JamesGlanville/solderingmachine/README.md

solderingmachine
================

My 4th year engineering project to make a soldering machine for smd parts.
