JamesGlanville/solderingmachine/report/handbook.pdf

## Soldering Machine Handbook

James Glanville

15th May 2013

## Contents

1 Introduction | 2
2 Prerequisites | 2
3 Installing Software | 2
4 Creating GERBER files. | 3
5 Generating GCODE with pcb2gcode | 3
6 Operating the machine | 3
Appendices | 6
A Building pcb2gcode from source | 6

1

## 1 Introduction

This handbook lists the steps required to operate the machine, and produce populated PCBs. The operating system used in this handbook is Ubuntu 13.10. The PCB CAD program used is Kicad.

## 2 Prerequisites

The following things are assumed:

- Computer with Windows/Linux. OS X may work, but is untested.
- SD card (at least 128mb).

## 3 Installing Software

First install pcb2gcode as described in Appendix A.

### 3.1 Project files

Fetch the project’s files from source control:

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

### 3.2 Install pronterface (if PC control is required)

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

### 3.3 Preparing SD card

Format the SD card to the FAT32 filesystem, ensuring the disk has an MSDOS partition table and that the FAT32 partition is on the first primary partition.

In Ubuntu, the following steps are necessary:

Install gparted if it is not already installed:

sudo apt−g e t i n s t a l l gp a r ted

Launch gparted as root:

sudo gp a r ted

Select the SD card using the drop down menu at the top right of the screen.

Create the MSDOS partition table by clicking Device->Create Partition Table.

Create the FAT32 filesystem by right-clicking on the empty disk, and selecting ”New”. Fill in the information in the dialogue box, and click ”Apply changes”.

2

3.4 Copying utility GCODE to SD card.

Copy all .GCODE files from pcb2gcode-metric/GCODE/ to the root of the SD card. These can be used to perform simple functions such as zeroing the axes.

4 Creating GERBER files.

The following steps should be followed to export GERBER files from Kicad:

1. Open the PCB layout in PCBNew.
2. Select Tracks and Vias from the Dimensions Menu.
3. Change the Mask Clearance to 0.0001.
4. Select Plot from the File menu.
5. Select the following layers: Copper, Component,SoldPCmp, EdgesPcb
6. Click Plot and then Generate drill file.

## 5 Generating GCODE with pcb2gcode

5.1 Creating millproject file.

An example millproject file is given in pcb2gcode-metric/millproject. This should be copied into the directory containing the GERBER files, and modified if necessary (see included comments).

### 5.2 Copy GCODE to SD Card

## 6 Operating the machine

The following steps described the various stages involved in producing a populated and soldered circuit board. Some steps (such as drilling) may be omitted if not required.

### 6.1 Using pronterface

The machine has two main user interfaces: the interface used for the machine in standalone operation and that used when connected to a host computer.

Pronterface was chosen as the PC user interface as it is a mature GCODE visualiser and sender.

Once the correct serial port and baud rate have been selected, pronterface will connect to the machine. GCODE can be loaded using the Load file button. It is rendered to the center of the window (however some operations are not shown correctly). The program is primarily intended for operating 3d printers, so to send the GCODE to the machine the Print button must be used.

3

The following instructions assume the SD card interface is being utilised, but if PC control is required, simply send the GCODE using pronterface as described above instead.

### 6.2 Attaching the PCB

Attach copper-clad PCB to machine using double sided tape. It is important that the PCB is level, so care must be taken ensure the tape is not bunched or folded. The PCB should be firmly pressed to the bed to ensure a strong bond.

### 6.3 Isolation Routing

1. Insert conical routing bit into the spindle. This is achieved by loosening the idler section, and then loosening the two machine screws holding the bit in place. The bit should be carefully removed by hand, and the conical routing bit pushed into its place. The two machine screws should be tightened, and the idler tightened.
2. The spindle tool should then be attached to the tool holder with the two wing nuts.
3. Switch on the machine.
4. Insert the SD card containing all of the GCODE files and power on the machine.
5. Run zero.gcode then startspindle.gcode then mill.gcode
6. When routing is complete, run stopspindle.gcode

### 6.4 Drilling

This section may be ignored if no holes need be drilled through the PCB.

1. The drill bit should be inserted into the spindle tool as described in the ”Isolation Routing” section above.
2. Switch on the machine.
3. Insert the SD card containing all of the GCODE files and power on the machine.
4. Run zero.GCODE then startspindle.GCODE then drill.GCODE
5. When drilling is complete, run stopspindle.GCODE

### 6.5 Paste Extrusion

1. Insert a syringe containing a sufficient volume of solder paste into the paste extruder. Hand-tighten the extruder so that there is only a small amount of slack in the timing belt.
2. Attach the paste extruder to the tool holder and hand-tighten the wing nuts.
3. Switch on the machine.
4. Insert the SD card containing all of the GCODE files and power on the machine.
5. Run zero.GCODE then prime.GCODE then paste.GCODE

4

### 6.6 Placing components

1. Attach the vacuum needle tool to the machine and tighten with the wing nuts.
2. Fill the part tray with the necessary SMD components.
3. Switch on the machine.
4. Insert the SD card containing all of the GCODE files and power on the machine.
5. Run zero.GCODE then place.GCODE.

### 6.7 Reflowing the board

1. Attach the hot air tool to the machine and tighten with the wing nuts.
2. Switch on the machine.
3. Insert the SD card containing all of the GCODE files and power on the machine.
4. Run zero.GCODE then reflow.GCODE.
5. Run cooldown.GCODE

5

# Appendices

## A Building pcb2gcode from source

The pcb2gcode source should first be obtained:

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

A.1 Compilation in Linux

For these instructions the use of Ubuntu/Debian is assumed, although other distributions should be similar.

To install prerequisites:

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

To compile pcb2gcode:

cd pcb2gcode−m e t ri c
. / gi t −b uil d . sh

(Optional) To install pcb2gcode:

sudo c h e c k i n s t a l l

A.2 Compilation in Windows

Installing prerequisites is more complex in Windows:

A.2.1 Visual Studio

Install Visual Studio 2012 Professional from:

www. v i s u a l s t u d i o . com

A.2.2 GTK+ development files

Download:

h t tp : / / f t p . gnome . o r g /pub/gnome/ b i n a r i e s / win32 / gtk +/2.24/ gtk+−b un dl e 2 .24.10 −20120208 win32 . zi p

and extract to pcb2gcode-metric folder.

6

A.2.3 Gerbv

Download and install gerbvinst-2.6.1.exe from:

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

A.2.4 Boost libraries

Download boost 1 55 0.zip from:

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

Unzip contents to c:\boost155 open VS2012 x86 Native Tools Command Prompt, from:

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

As administrator, run the following commands:

cd c : \ b o o s t 1 5 5
b o o t s t r a p . bat
bjam . exe

A.2.5 GTKMM

Download and install gtkmm-win32-devel-2.22.0-2.exe from:

h t tp : / / f t p . gnome . o r g /pub/GNOME/ b i n a r i e s / win32 /gtkmm / 2. 2 2 /

A.2.6 Gerbv source

Download gerbv-2.6.1.tar.gz from:

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

and extract to c:\gerbv-2.6.1

A.2.7 Compilation

The file pcb2gcode-metric.sln may now be opened in visual studio and the project can be compiled.

7
