JamesGlanville/solderingmachine/microscope/1.png

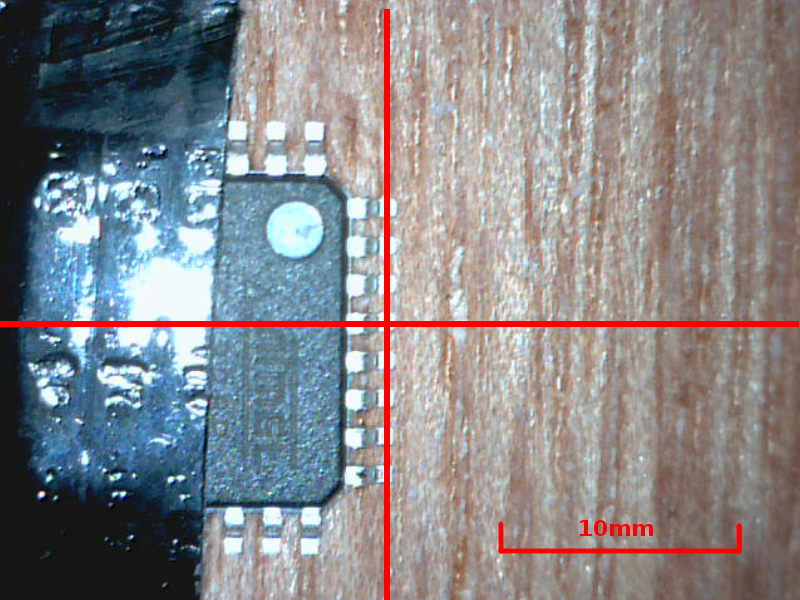
microscope/1.png
