JamesGlanville/solderingmachine/microscope/1s.png

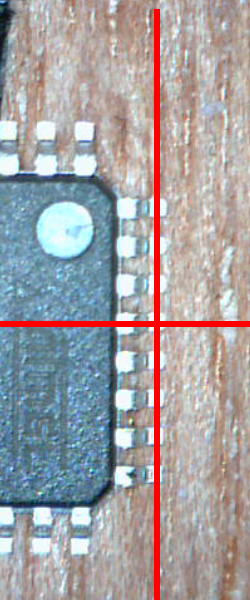
microscope/1s.png
