JamesGlanville/solderingmachine/microscope/2.png

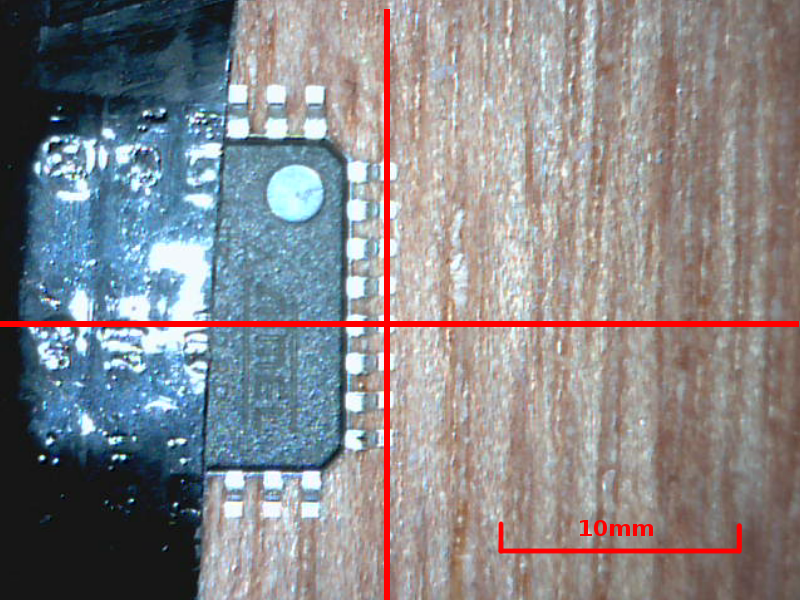
microscope/2.png
