JamesGlanville/solderingmachine/microscope/2s.png

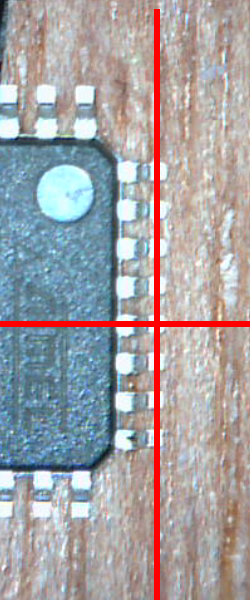
microscope/2s.png
