JamesGlanville/solderingmachine/microscope/3s.png

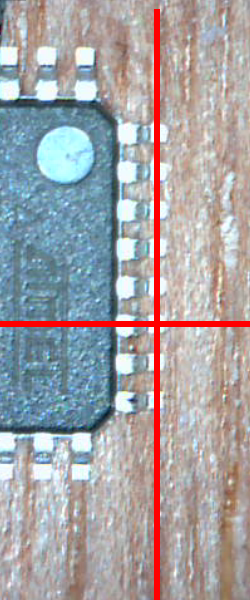
microscope/3s.png
