JamesGlanville/solderingmachine/microscope/4.png

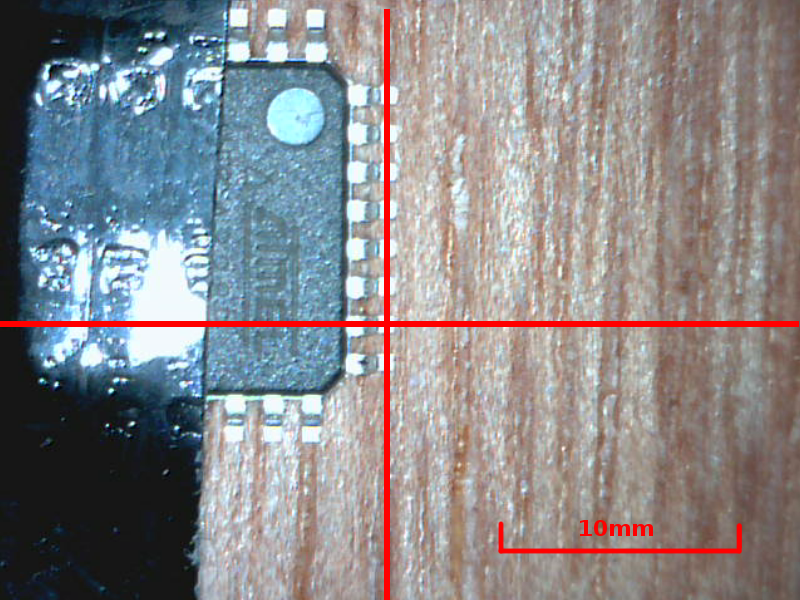
microscope/4.png
