JamesGlanville/solderingmachine/microscope/4s.png

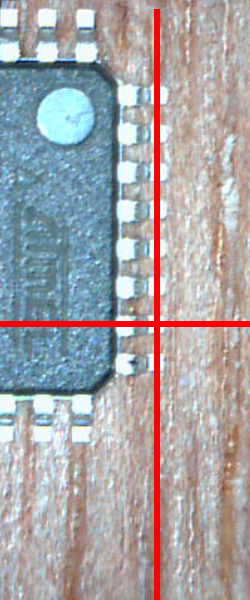
microscope/4s.png
