JamesGlanville/solderingmachine/microscope/5s.png

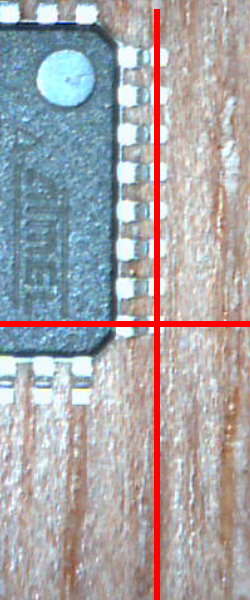
microscope/5s.png
