JamesGlanville/solderingmachine/microscope/Picture46.bmp

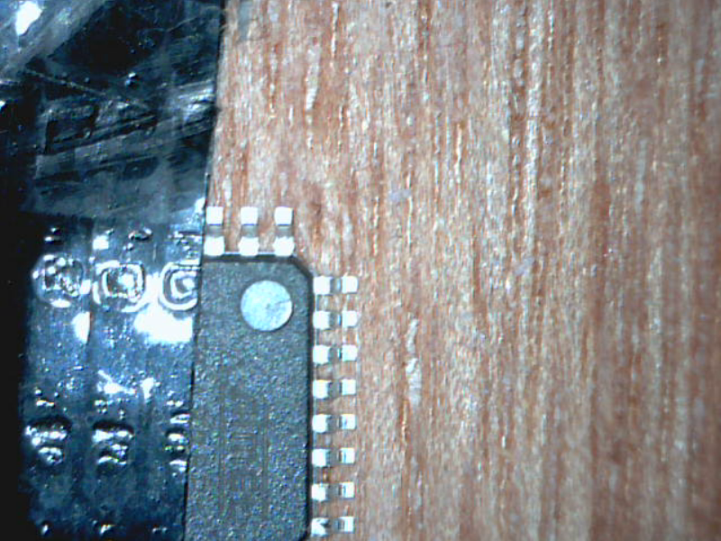
microscope/Picture46.bmp
