JamesGlanville/solderingmachine/microscope/Picture47.bmp

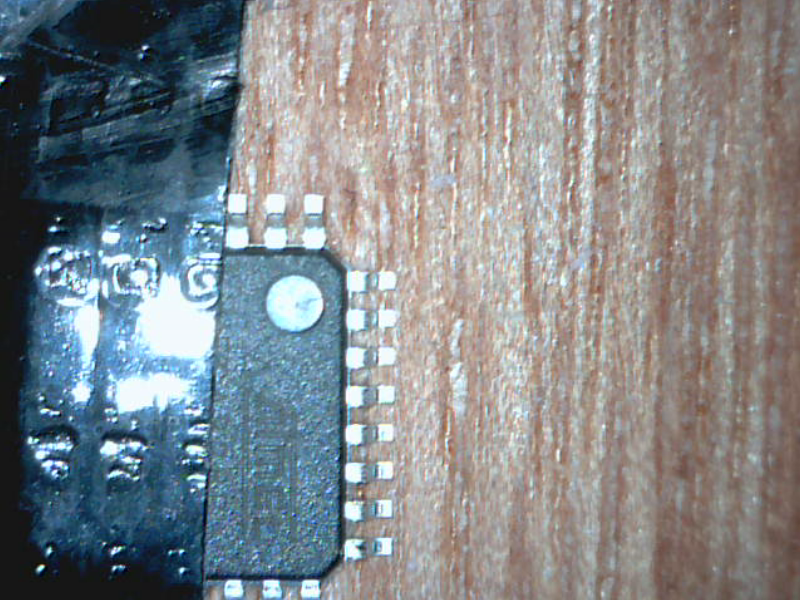
microscope/Picture47.bmp
