JamesGlanville/solderingmachine/microscope/Picture48.bmp

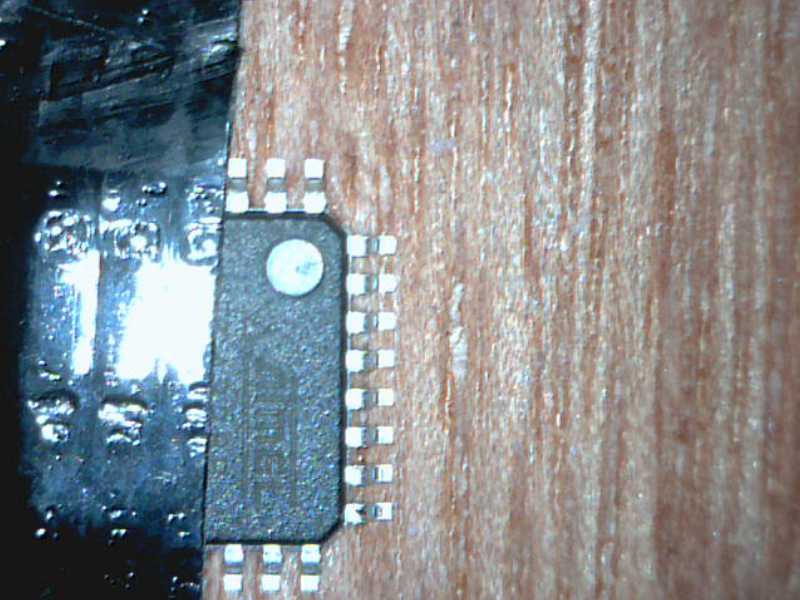
microscope/Picture48.bmp
