JamesGlanville/solderingmachine/microscope/Picture51.bmp

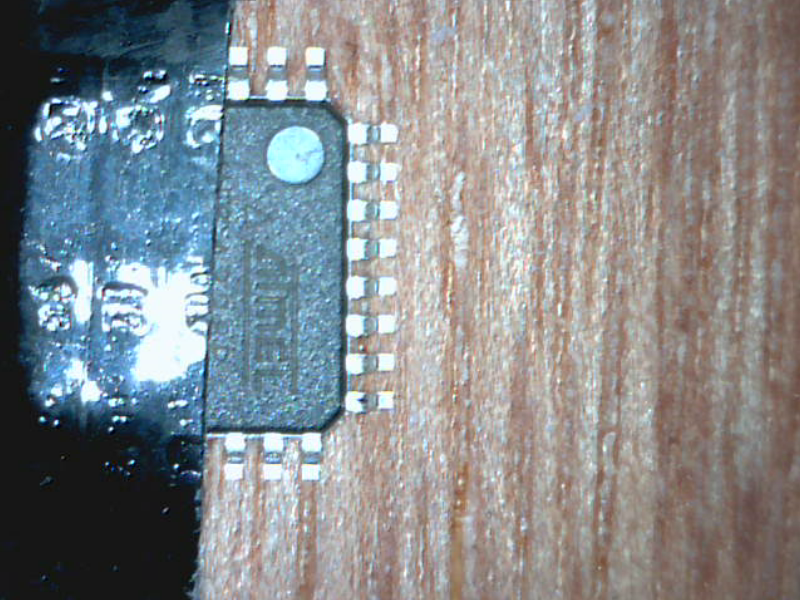
microscope/Picture51.bmp
