JamesGlanville/solderingmachine/microscope/Picture54.bmp

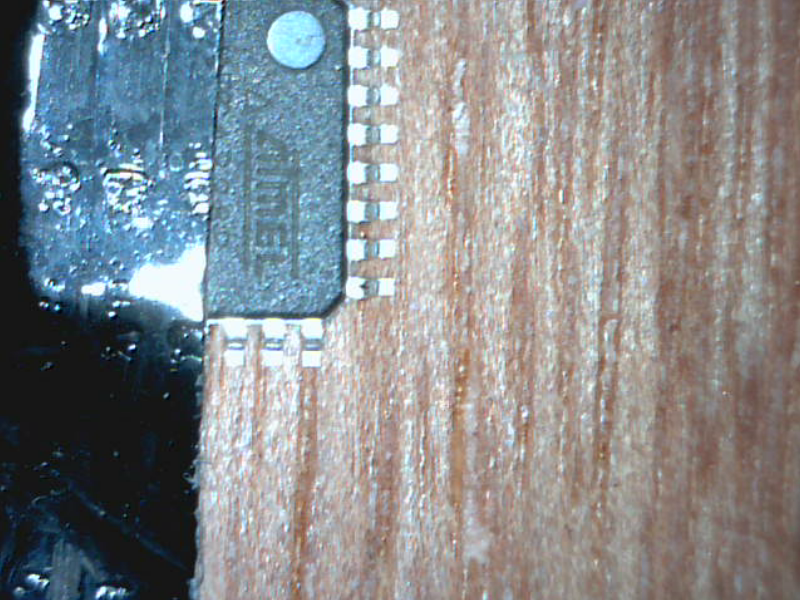
microscope/Picture54.bmp
