JamesGlanville/solderingmachine/microscope/Picture55.bmp

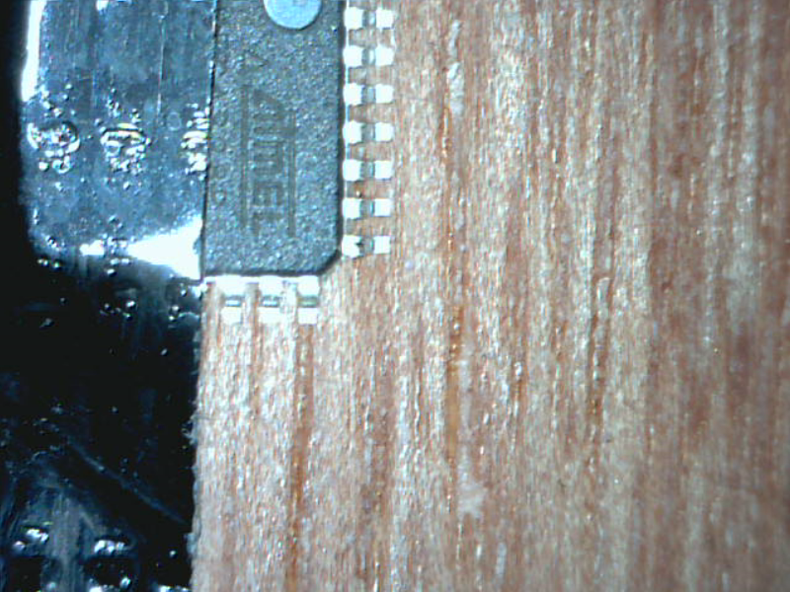
microscope/Picture55.bmp
