JamesGlanville/solderingmachine/microscope/Picture56.bmp

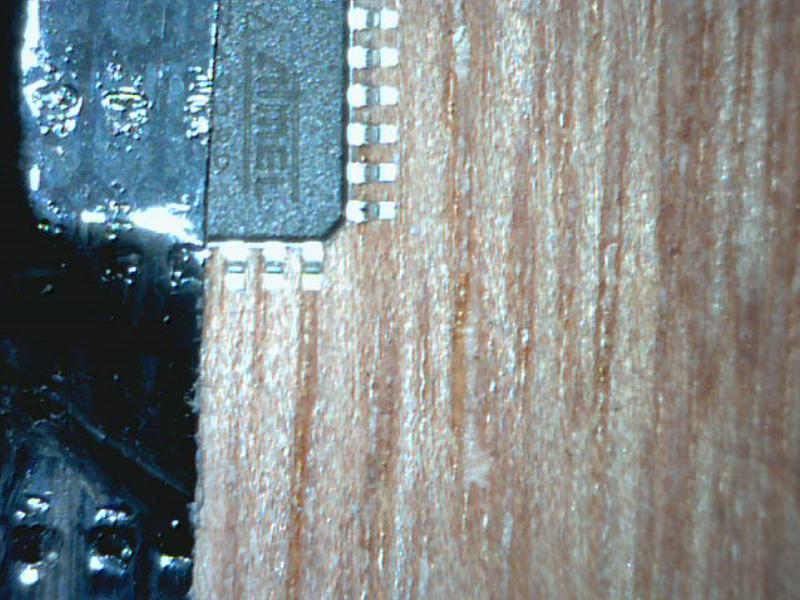
microscope/Picture56.bmp
