JamesGlanville/solderingmachine/microscope/Picture57.bmp

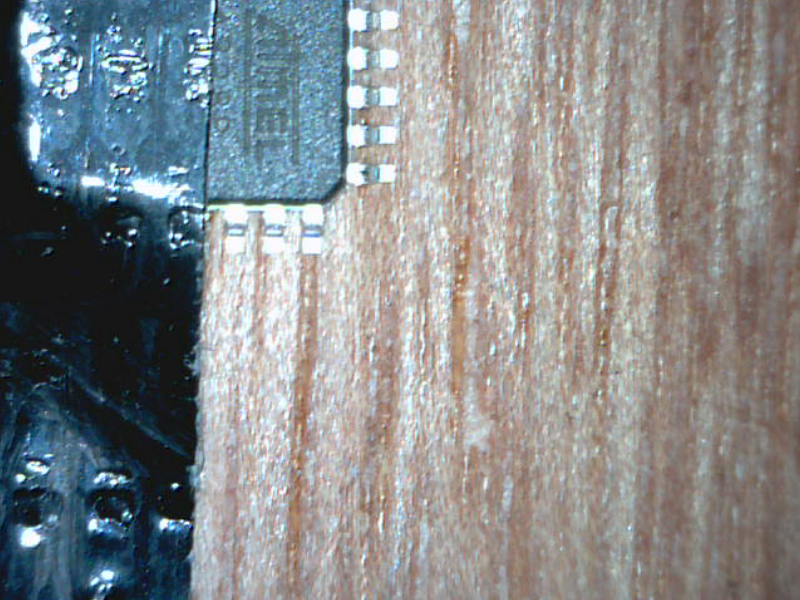
microscope/Picture57.bmp
