JamesGlanville/solderingmachine/report/resources/dialgauge.gif

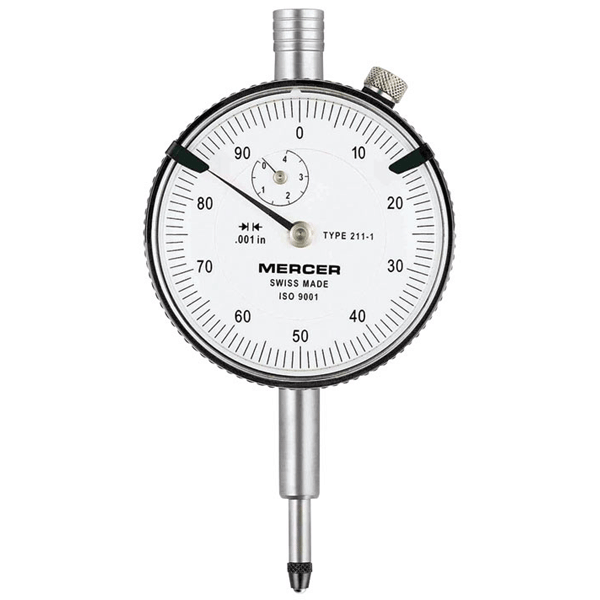
report/resources/dialgauge.gif
