JamesGlanville/solderingmachine/report/resources/hc05breakout.png

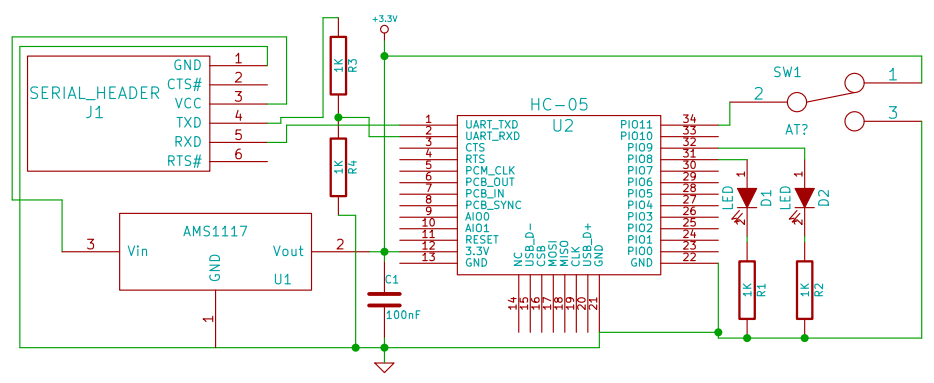
report/resources/hc05breakout.png
