JamesGlanville/solderingmachine/report/resources/needleresistor.JPG

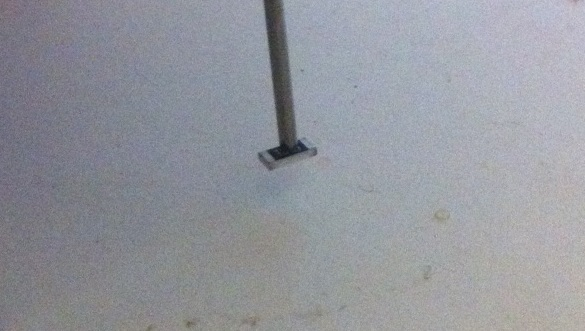
report/resources/needleresistor.JPG
