JamesGlanville/solderingmachine/report/resources/wormextruder.png

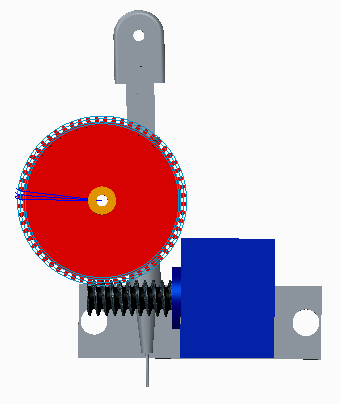
report/resources/wormextruder.png
