JamesGlanville/solderingmachine/report/Part list.xlsx

Part | Quantity | Type | Total Cost | Supplier | Link
base_board | 1 | sheet | - | - | -
topboard | 1 | sheet | - | - | -
bed | 1 | sheet | - | - | -
zsupport | 2 | sheet | - | - | -
zpanel | 1 | sheet | - | - | -
base_back | 1 | sheet | - | - | -
base_sides | 2 | sheet | - | - | -
base_bottom | 1 | sheet | - | - | -
slidyelectronics |  | sheet | - | - | -
drawer slides | 6 |  | 8.00
m8 threaded rods | 3
m8 brass nuts | 6
anti-backlash springs | 3
electronics board | 1 |  | 30.00 |  | http://reprap.org/wiki/Sanguish
nema17 motors | 3 |  | 18.00 | Zapp Automation | http://www.zappautomation.co.uk/en/nema-17-stepper-motors/373-sy42sth47-1684a-high-torque-hybrid-stepper-motors.html
Vacuum tube | 1 |  | 1.00
ESC - turnigy plush 30A | 1 |  | 8.00 | Hobbyking | http://www.hobbyking.com/hobbyking/store/__2164__turnigy_plush_30amp_speed_controller.html
brushless motor - turnigy 450 3800KV | 1 |  | 8.56 | Hobbyking | http://www.hobbyking.com/hobbyking/store/__37457__turnigy_450_series_3800kv_brushless_outrunner_helicopter_motor.html
prop savers | 2 |  | 1.84 | Hobbyking | https://www.hobbyking.com/hobbycity/store/uh_viewItem.asp?idProduct=8240
m4 nuts and bolts | 40
nuttrap | 3 | RP
motorholder | 3 | RP
pasteextruder | 1 | RP
needleholder | 1 | RP
zholder | 1 | RP
rightangle | 4 | RP
12v 30A Power Supply | 1 |  | 12.79 | ebay | http://www.ebay.co.uk/itm/201009607598
Inline mini fuse holder + 30A fuse | 1 |  | 1.59 | ebay | http://www.ebay.co.uk/itm/231070496002
20X4 Backlit HD44780 LCD | 1 |  | 5.99 | ebay | http://www.ebay.co.uk/itm/281270914670
12mm Rotary Encoder | 1 |  | 0.42 | ebay | http://www.ebay.co.uk/itm/390605649309
AMS1117-3.3 3.3V linear regulator | 1 |  | 0.03 | ebay | http://www.ebay.co.uk/itm/141128141176
Optional
HC-05 Bluetooth Tranceiver | 1 |  | 3.65 | ebay | http://www.ebay.co.uk/itm/330913339056
AMS1117-3.3 3.3V linear regulator | 1 |  | 0.03 | ebay | http://www.ebay.co.uk/itm/141128141176
