JamesGlanville/solderingmachine/parts/creo/base_sides.pdf

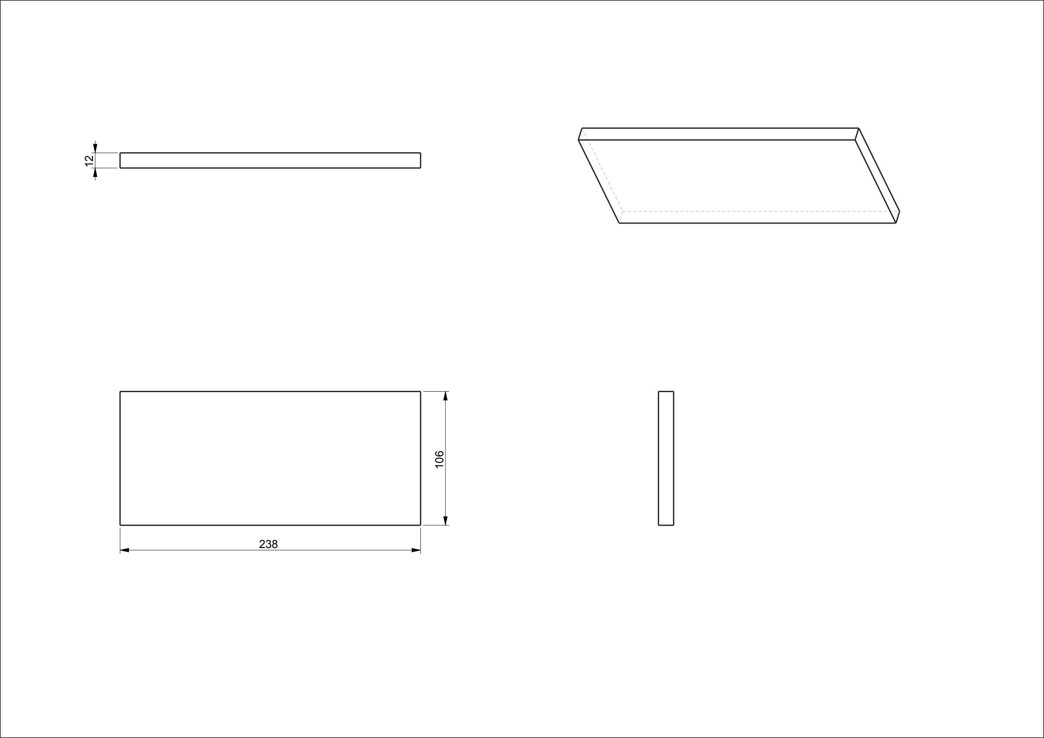
[picture p64: figure]
