JamesGlanville/solderingmachine/parts/creo/extruder.pdf

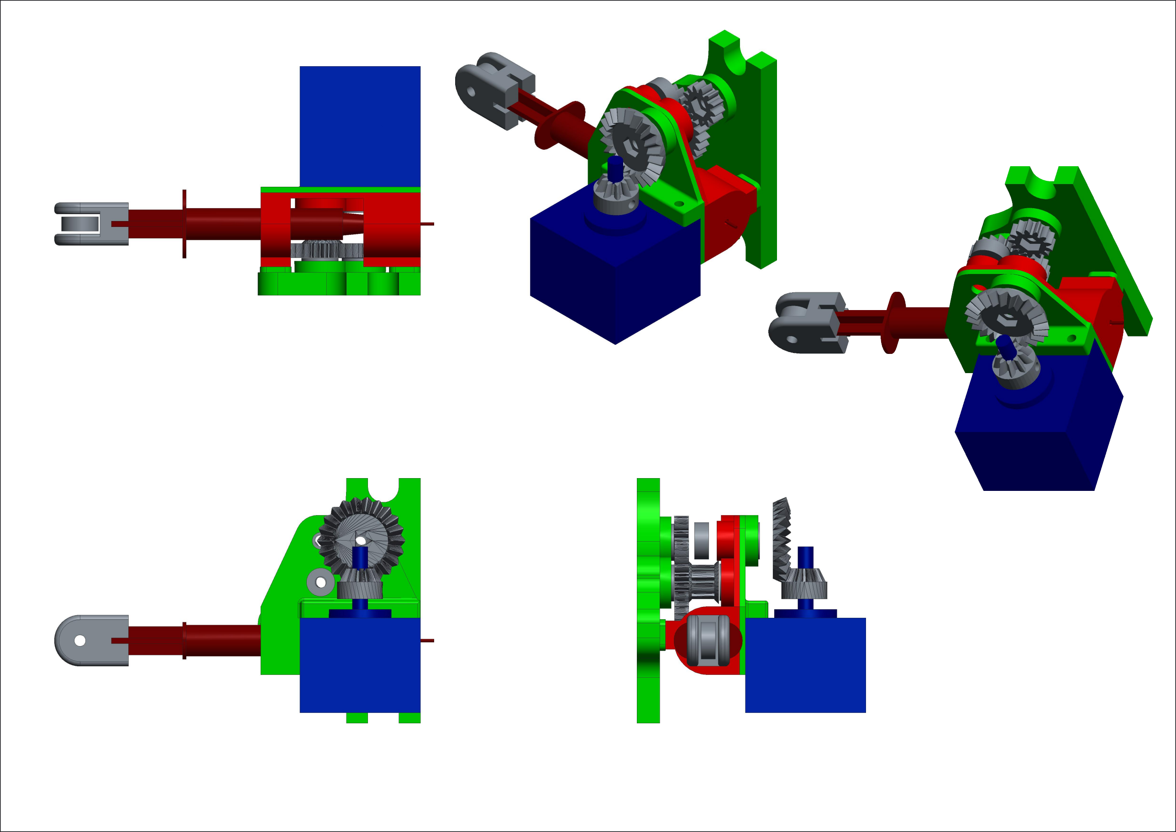
[picture p65: page 1]
