JamesGlanville/solderingmachine/parts/creo/gad.pdf

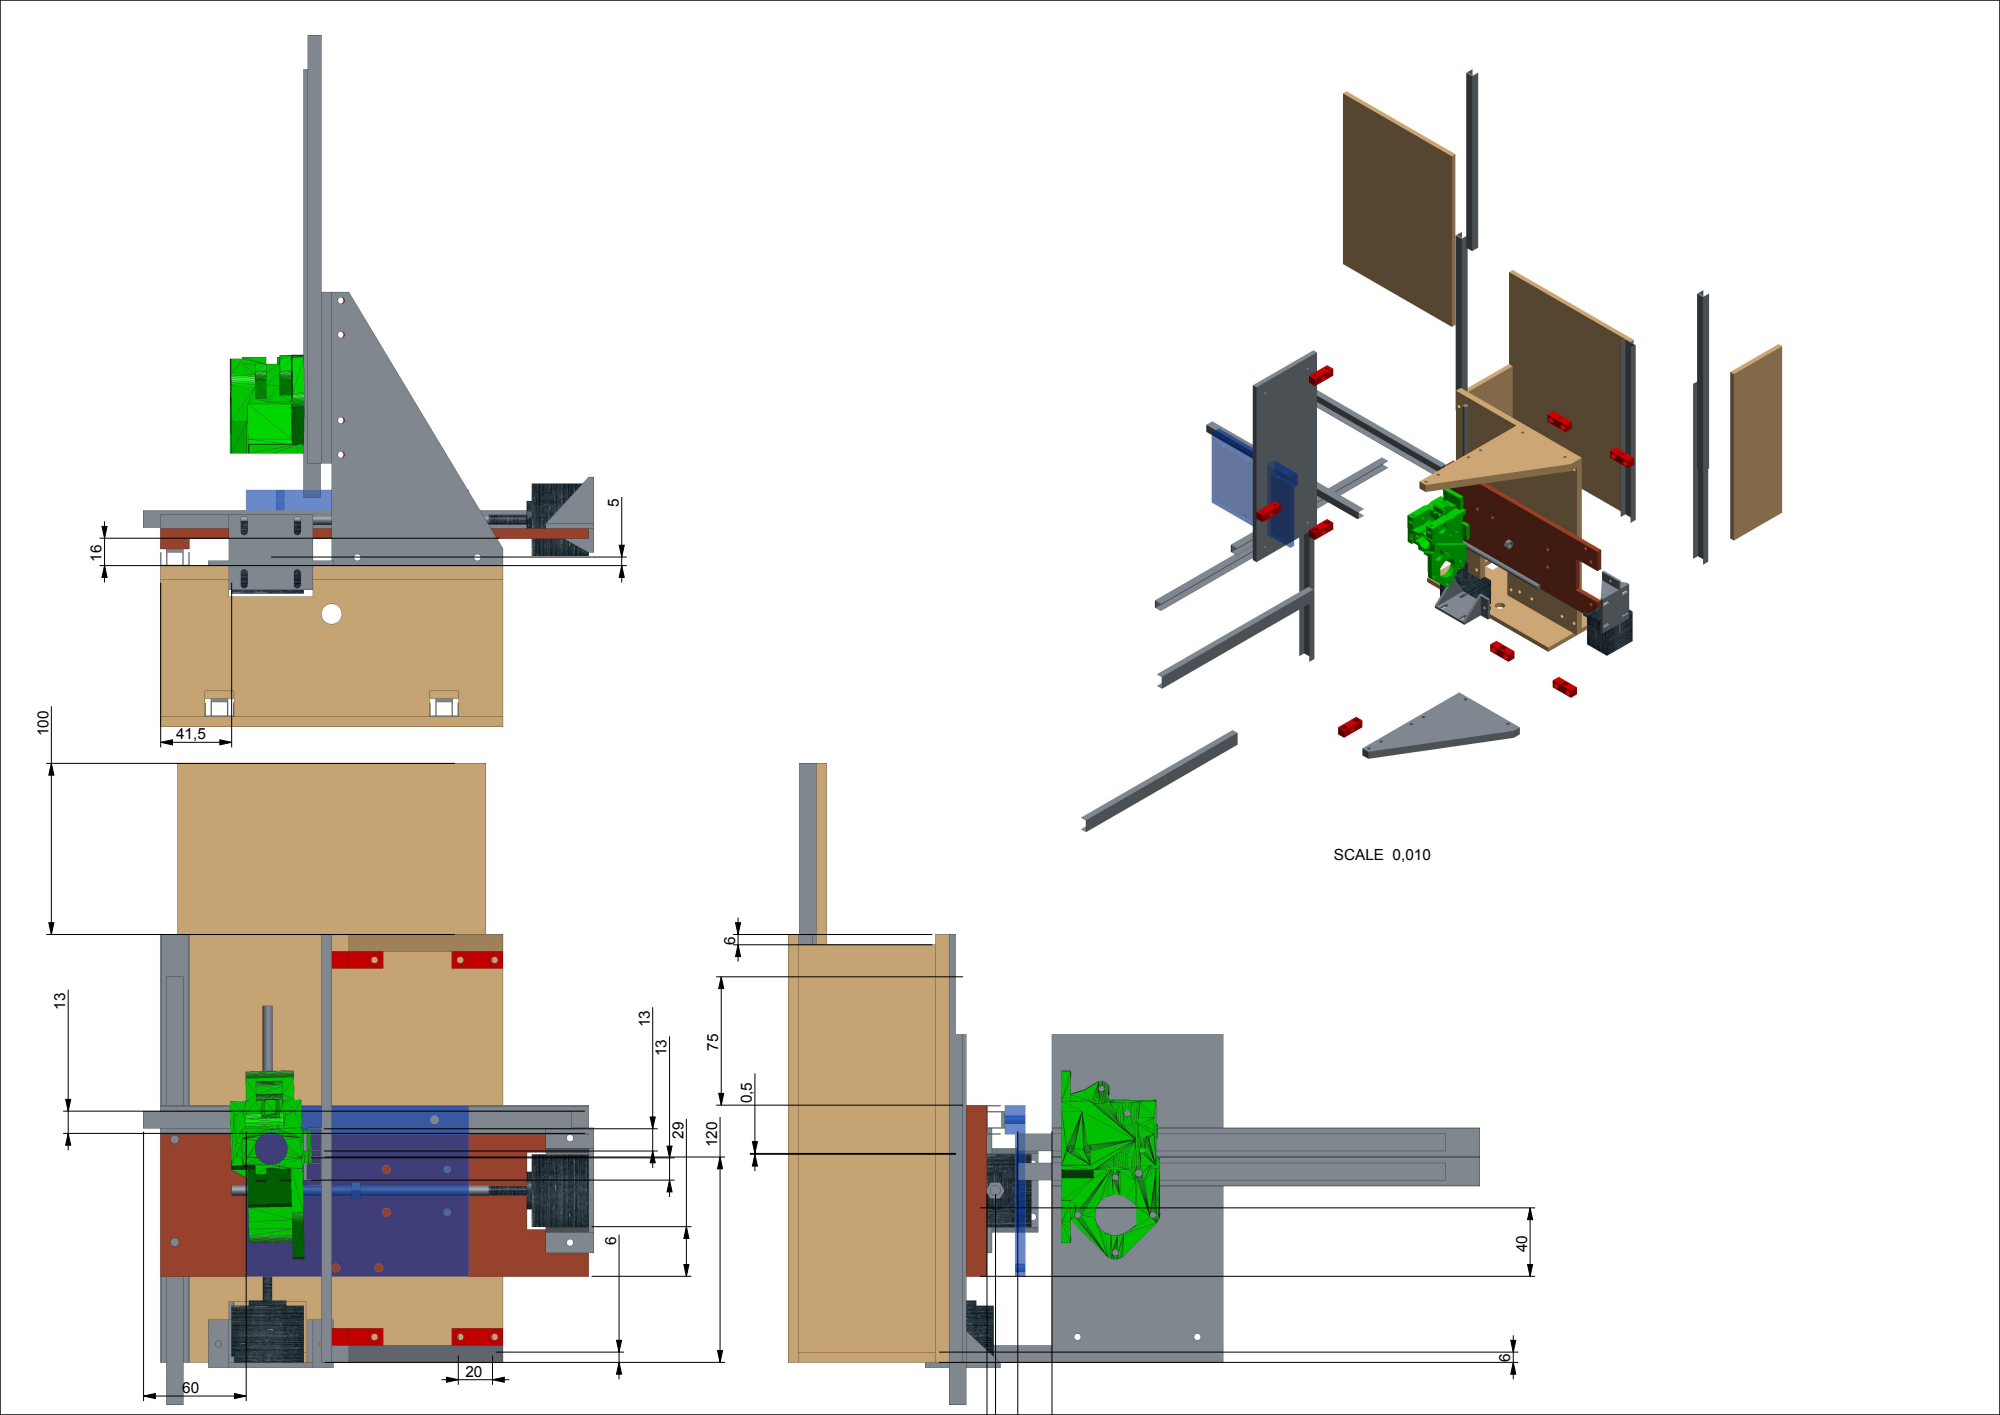
[picture p66: page 1]
SCALE 0,010

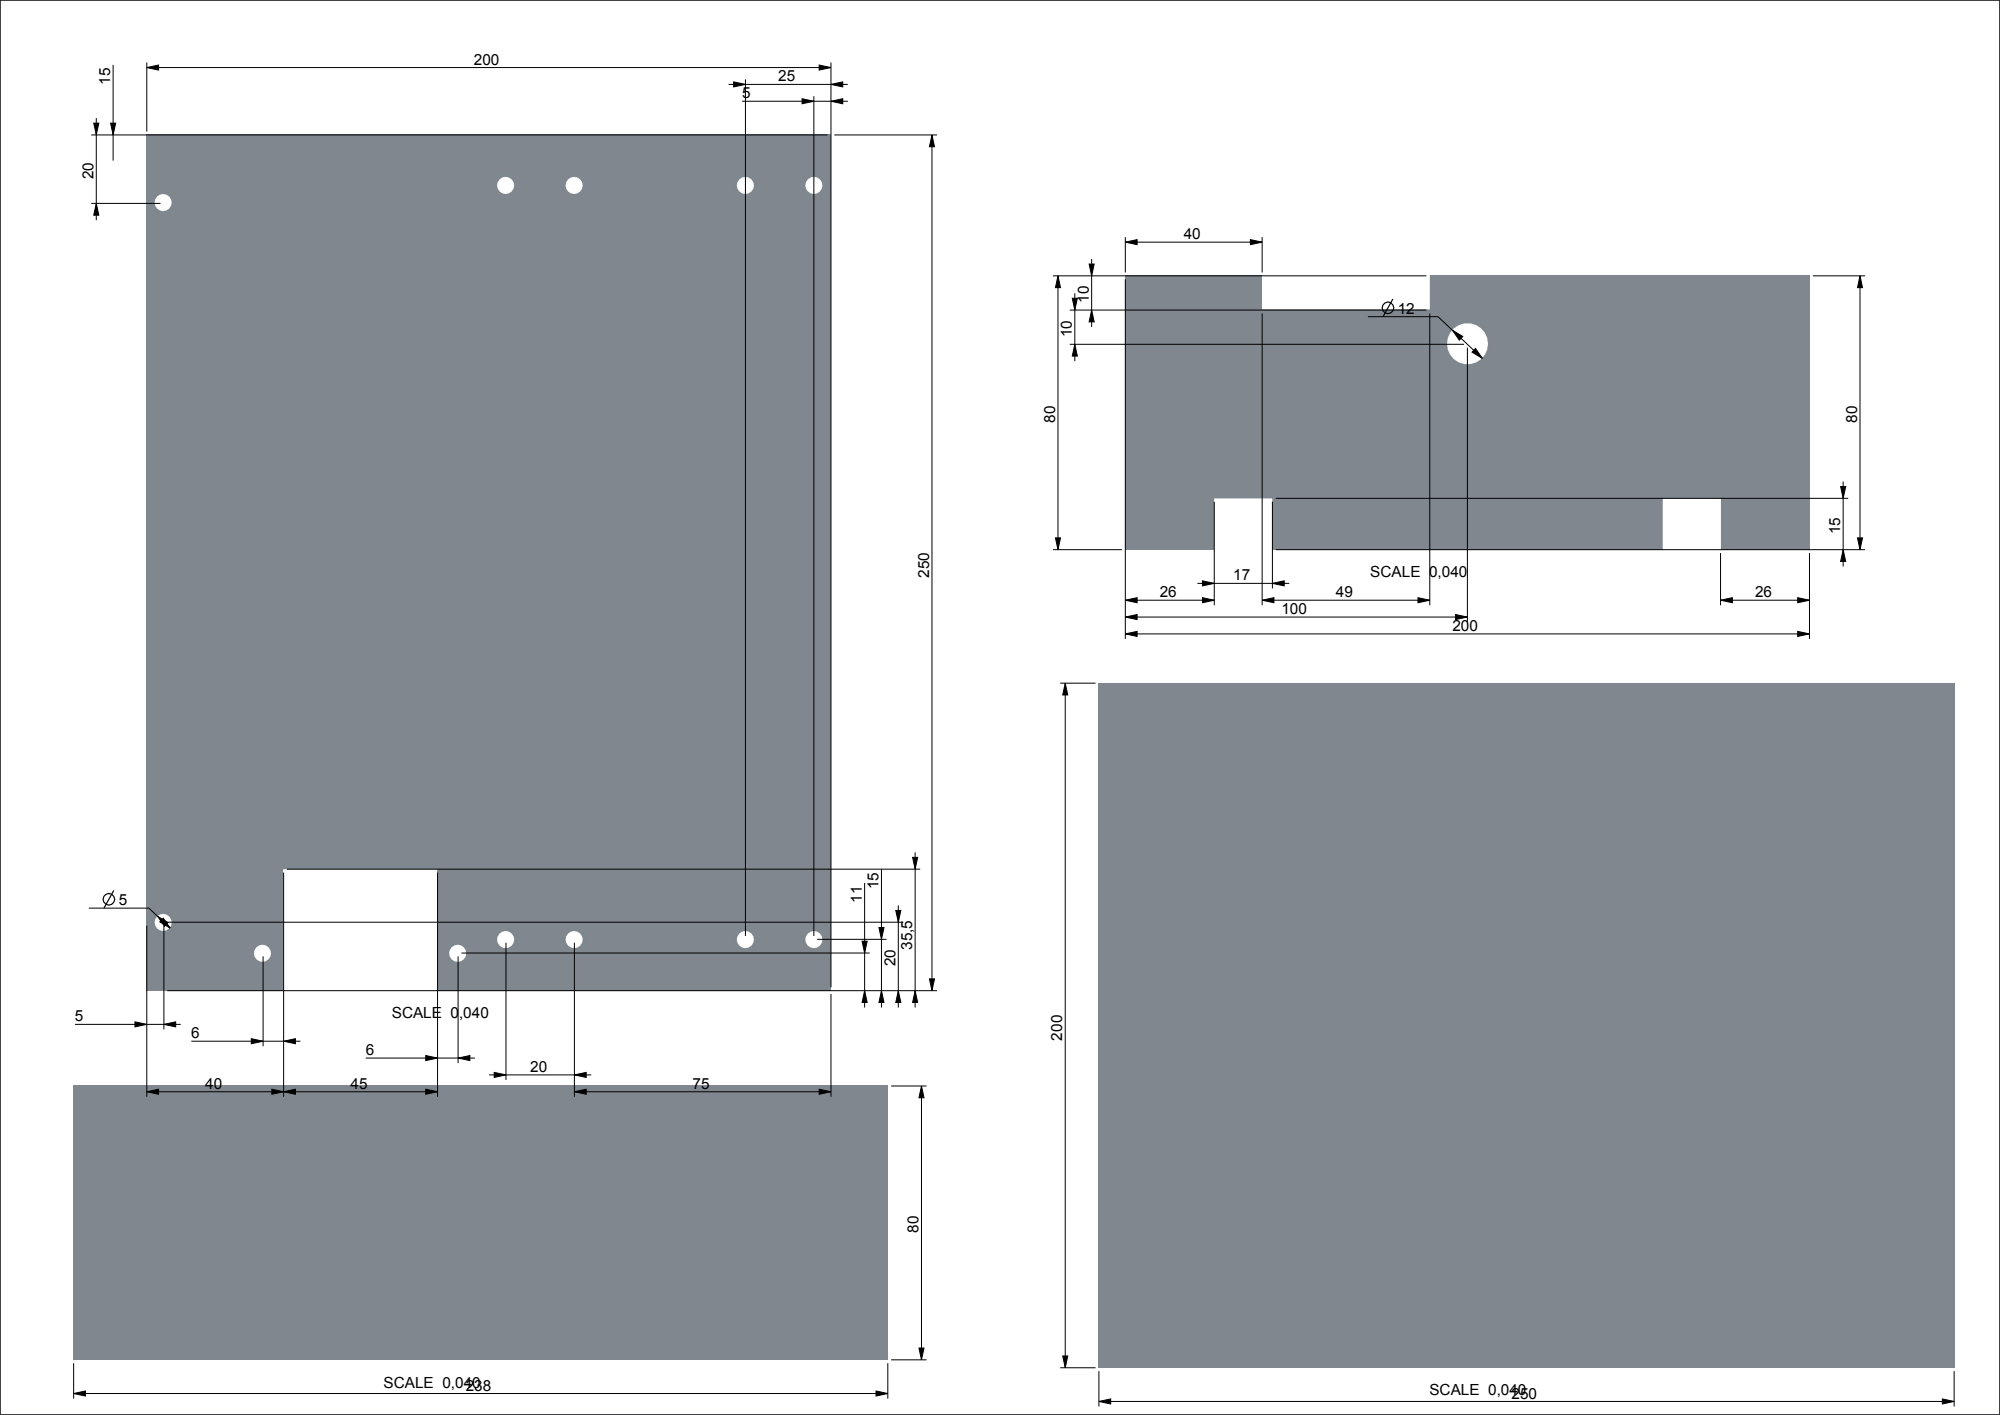
[picture p67: page 2]
SCALE; SCALE 0,040; SCALE 0,040 SCALE 0,040

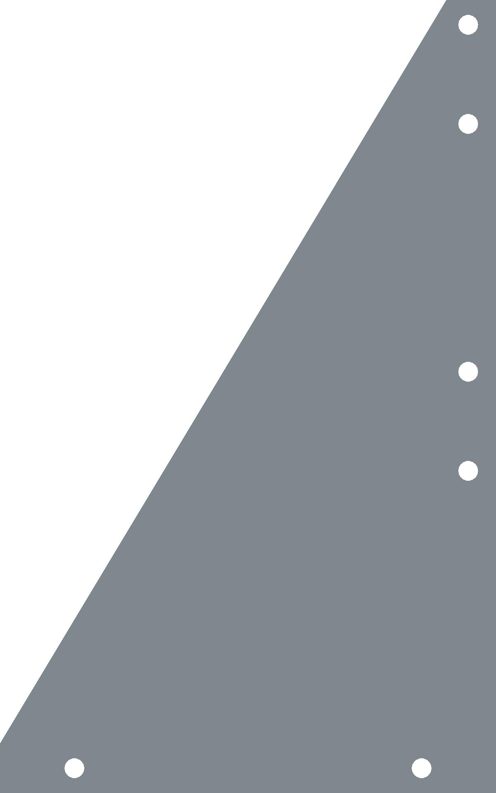
[picture p68: figure]

SCALE 0,040

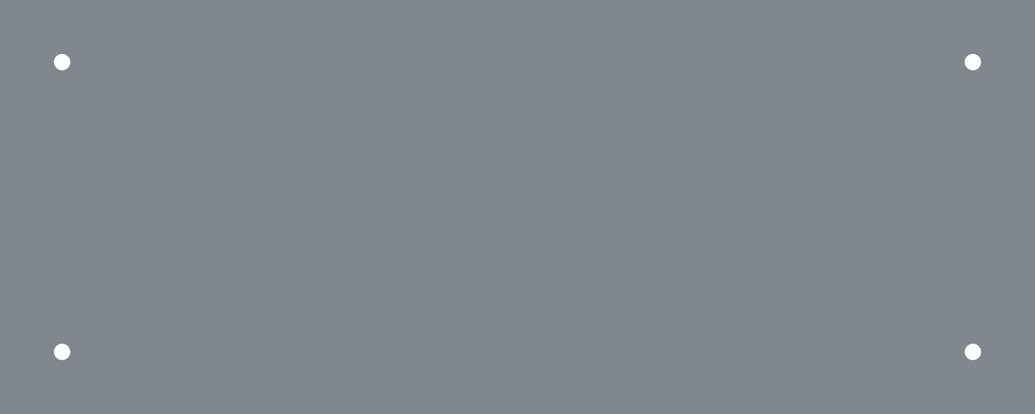
[picture p69: figure]

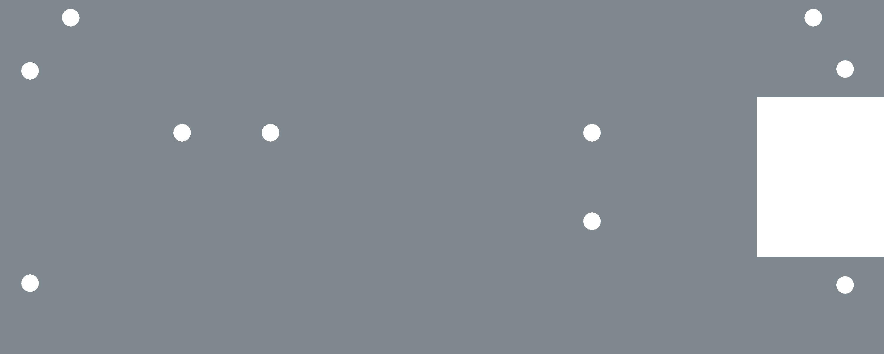
[picture p70: figure]
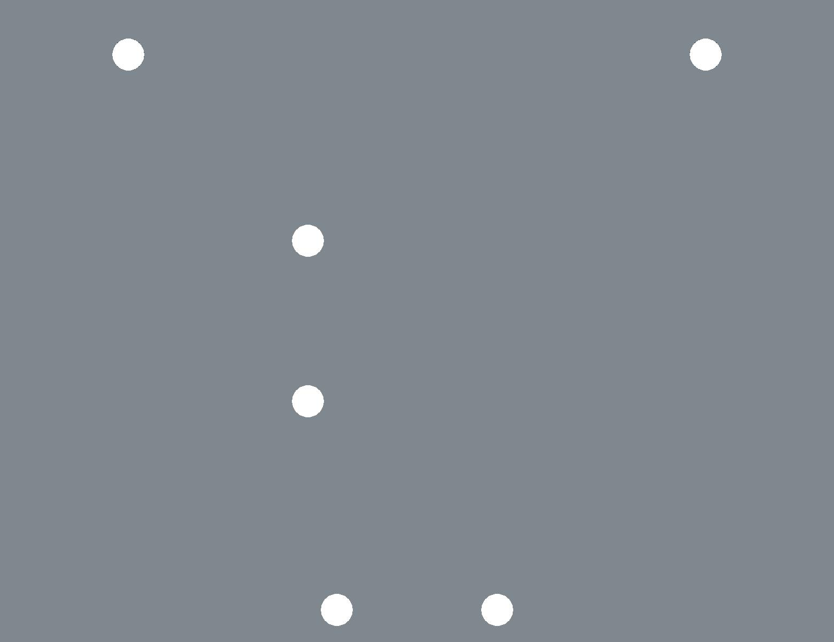
[picture p71: figure]

SCALE 0,040 | SCALE 0,040

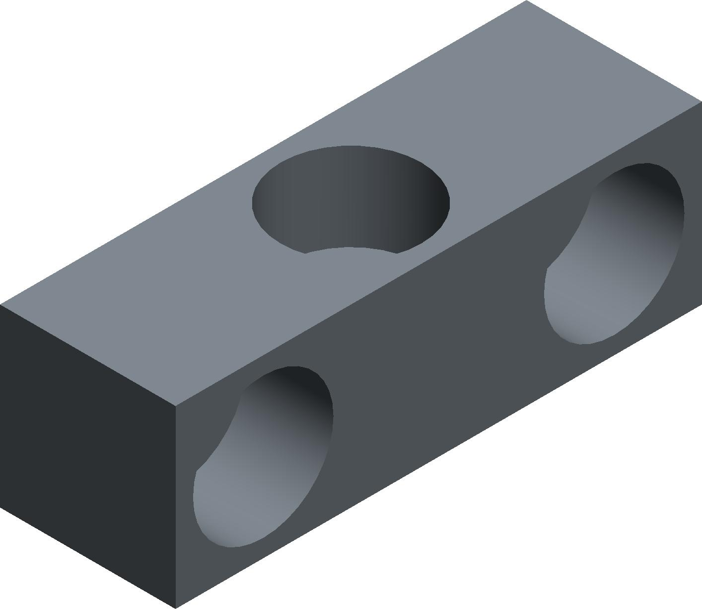
[picture p72: figure]
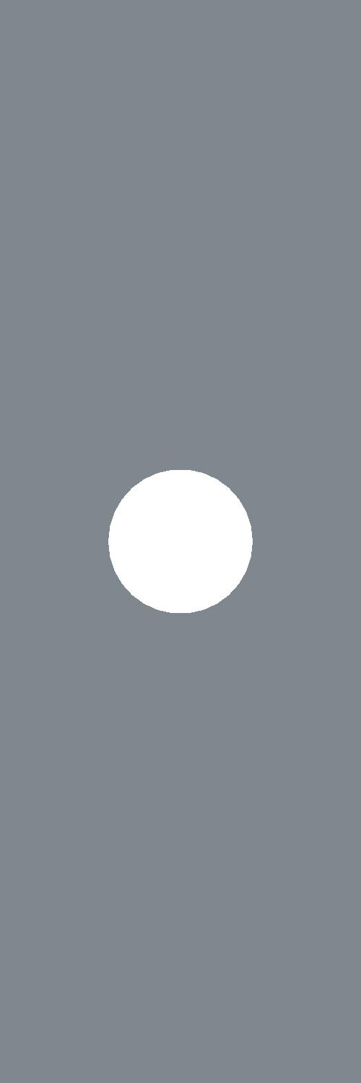
[picture p73: figure]
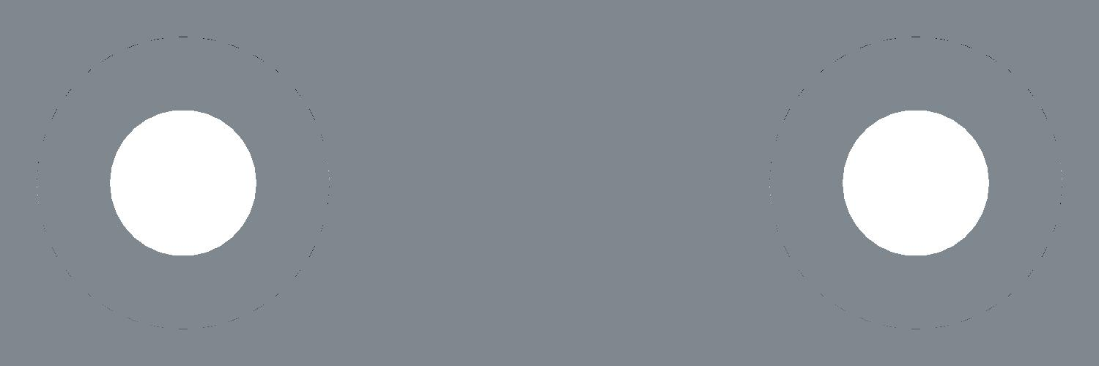
[picture p74: figure]
