JamesGlanville/solderingmachine/parts/creo/old/zpanel.pdf

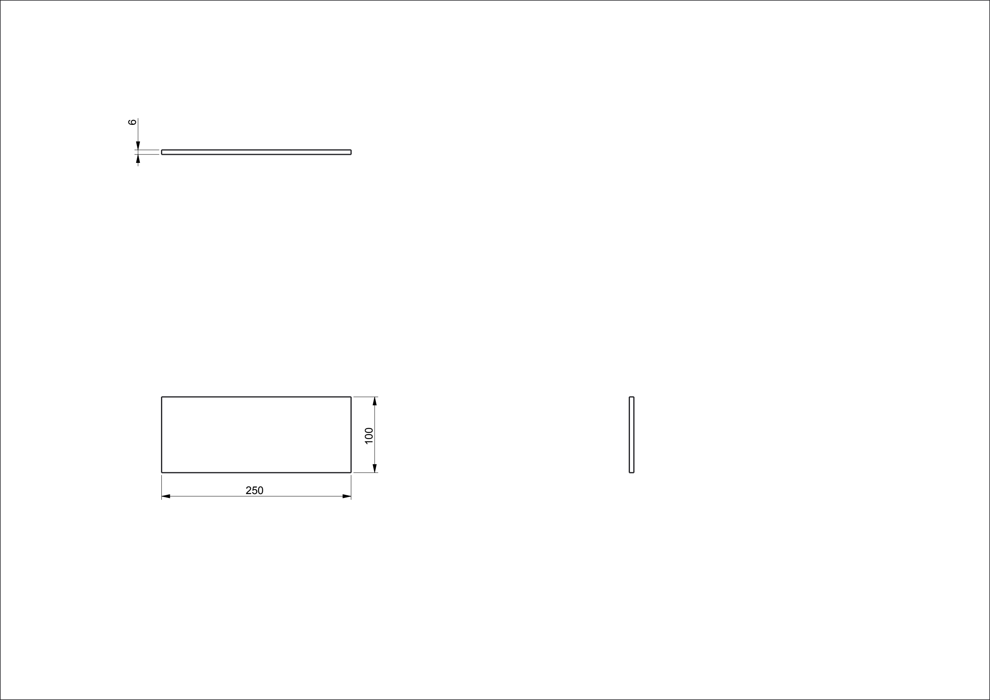
[picture p75: figure]
