JamesGlanville/solderingmachine/parts/creo/old/zsupport.pdf

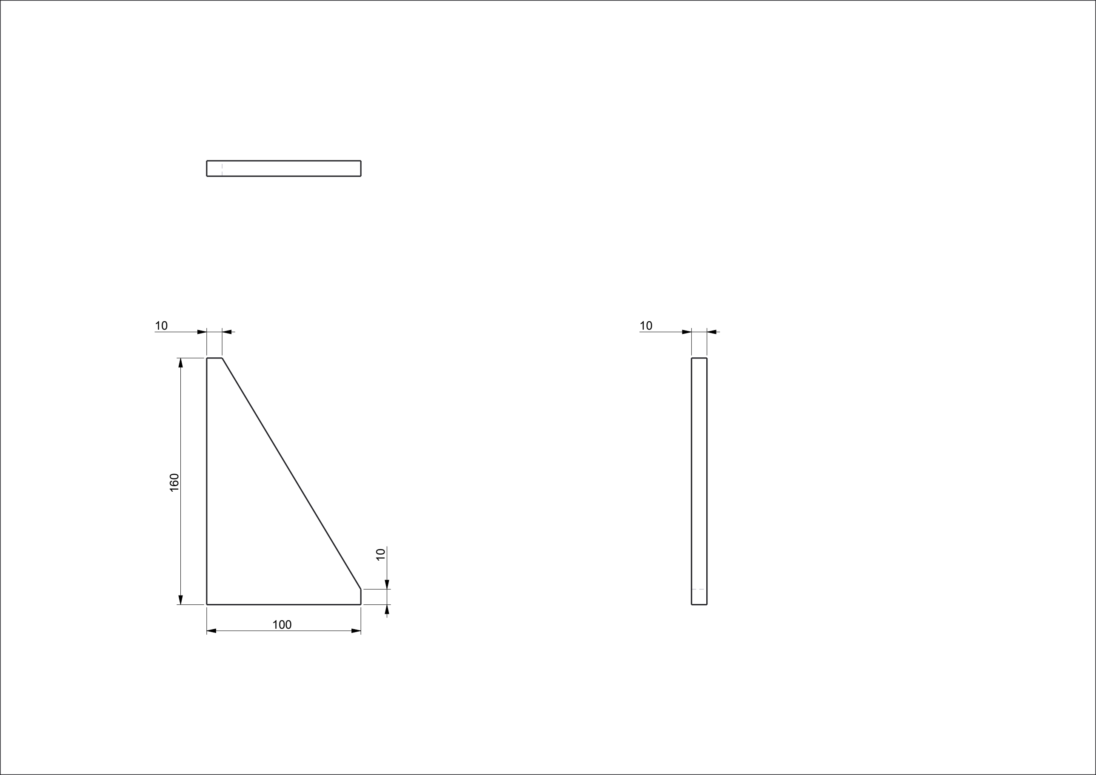
[picture p76: figure]
