JamesGlanville/solderingmachine/parts/side.png

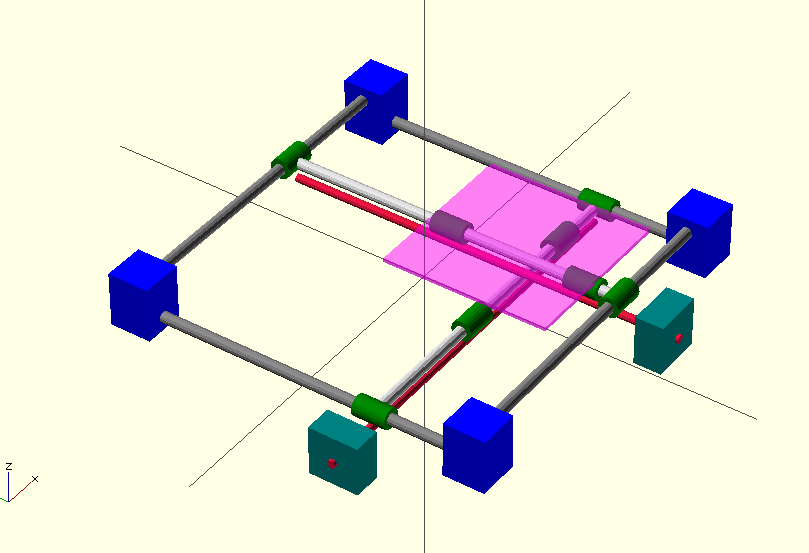
parts/side.png
