JamesGlanville/solderingmachine/parts/top.png

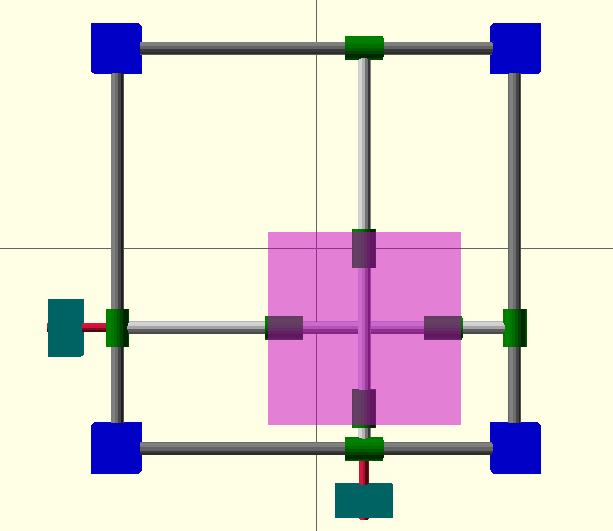
parts/top.png
