JamesGlanville/solderingmachine/parts/creo/extruder_main.stl

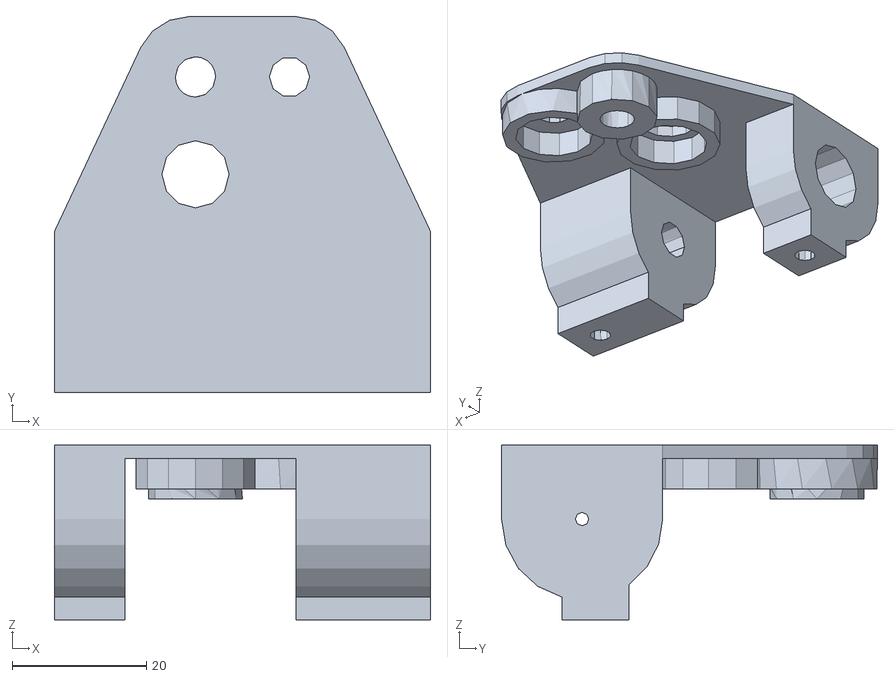
[picture p79: CAD file, 2014-03-11]
parts/creo/extruder_main.stl
56.0 x 56.0 x 26.0
