JamesGlanville/solderingmachine/parts/backlash.stl

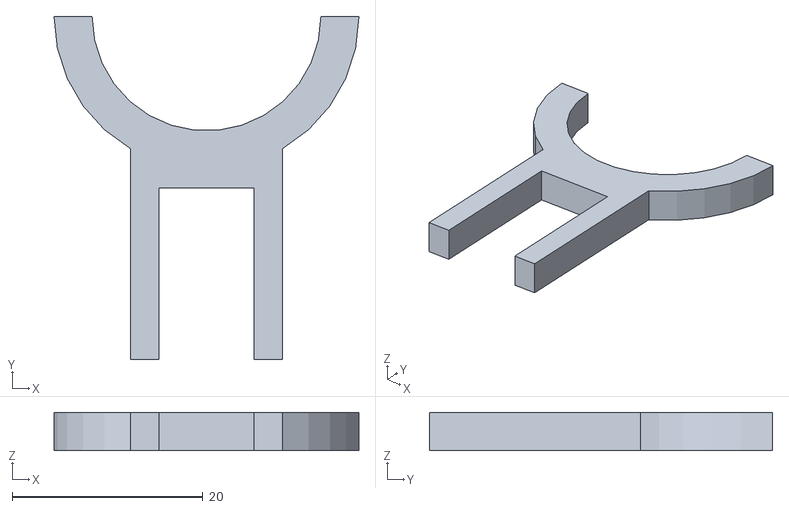
[picture p80: CAD file, 2013-11-12]
parts/backlash.stl
32.0 x 36.0 x 4.00
