JamesGlanville/solderingmachine/parts/creo/isolator_base.stl

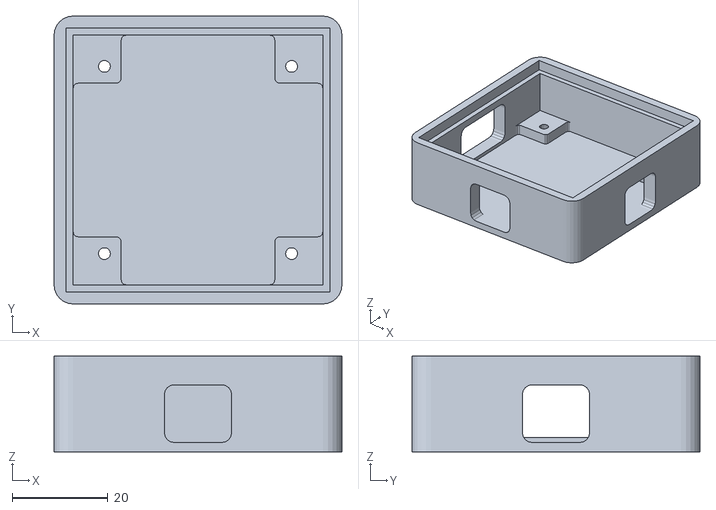
[picture p81: CAD file, 2014-04-27]
parts/creo/isolator_base.stl
60.0 x 60.0 x 20.0
