JamesGlanville/solderingmachine/parts/backlashw.stl

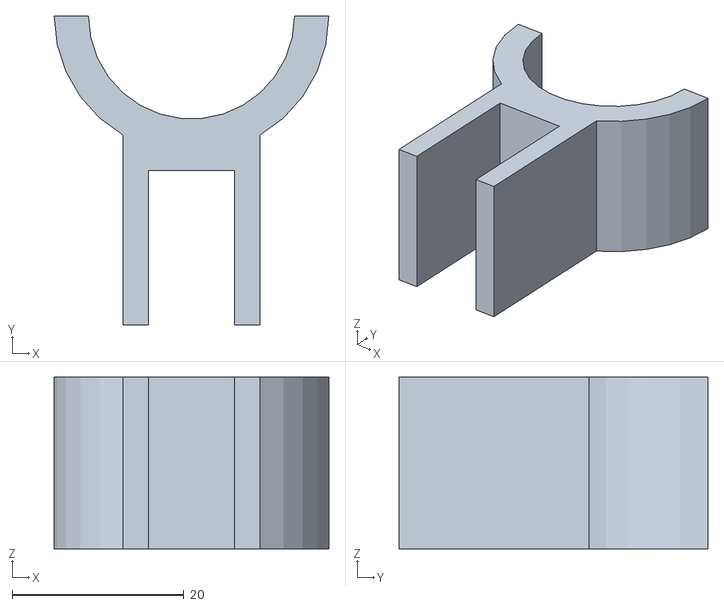
[picture p82: CAD file, 2013-11-12]
parts/backlashw.stl
32.0 x 36.0 x 20.0
