JamesGlanville/solderingmachine/parts/creo/lcdbezel.stl

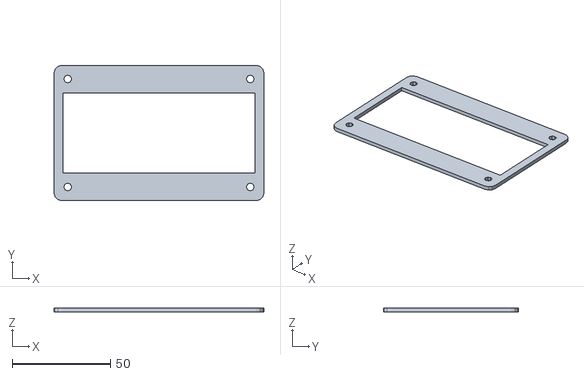
[picture p83: CAD file, 2014-04-03]
parts/creo/lcdbezel.stl
107.0 x 69.0 x 2.00
