JamesGlanville/solderingmachine/parts/corner_through.stl

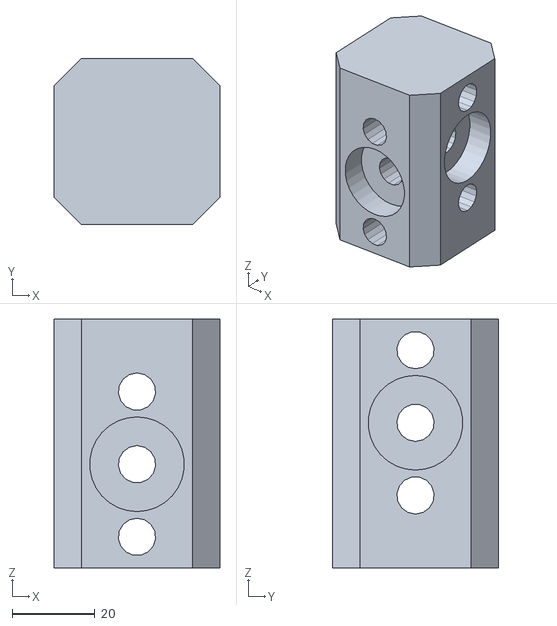
[picture p84: CAD file, 2013-10-15]
parts/corner_through.stl
40.0 x 40.0 x 60.0
