JamesGlanville/solderingmachine/parts/creo/rightangle.stl

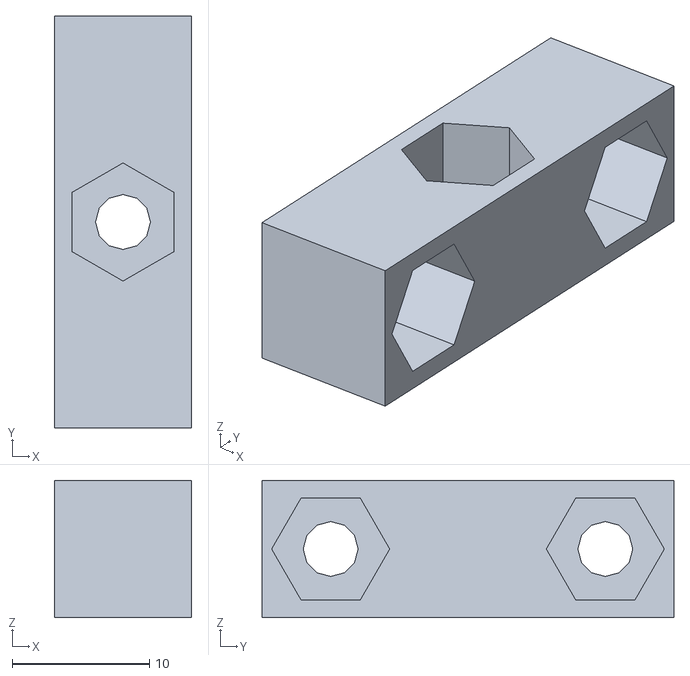
[picture p85: CAD file, 2014-04-03]
parts/creo/rightangle.stl
10.00 x 30.0 x 10.0
