JamesGlanville/solderingmachine/parts/creo/spindle_idler.stl

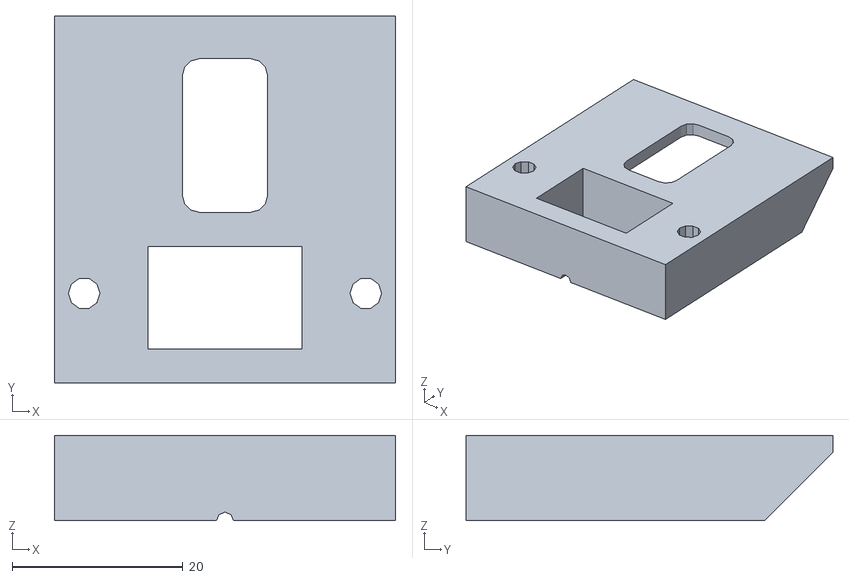
[picture p86: CAD file, 2014-04-01]
parts/creo/spindle_idler.stl
40.0 x 43.0 x 10.0
