JamesGlanville/solderingmachine/parts/syringe.stl

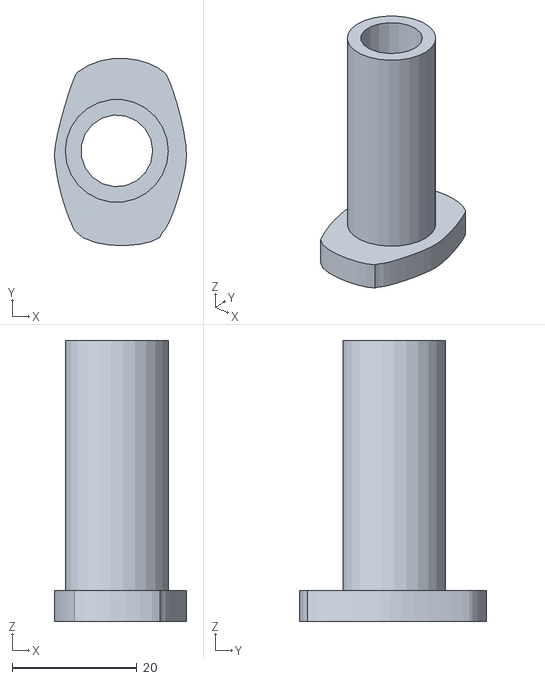
[picture p87: CAD file, 2013-10-15]
parts/syringe.stl
21.1 x 30.0 x 45.0
