JamesGlanville/solderingmachine/parts/creo/xt60-panelmount.stl

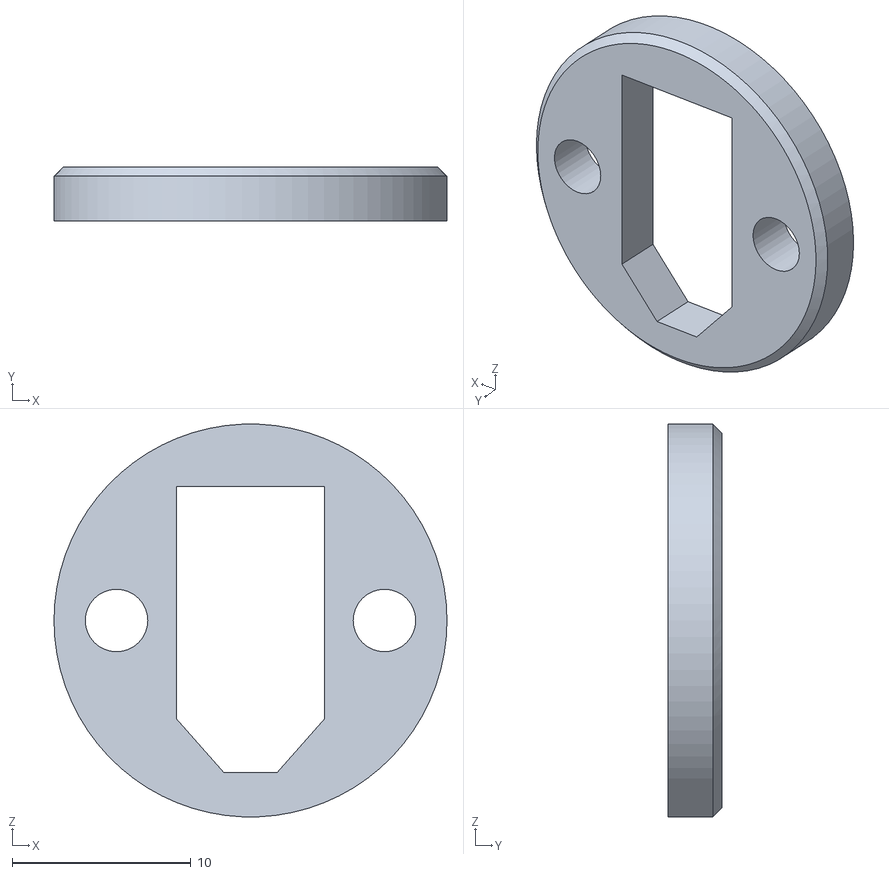
[picture p88: CAD file, 2014-04-01]
parts/creo/xt60-panelmount.stl
22.0 x 3.00 x 22.0
