JamesGlanville/solderingmachine/parts/lm8uu.stl

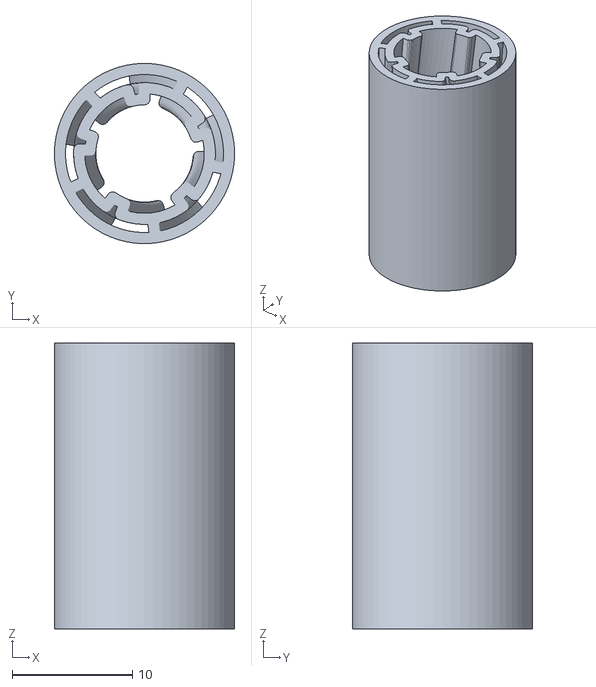
[picture p89: CAD file, 2013-10-15]
parts/lm8uu.stl
15.0 x 15.0 x 23.8
