JamesGlanville/solderingmachine/parts/corner.stl

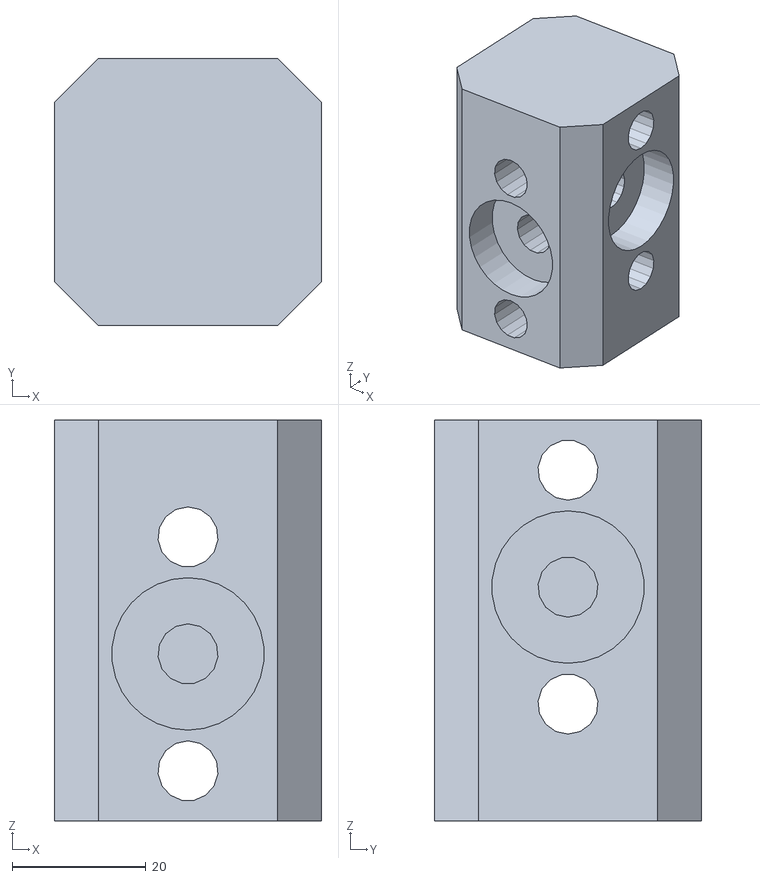
[picture p90: CAD file, 2013-10-15]
parts/corner.stl
40.0 x 40.0 x 60.0
