JamesGlanville/solderingmachine/parts/creo/needle_toolnew.stl

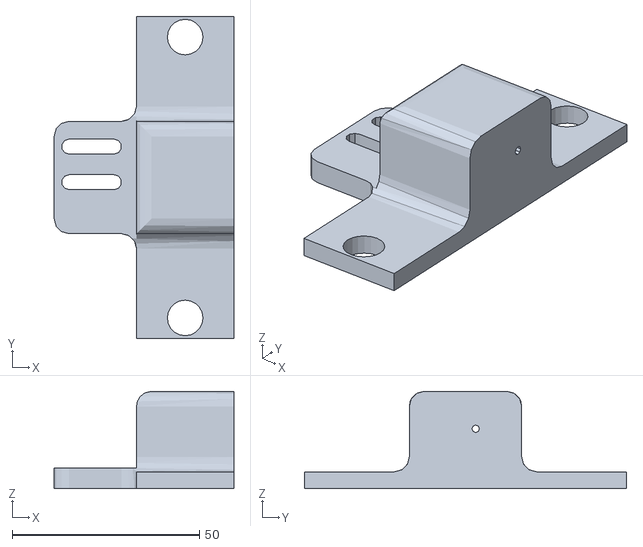
[picture p91: CAD file, 2014-03-29]
parts/creo/needle_toolnew.stl
48.0 x 86.0 x 26.0
