JamesGlanville/solderingmachine/parts/creo/prop_chassistesttt.stl

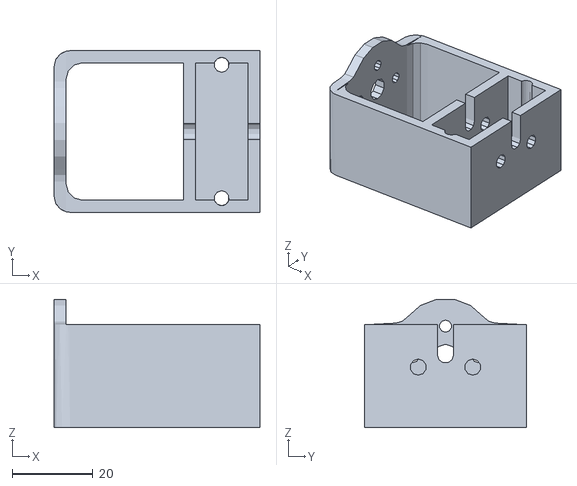
[picture p92: CAD file, 2014-03-29]
parts/creo/prop_chassistesttt.stl
51.0 x 40.0 x 31.8
