JamesGlanville/solderingmachine/parts/creo/prop_chassis5.stl

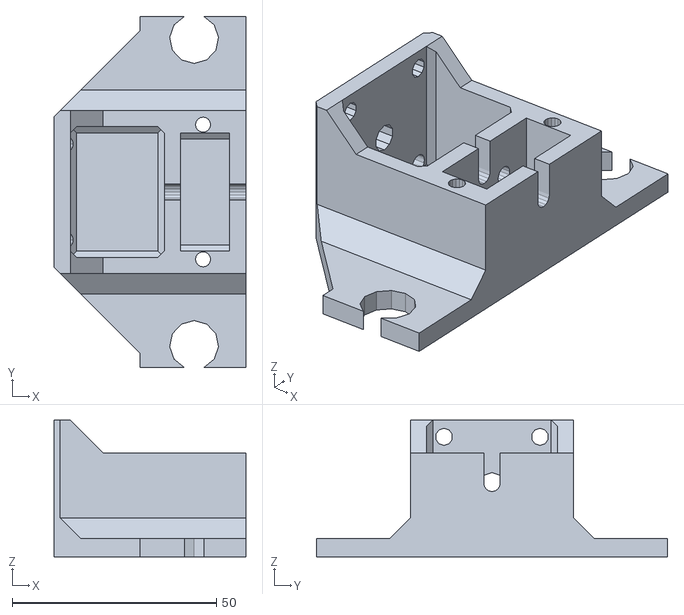
[picture p93: CAD file, 2014-03-29]
parts/creo/prop_chassis5.stl
47.0 x 86.0 x 33.5
