JamesGlanville/solderingmachine/parts/creo/prop_chassis4.stl

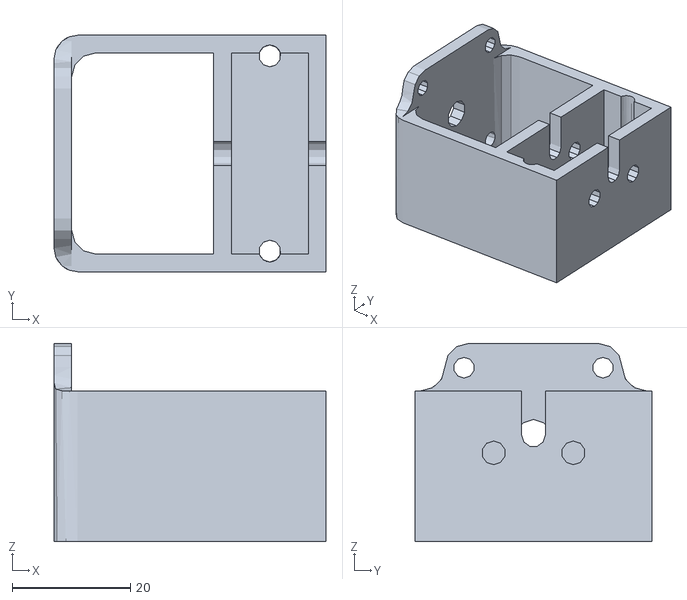
[picture p94: CAD file, 2014-03-29]
parts/creo/prop_chassis4.stl
46.0 x 40.0 x 33.5
