JamesGlanville/solderingmachine/parts/creo/bearing_idler.stl

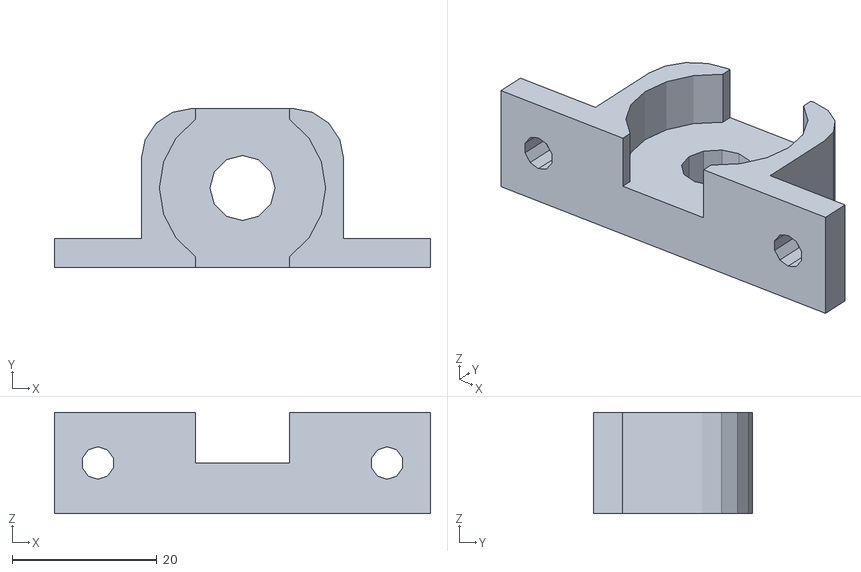
[picture p95: CAD file, 2014-03-26]
parts/creo/bearing_idler.stl
52.0 x 22.0 x 14.0
