JamesGlanville/solderingmachine/parts/creo/motorholdervents.stl

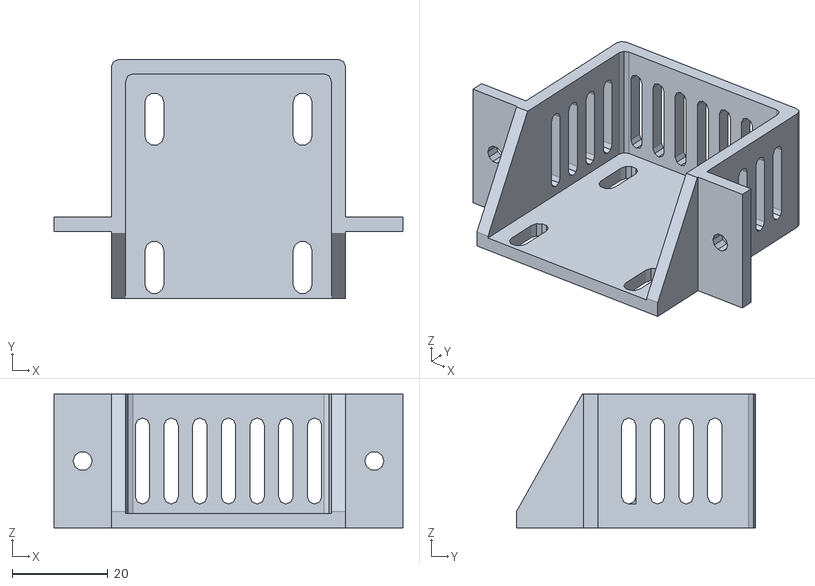
[picture p96: CAD file, 2014-03-26]
parts/creo/motorholdervents.stl
73.0 x 50.0 x 28.0
