JamesGlanville/solderingmachine/parts/creo/generictool.stl

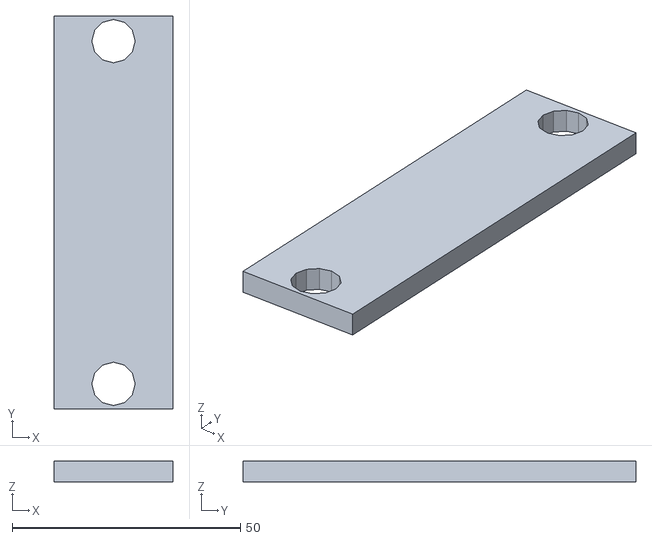
[picture p97: CAD file, 2014-03-11]
parts/creo/generictool.stl
26.0 x 86.0 x 4.50
