JamesGlanville/solderingmachine/parts/creo/extruder_mount.stl

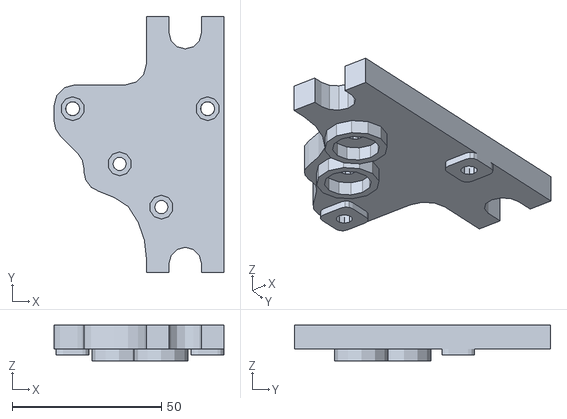
[picture p98: CAD file, 2014-03-11]
parts/creo/extruder_mount.stl
57.0 x 86.0 x 12.0
