JamesGlanville/solderingmachine/parts/creo/idlerfinal.stl

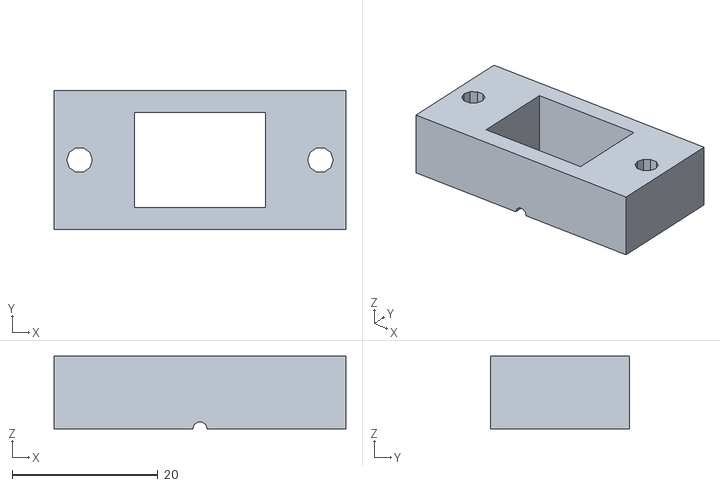
[picture p99: CAD file, 2014-03-11]
parts/creo/idlerfinal.stl
40.0 x 19.0 x 10.0
