JamesGlanville/solderingmachine/parts/creo/nuttrap.stl

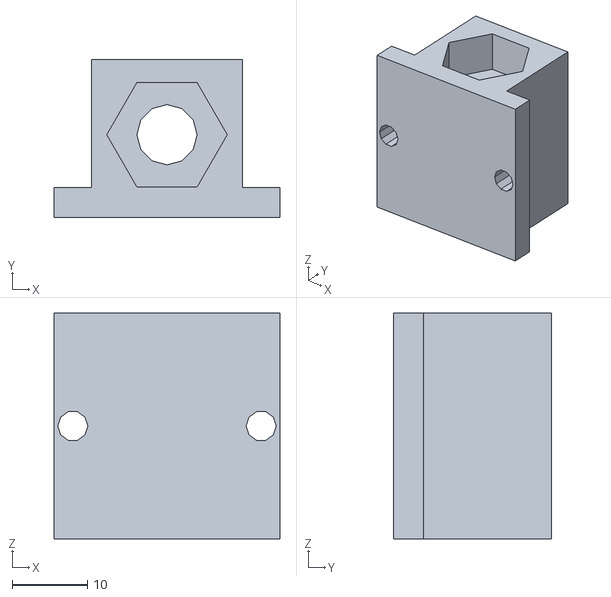
[picture p100: CAD file, 2014-03-11]
parts/creo/nuttrap.stl
30.0 x 21.0 x 30.0
