JamesGlanville/solderingmachine/parts/creo/extruder_motor.stl

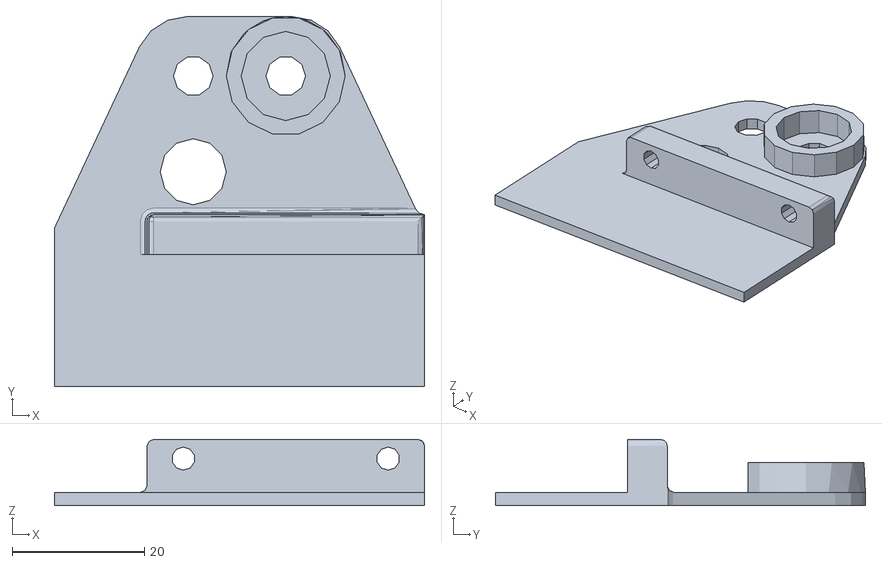
[picture p101: CAD file, 2014-03-11]
parts/creo/extruder_motor.stl
56.0 x 56.0 x 10.0
