JamesGlanville/solderingmachine/parts/creo/nuttrapwithz.stl

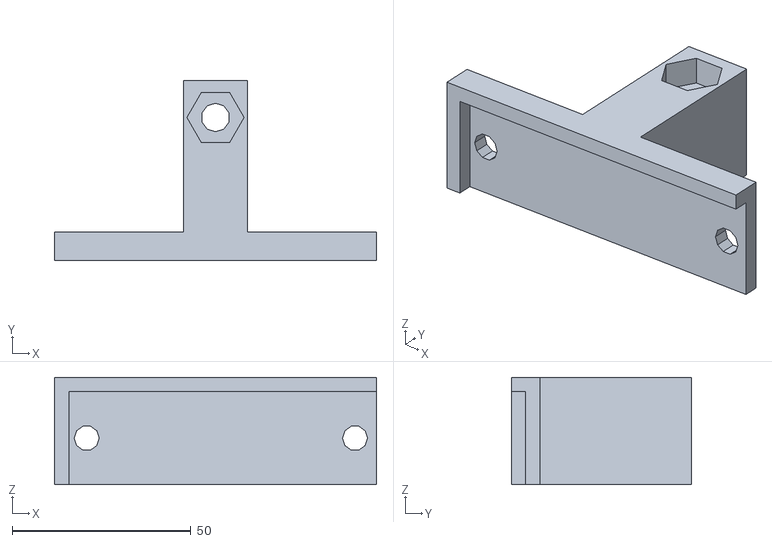
[picture p102: CAD file, 2014-03-11]
parts/creo/nuttrapwithz.stl
90.0 x 50.4 x 30.0
