JamesGlanville/solderingmachine/parts/creo/prop_chassis.stl

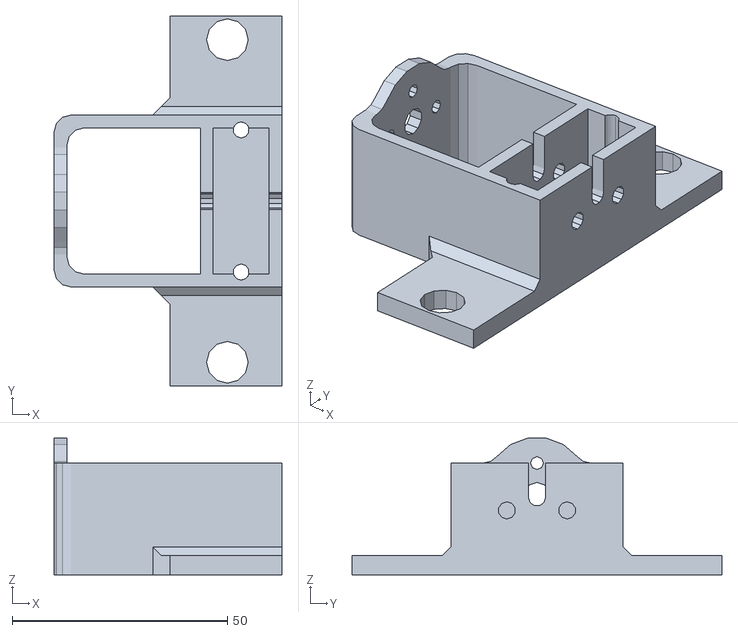
[picture p103: CAD file, 2014-03-11]
parts/creo/prop_chassis.stl
53.0 x 86.0 x 31.8
