JamesGlanville/solderingmachine/parts/creo/zmotorclamppart.stl

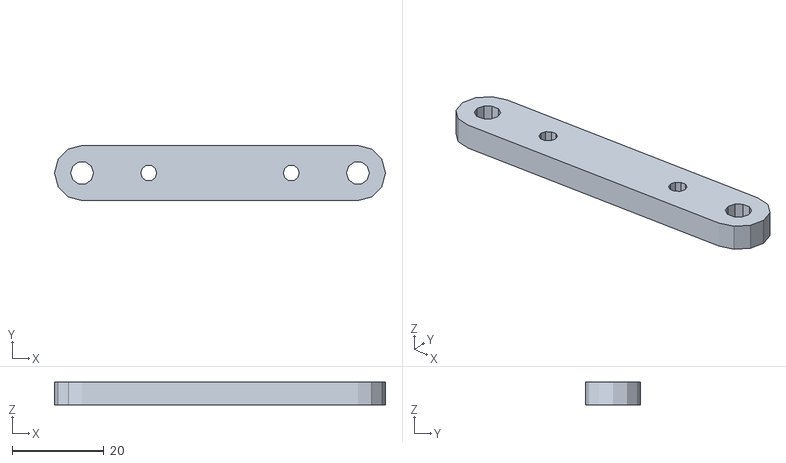
[picture p104: CAD file, 2014-03-11]
parts/creo/zmotorclamppart.stl
72.0 x 12.0 x 5.00
