JamesGlanville/solderingmachine/parts/creo/finalbearingholder.stl

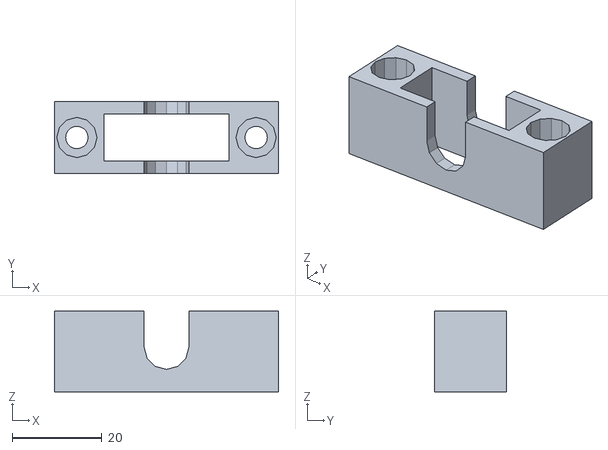
[picture p105: CAD file, 2014-03-11]
parts/creo/finalbearingholder.stl
50.0 x 16.0 x 18.0
