JamesGlanville/solderingmachine/parts/creo/stephen_attic.stl

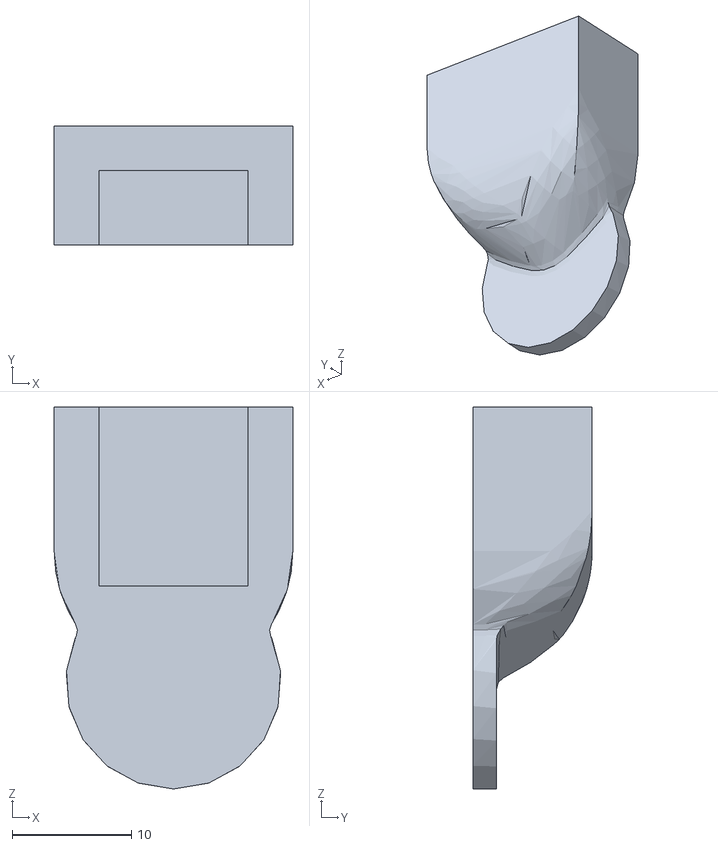
[picture p106: CAD file, 2014-03-11]
parts/creo/stephen_attic.stl
20.0 x 10.0 x 32.0
