JamesGlanville/solderingmachine/parts/creo/motorholder.stl

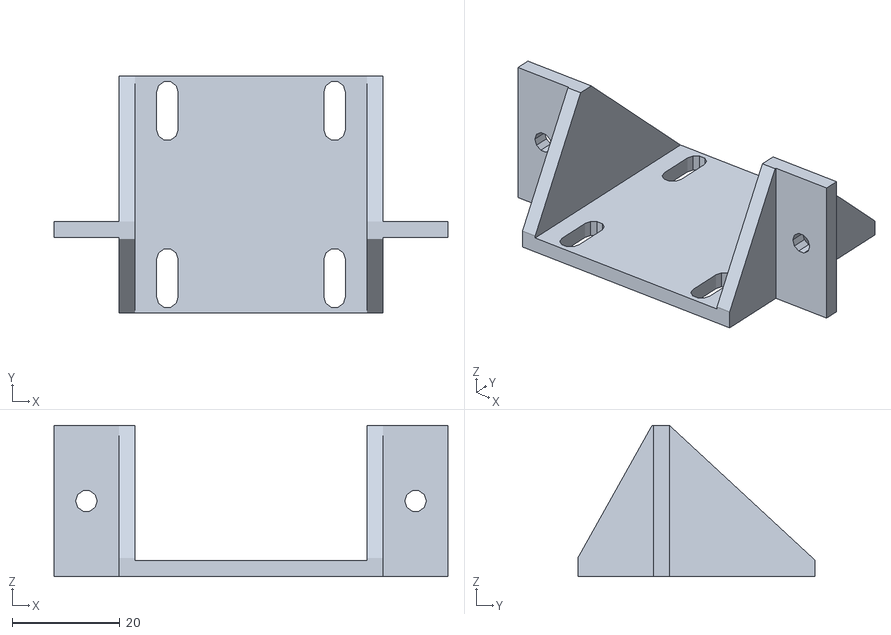
[picture p107: CAD file, 2013-12-21]
parts/creo/motorholder.stl
73.0 x 44.0 x 28.0
