JamesGlanville/solderingmachine/parts/creo/rollerbottom.stl

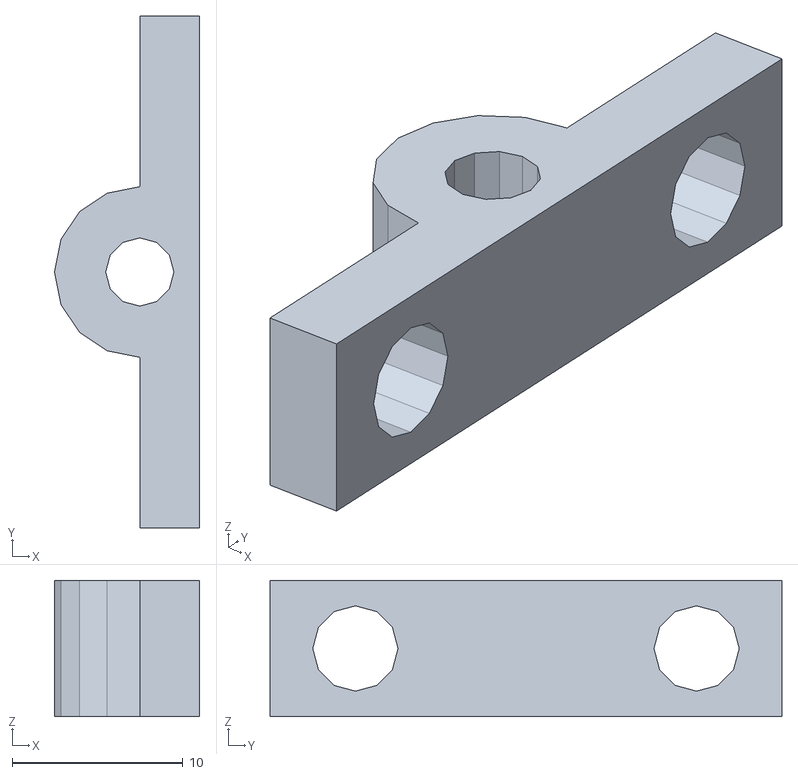
[picture p108: CAD file, 2013-12-06]
parts/creo/rollerbottom.stl
8.50 x 30.0 x 8.00
