JamesGlanville/solderingmachine/parts/creo/ymotor.stl

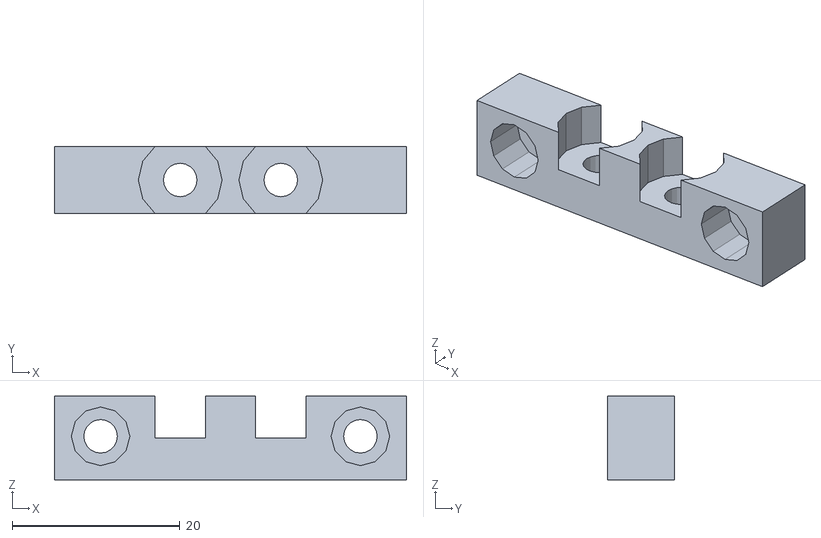
[picture p109: CAD file, 2013-11-12]
parts/creo/ymotor.stl
42.0 x 8.00 x 10.0
