JamesGlanville/solderingmachine/parts/backlash.scad

scale([1,1,5]){
difference()
{
	union()
{
	cylinder(r=16,h=4);
	translate([-8,-36,0])cube([16,36,4]);
}
	translate([-50,0,-1])cube(100);
	translate([0,0,-1])cylinder(r=12,h=10);
	translate([-5,-68,-3])cube([10,50,20]);
}}
