JamesGlanville/solderingmachine/parts/bearing.scad

difference()
{

union()

{translate([-1.8,6,12.66])import("lm8uu.stl");
difference(){
cylinder(r=11,h=24);
translate([0,0,-1])cylinder(r=7,h=26);

}


translate([-8,7.5,0])cube([16,20,24]);
}

translate([0,8,12])rotate([-90,0,0])cylinder(r=8.5/2,h=50);

}
