JamesGlanville/solderingmachine/(list of files, cad)

Other CAD files:
parts/creo/motorholderabs.stl
parts/syringe.dxf
