JamesGlanville/solderingmachine/testboards/PIC18F452_5V/PIC18F452_5V - CADCAM Bottom Solder Resist.TXT

G04 PROTEUS RS274X GERBER FILE*
%FSLAX24Y24*%
%MOIN*%
%ADD21C,0.0600*%
%ADD70R,0.0800X0.0600*%
%ADD32R,0.1000X0.1000*%
%ADD33C,0.1000*%
%ADD20C,0.0800*%
%ADD34R,0.0800X0.0800*%
%ADD35C,0.1184*%
%ADD36C,0.2200*%
%ADD14C,0.0080*%
G54D21*
X-2500Y+5000D03*
X-3000Y+4000D03*
X+7500Y-1000D03*
X+14000Y-6500D03*
X+14000Y-1500D03*
X+12500Y-1500D03*
X+15000Y-5000D03*
X+11500Y-1000D03*
X+6000Y-500D03*
X+8500Y+0D03*
X-700Y-846D03*
X-700Y+700D03*
X-4712Y-350D03*
X-4000Y+6300D03*
X+3447Y+9800D03*
X+4007Y+0D03*
X+4007Y+3150D03*
X+4900Y+4500D03*
X+14102Y+700D03*
X+15676Y+1050D03*
X+12750Y-4500D03*
X-5650Y-8000D03*
X-5100Y-7400D03*
X+10200Y-4250D03*
X+10200Y-2000D03*
X+2950Y-2100D03*
X+6500Y-3650D03*
X+3700Y-2550D03*
X+2200Y-4450D03*
X+1050Y-5800D03*
X+150Y-6350D03*
X-2000Y+7972D03*
X-5905Y+7000D03*
X-6496Y+8000D03*
X-6299Y+9000D03*
X-6692Y+10000D03*
X+4330Y-8100D03*
X+5905Y-8100D03*
X+3937Y-7700D03*
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
