JamesGlanville/solderingmachine/electronics/usb_isolator/usb_isolator.pdf

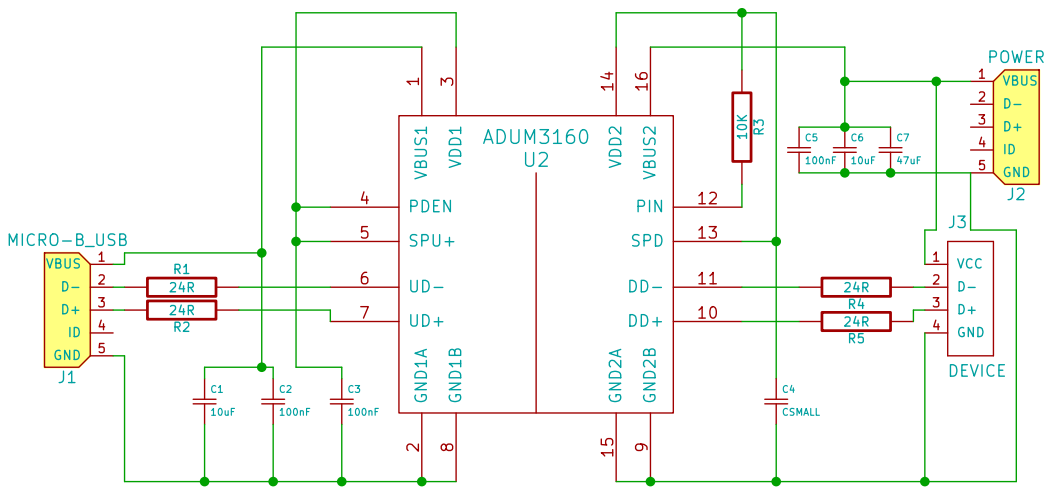
[picture p110: page 1]

9 DD+ 10 DD- 11 PIN 12 SPD 13 VDD2 14 GND2A 15 VBUS2 16 U2 ADUM3160

3 PDEN 4 SPU+ 5 UD- 6 UD+ 7 GND1B

Id: 1/1 Title: File: usb_isolator.sch
