JamesGlanville/solderingmachine/electronics/servo_tester/servo_tester.pdf

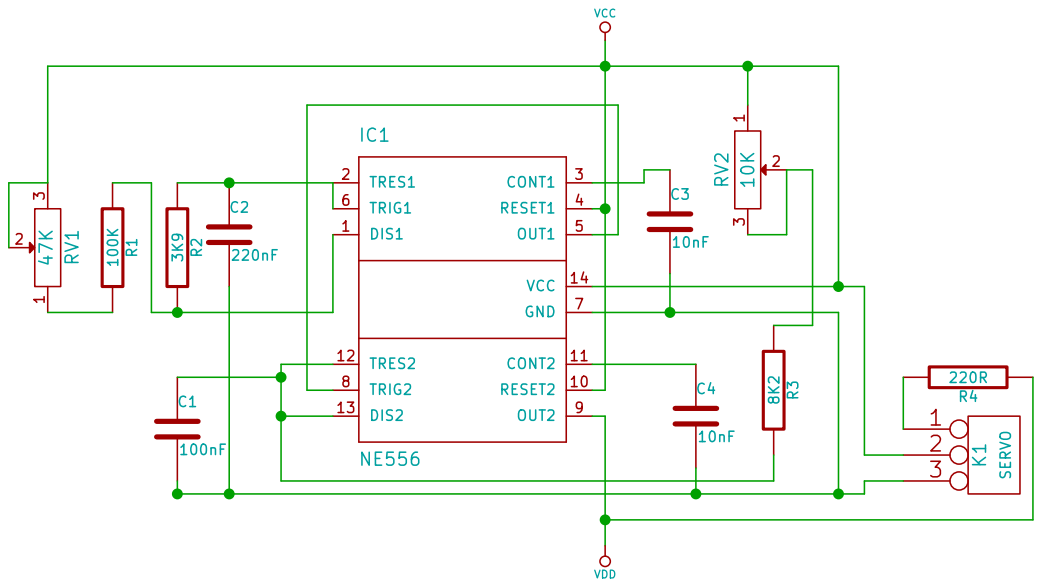
[picture p111: page 1]

Id: 1/1 Title: File: servo_tester.sch
Sheet: /
