JamesGlanville/solderingmachine/electronics/HC-05 breakout/HC-05 breakout.pdf

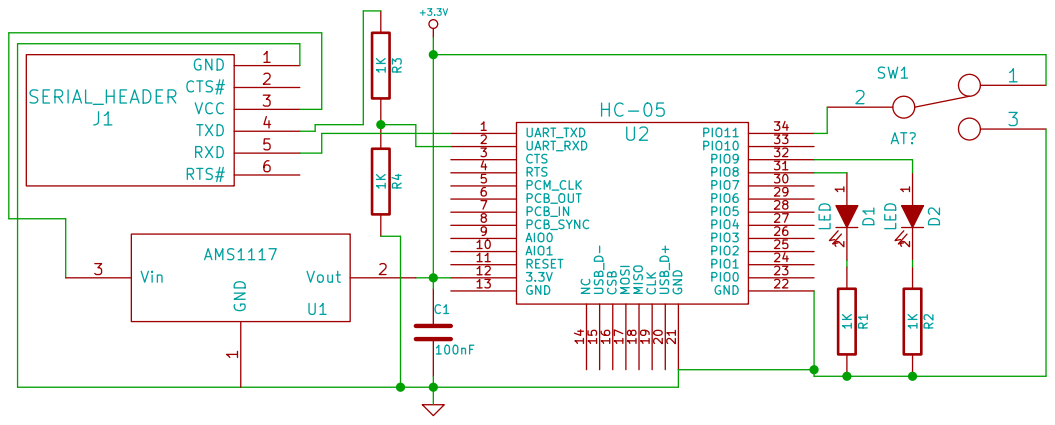
[picture p112: page 1]

Id: 1/1 Title: File: HC-05 breakout.sch
Sheet: /
