JamesGlanville/solderingmachine/electronics/lcd_backpack/lcd_backpack.pdf

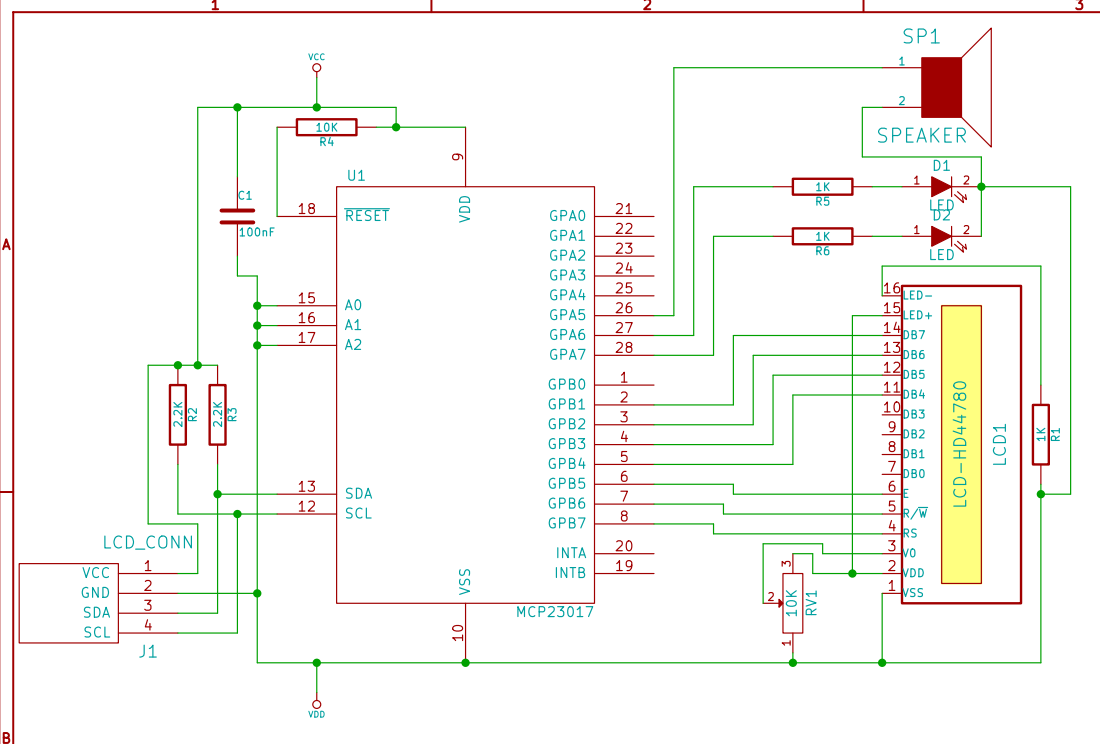
[picture p113: page 1]

Id: 1/1 Title: File: lcd_backpack.sch
Sheet: /
