JamesGlanville/solderingmachine/parts/creo/base_back.pdf

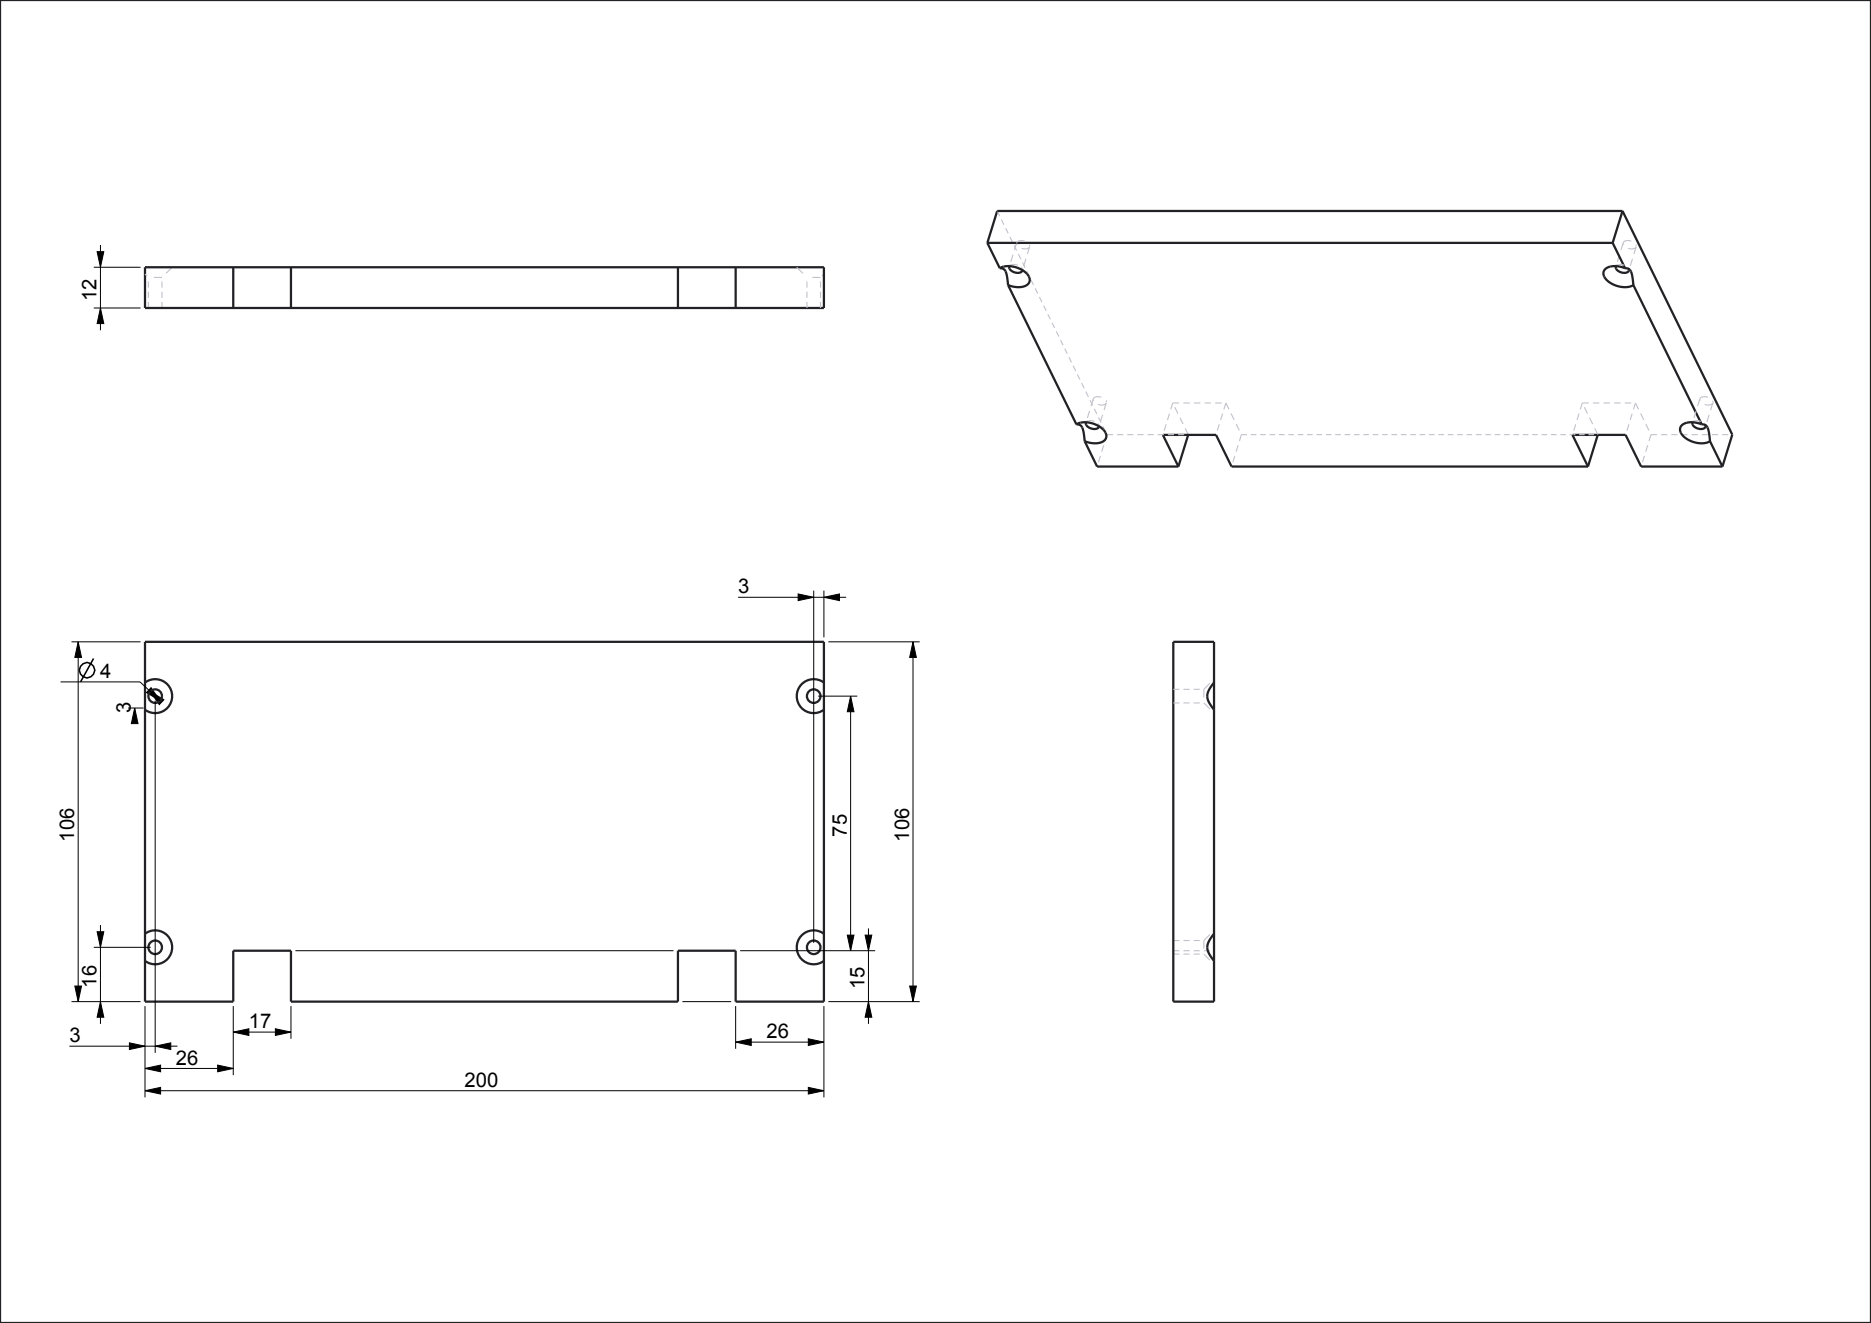
[picture p114: page 1]
