JamesGlanville/solderingmachine/parts/creo/base_board.pdf

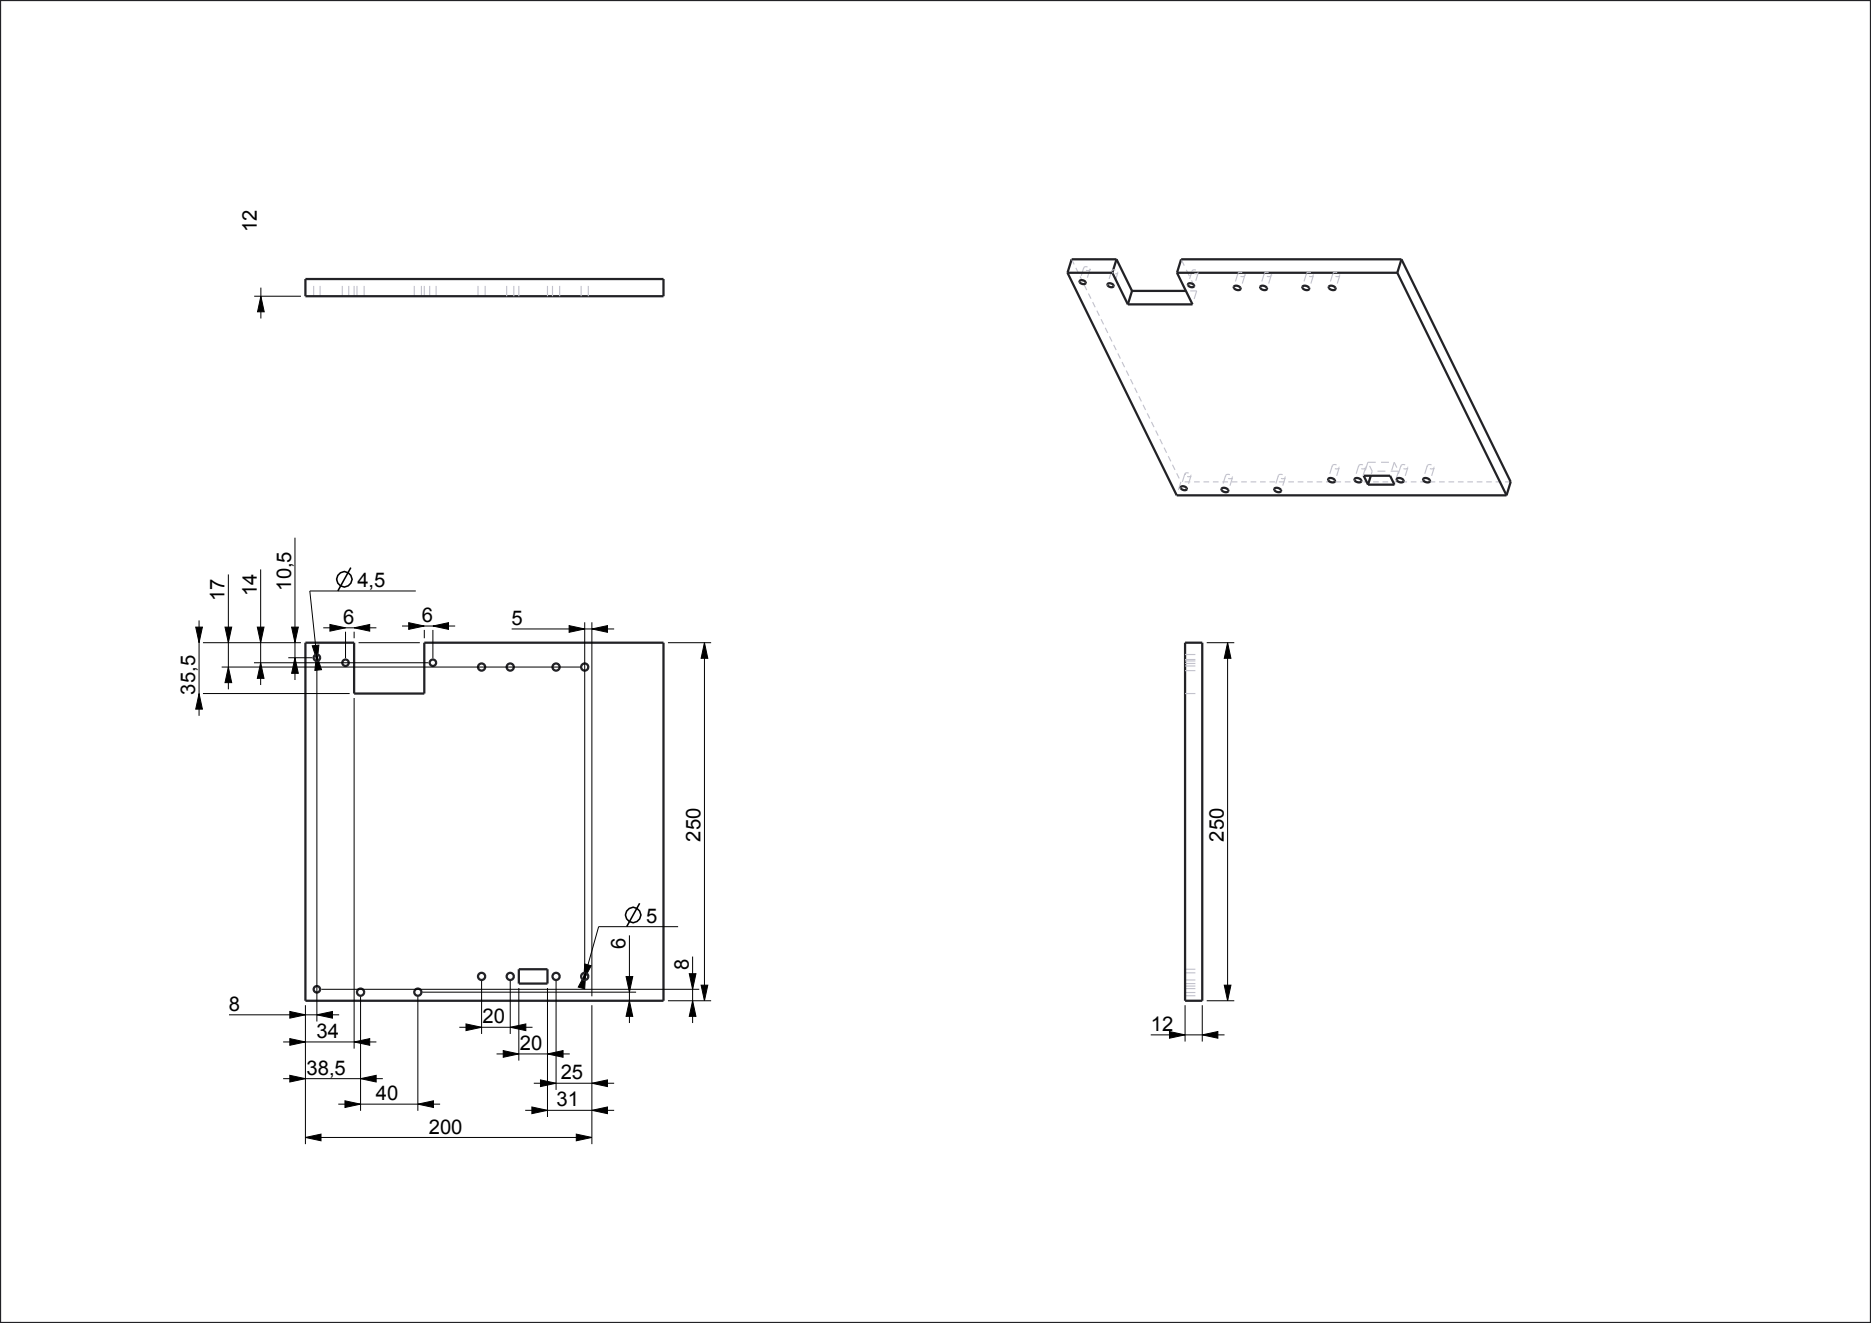
[picture p115: page 1]
