JamesGlanville/solderingmachine/parts/creo/base_bottom.pdf

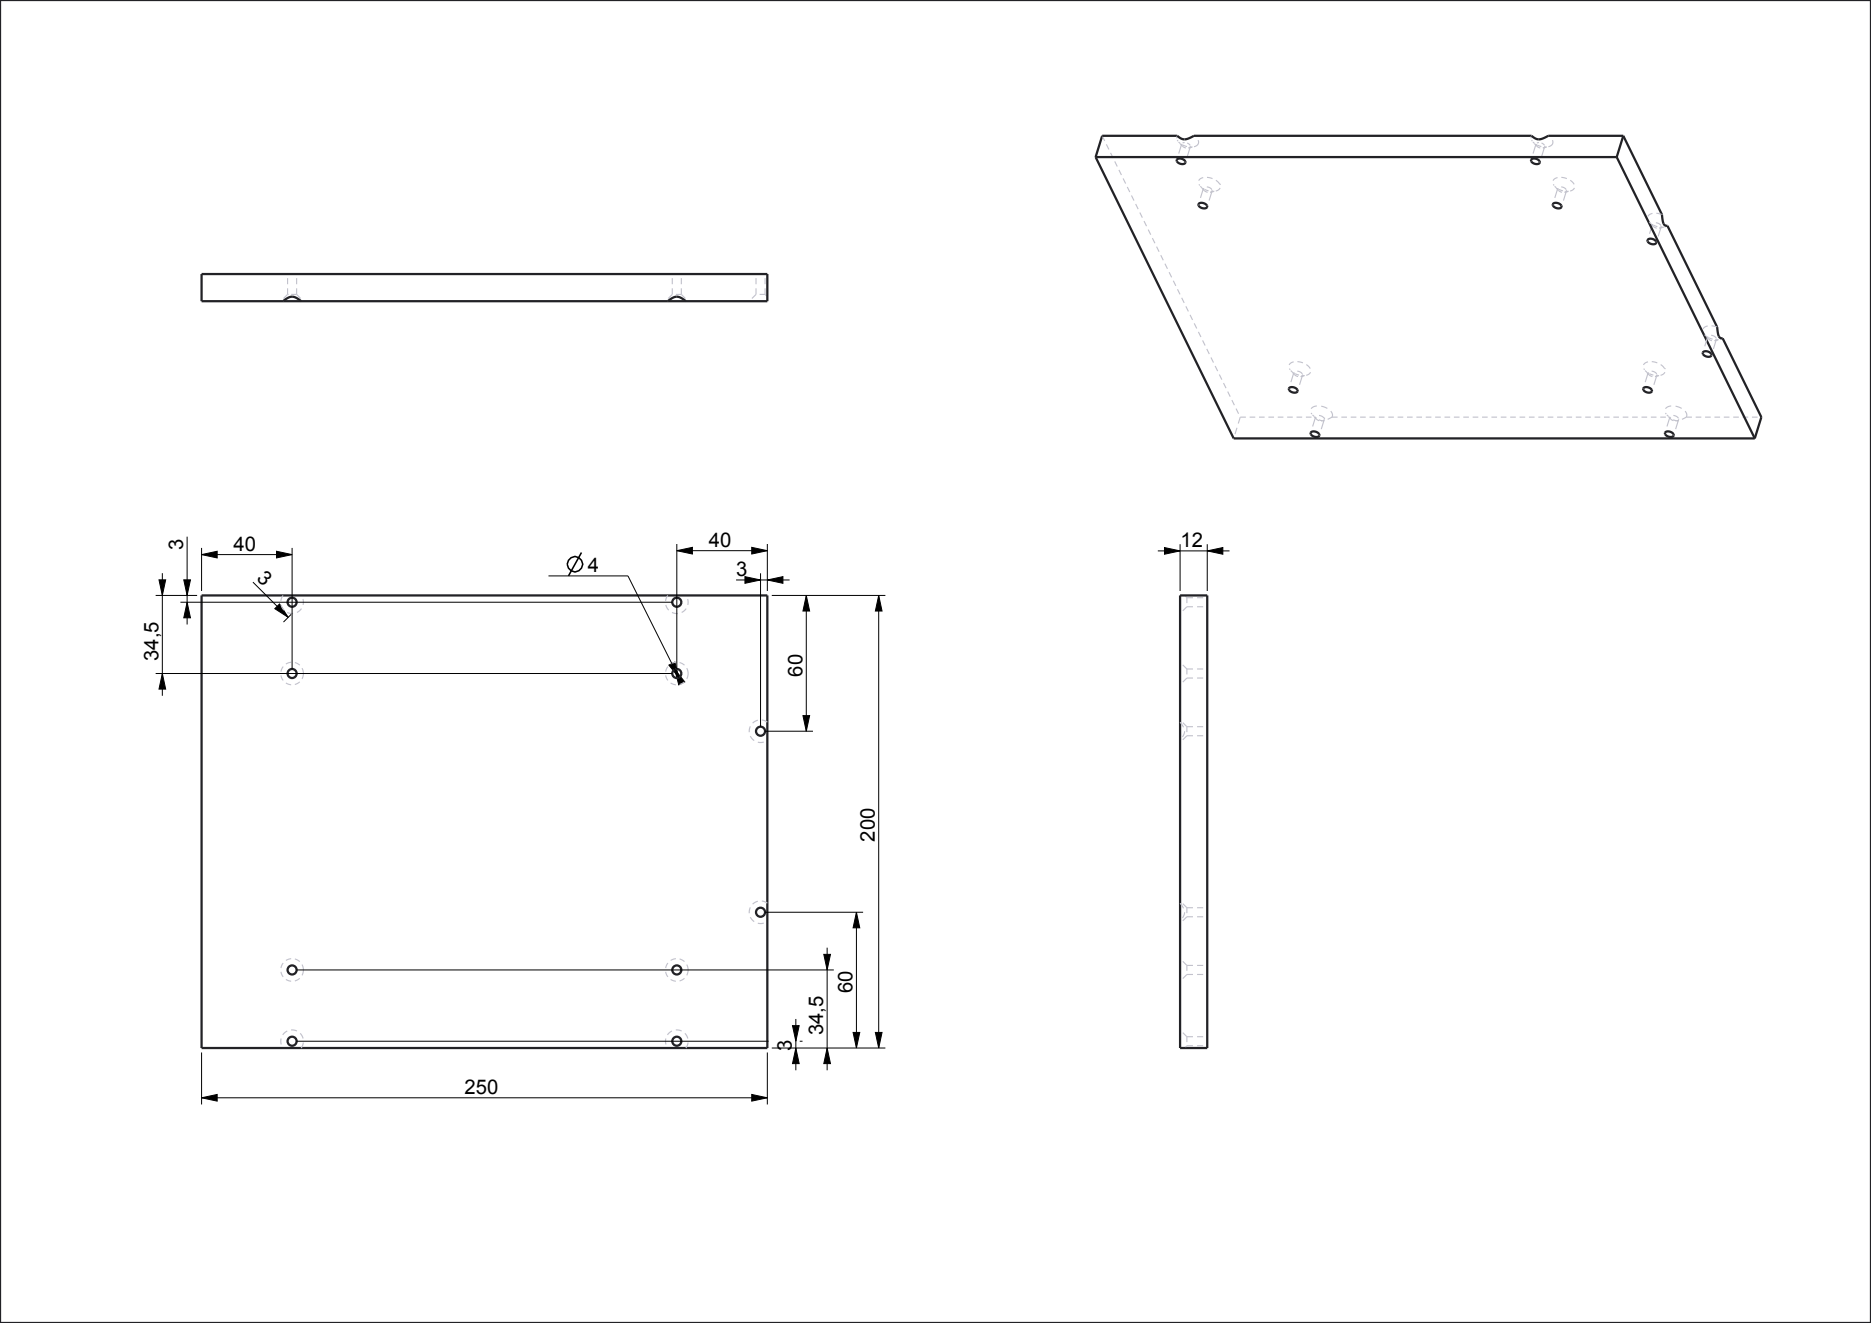
[picture p116: page 1]
