JamesGlanville/solderingmachine/parts/creo/bearing_idler.pdf

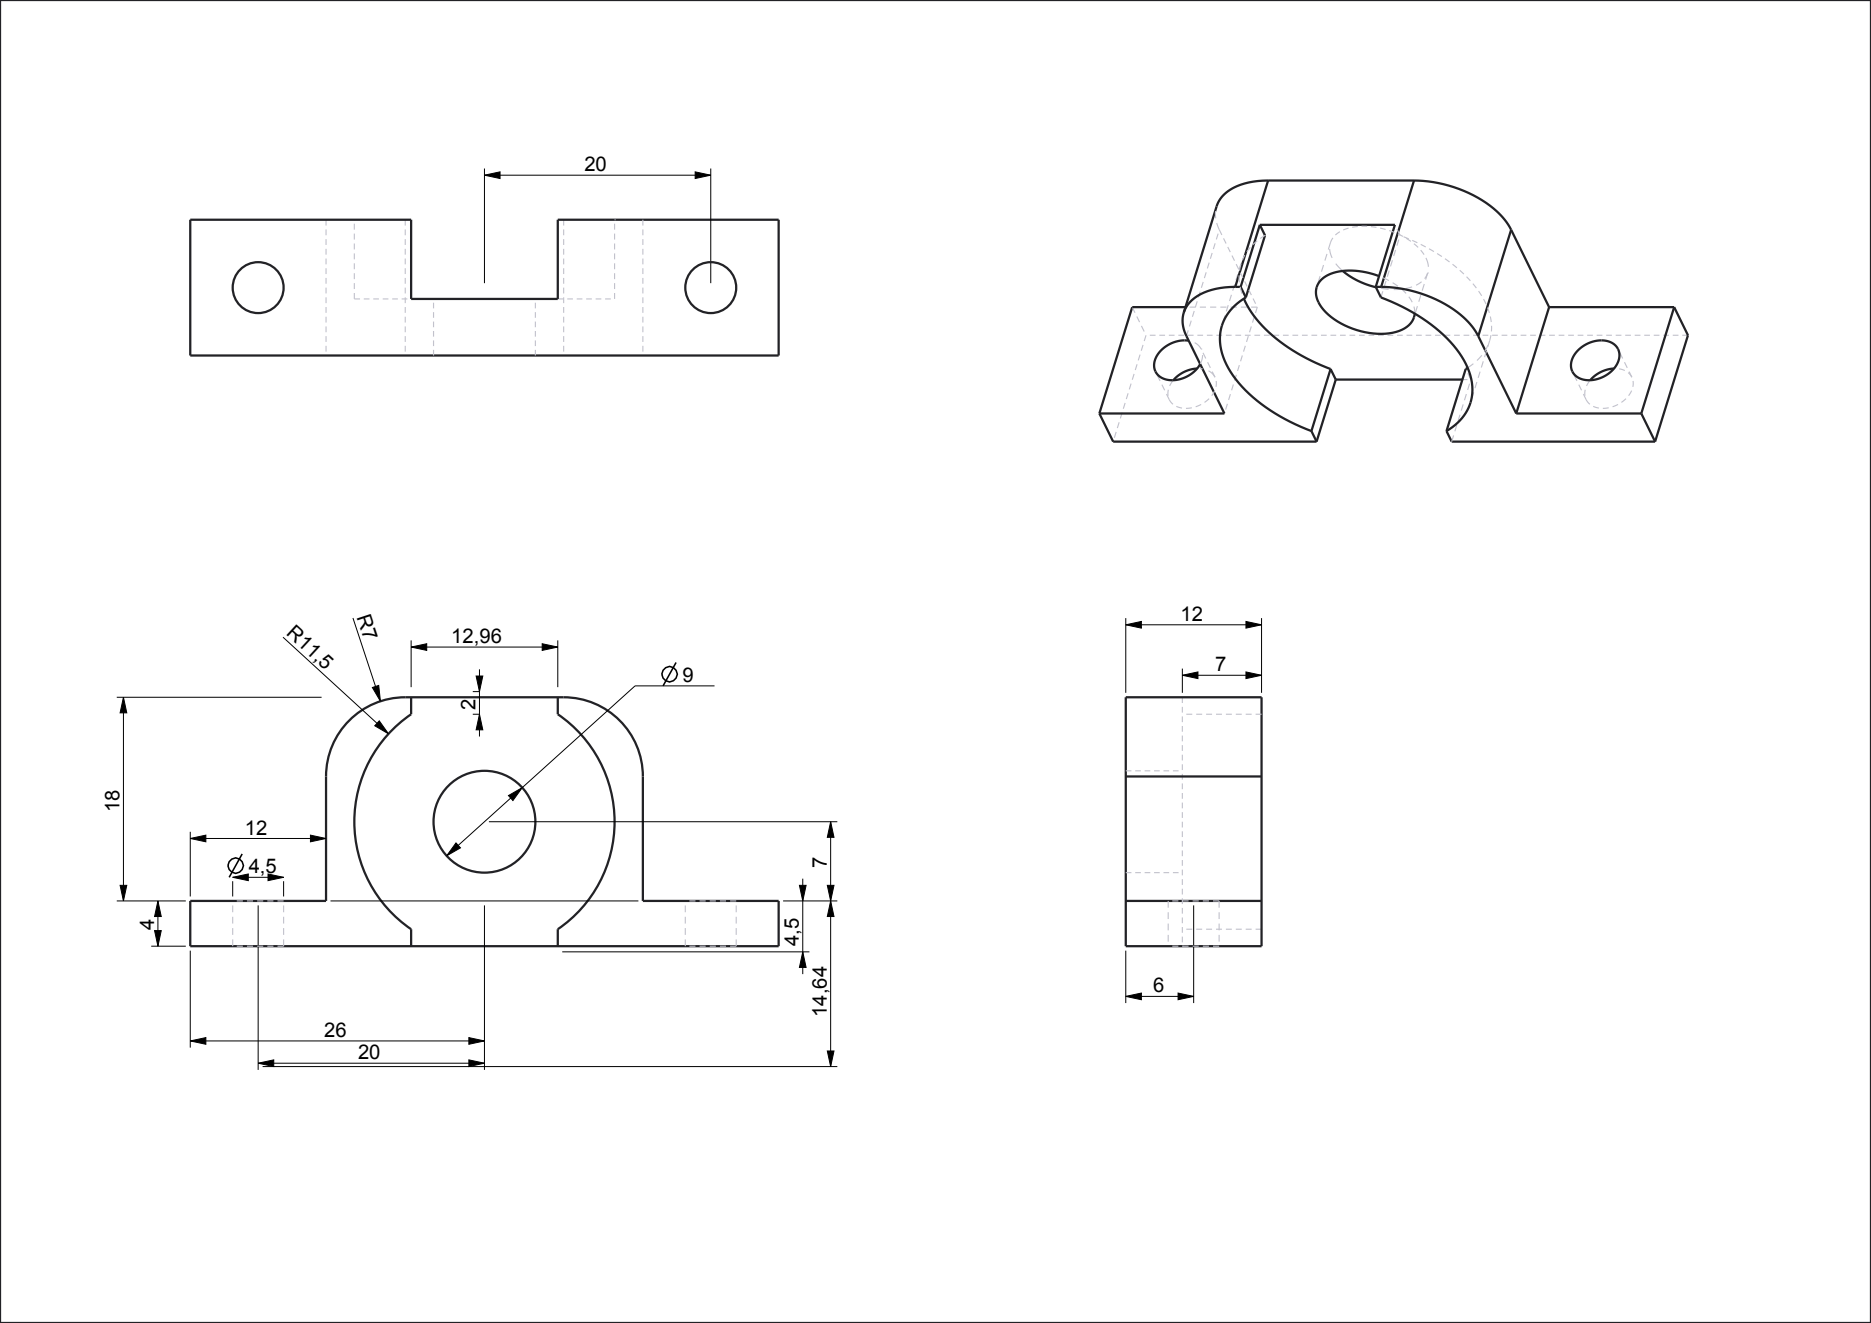
[picture p117: page 1]
