JamesGlanville/solderingmachine/parts/creo/bed.pdf

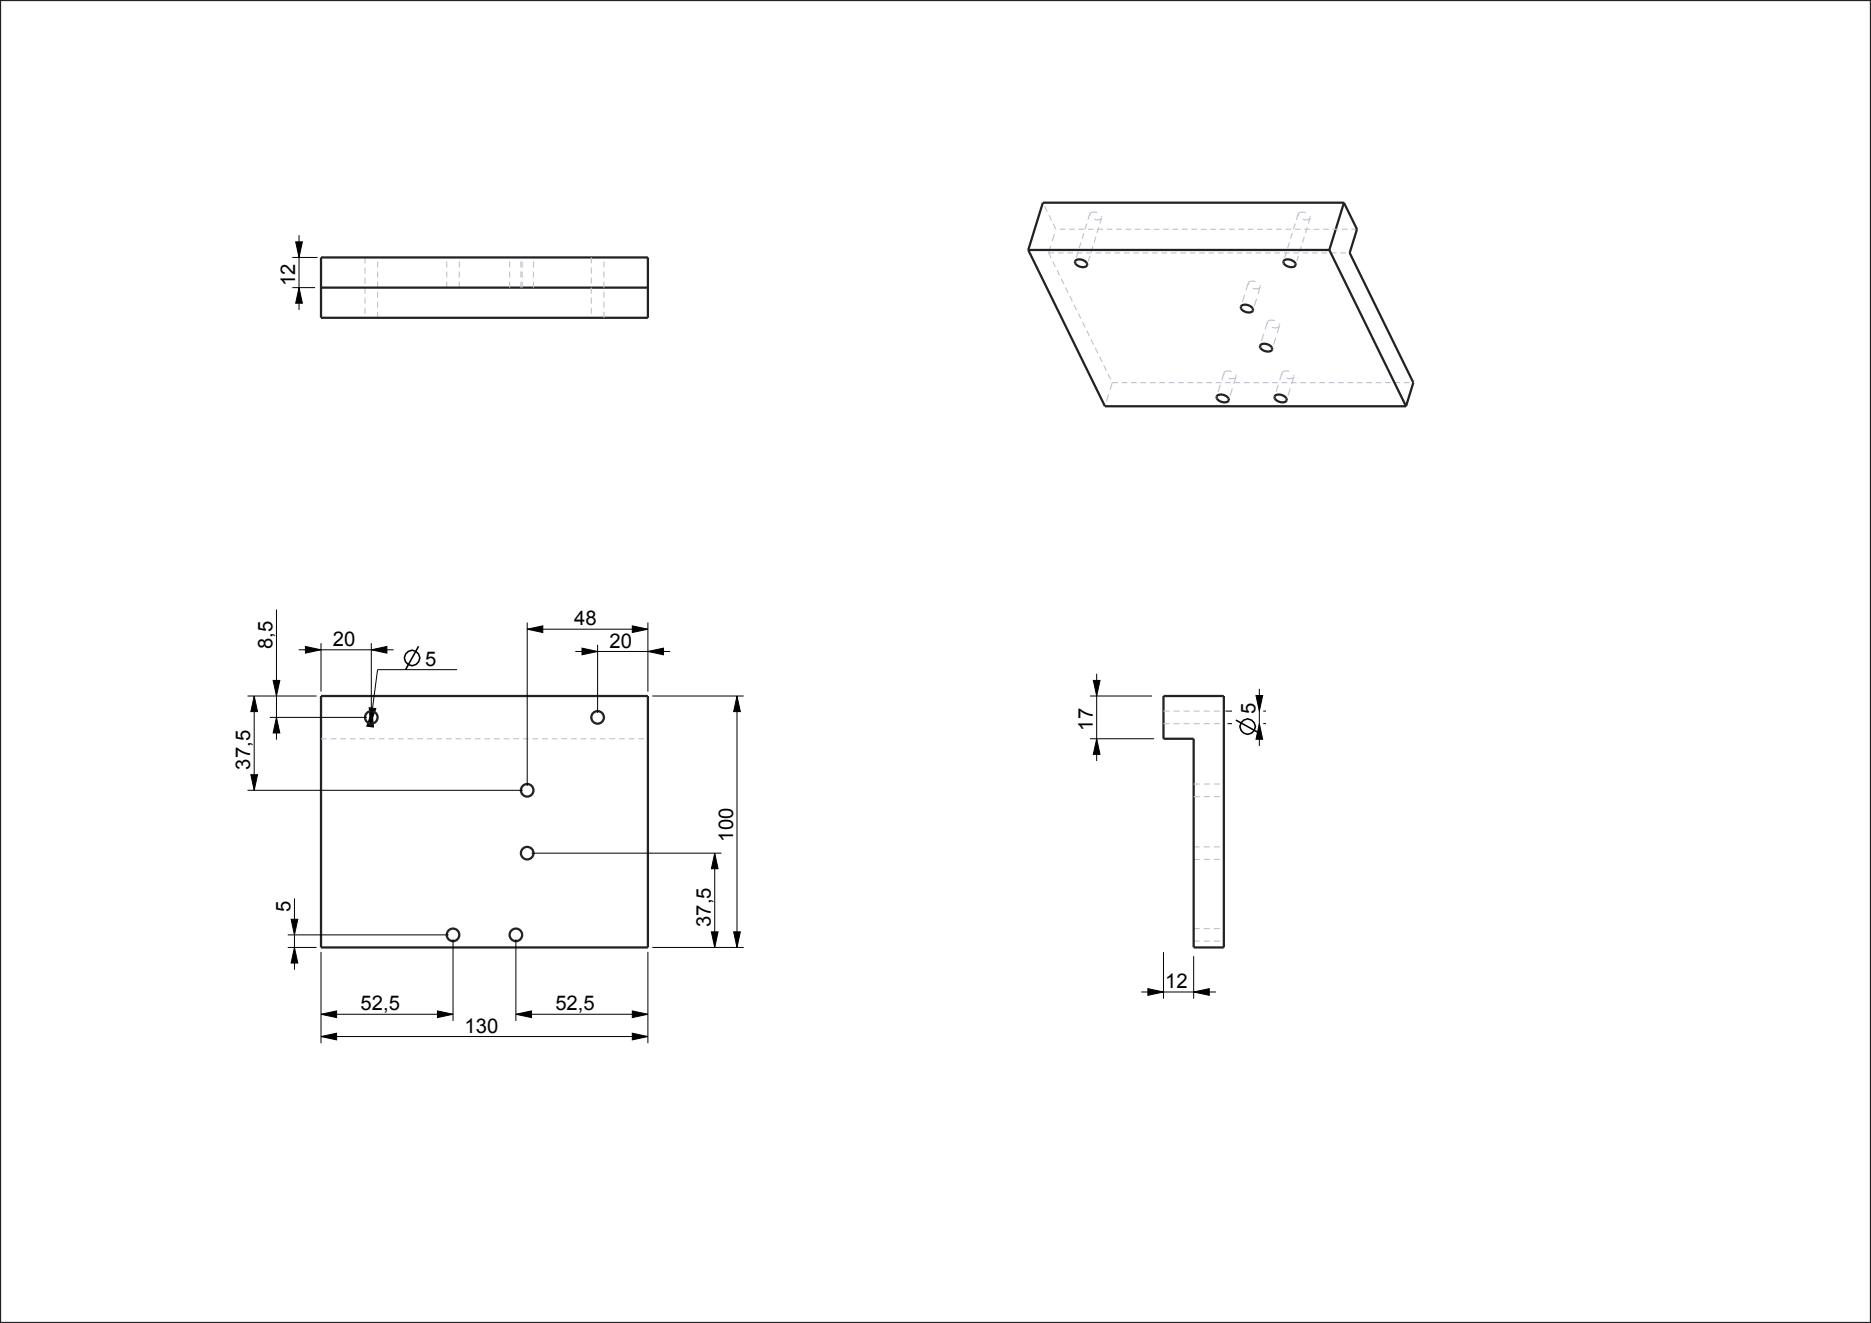
[picture p118: page 1]
