JamesGlanville/solderingmachine/parts/creo/coupler.pdf

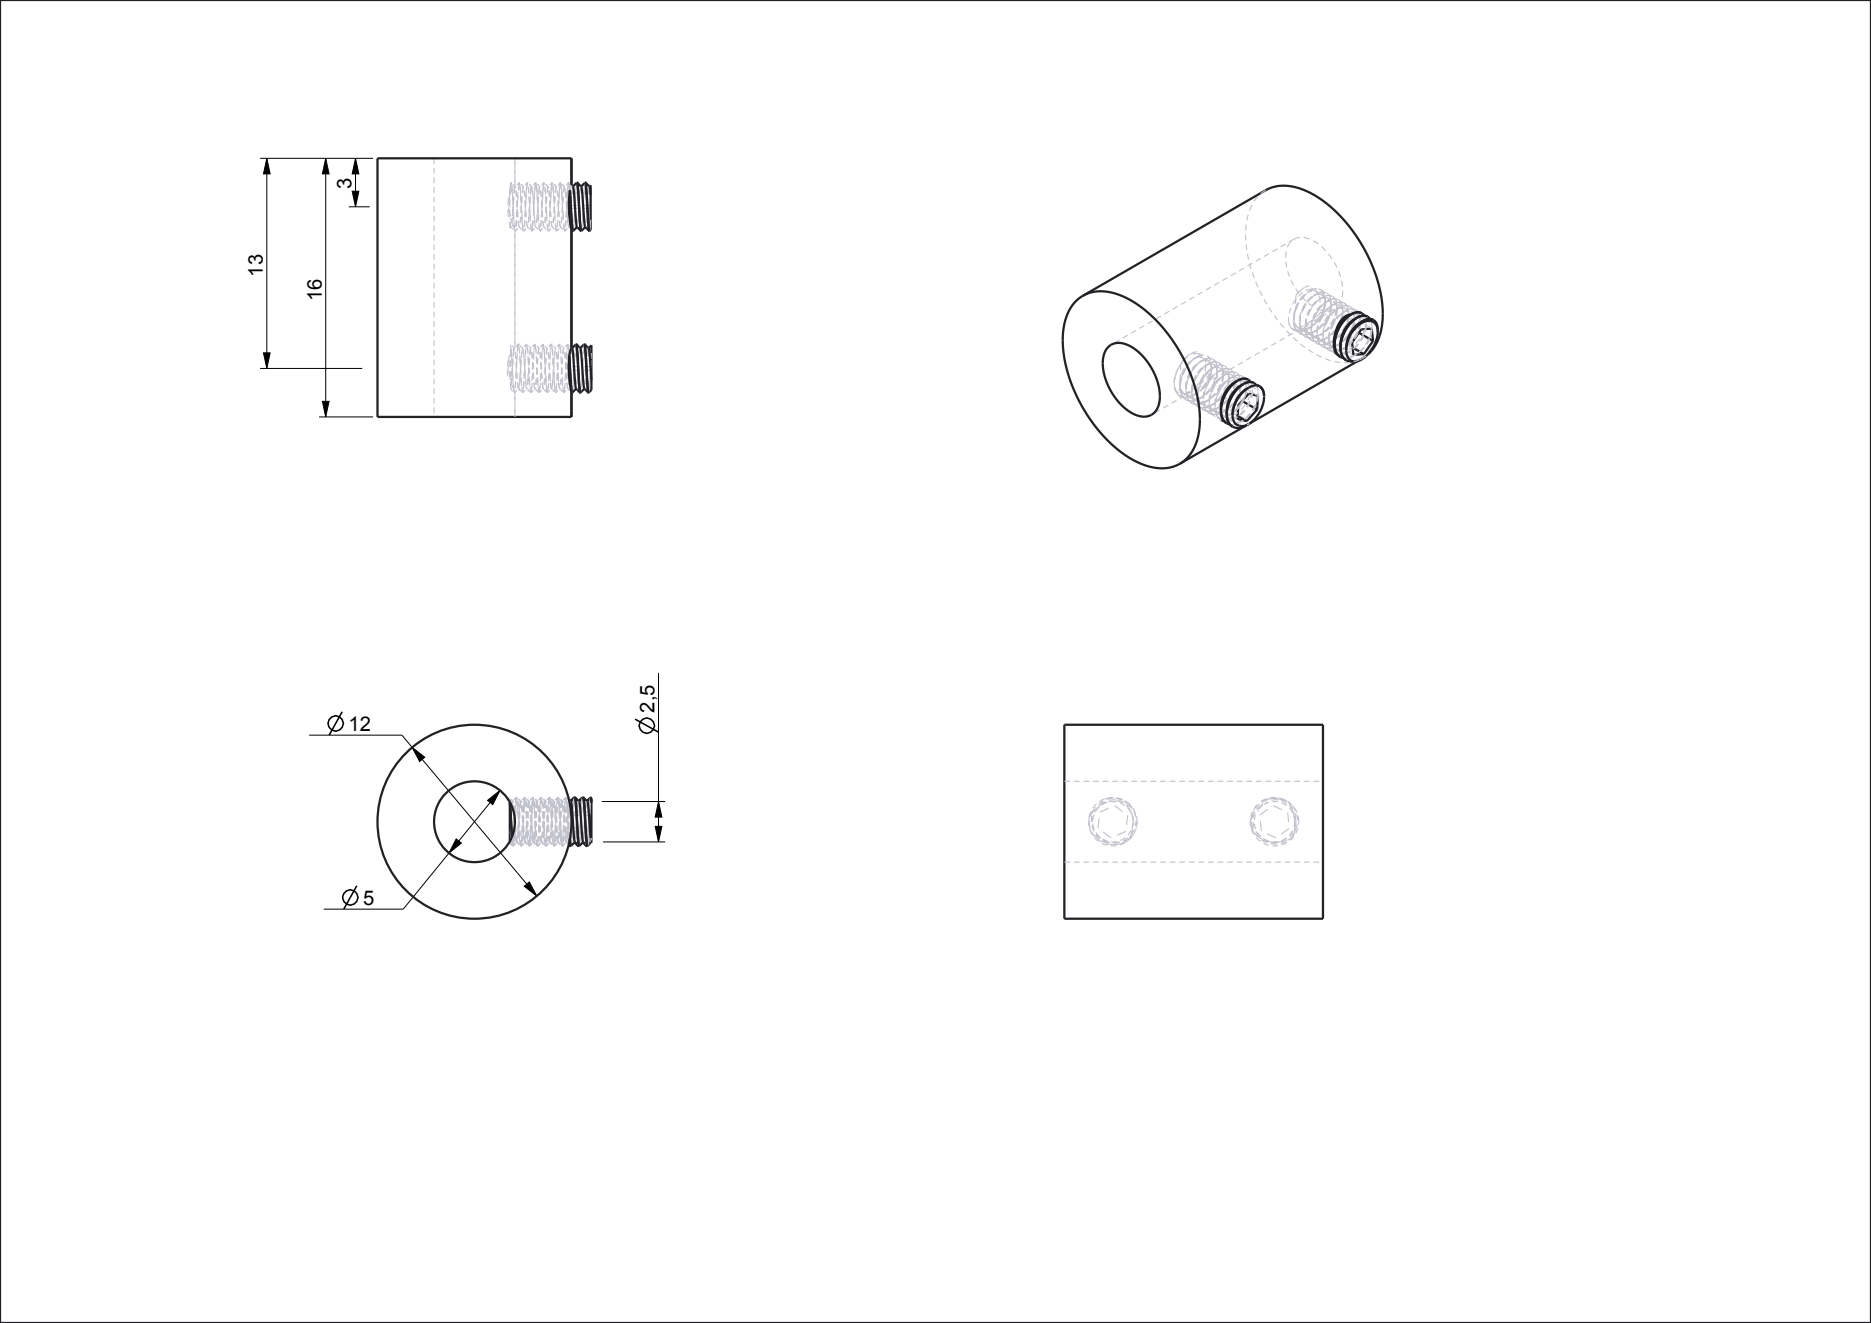
[picture p119: page 1]
