JamesGlanville/solderingmachine/parts/creo/electronicsbed.pdf

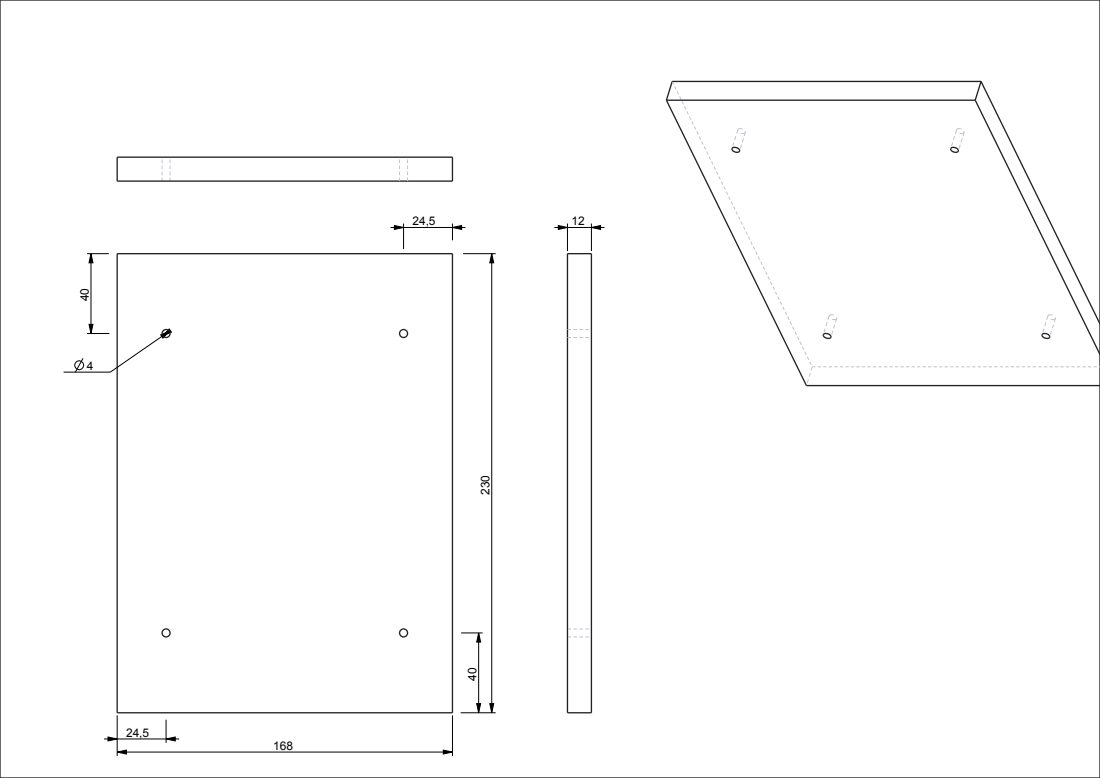
[picture p120: page 1]
