JamesGlanville/solderingmachine/parts/creo/prop_chassis.pdf

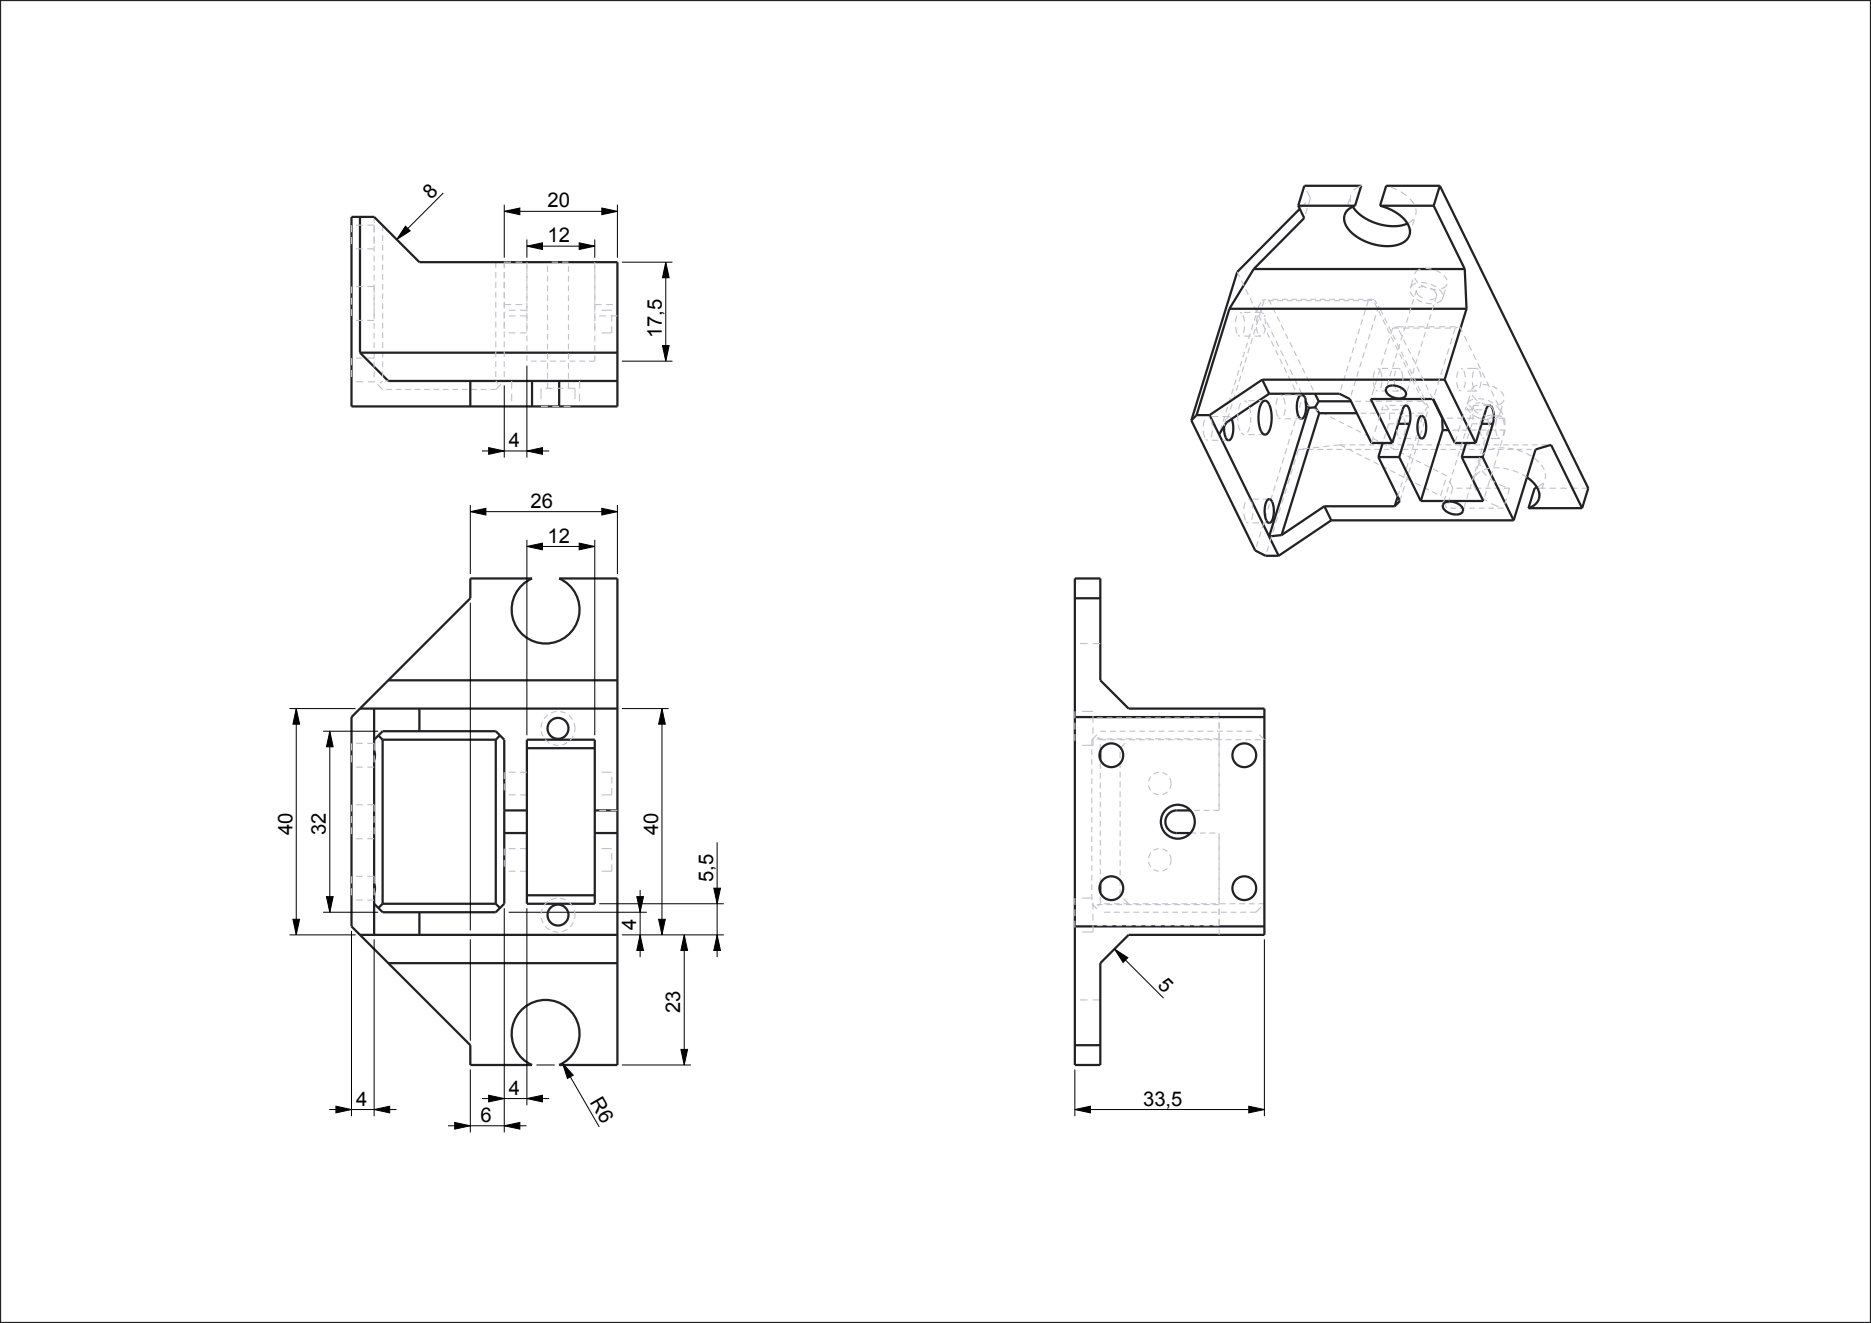
[picture p121: page 1]
