JamesGlanville/solderingmachine/parts/creo/side_front.pdf

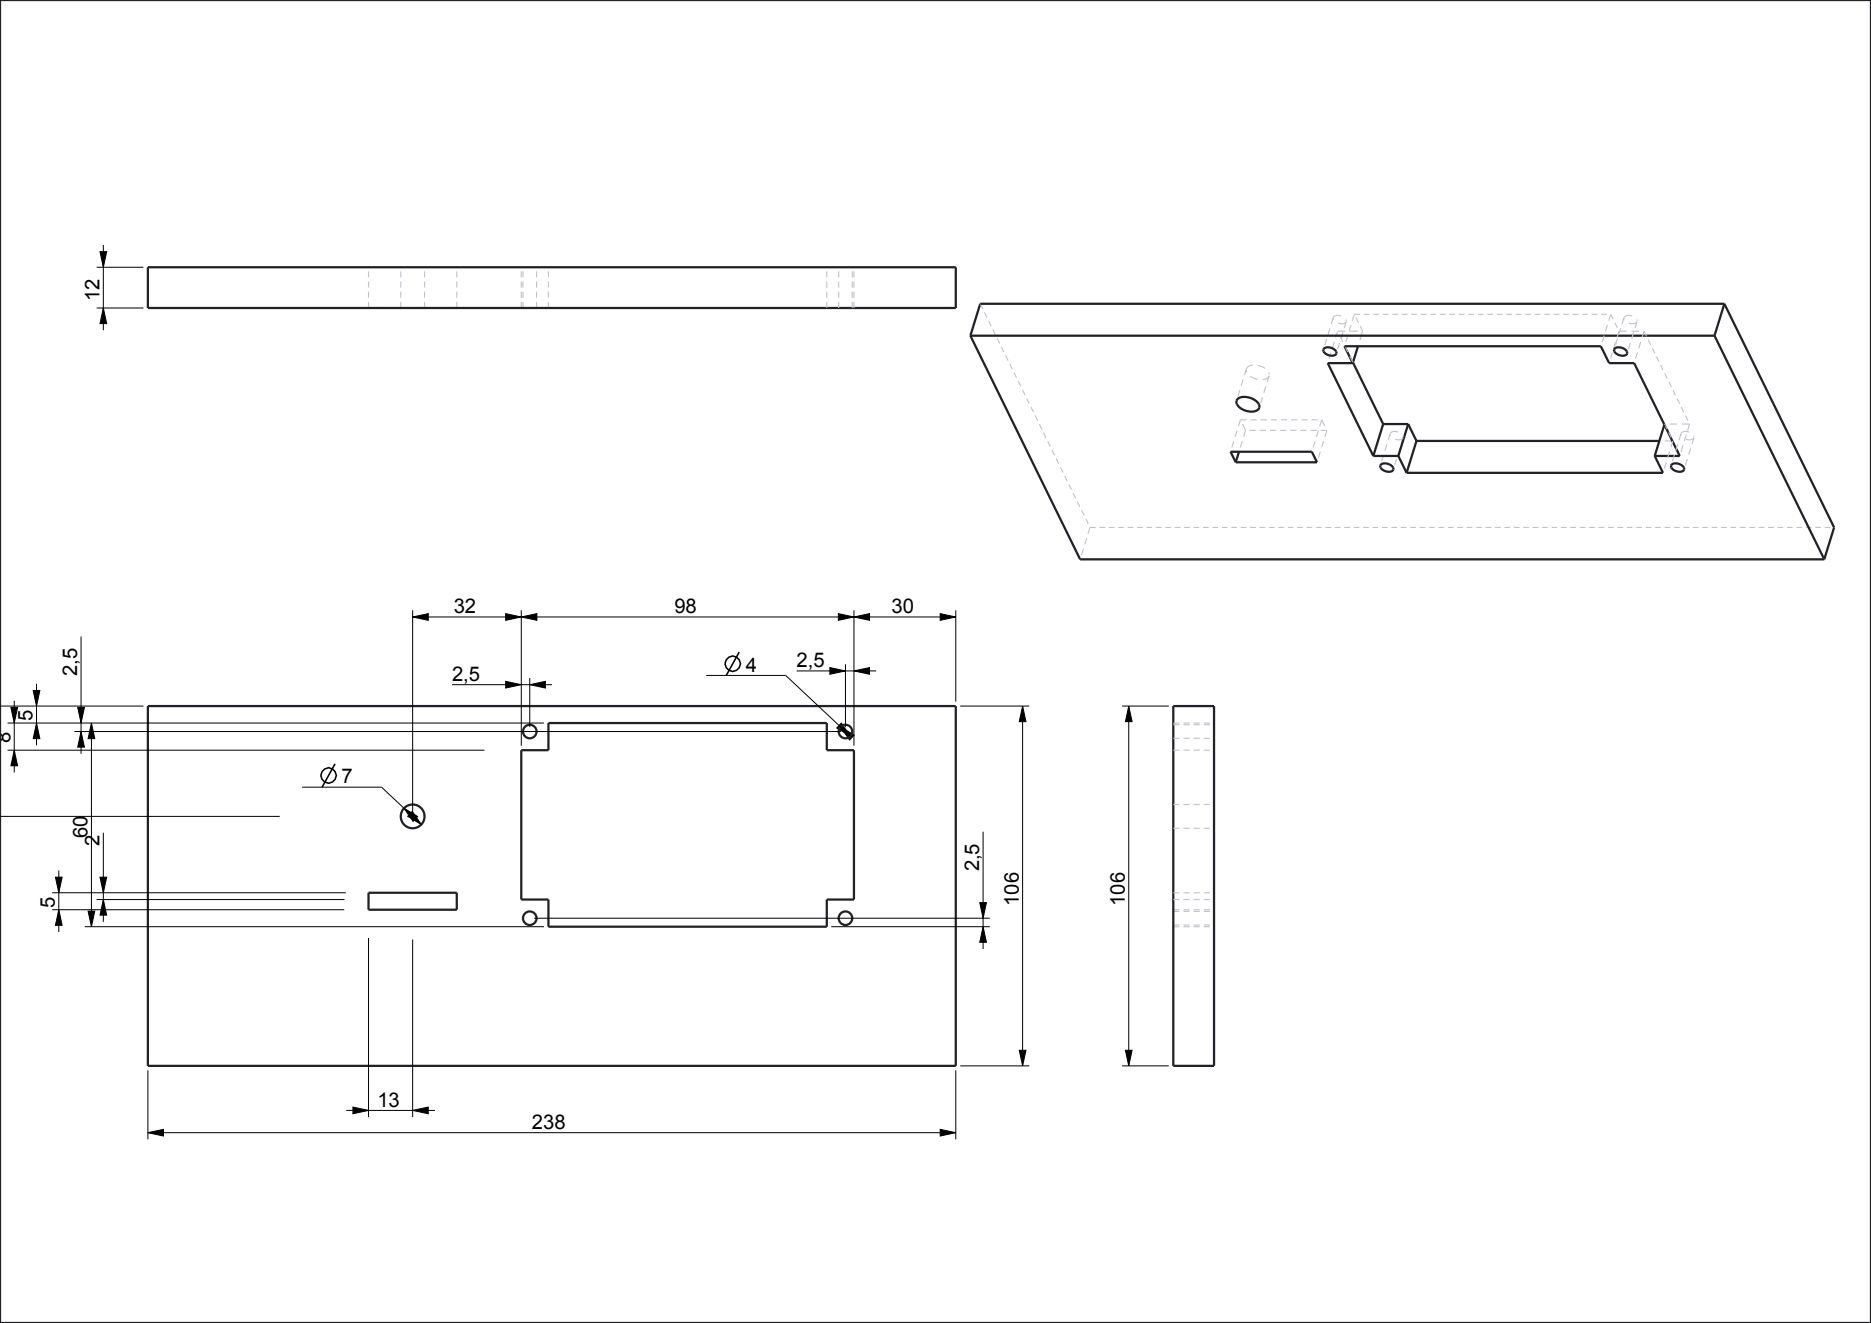
[picture p122: page 1]
