JamesGlanville/solderingmachine/parts/creo/spindle_idler.pdf

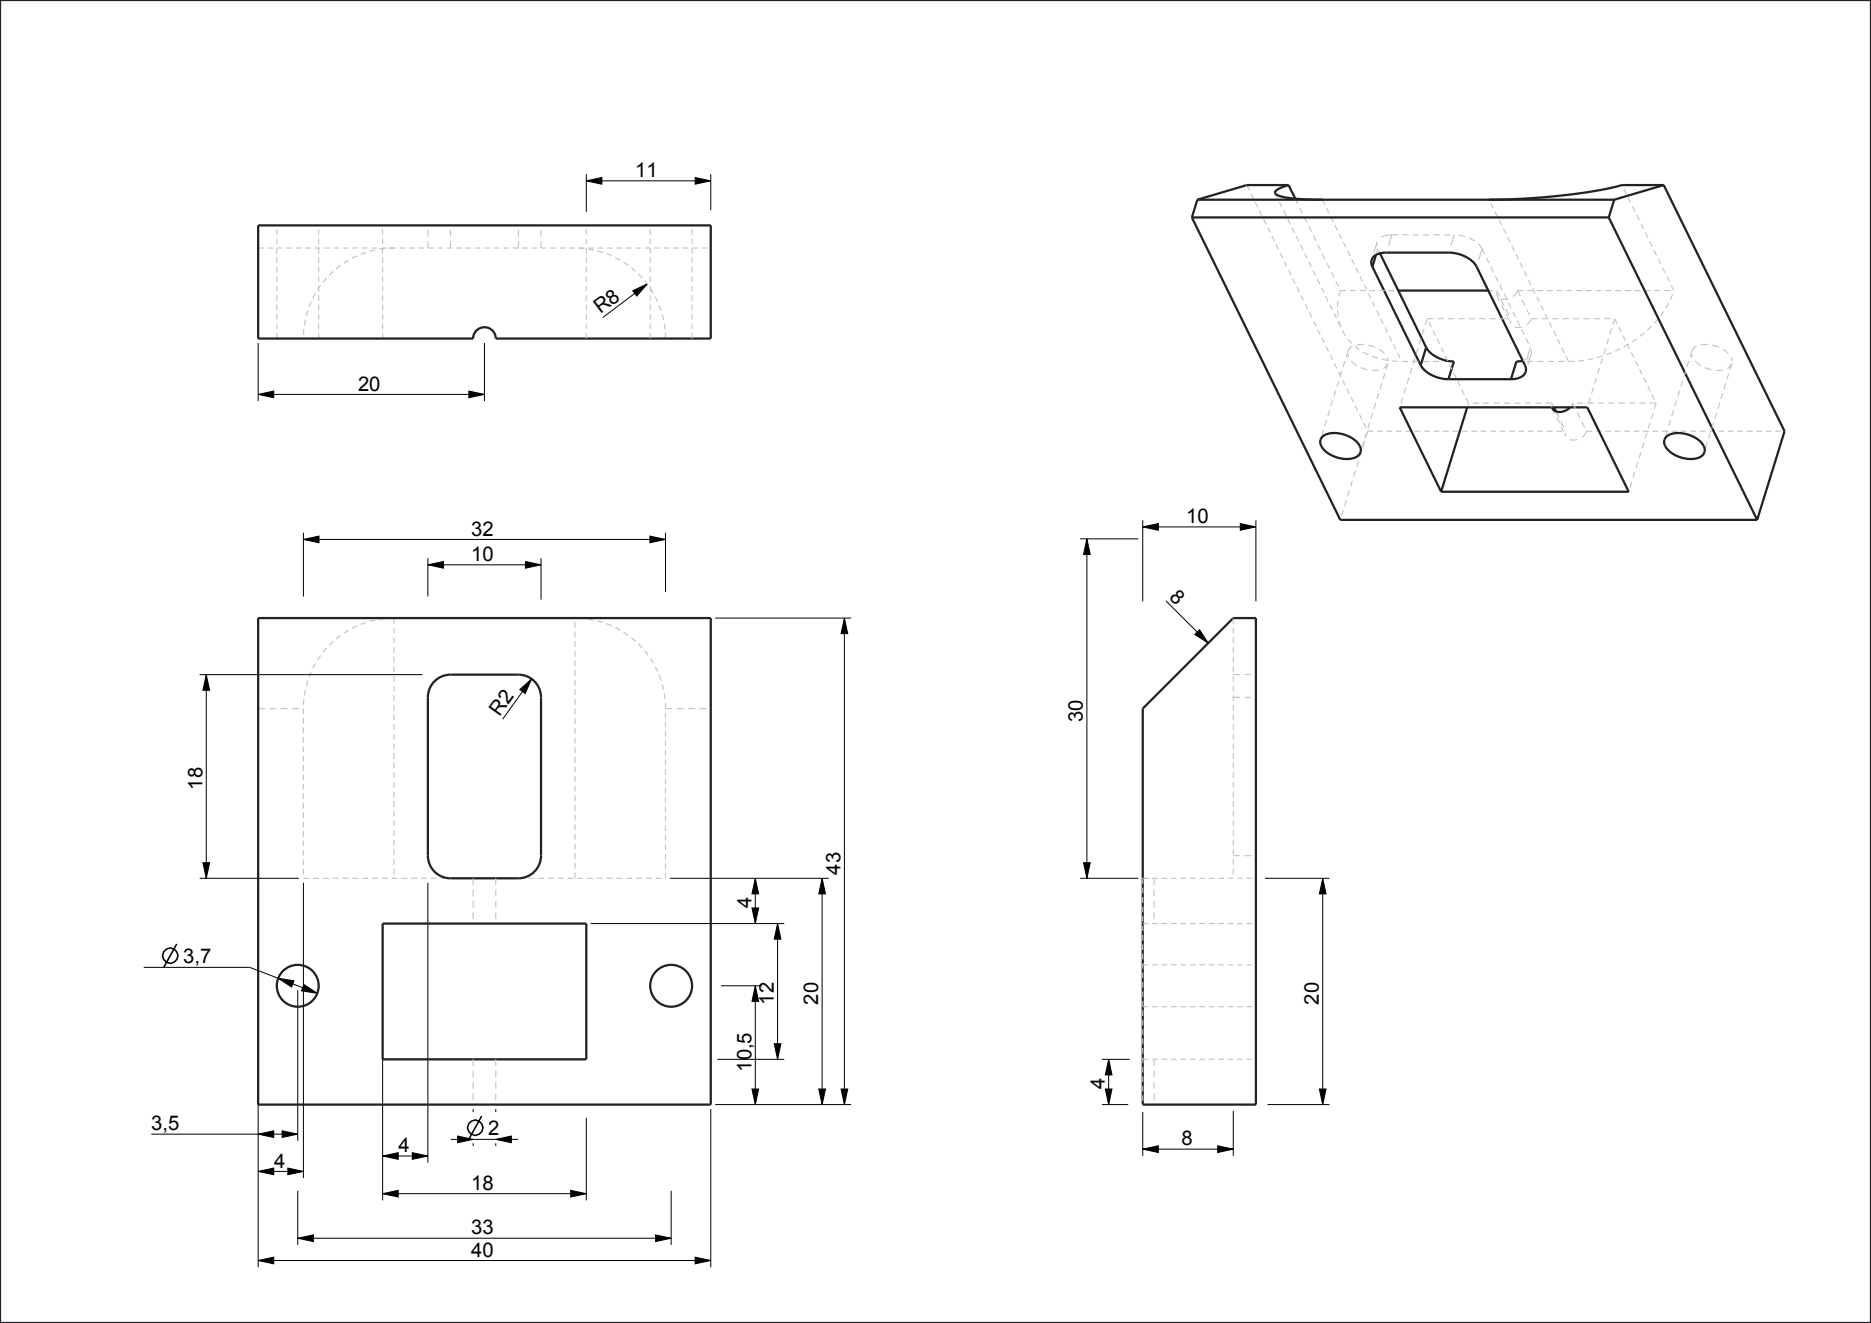
[picture p123: page 1]
