JamesGlanville/solderingmachine/parts/creo/topboard.pdf

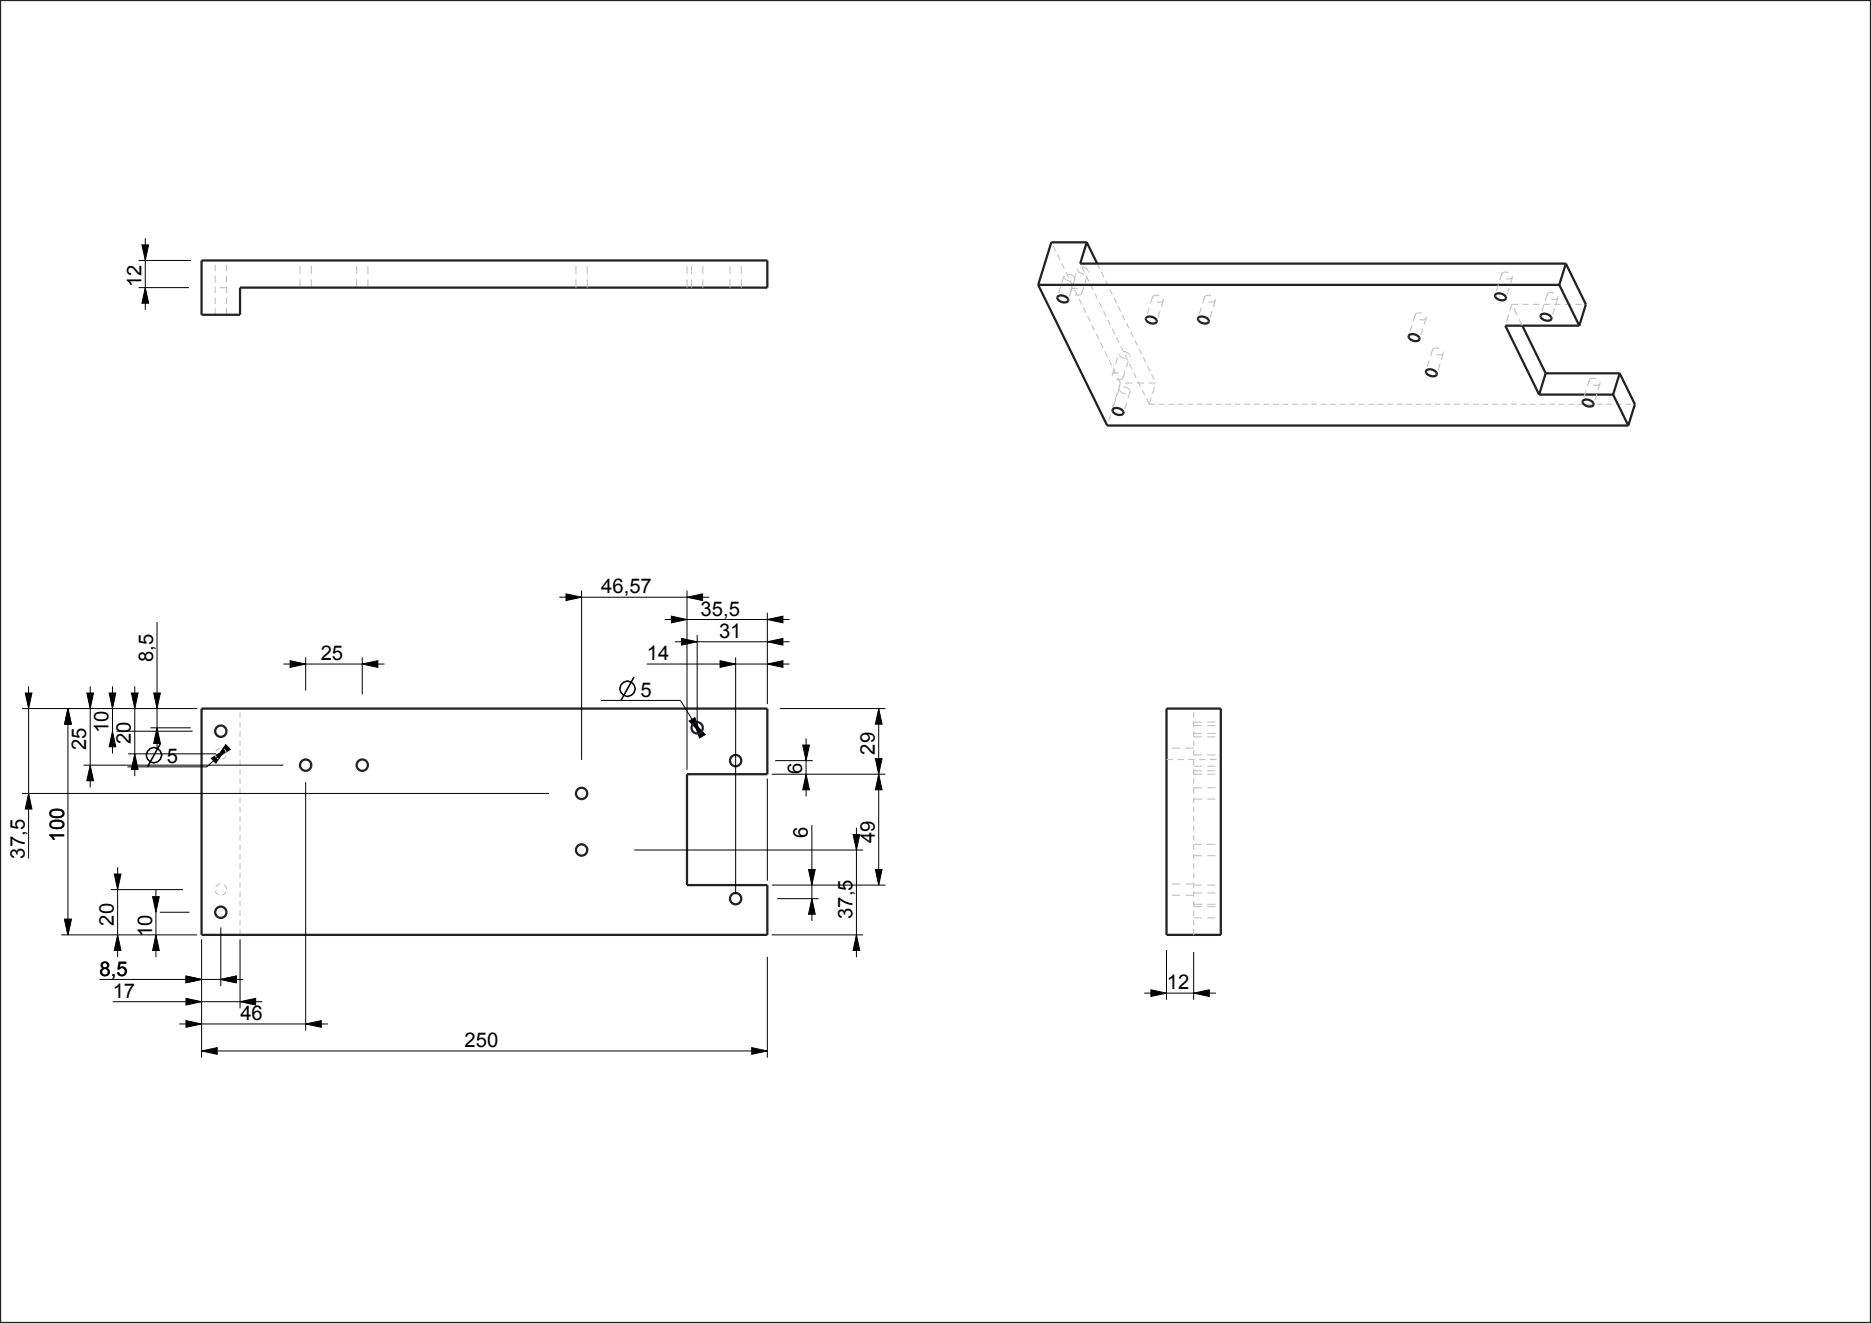
[picture p124: page 1]
