JamesGlanville/solderingmachine/parts/creo/xt60-panelmount.pdf

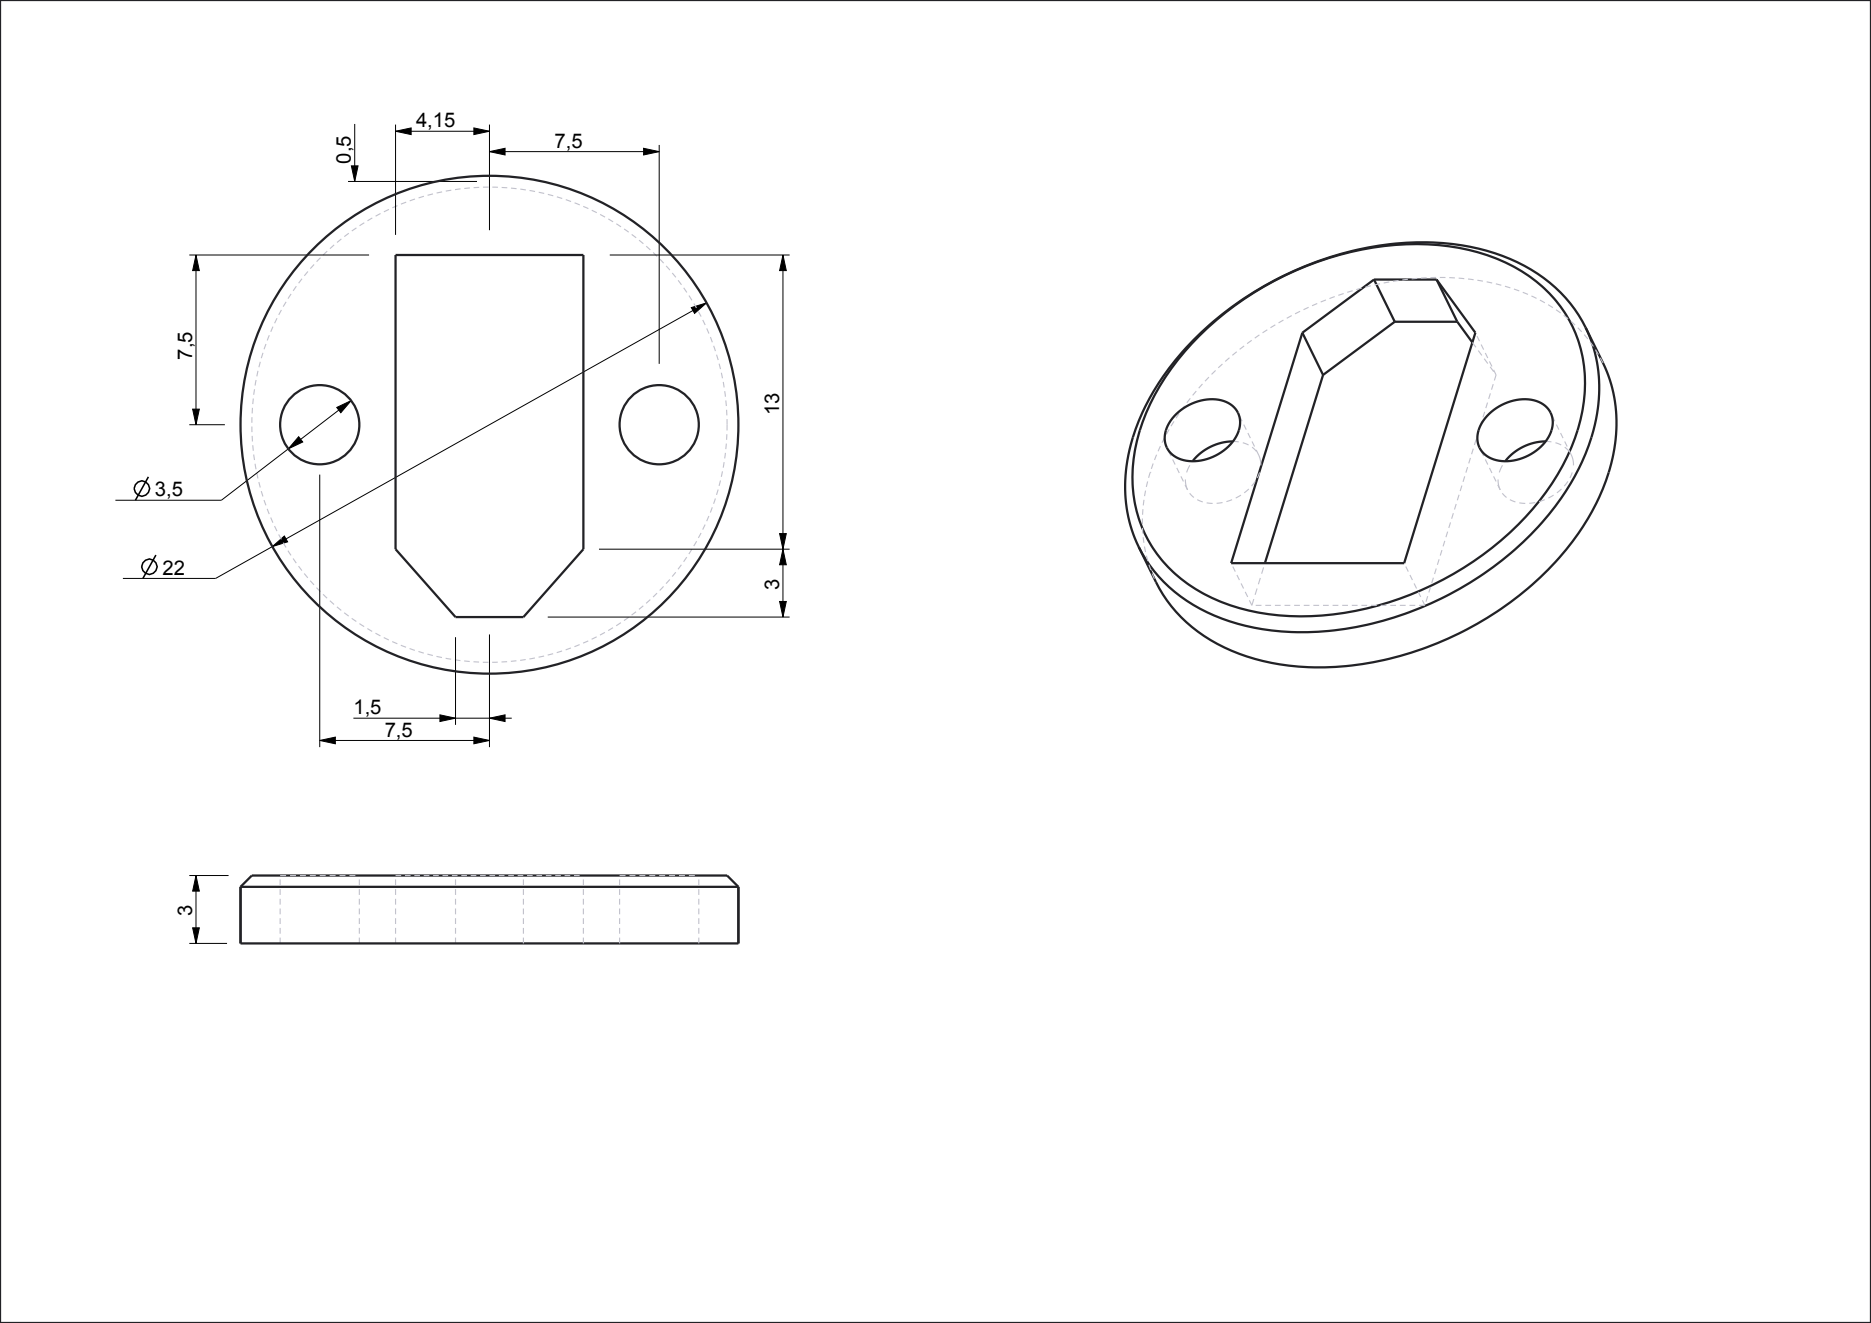
[picture p125: page 1]
