JamesGlanville/solderingmachine/parts/creo/zpanel.pdf

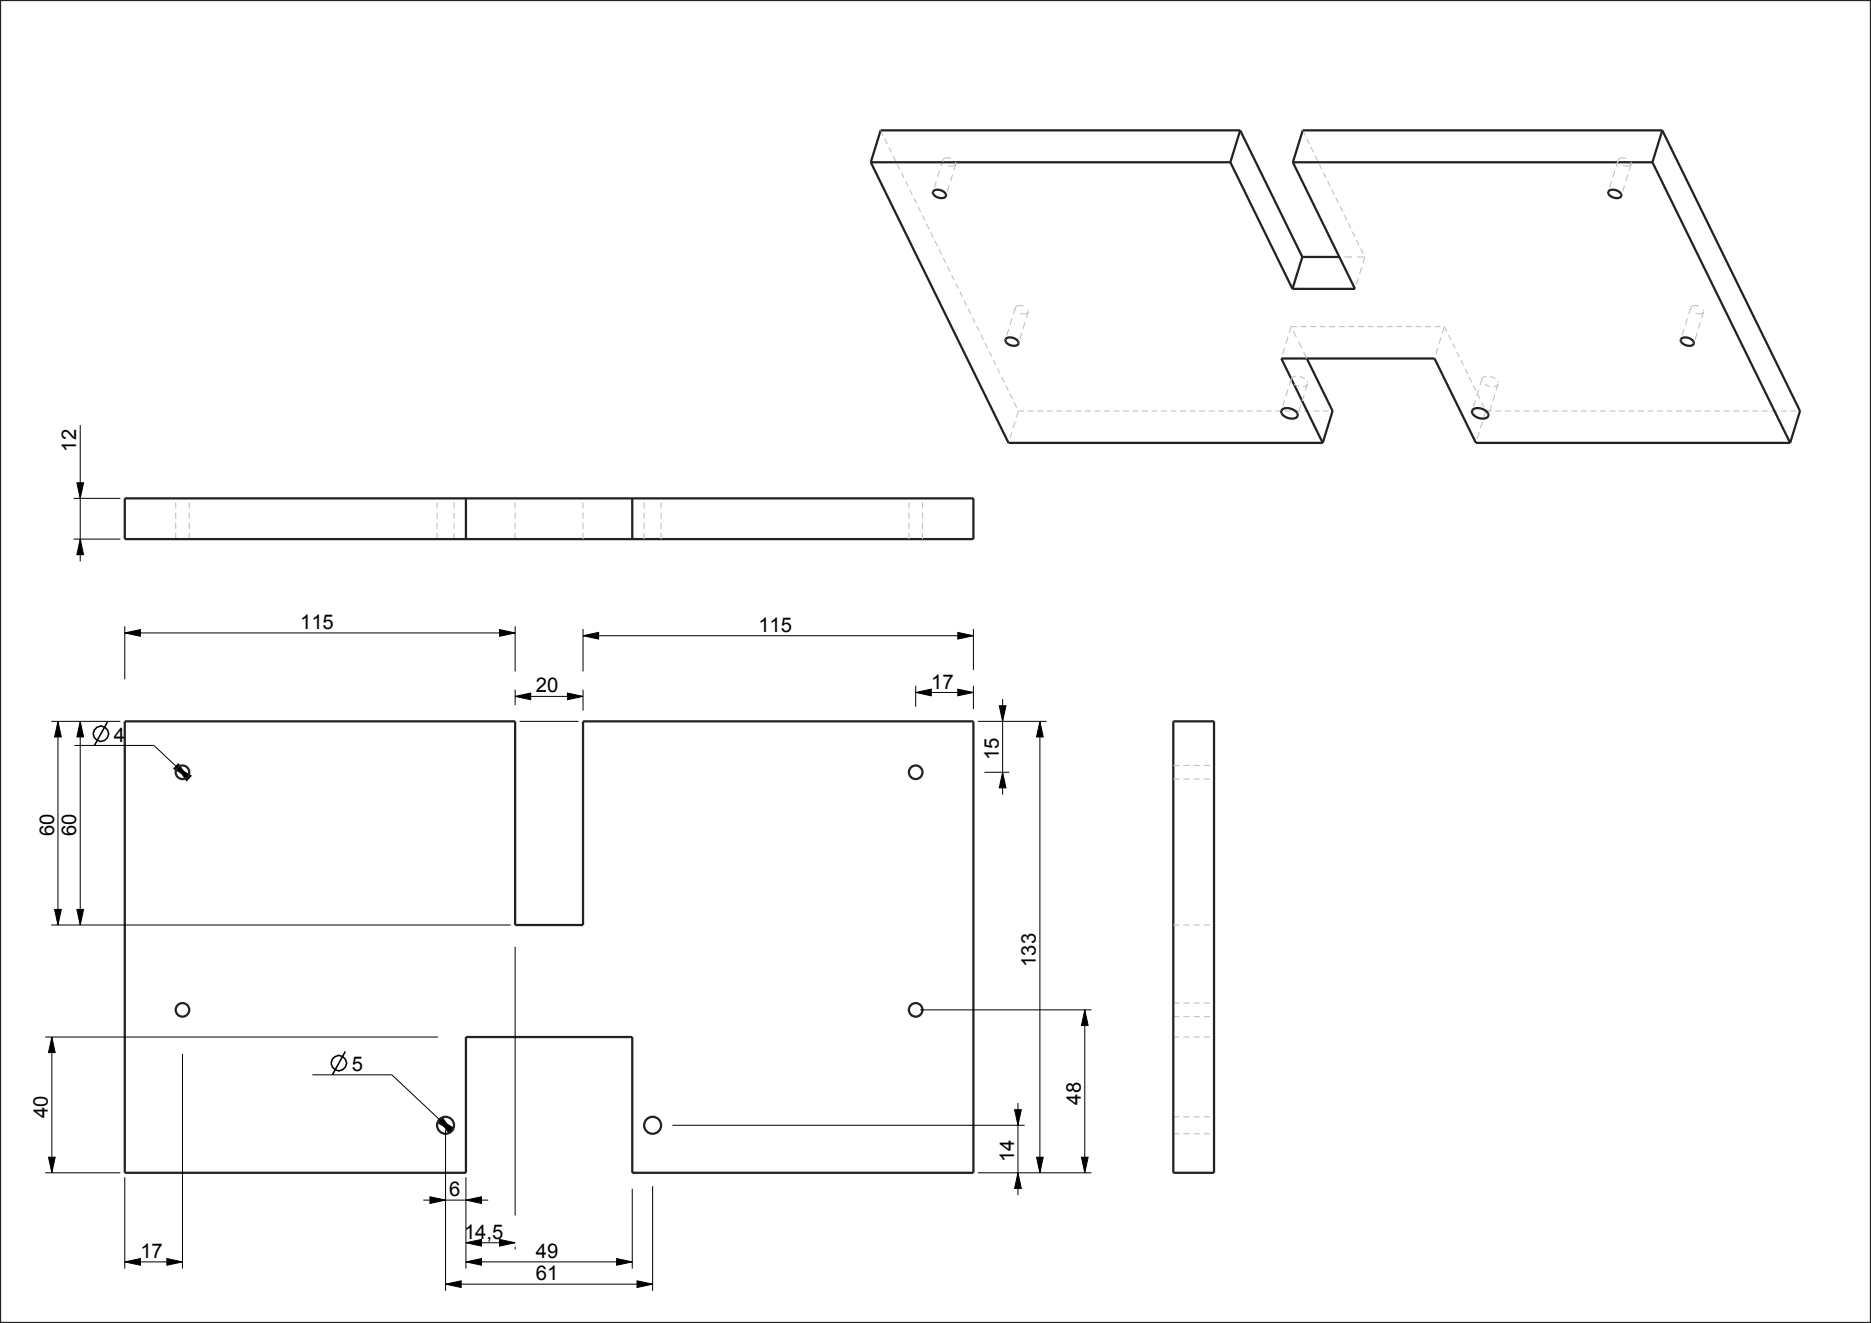
[picture p126: page 1]
