JamesGlanville/solderingmachine/parts/creo/zsupport.pdf

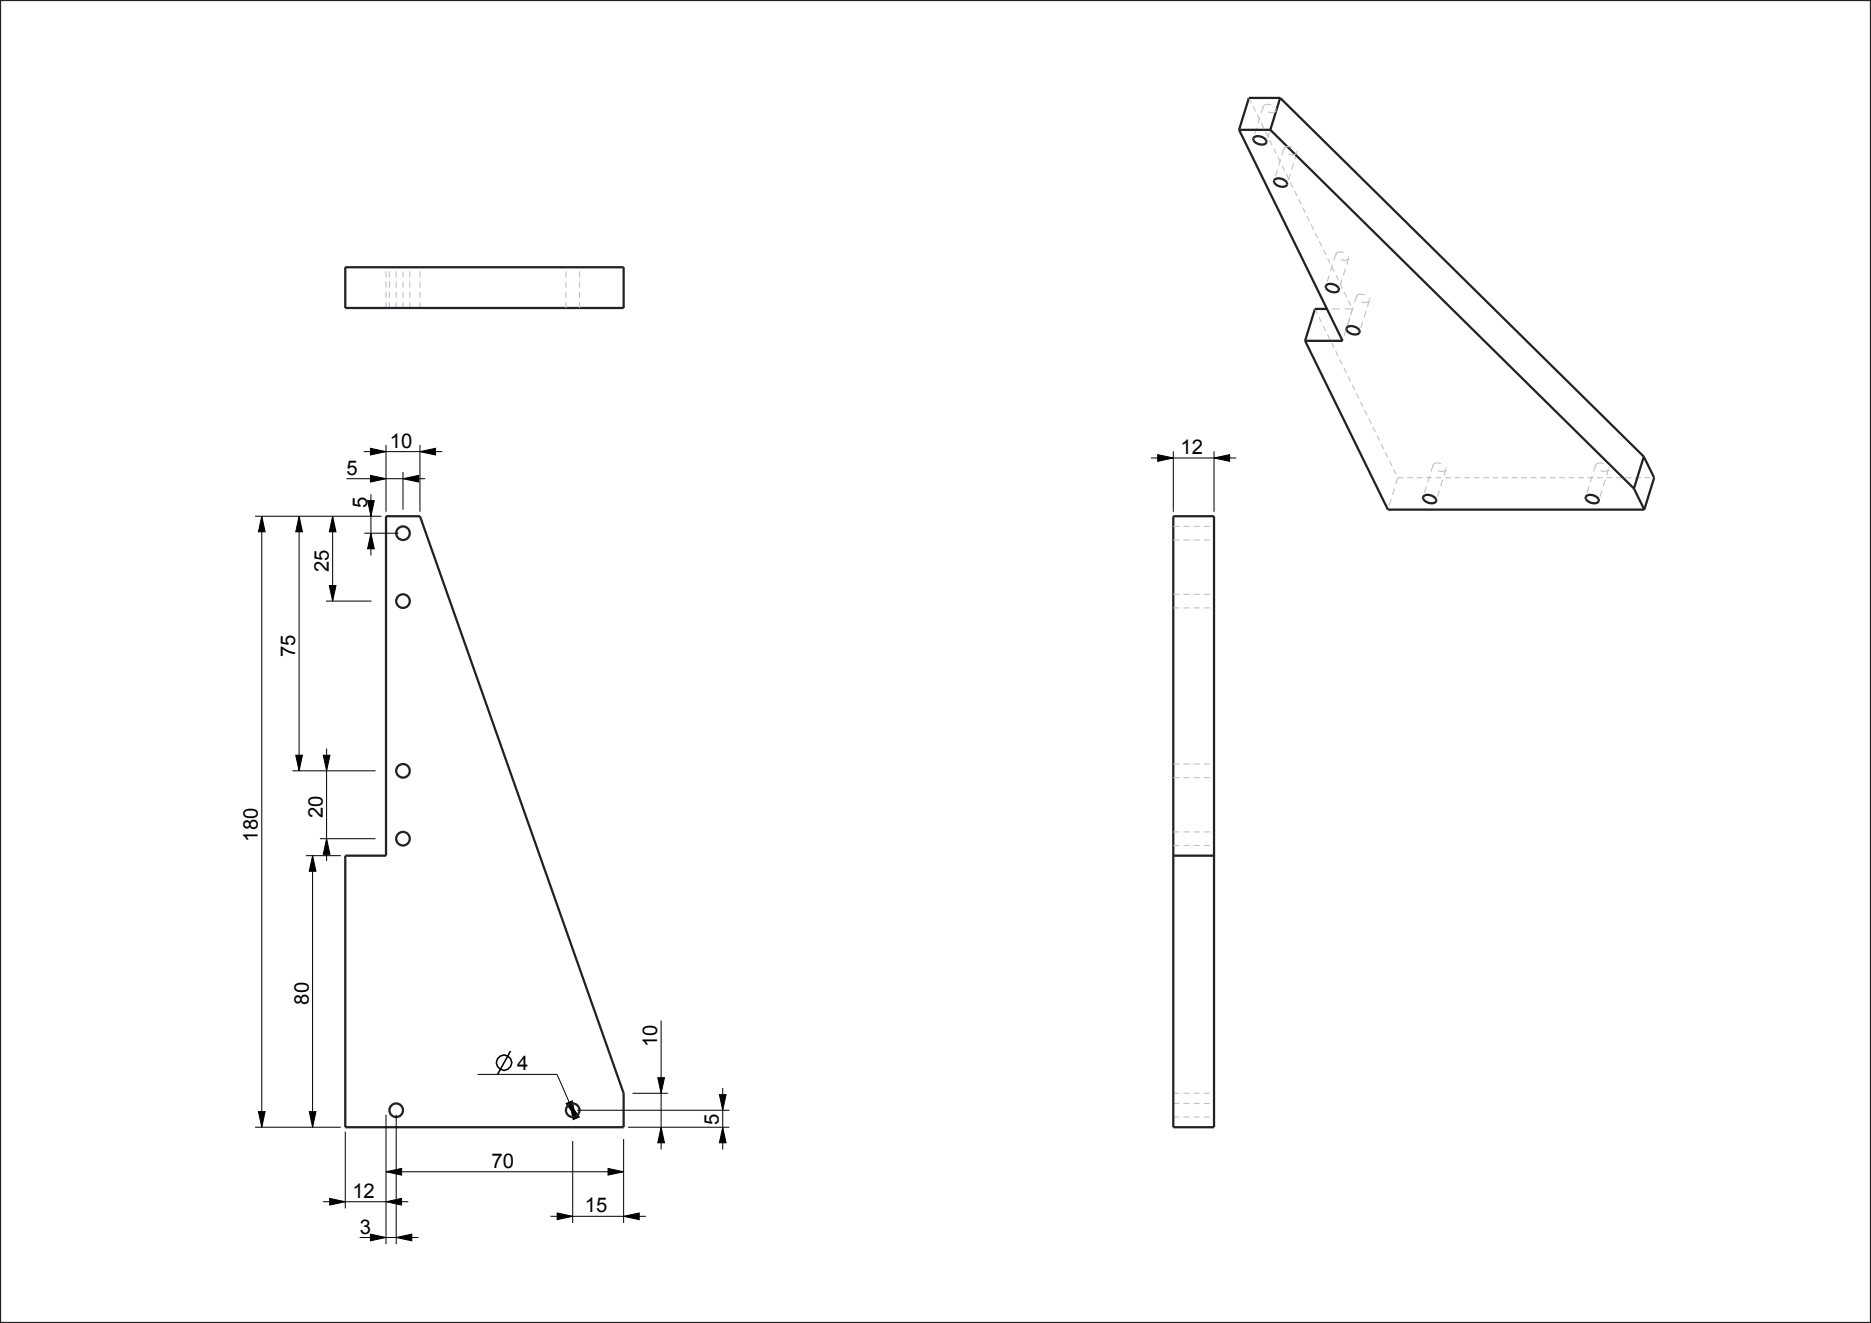
[picture p127: page 1]
