JamesGlanville/solderingmachine/parts/creo/lcdbezel.pdf

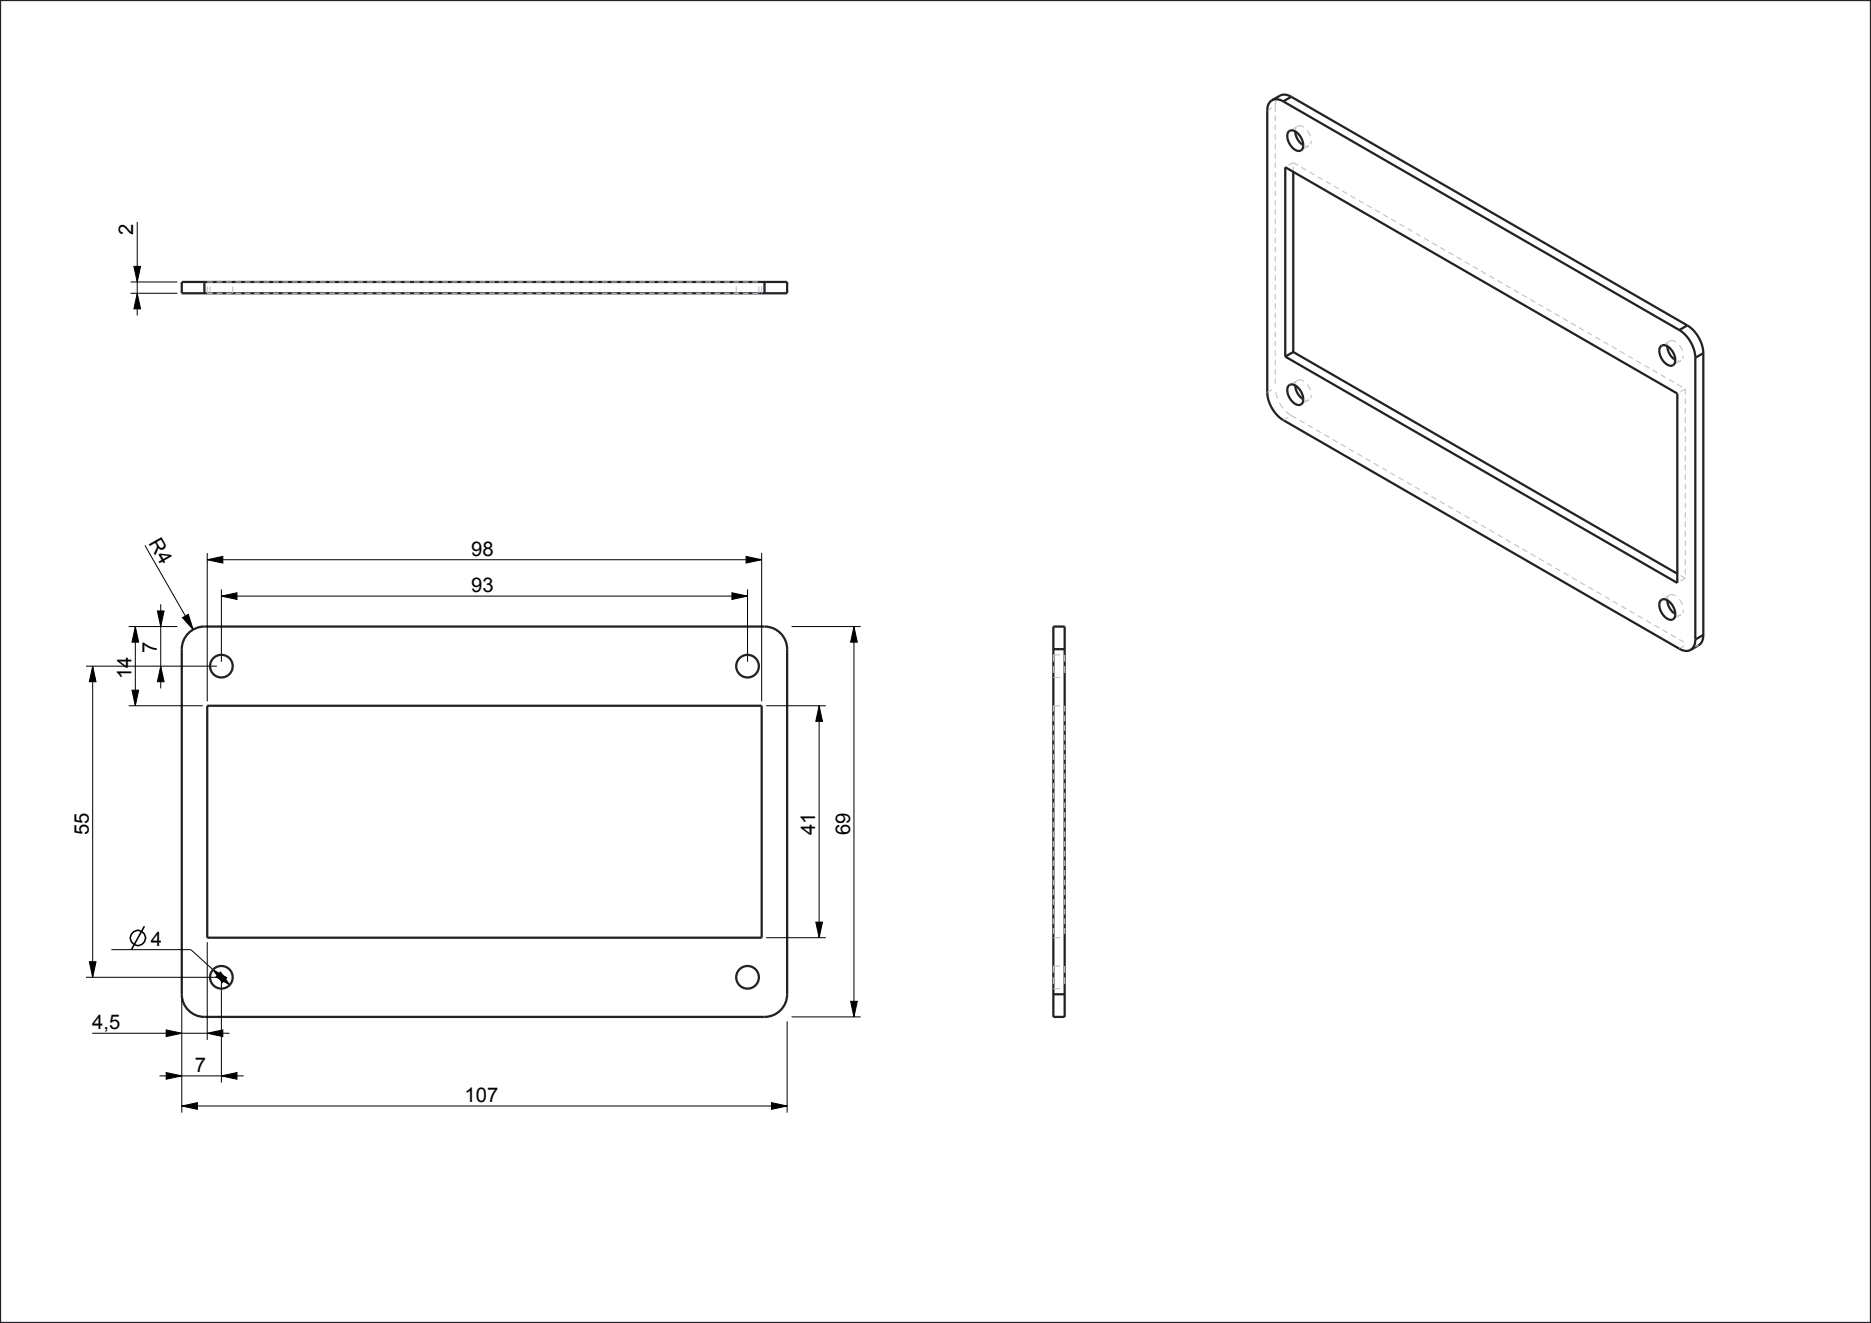
[picture p128: page 1]
