JamesGlanville/solderingmachine/parts/creo/rightangle.pdf

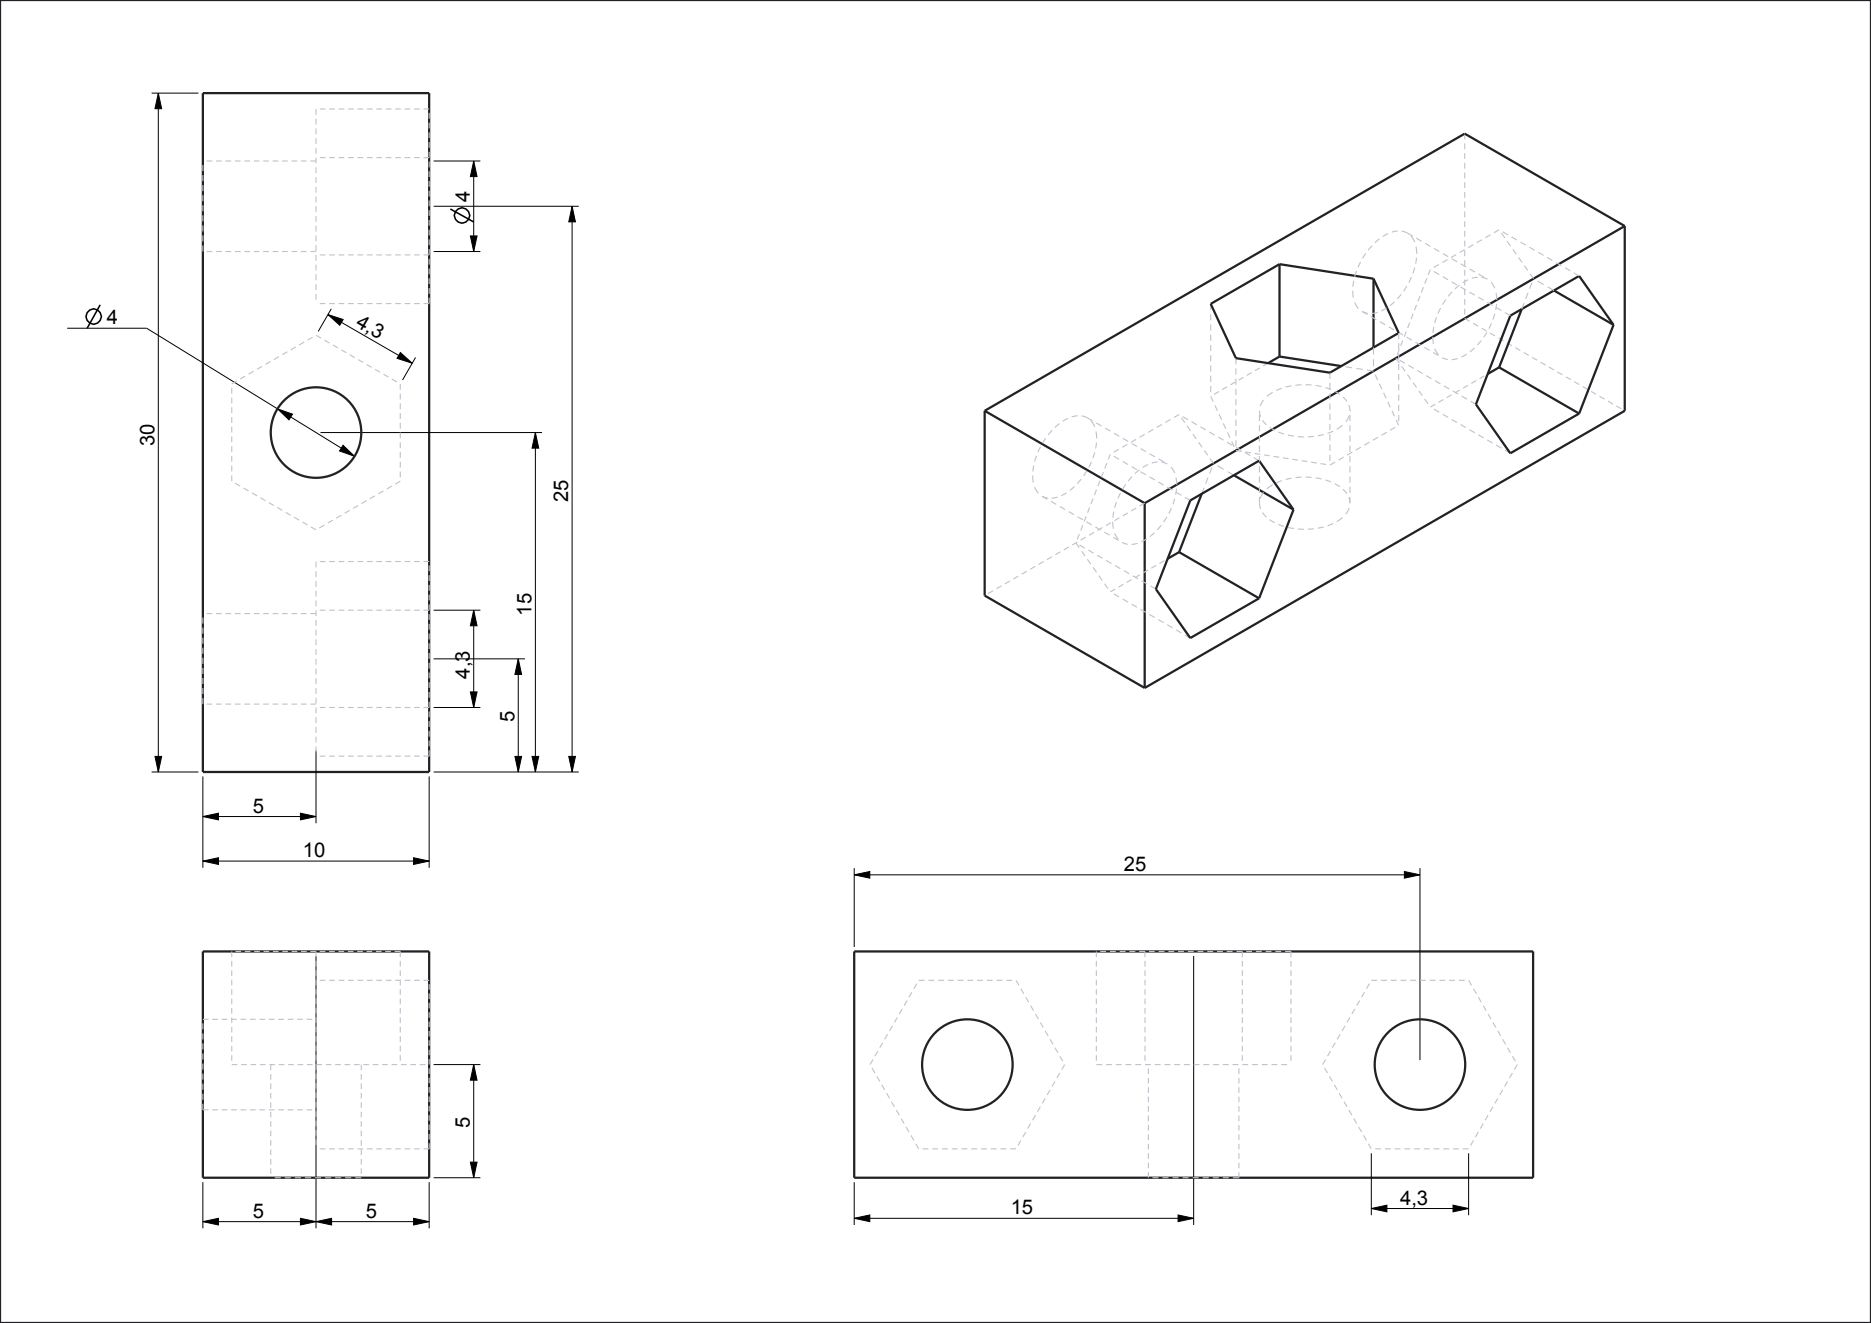
[picture p129: page 1]
