JamesGlanville/solderingmachine/parts/creo/toolholder.pdf

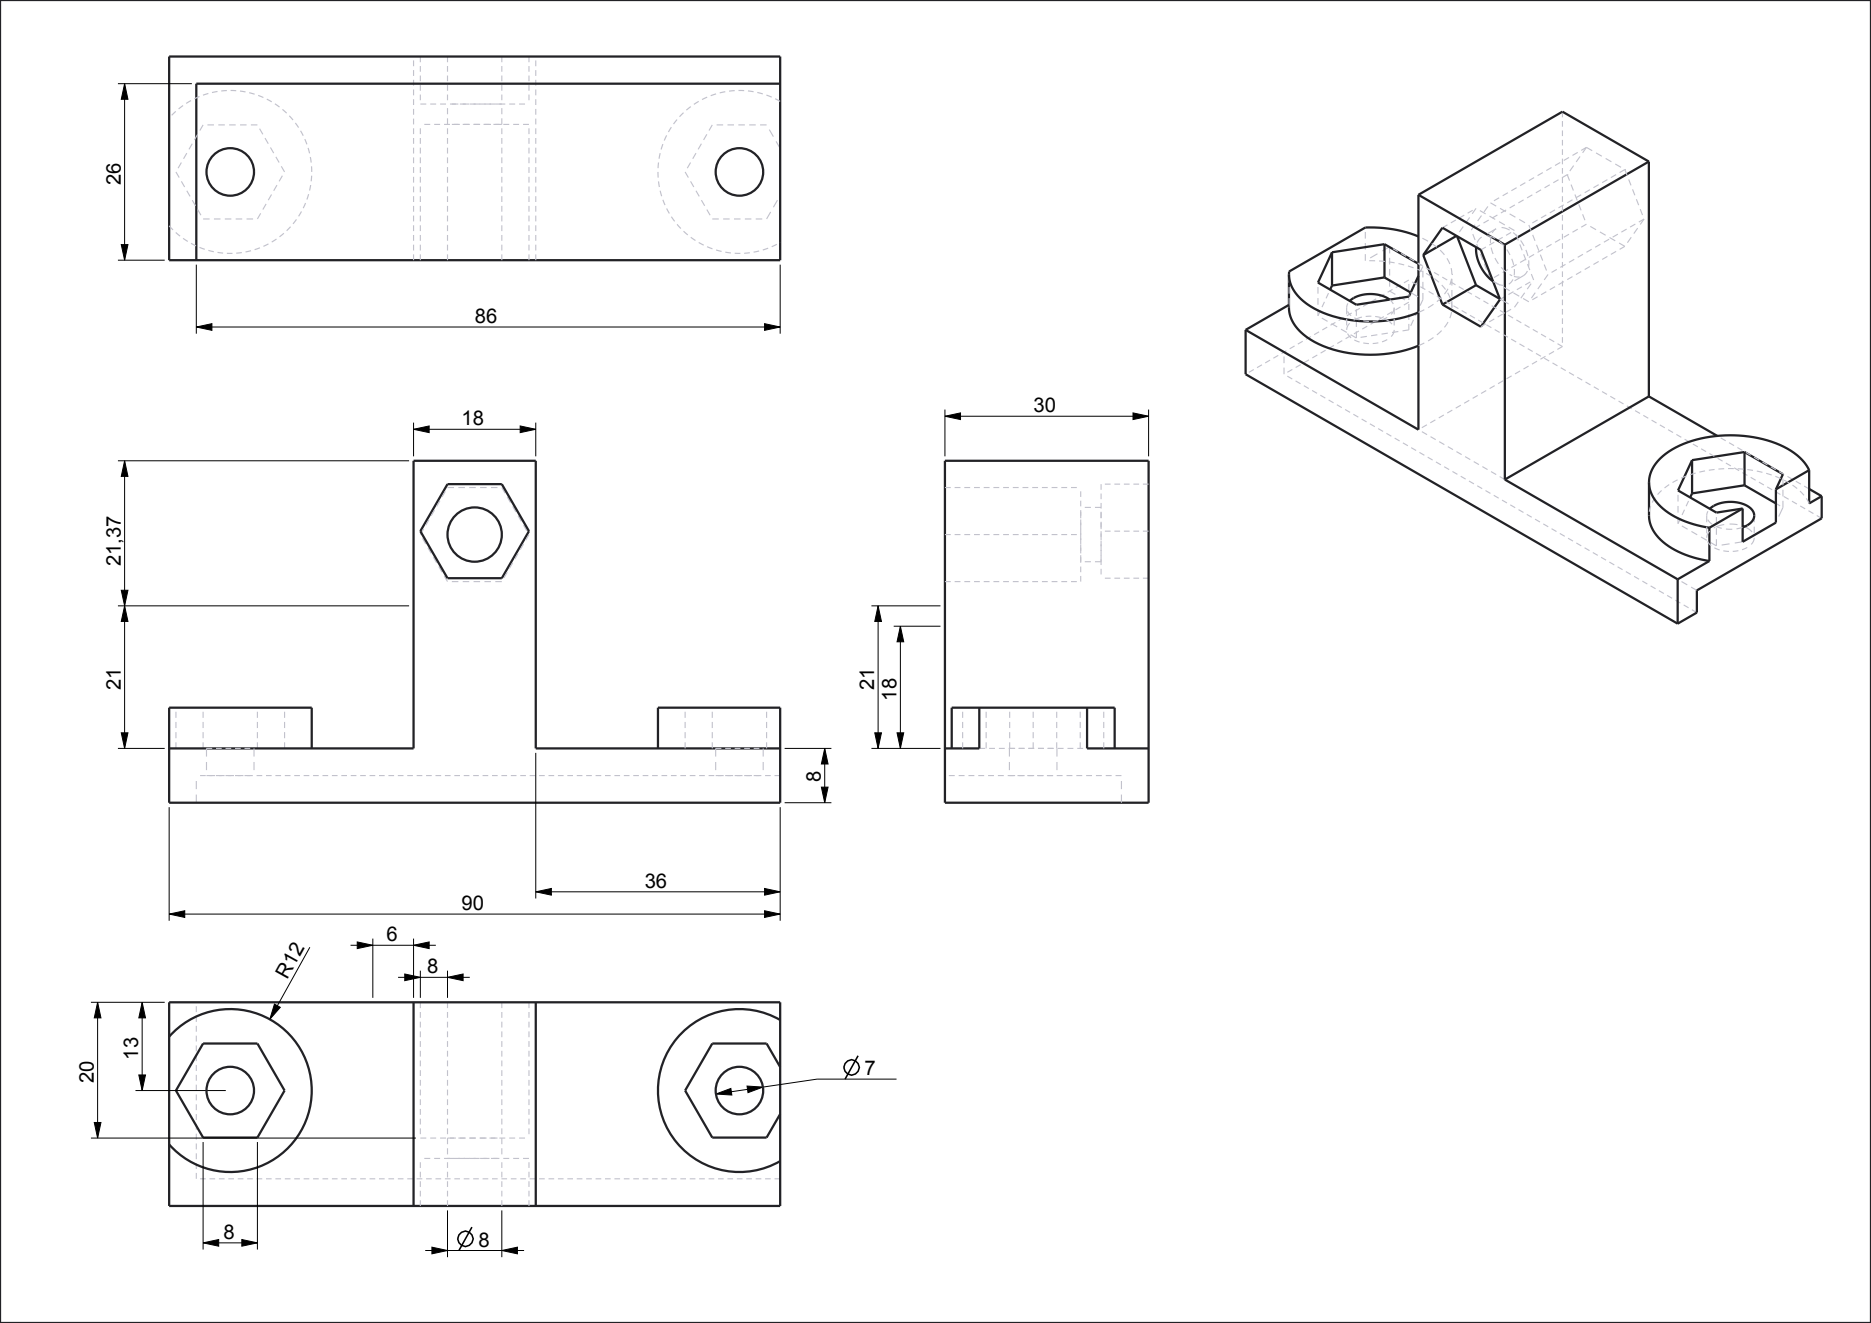
[picture p130: page 1]
