JamesGlanville/solderingmachine/parts/creo/motorholder.pdf

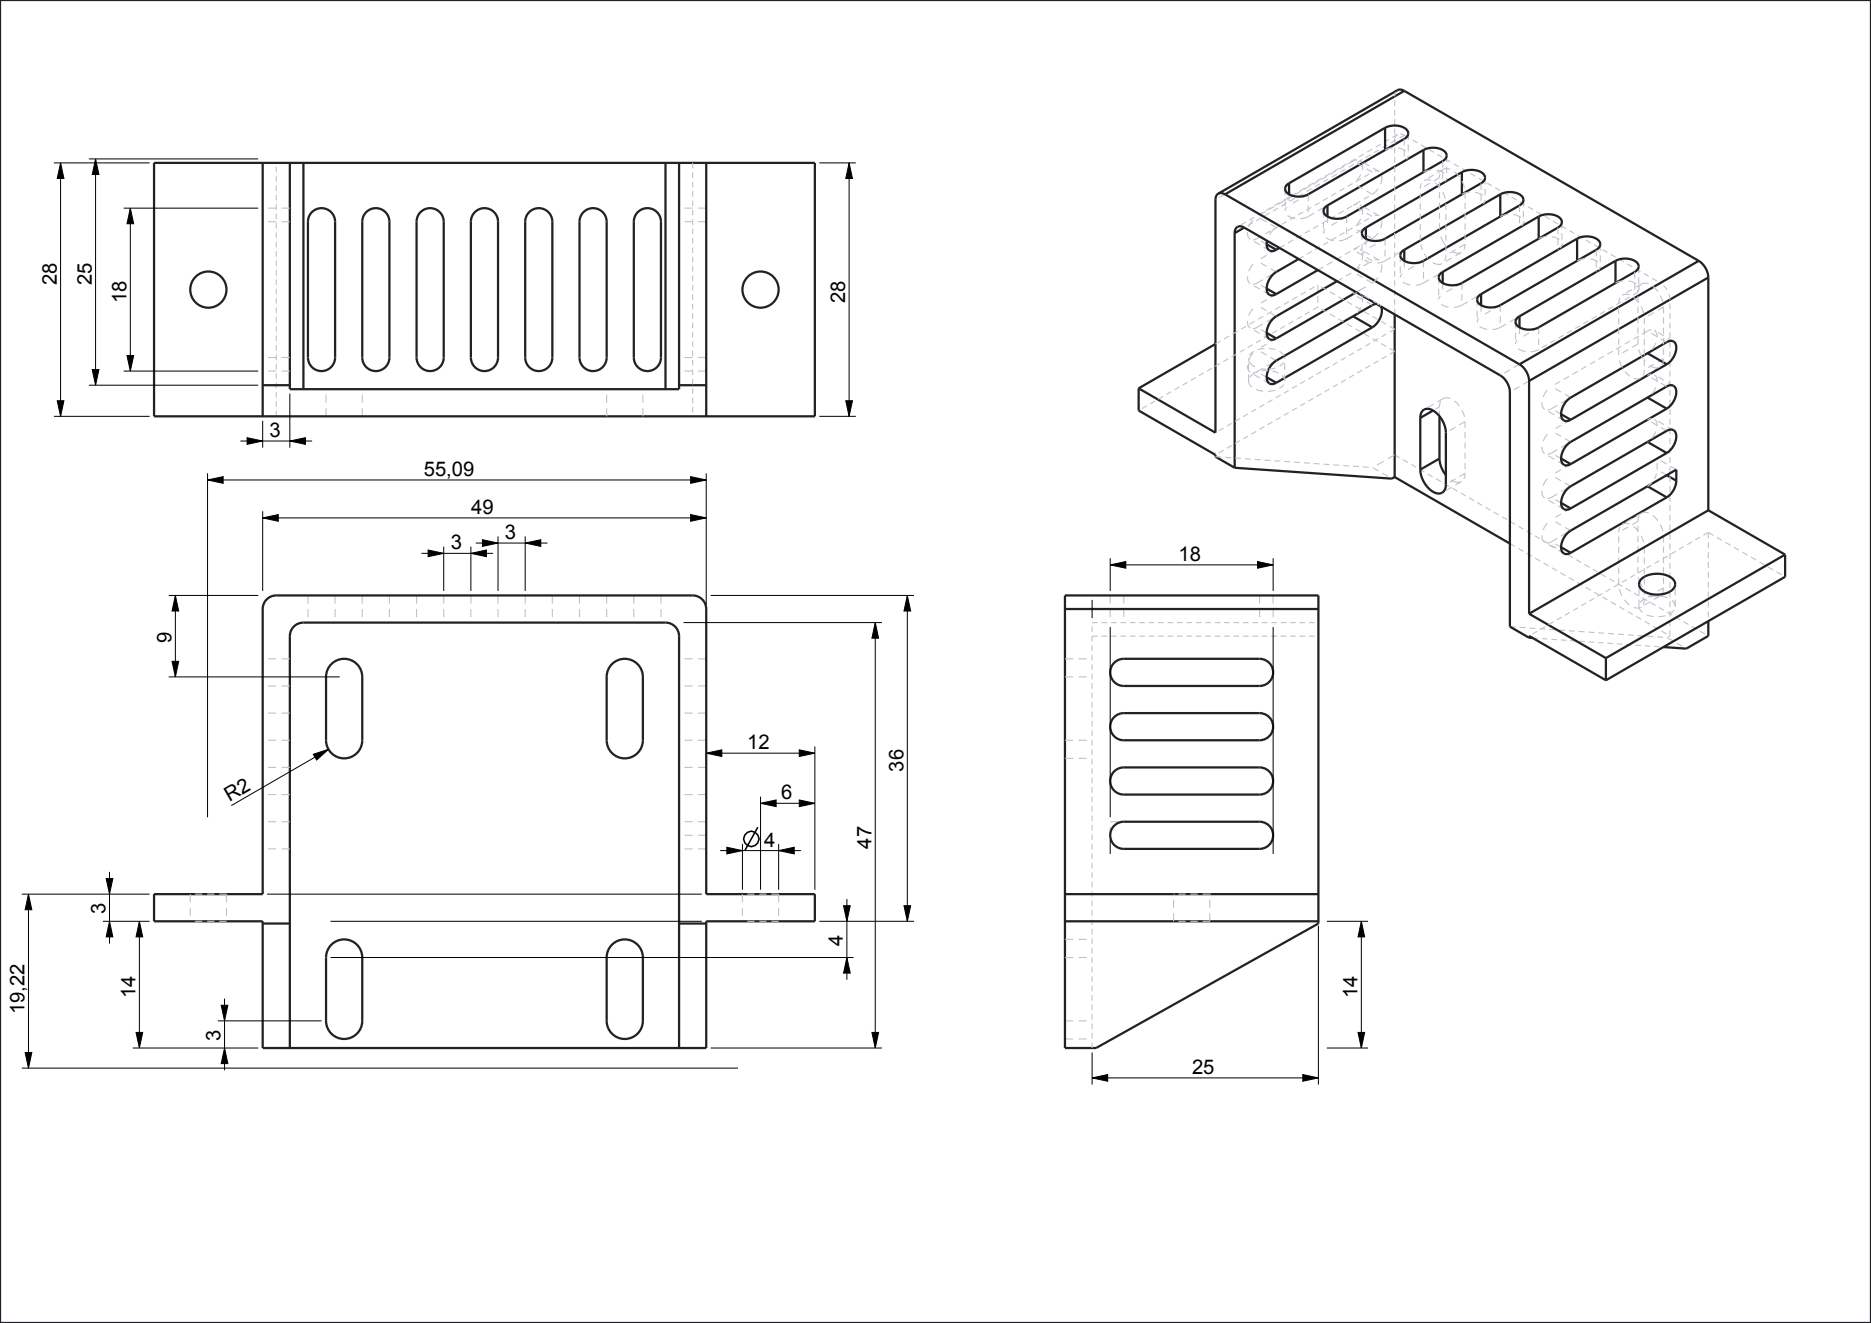
[picture p131: page 1]
