JamesGlanville/solderingmachine/parts/creo/spindle.pdf

y x

z

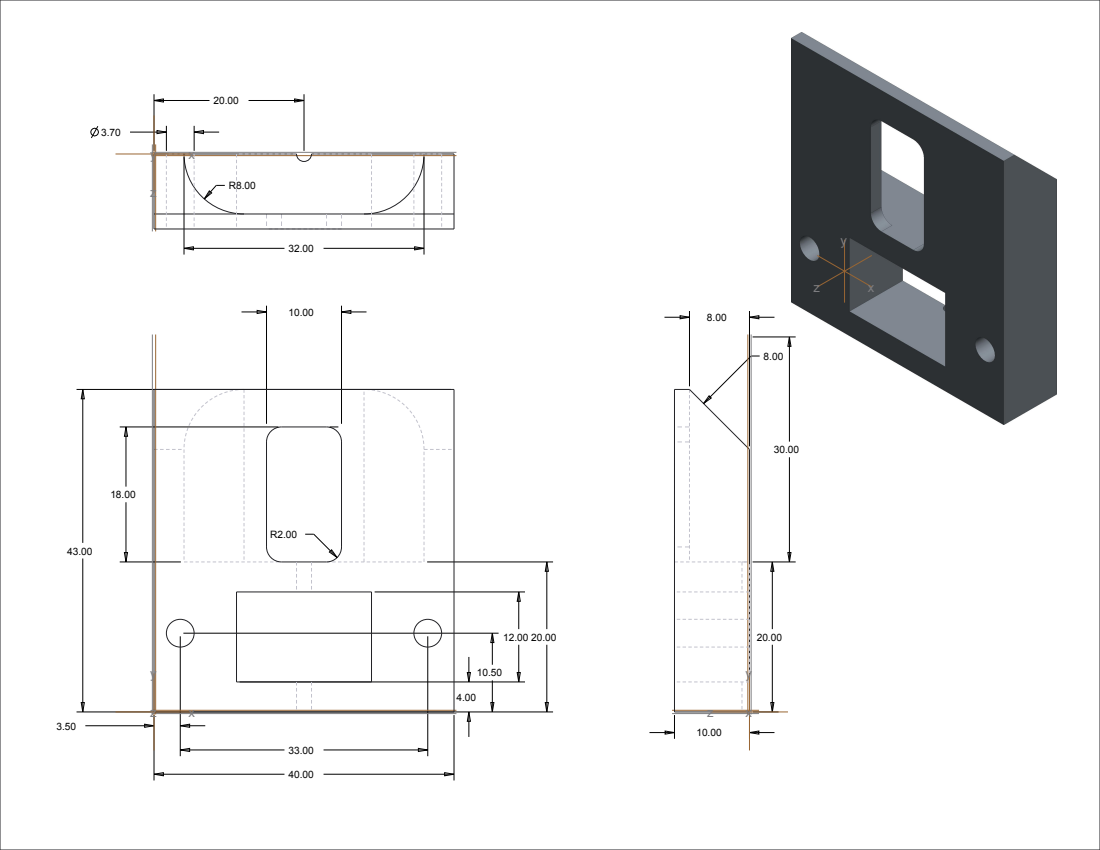
[picture p132: page 1]

y x

z

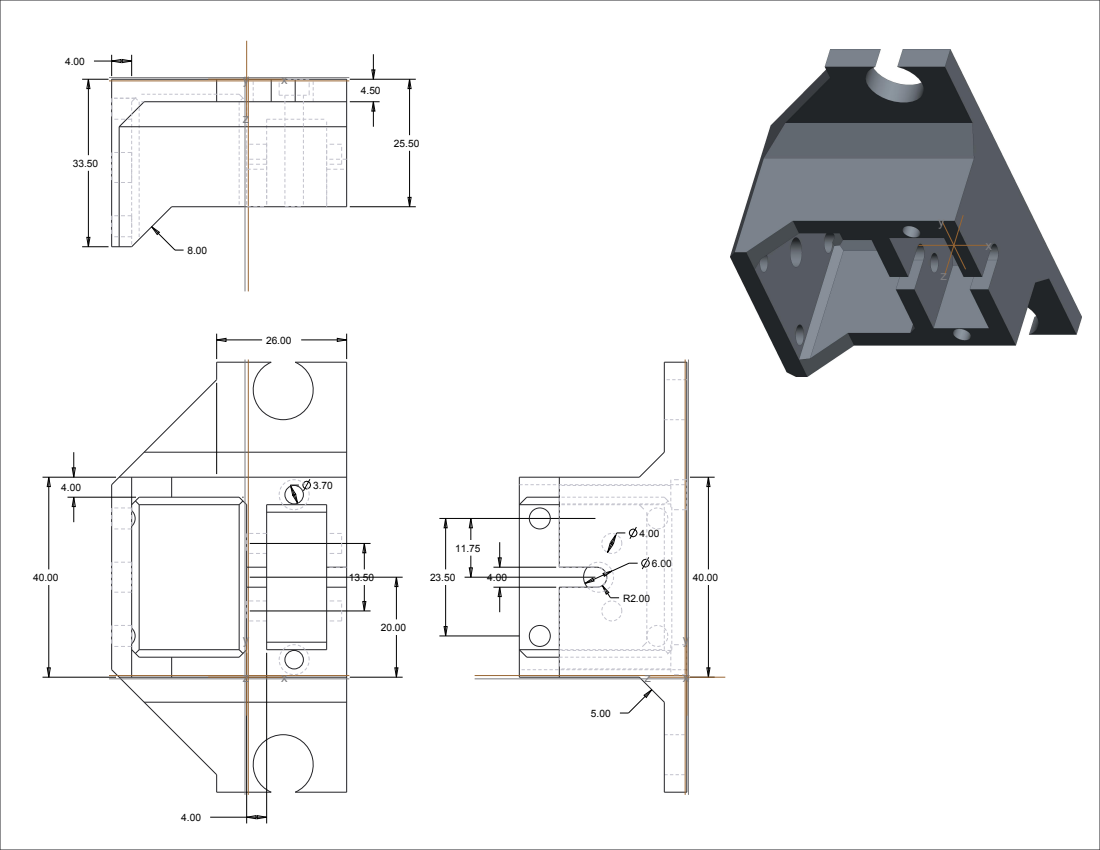
[picture p133: page 2]
