JamesGlanville/solderingmachine/parts/creo/partstocut.pdf

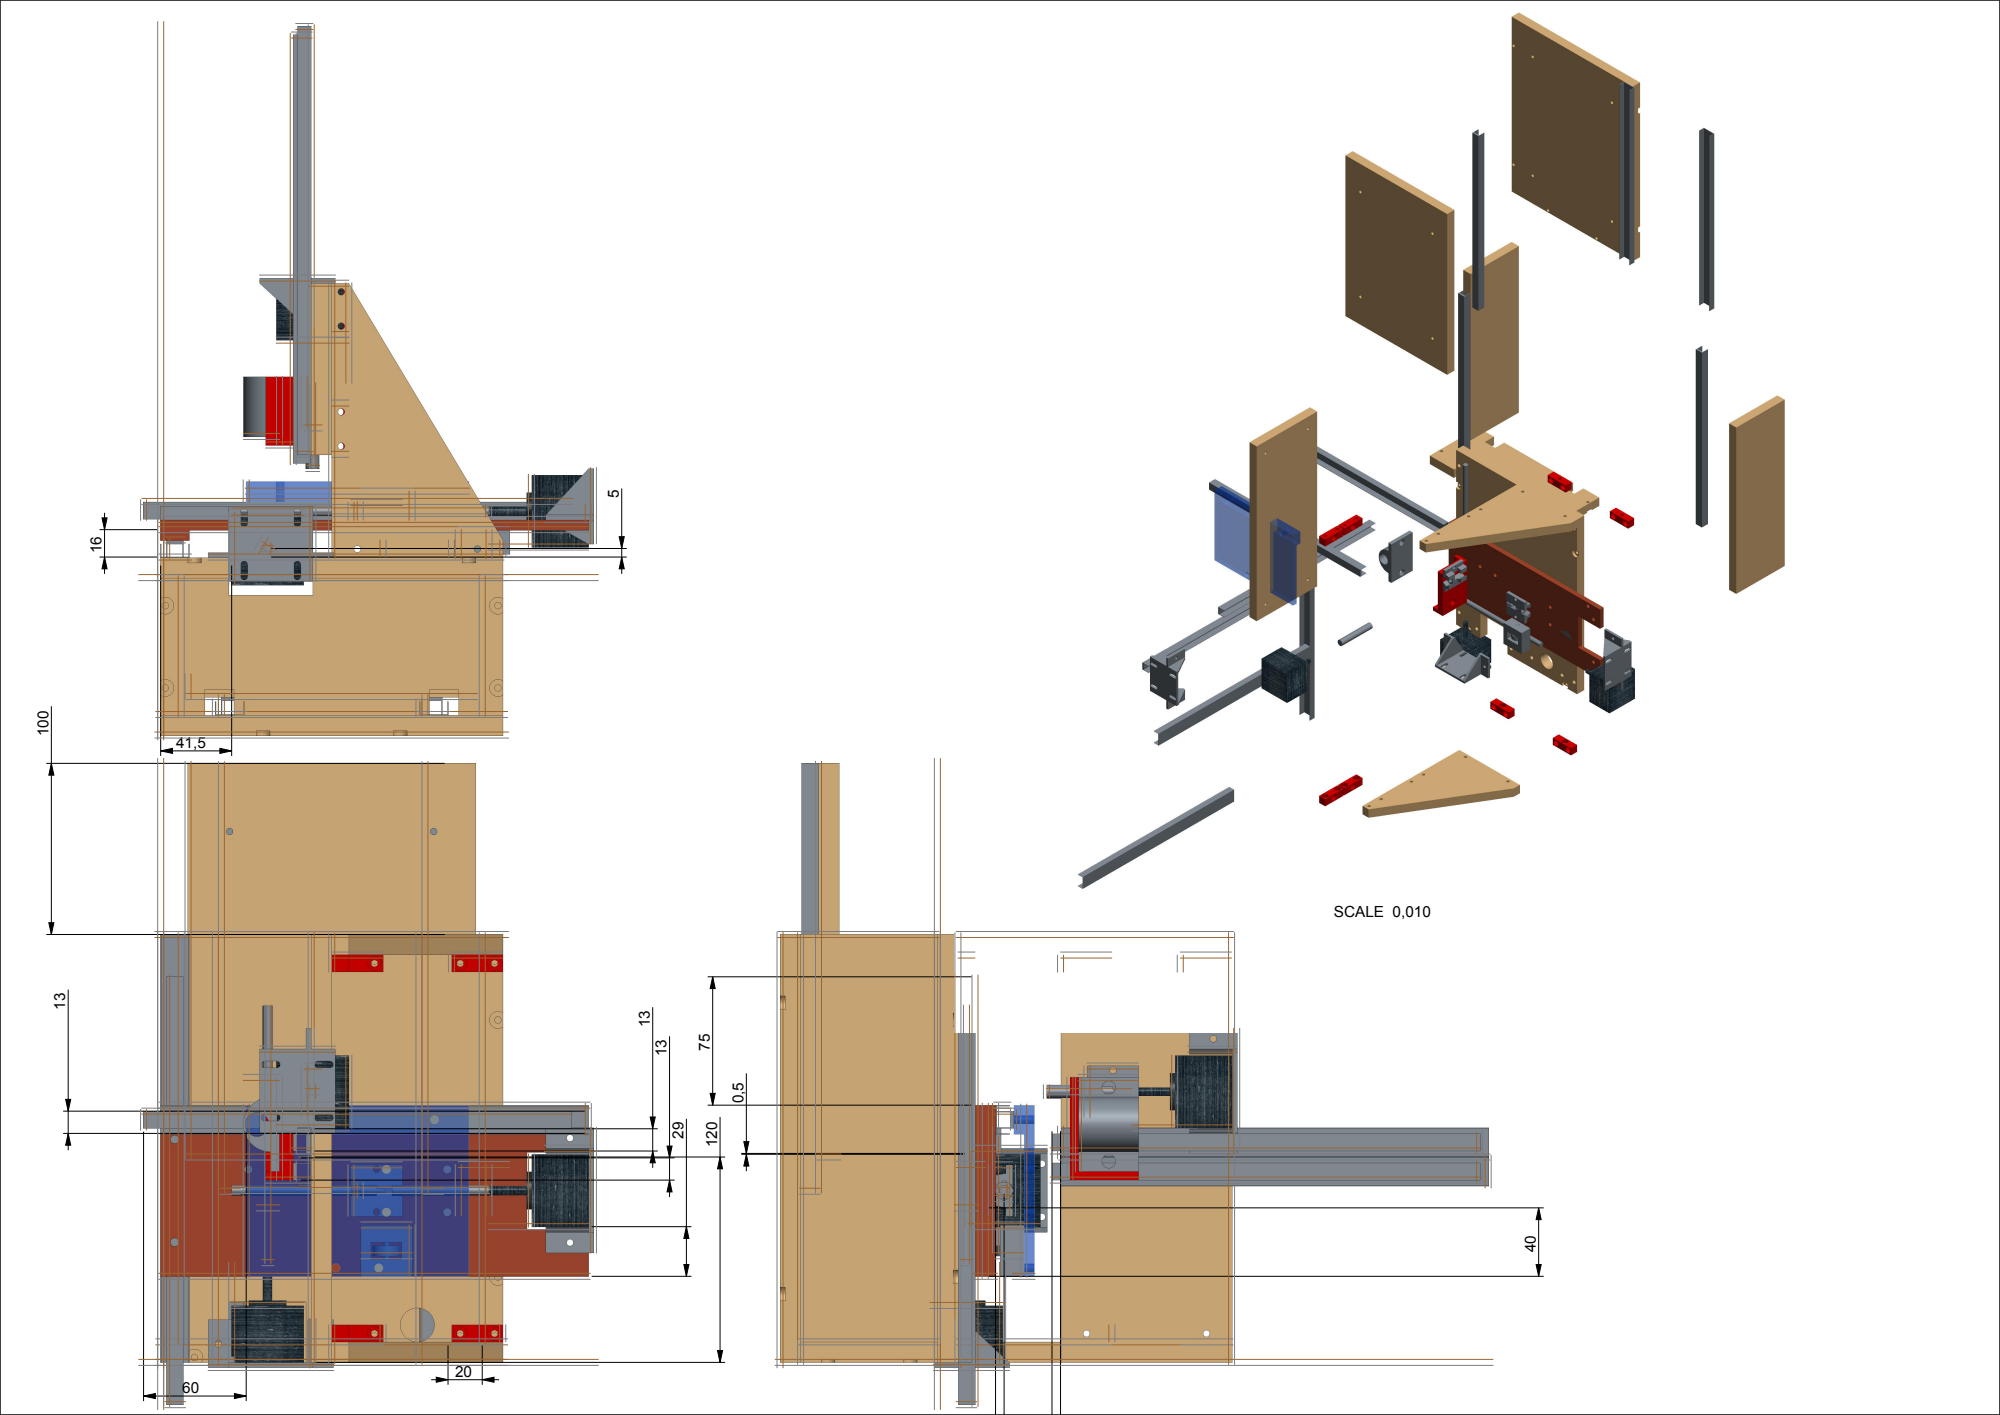
[picture p134: page 1]
SCALE 0,010

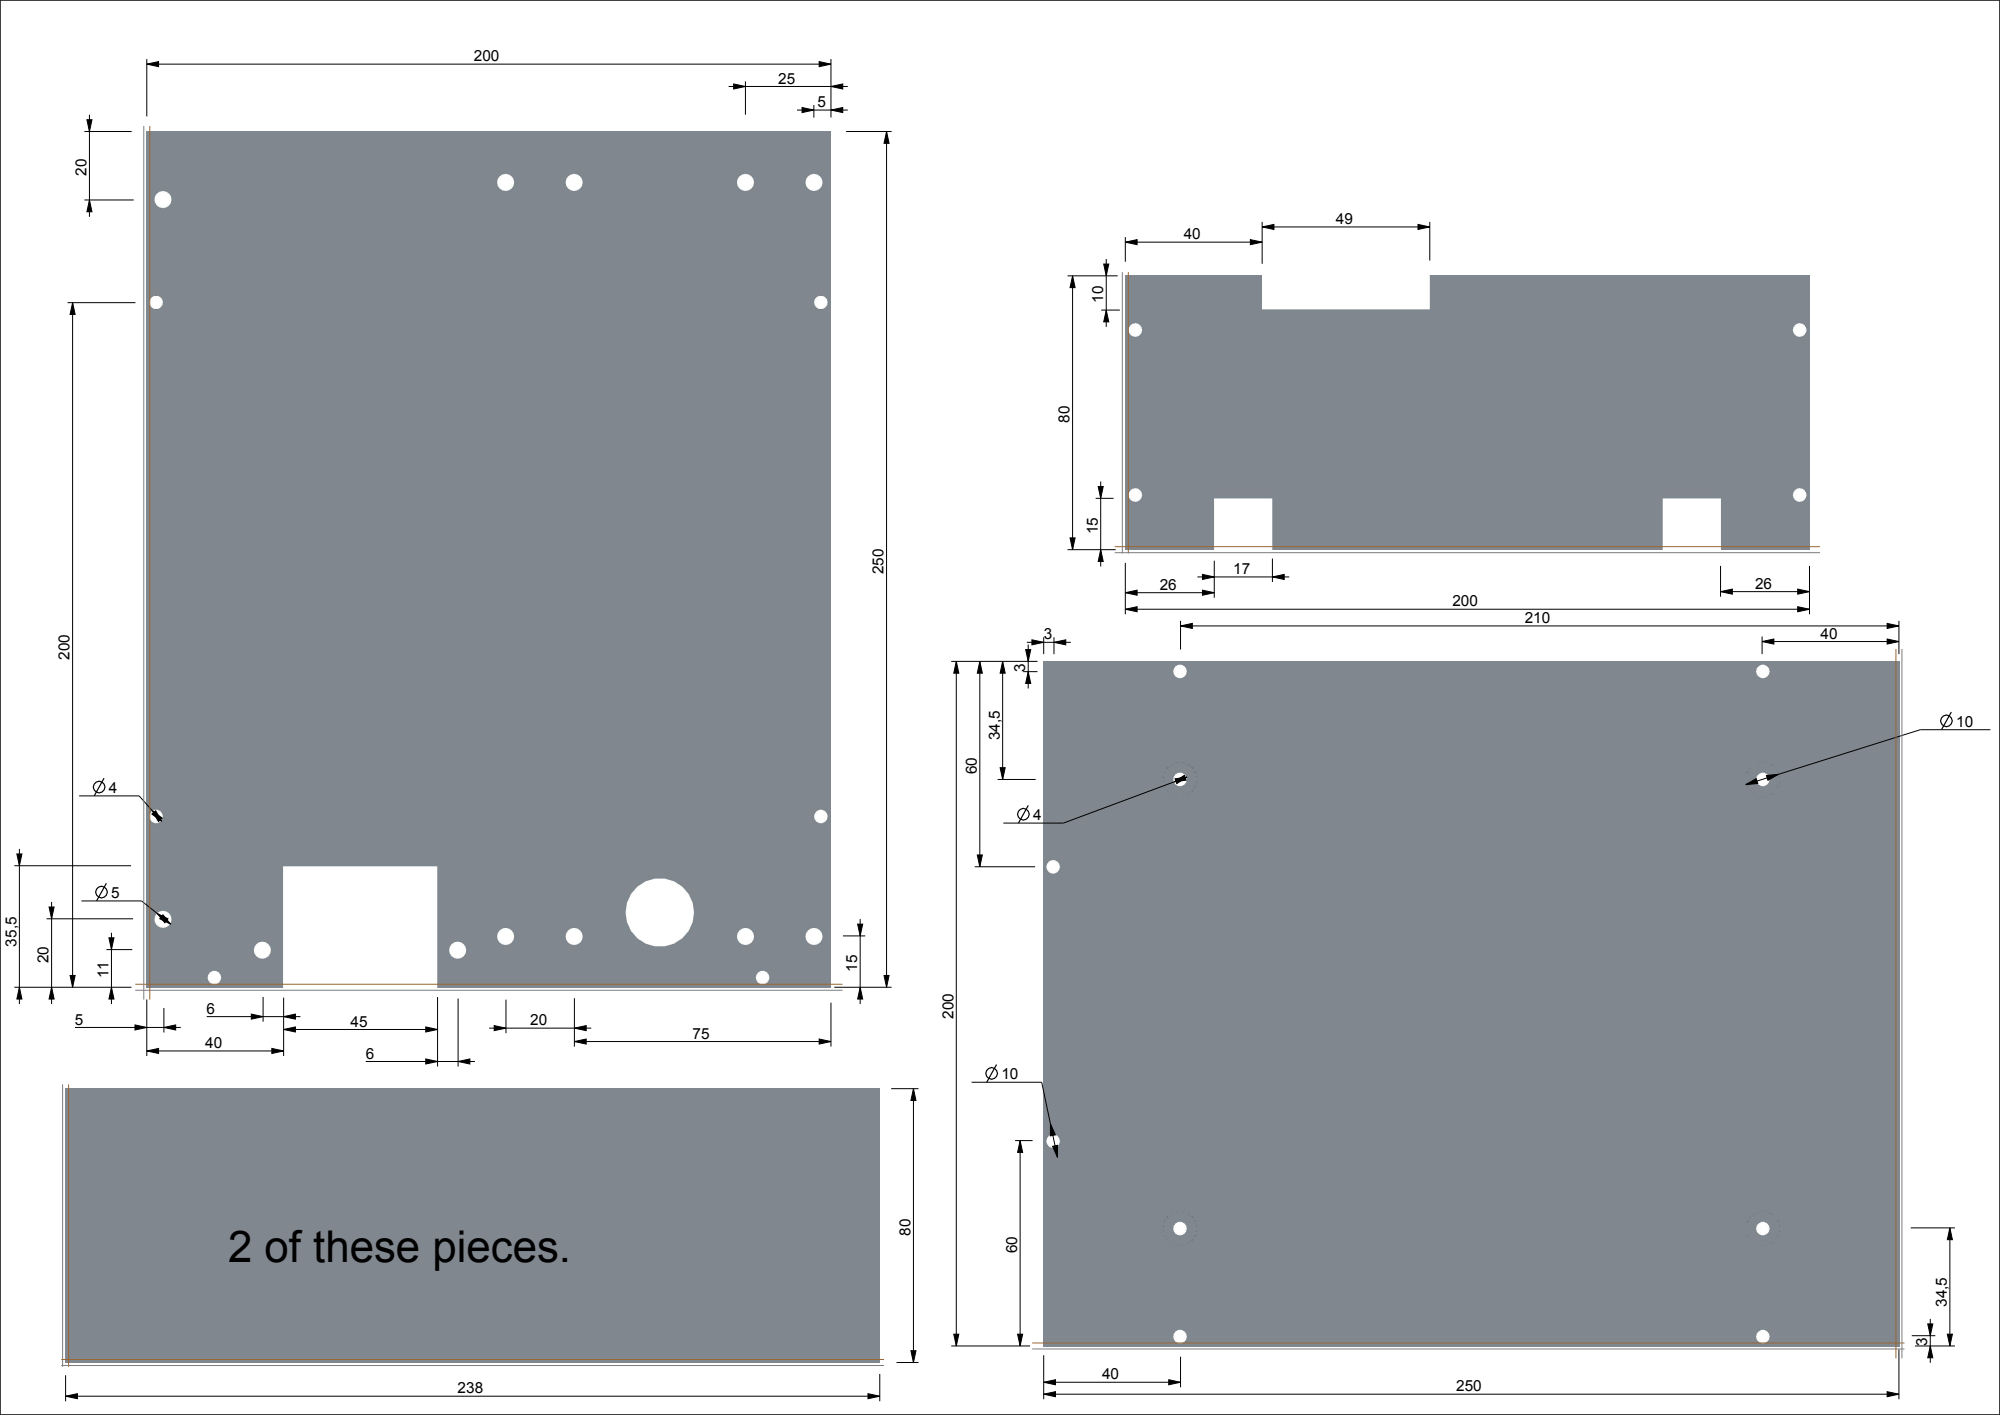
[picture p135: page 2]

2 of these pieces.

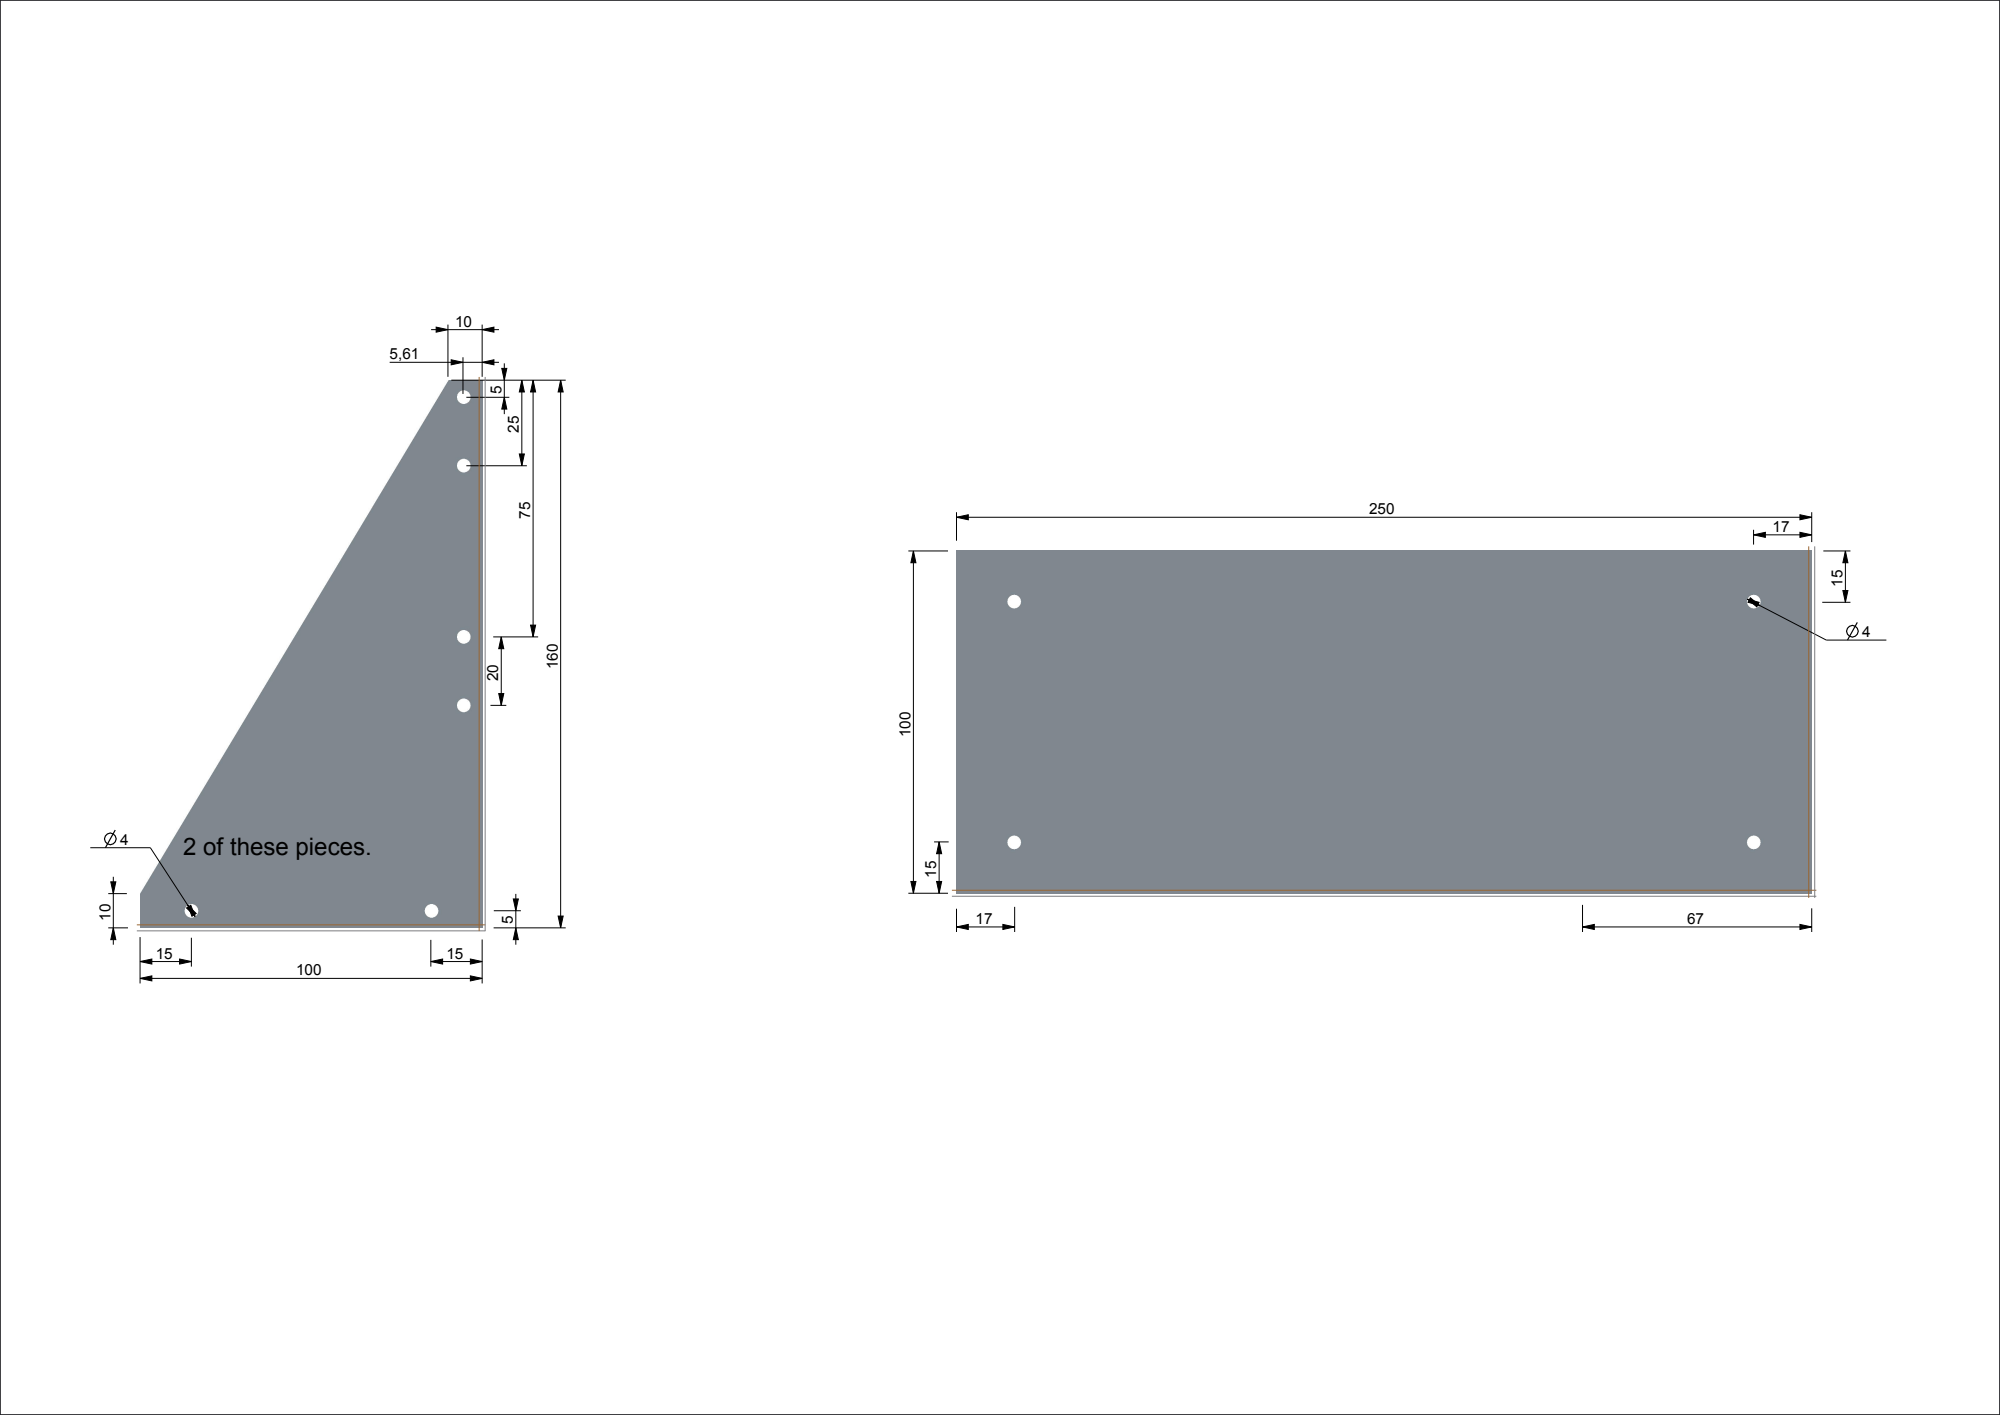
[picture p136: page 3]

2 of these pieces.

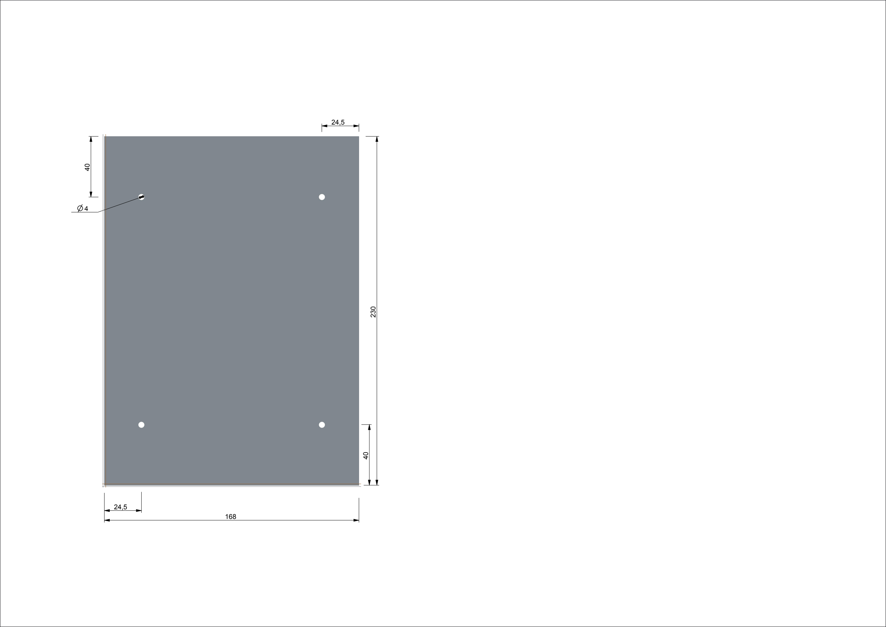
[picture p137: figure]
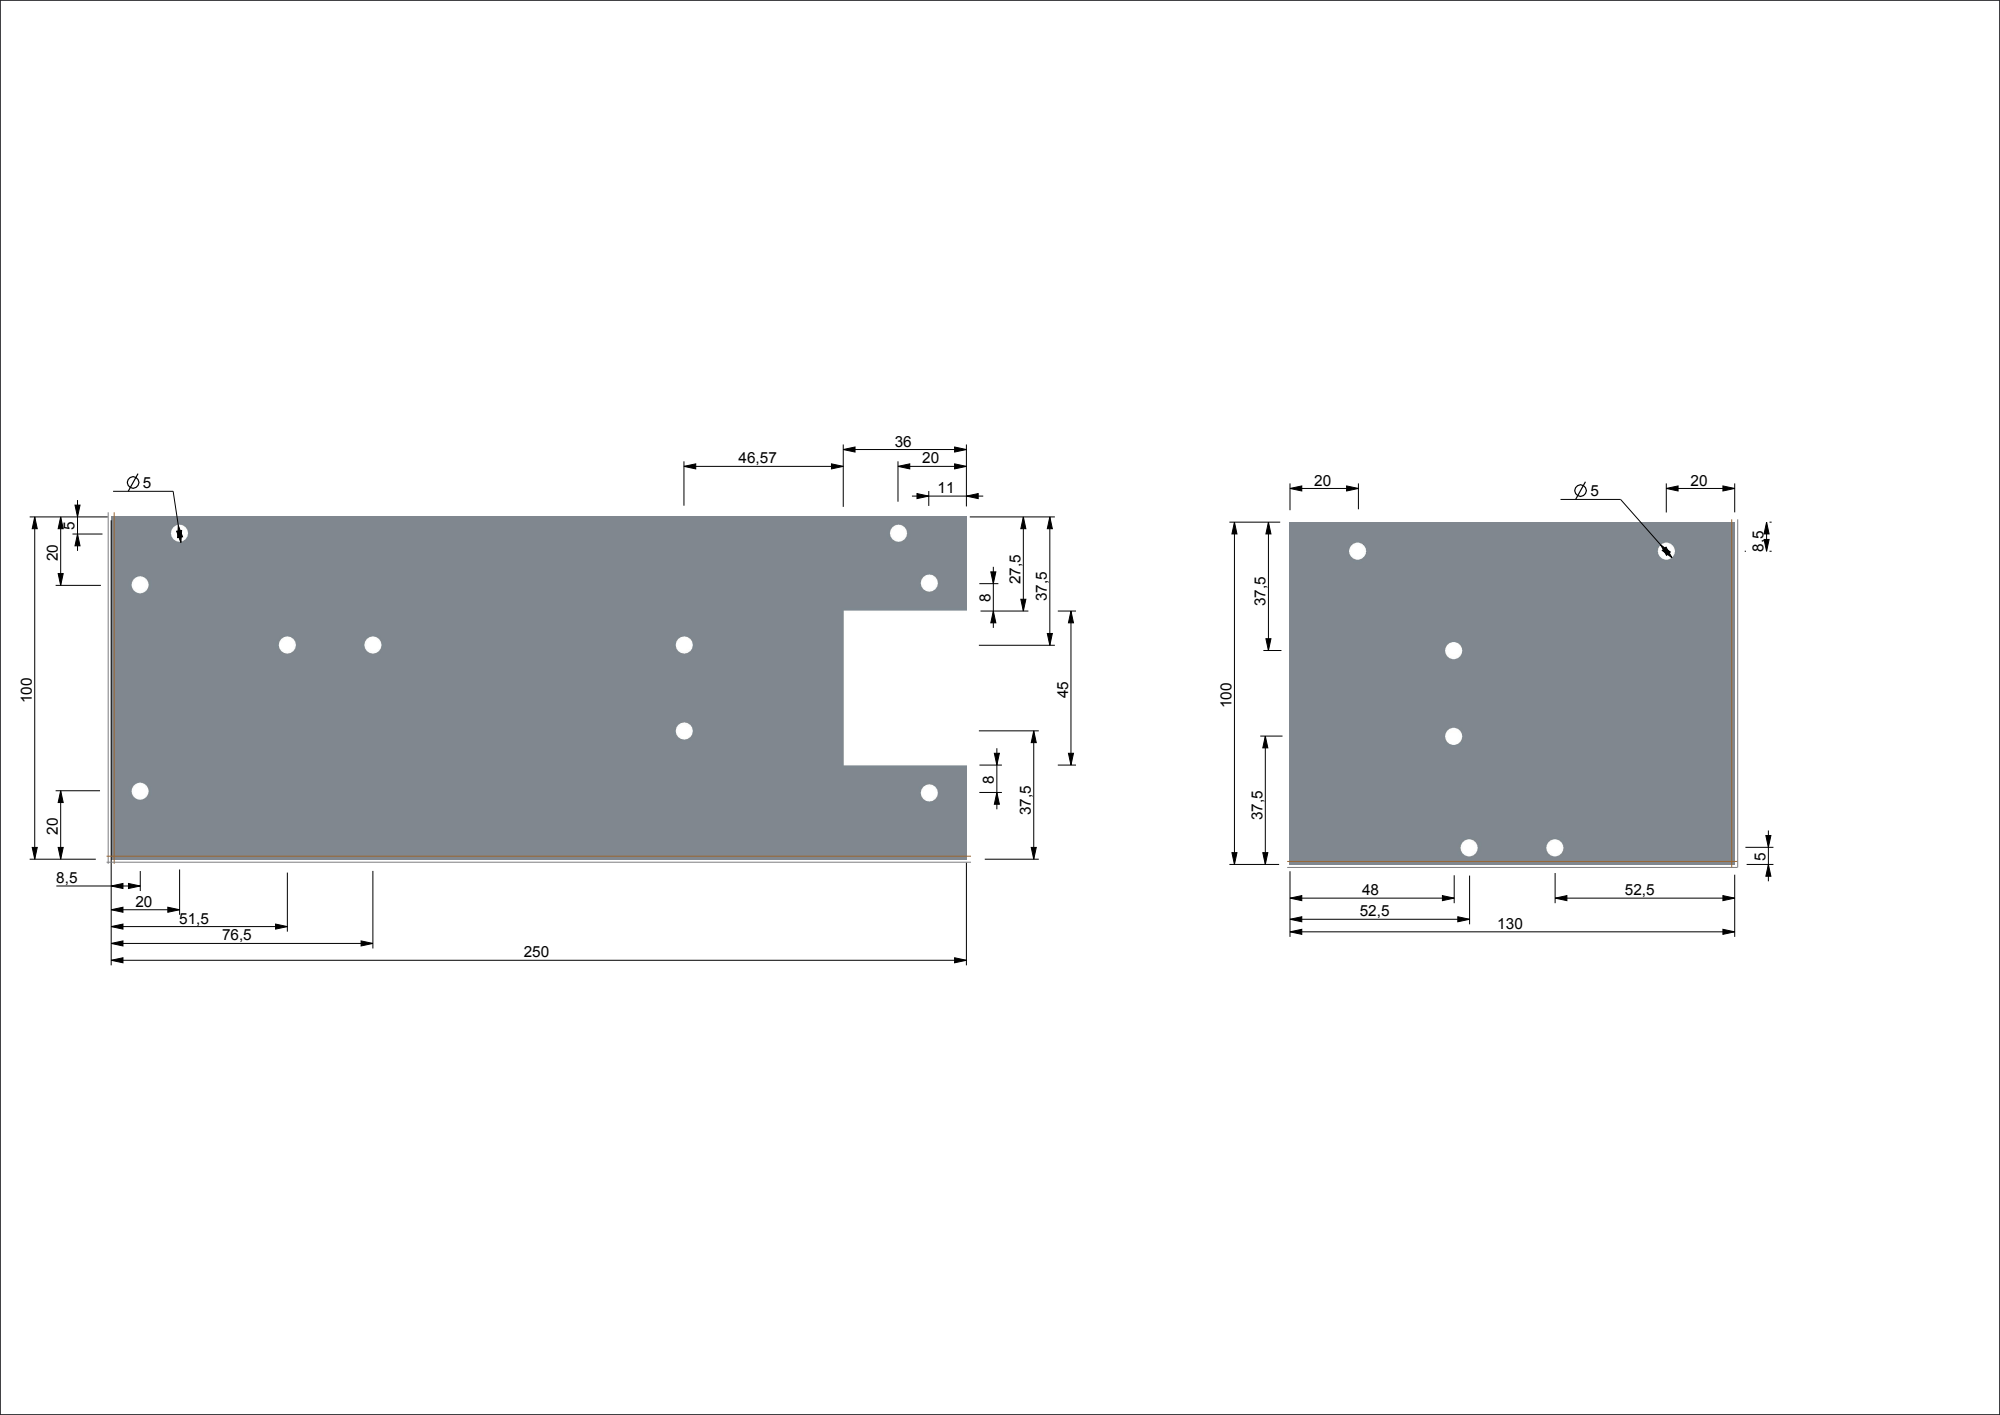
[picture p138: page 5]

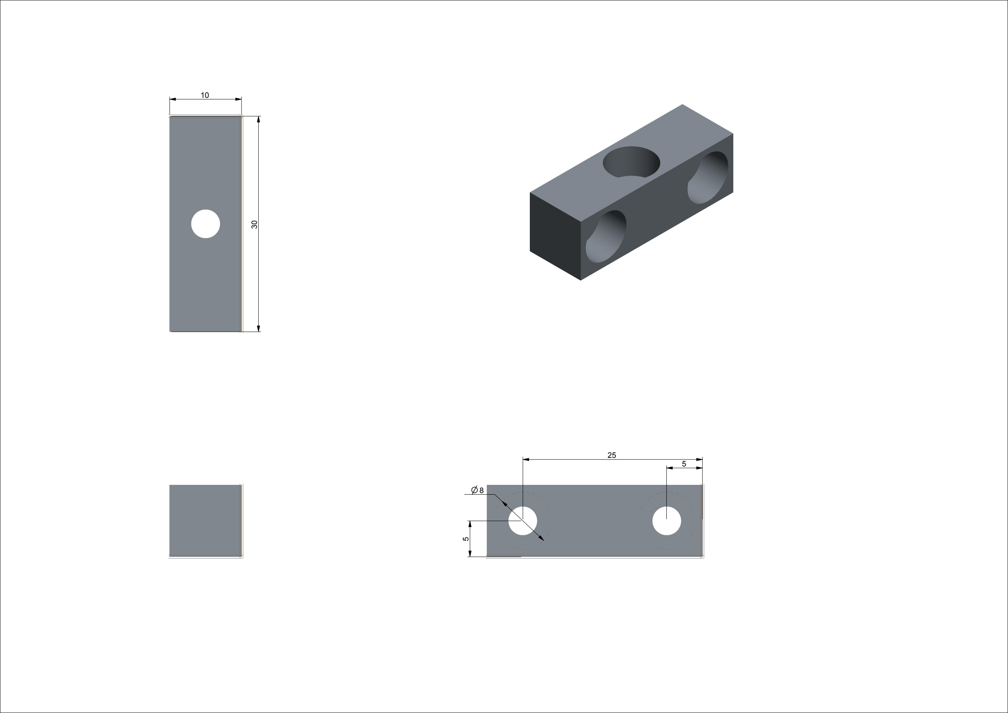
[picture p139: figure]
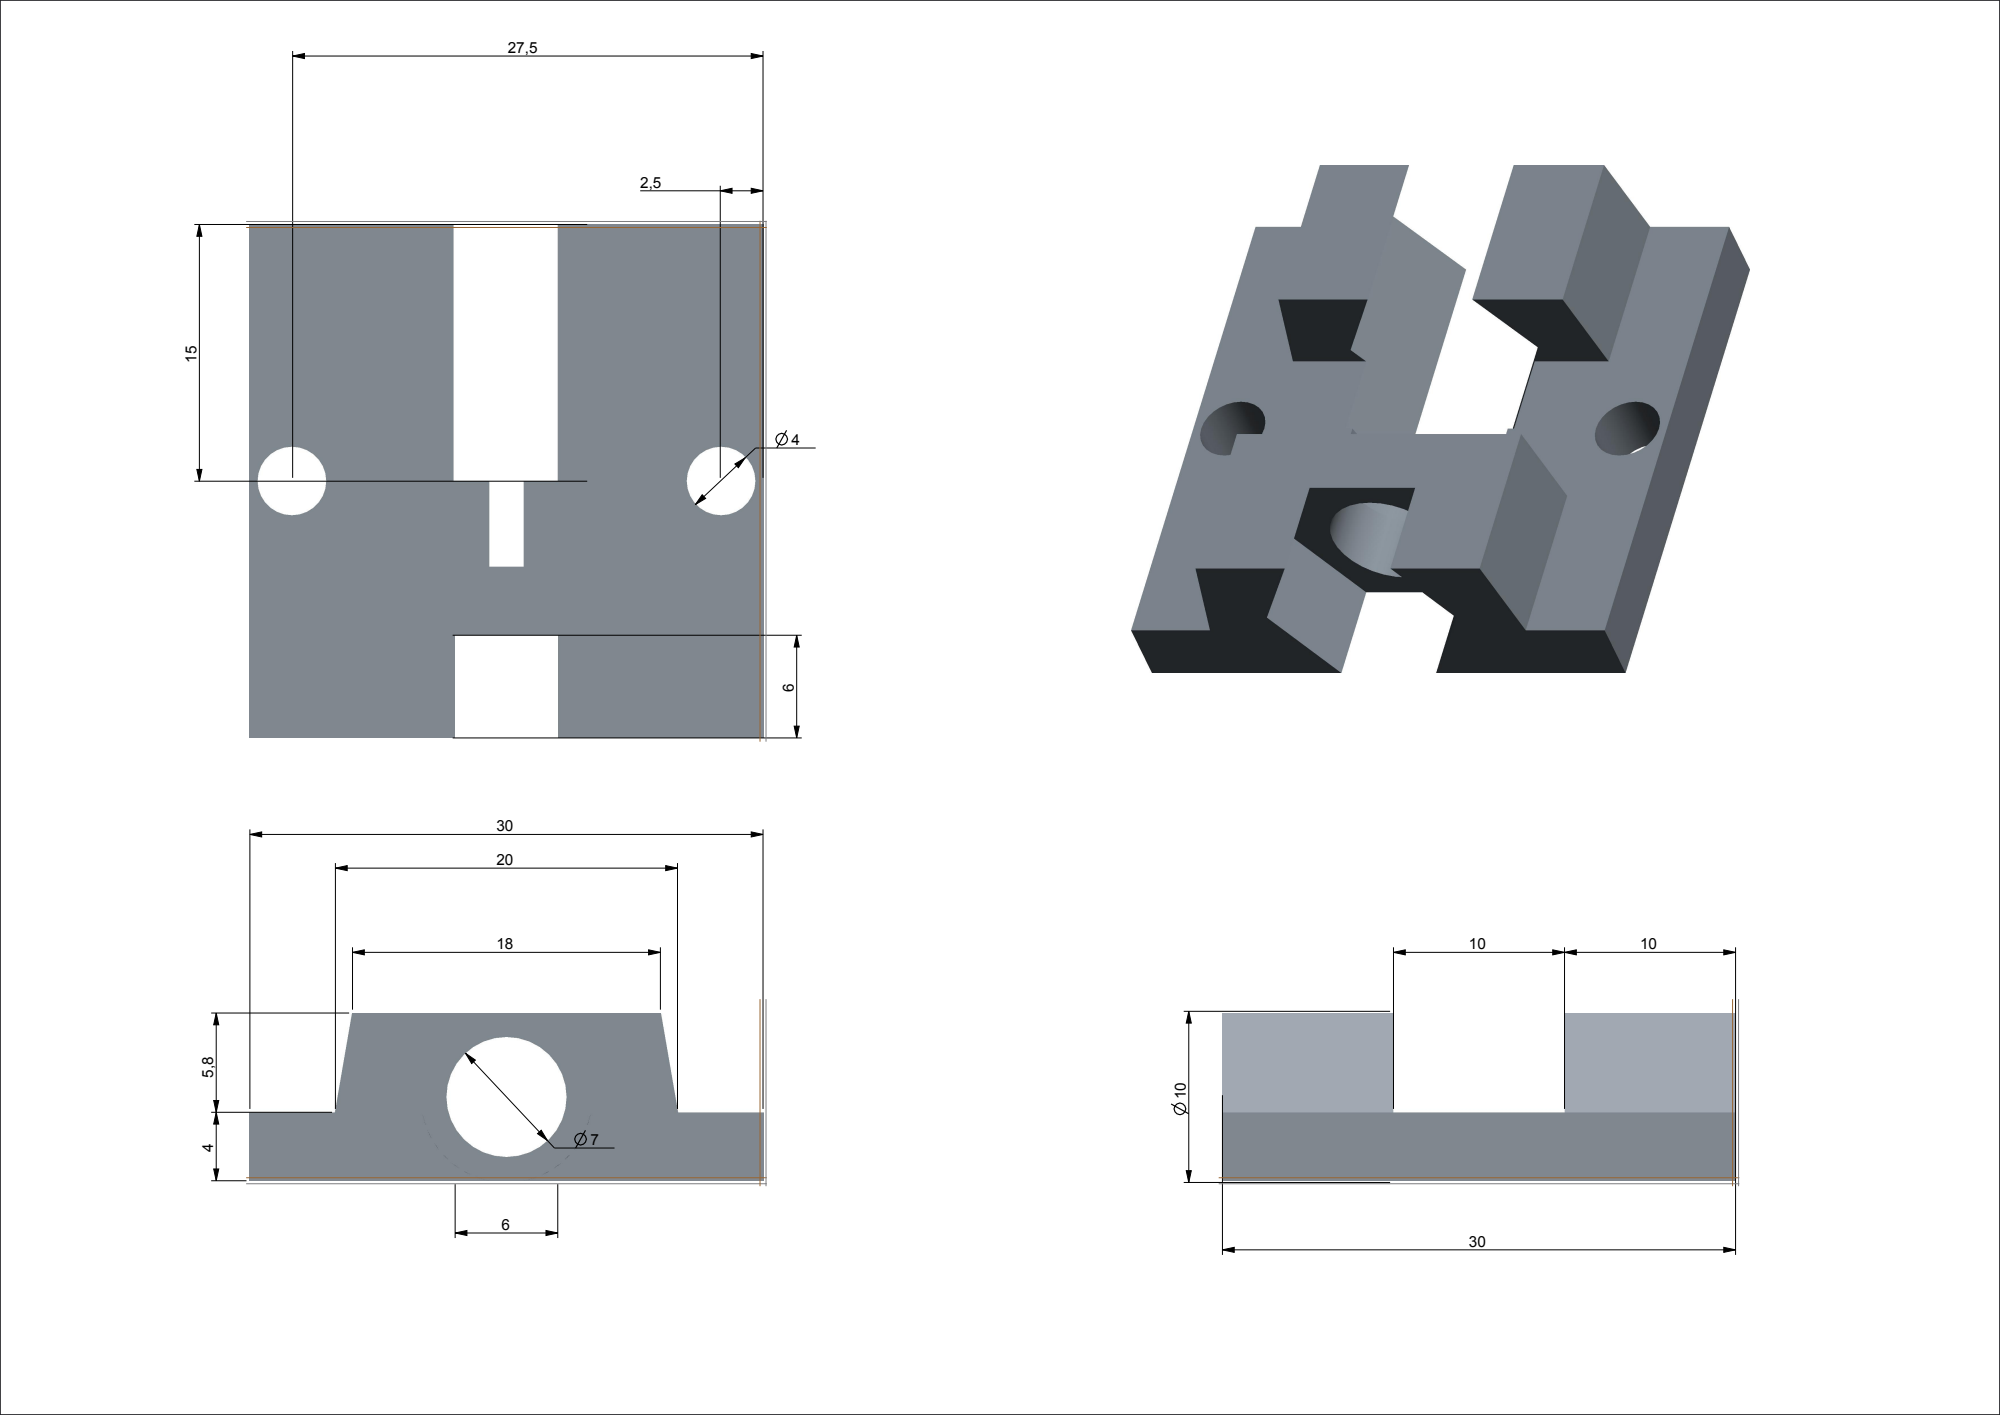
[picture p140: page 7]

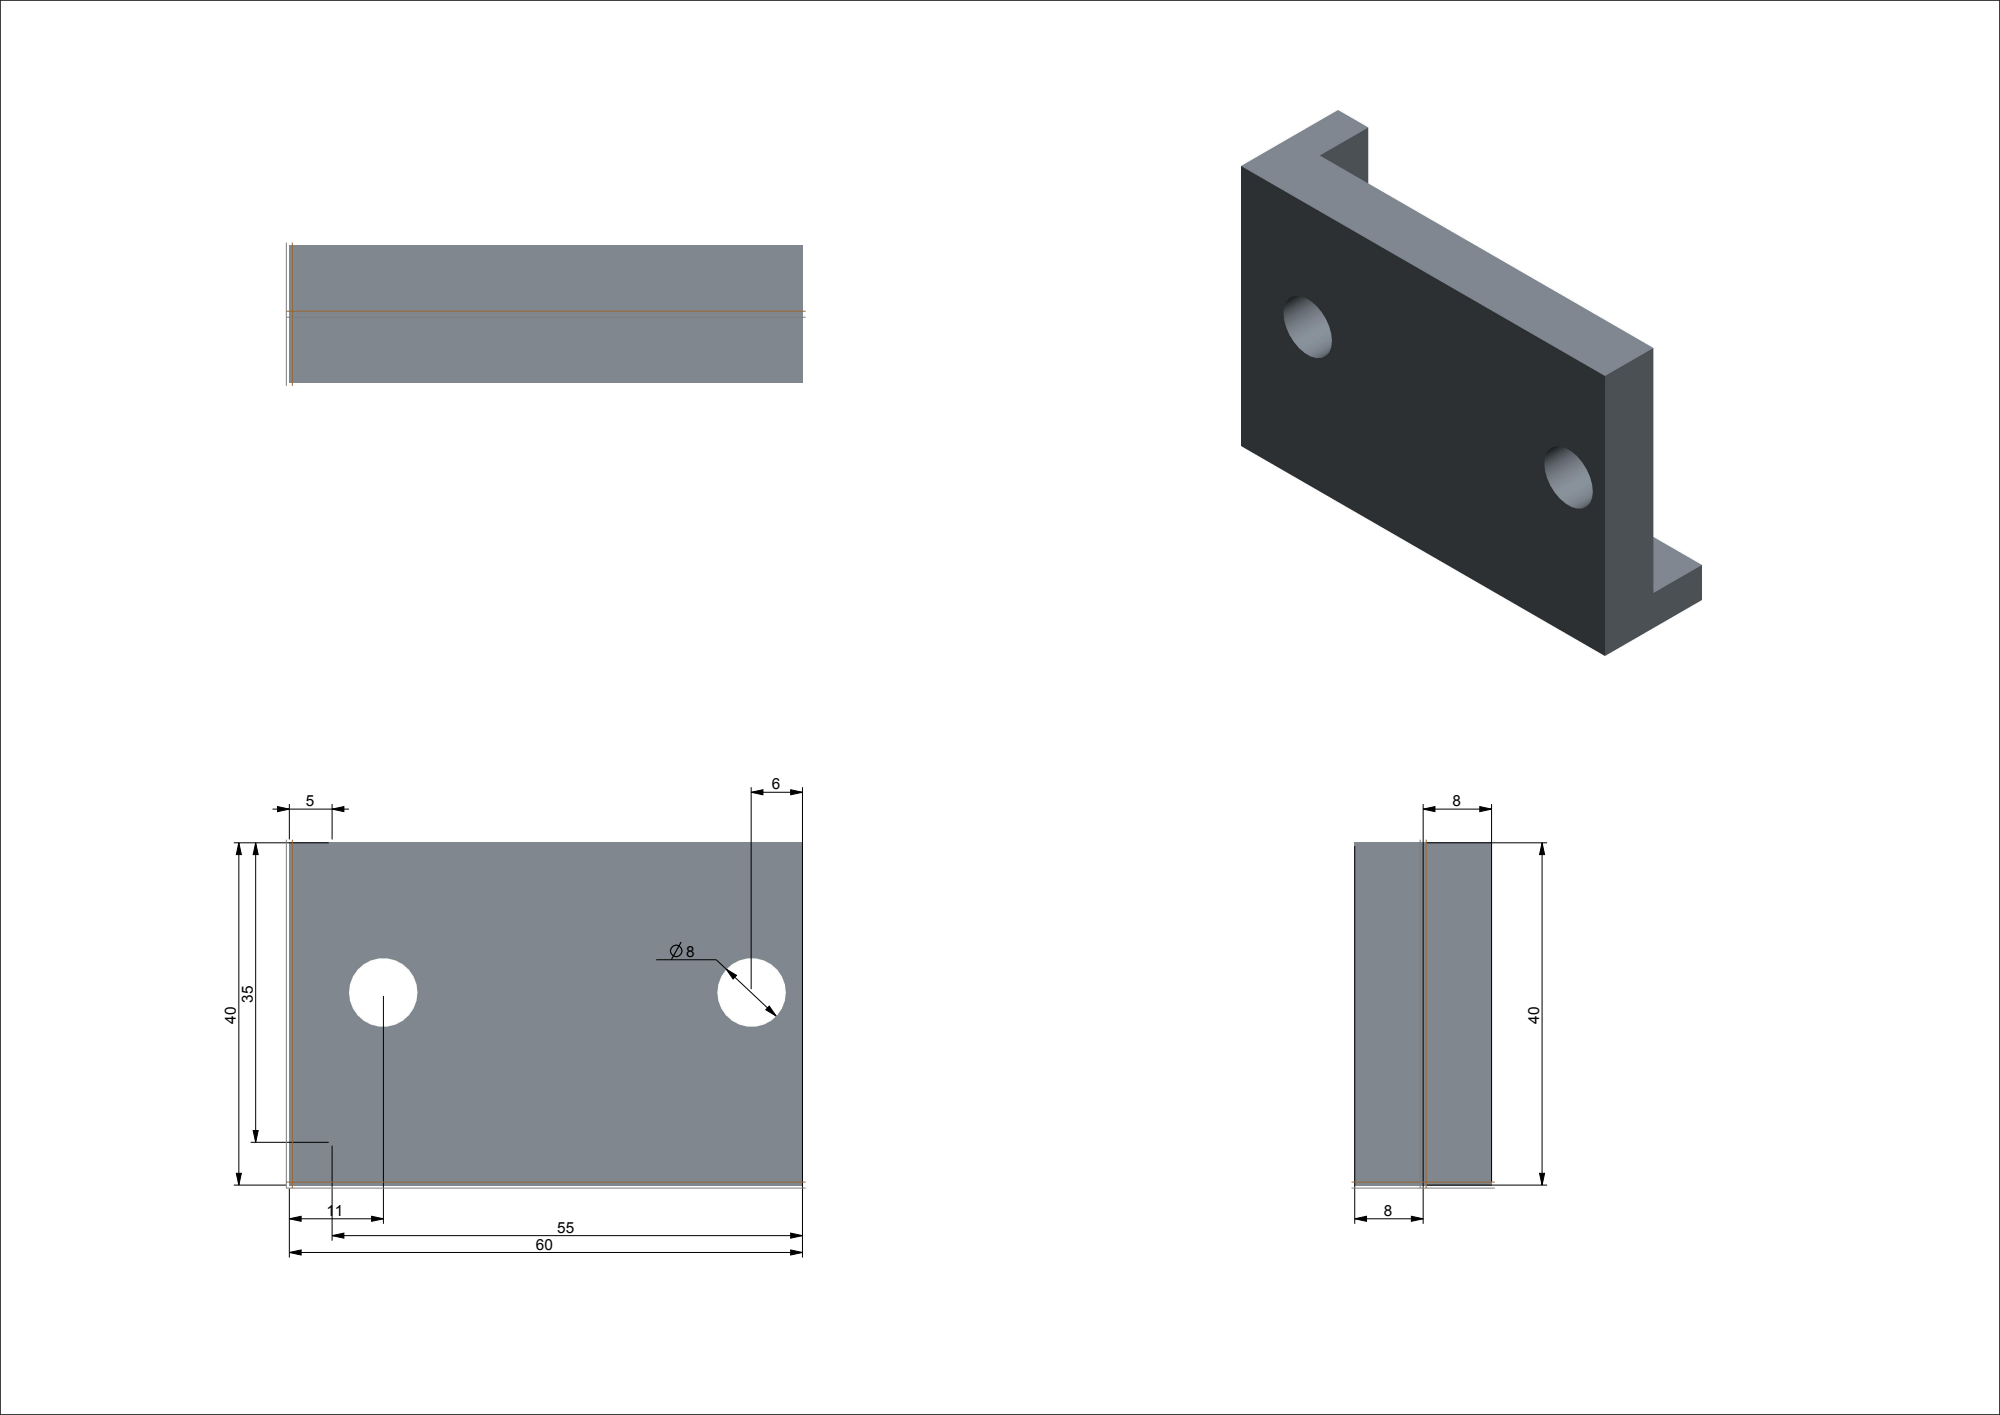
[picture p141: page 8]

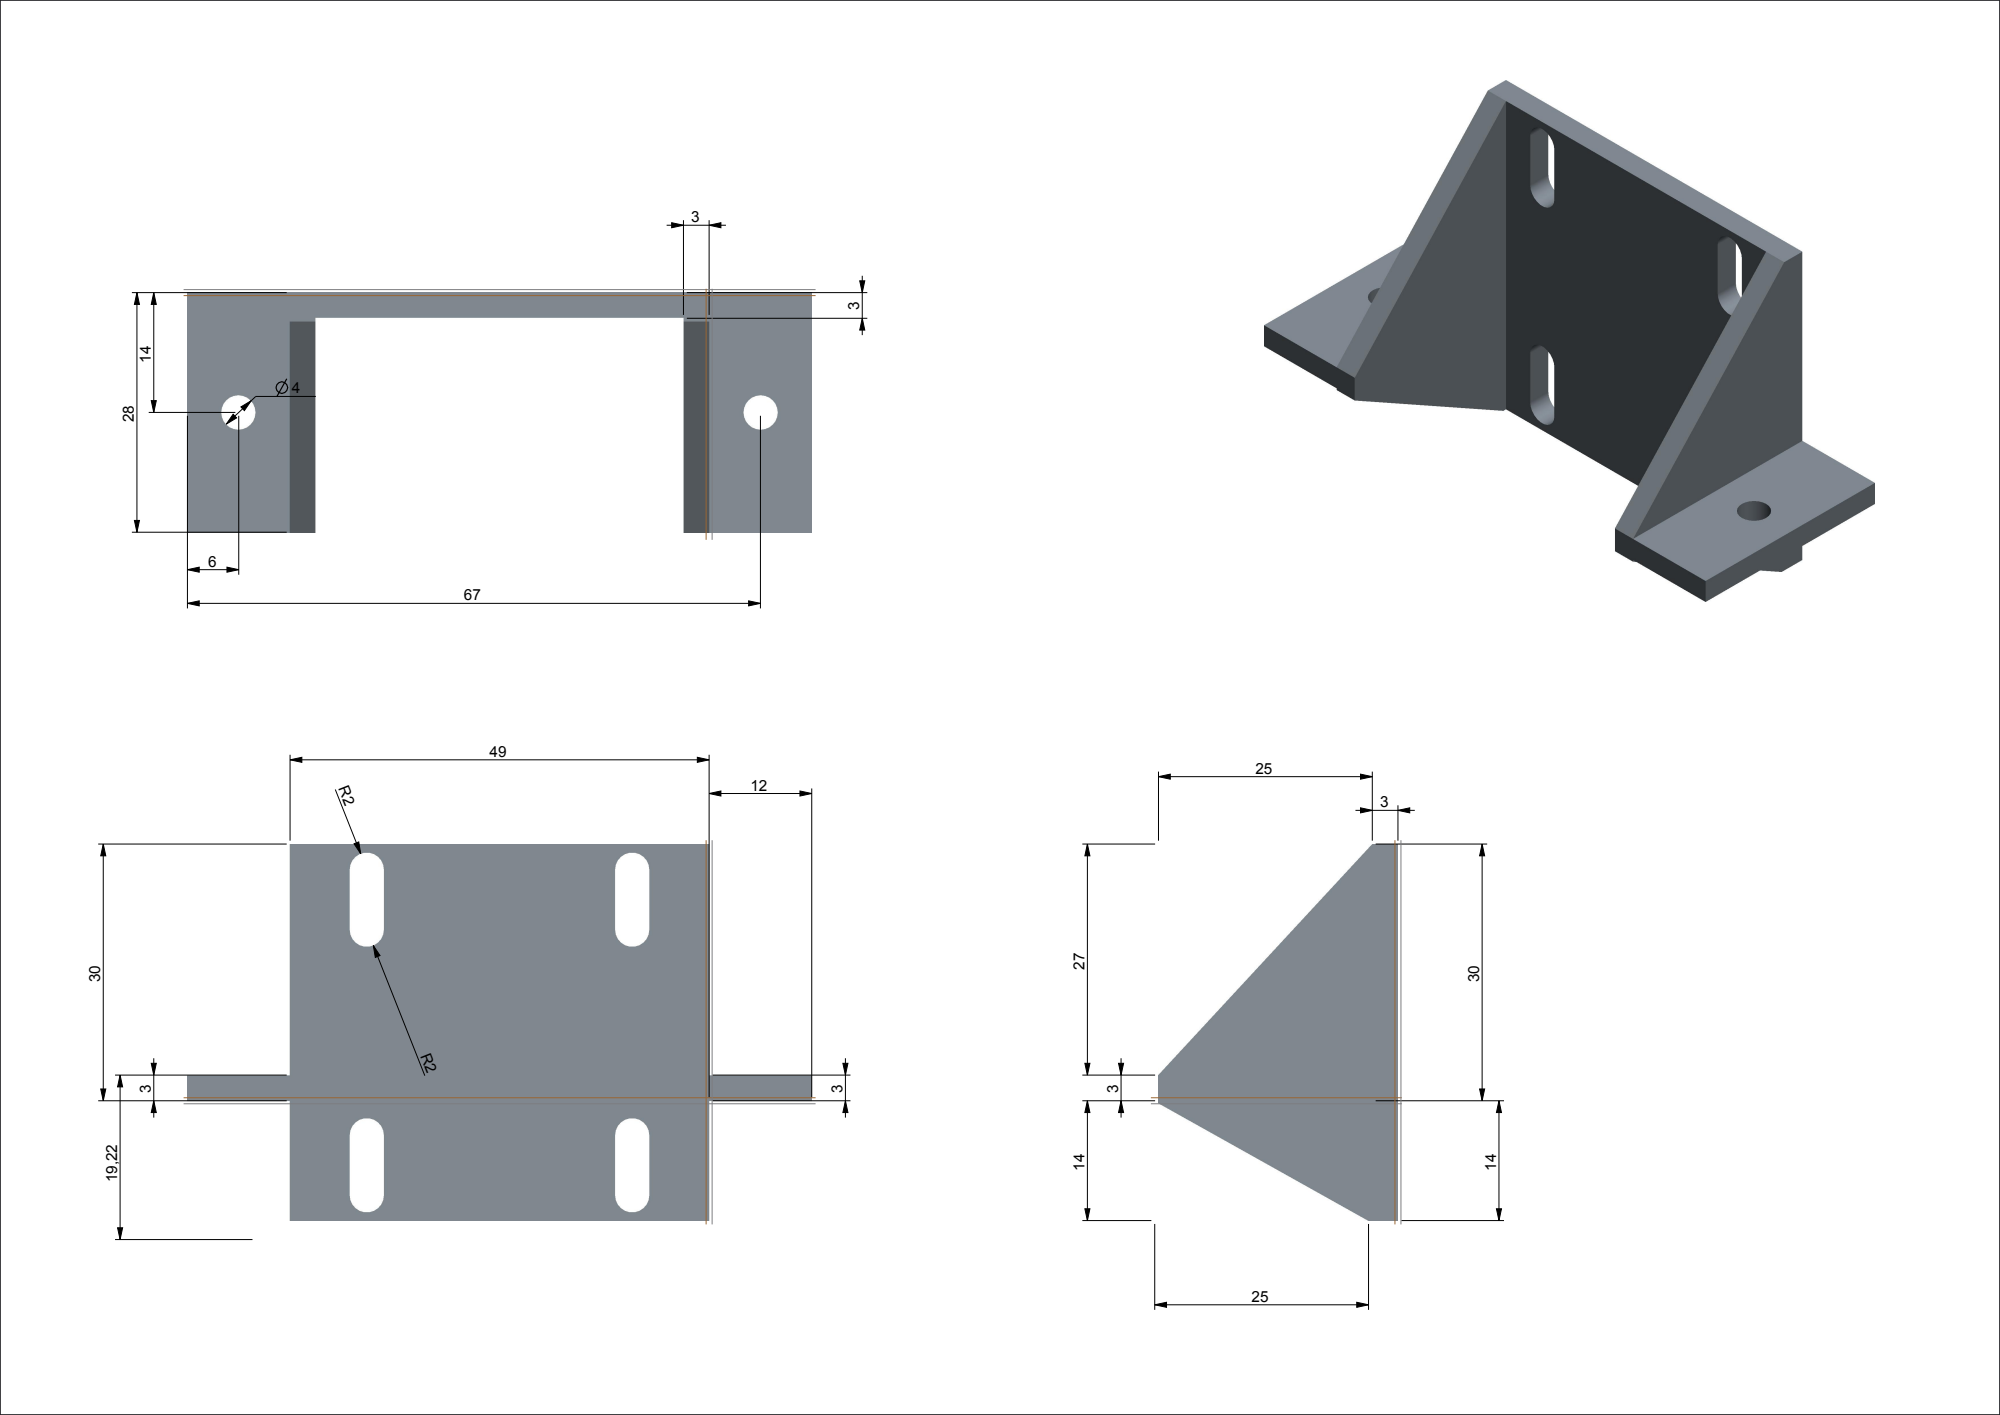
[picture p142: page 9]

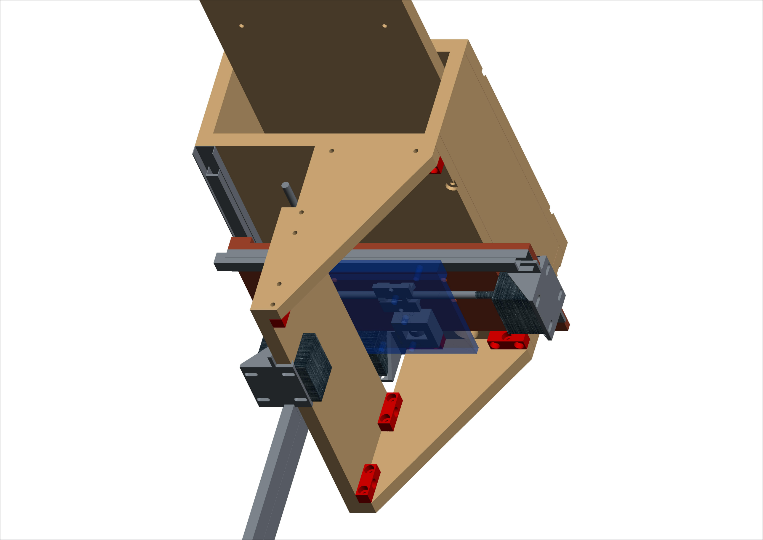
[picture p143: page 10]
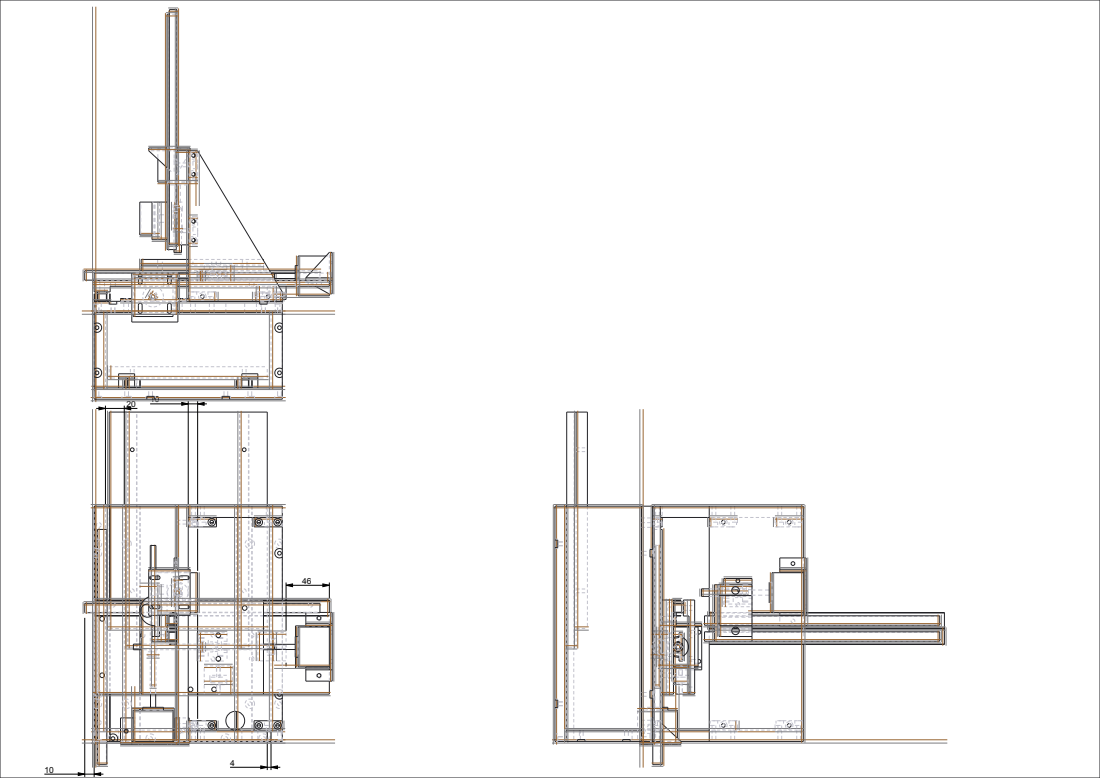
[picture p144: page 11]

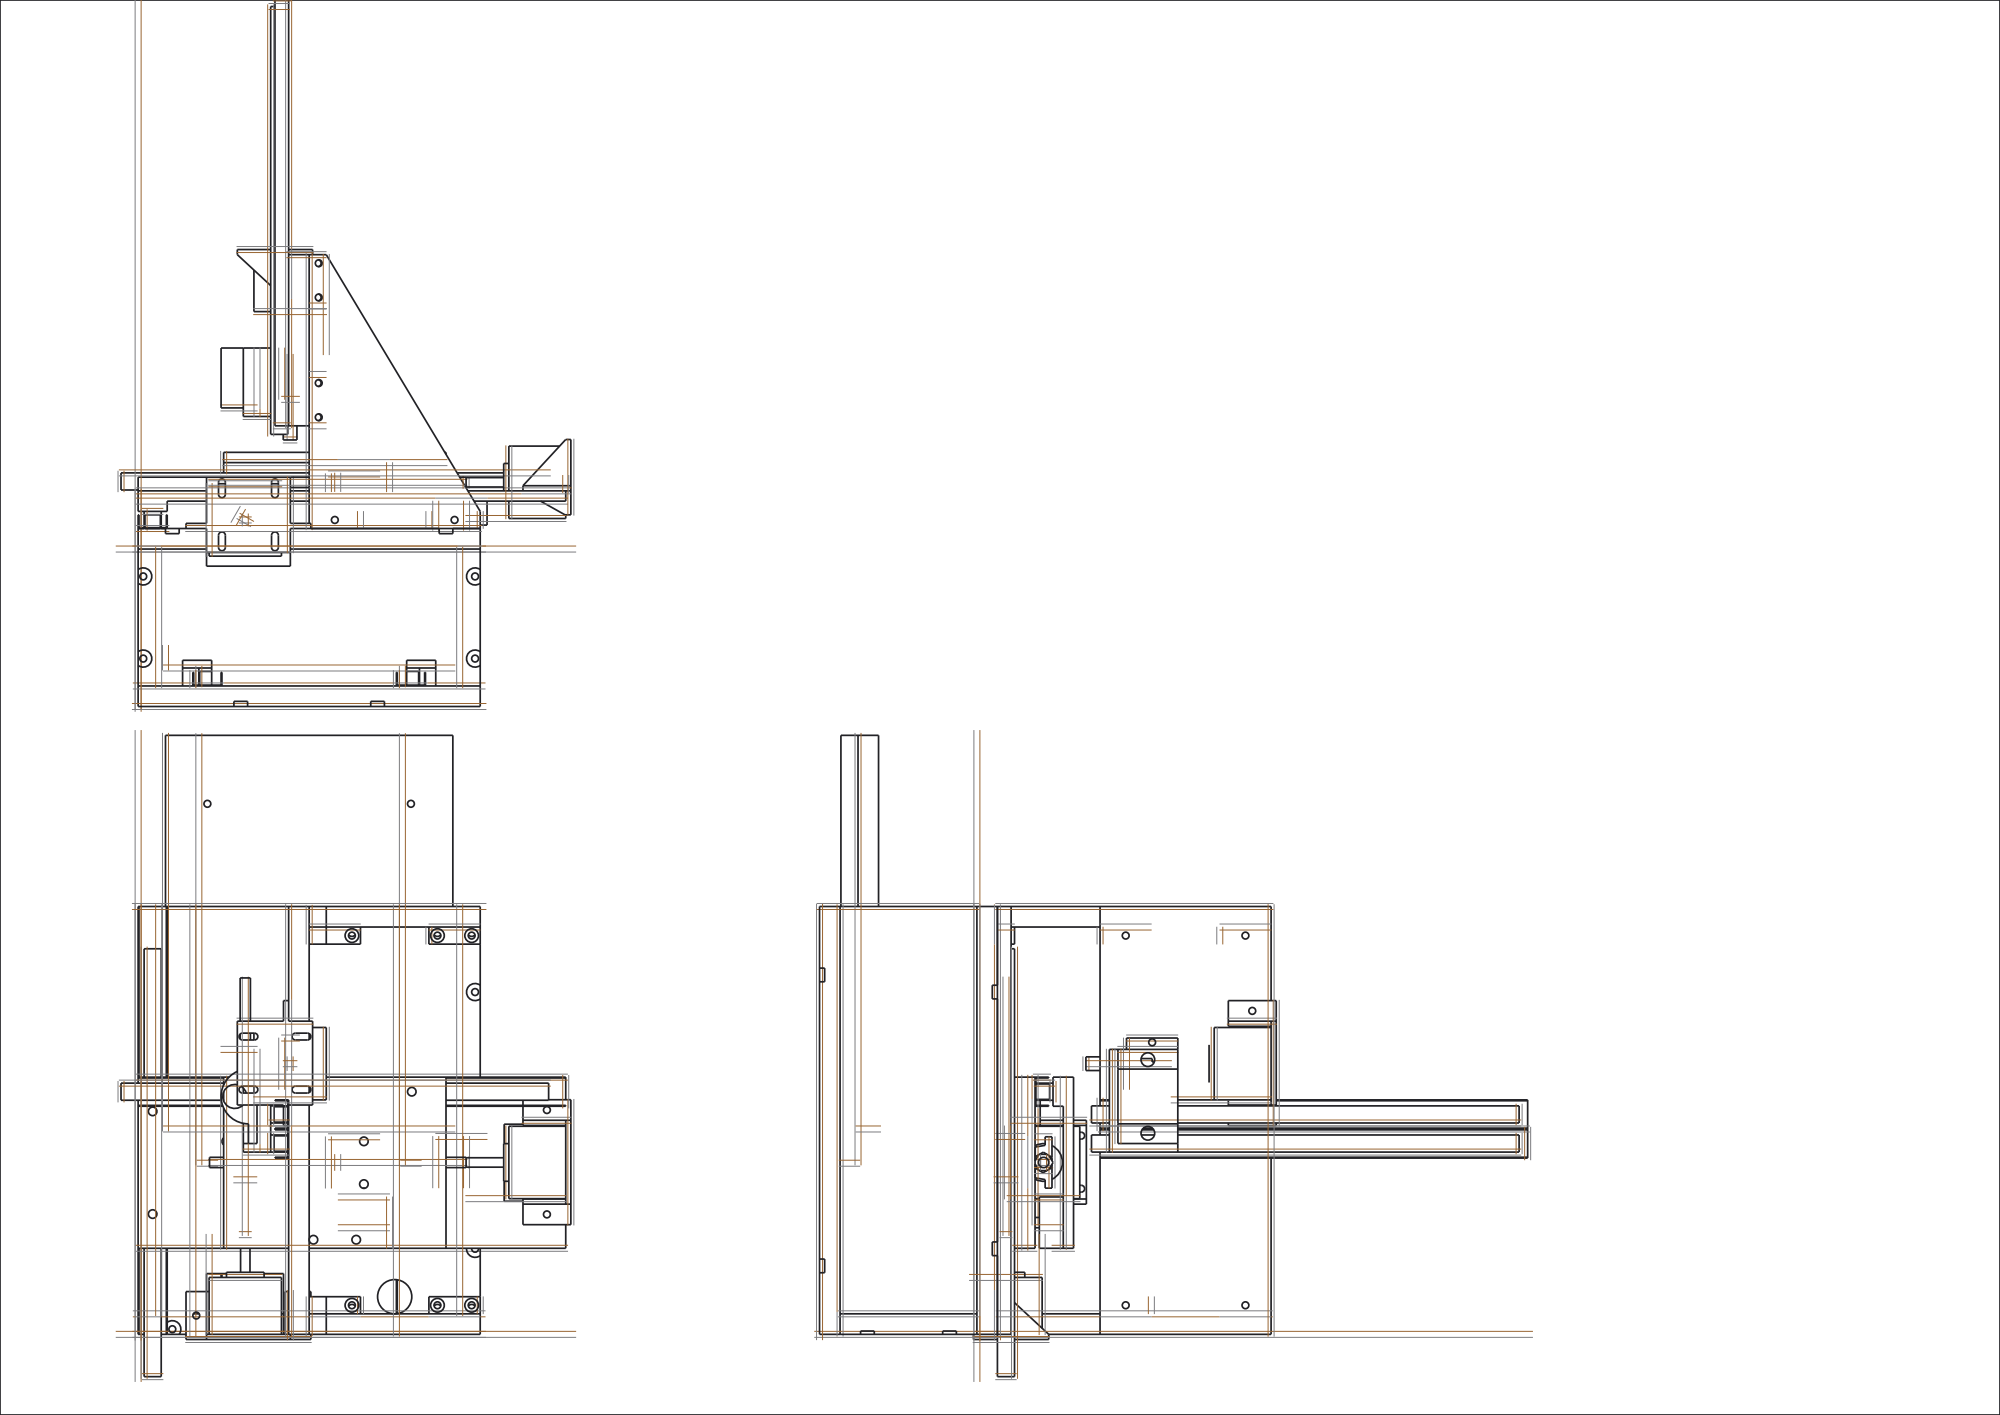
[picture p145: page 12]
