JamesGlanville/solderingmachine/parts/creo/partstocut_trimmed.pdf

2 of these pieces.


2 of these pieces.
