JamesGlanville/solderingmachine/parts/creo/gadmeeting.pdf

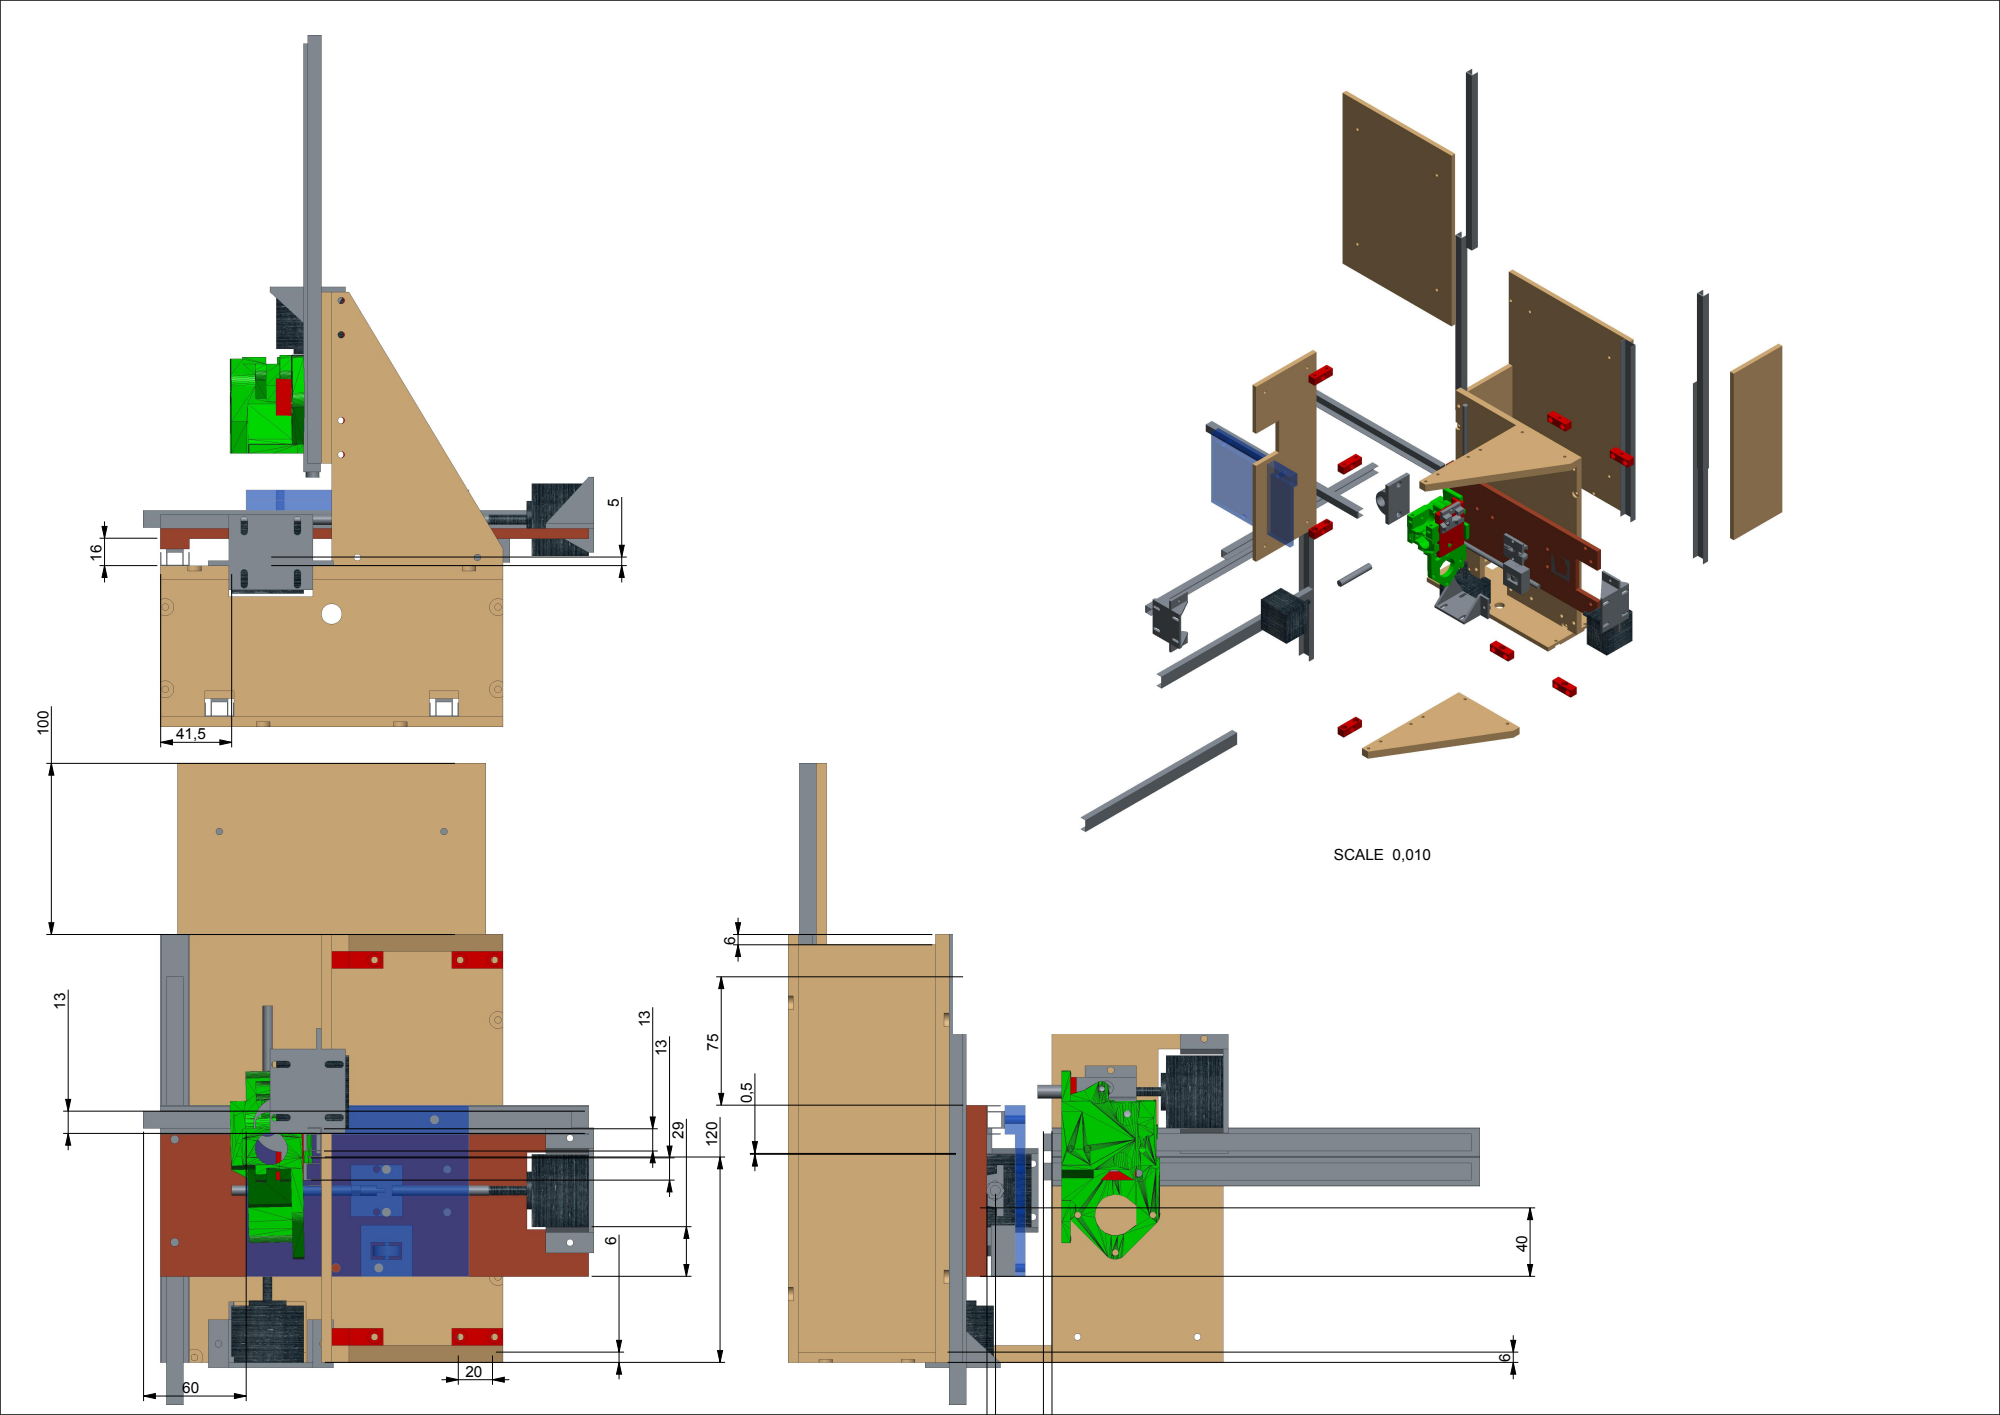
[picture p146: page 1]
SCALE 0,010

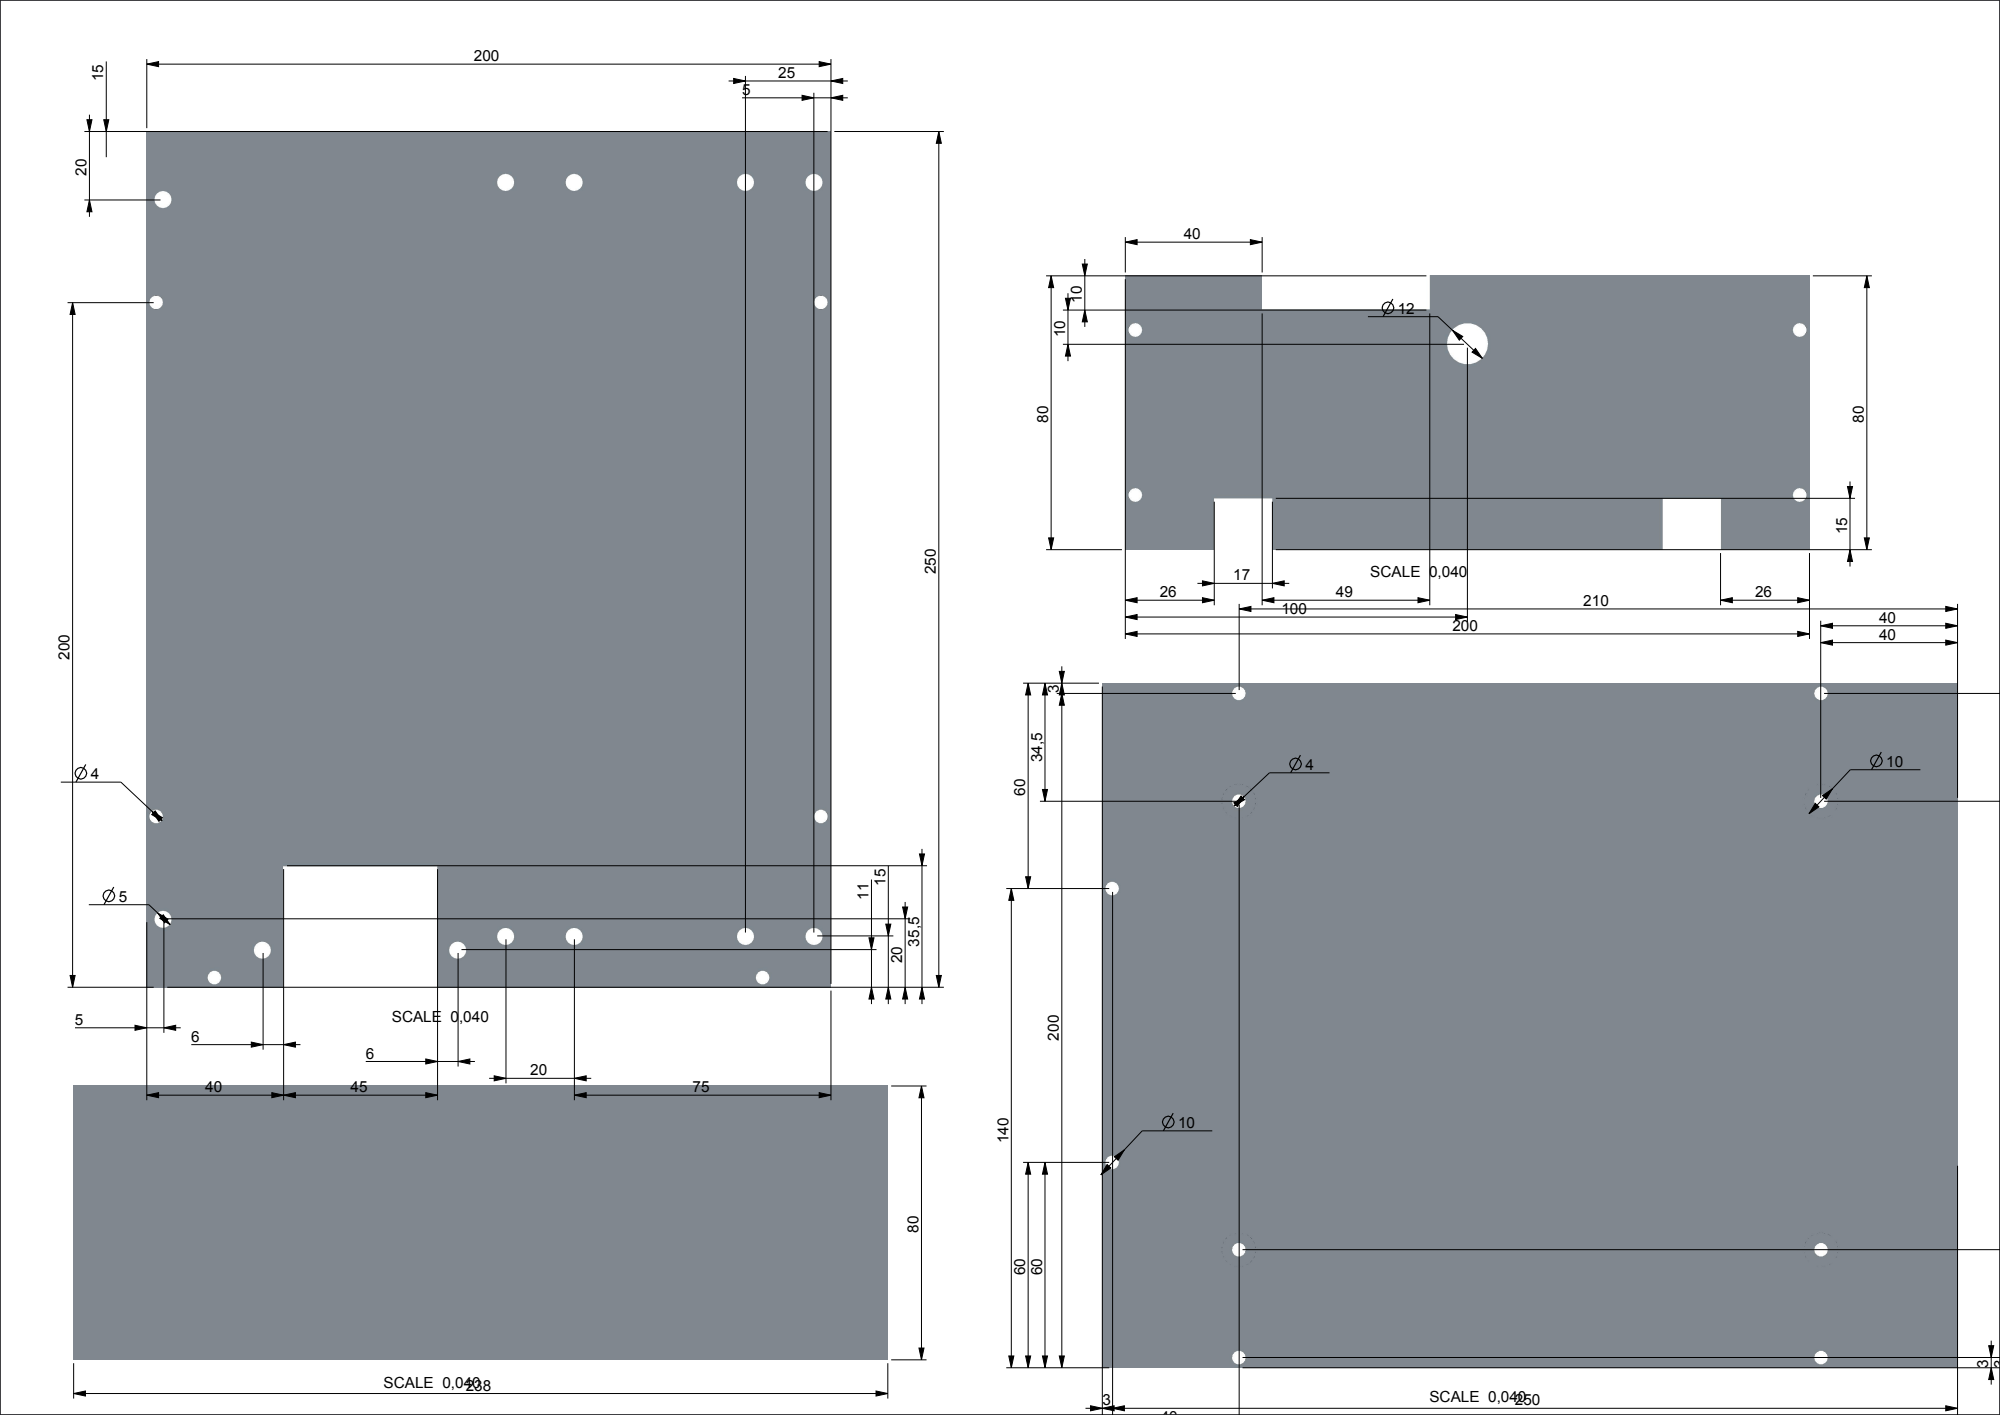
[picture p147: page 2]
SCALE; SCALE 0,040

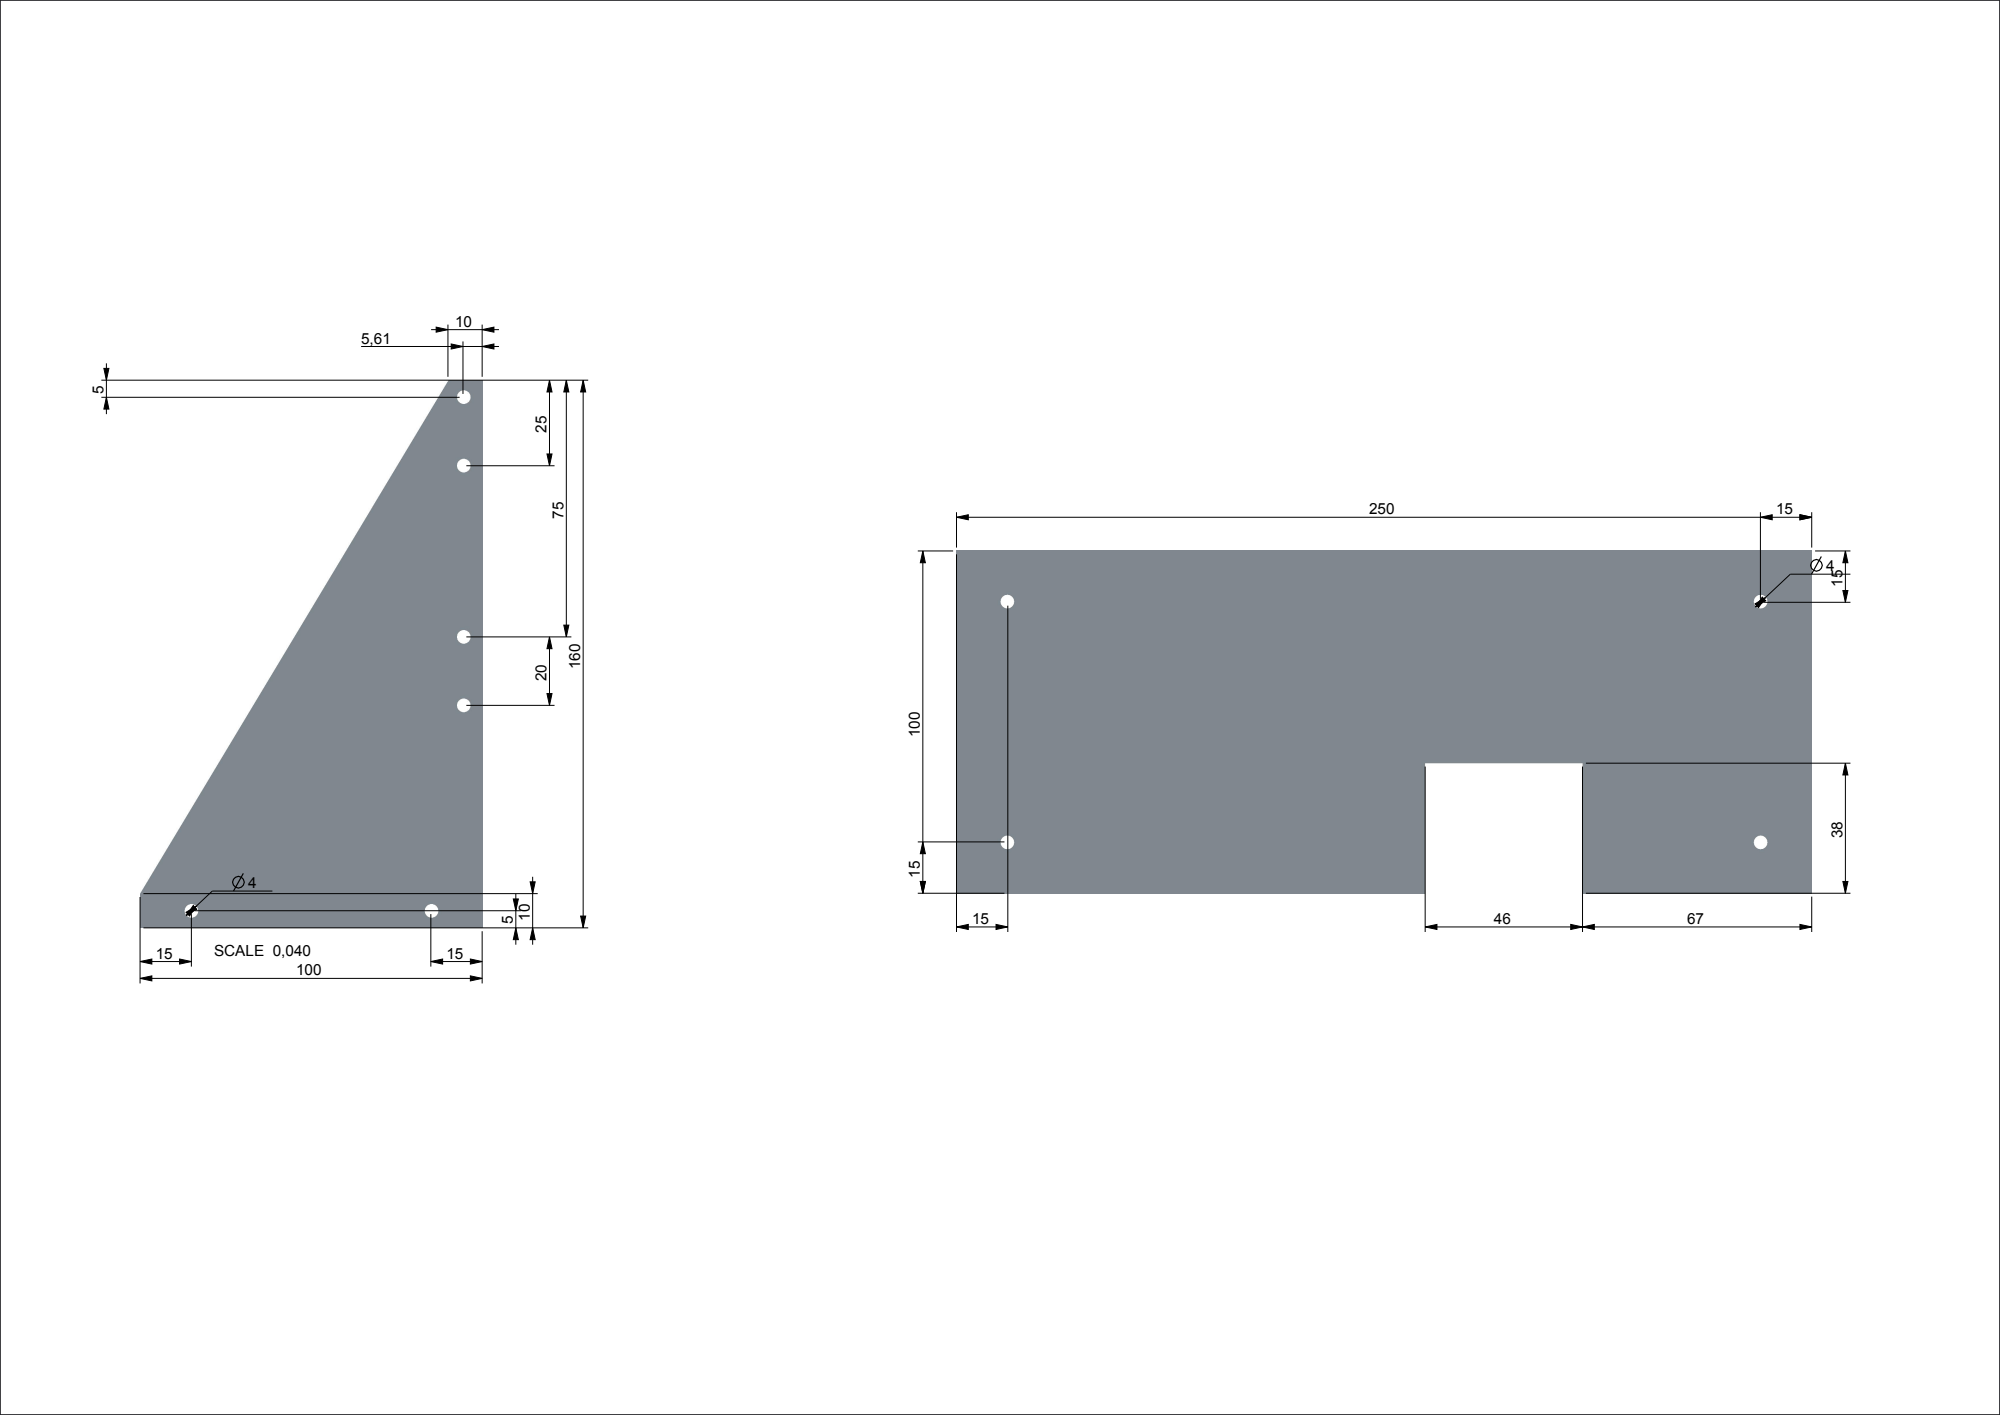
[picture p148: page 3]
SCALE 0,040

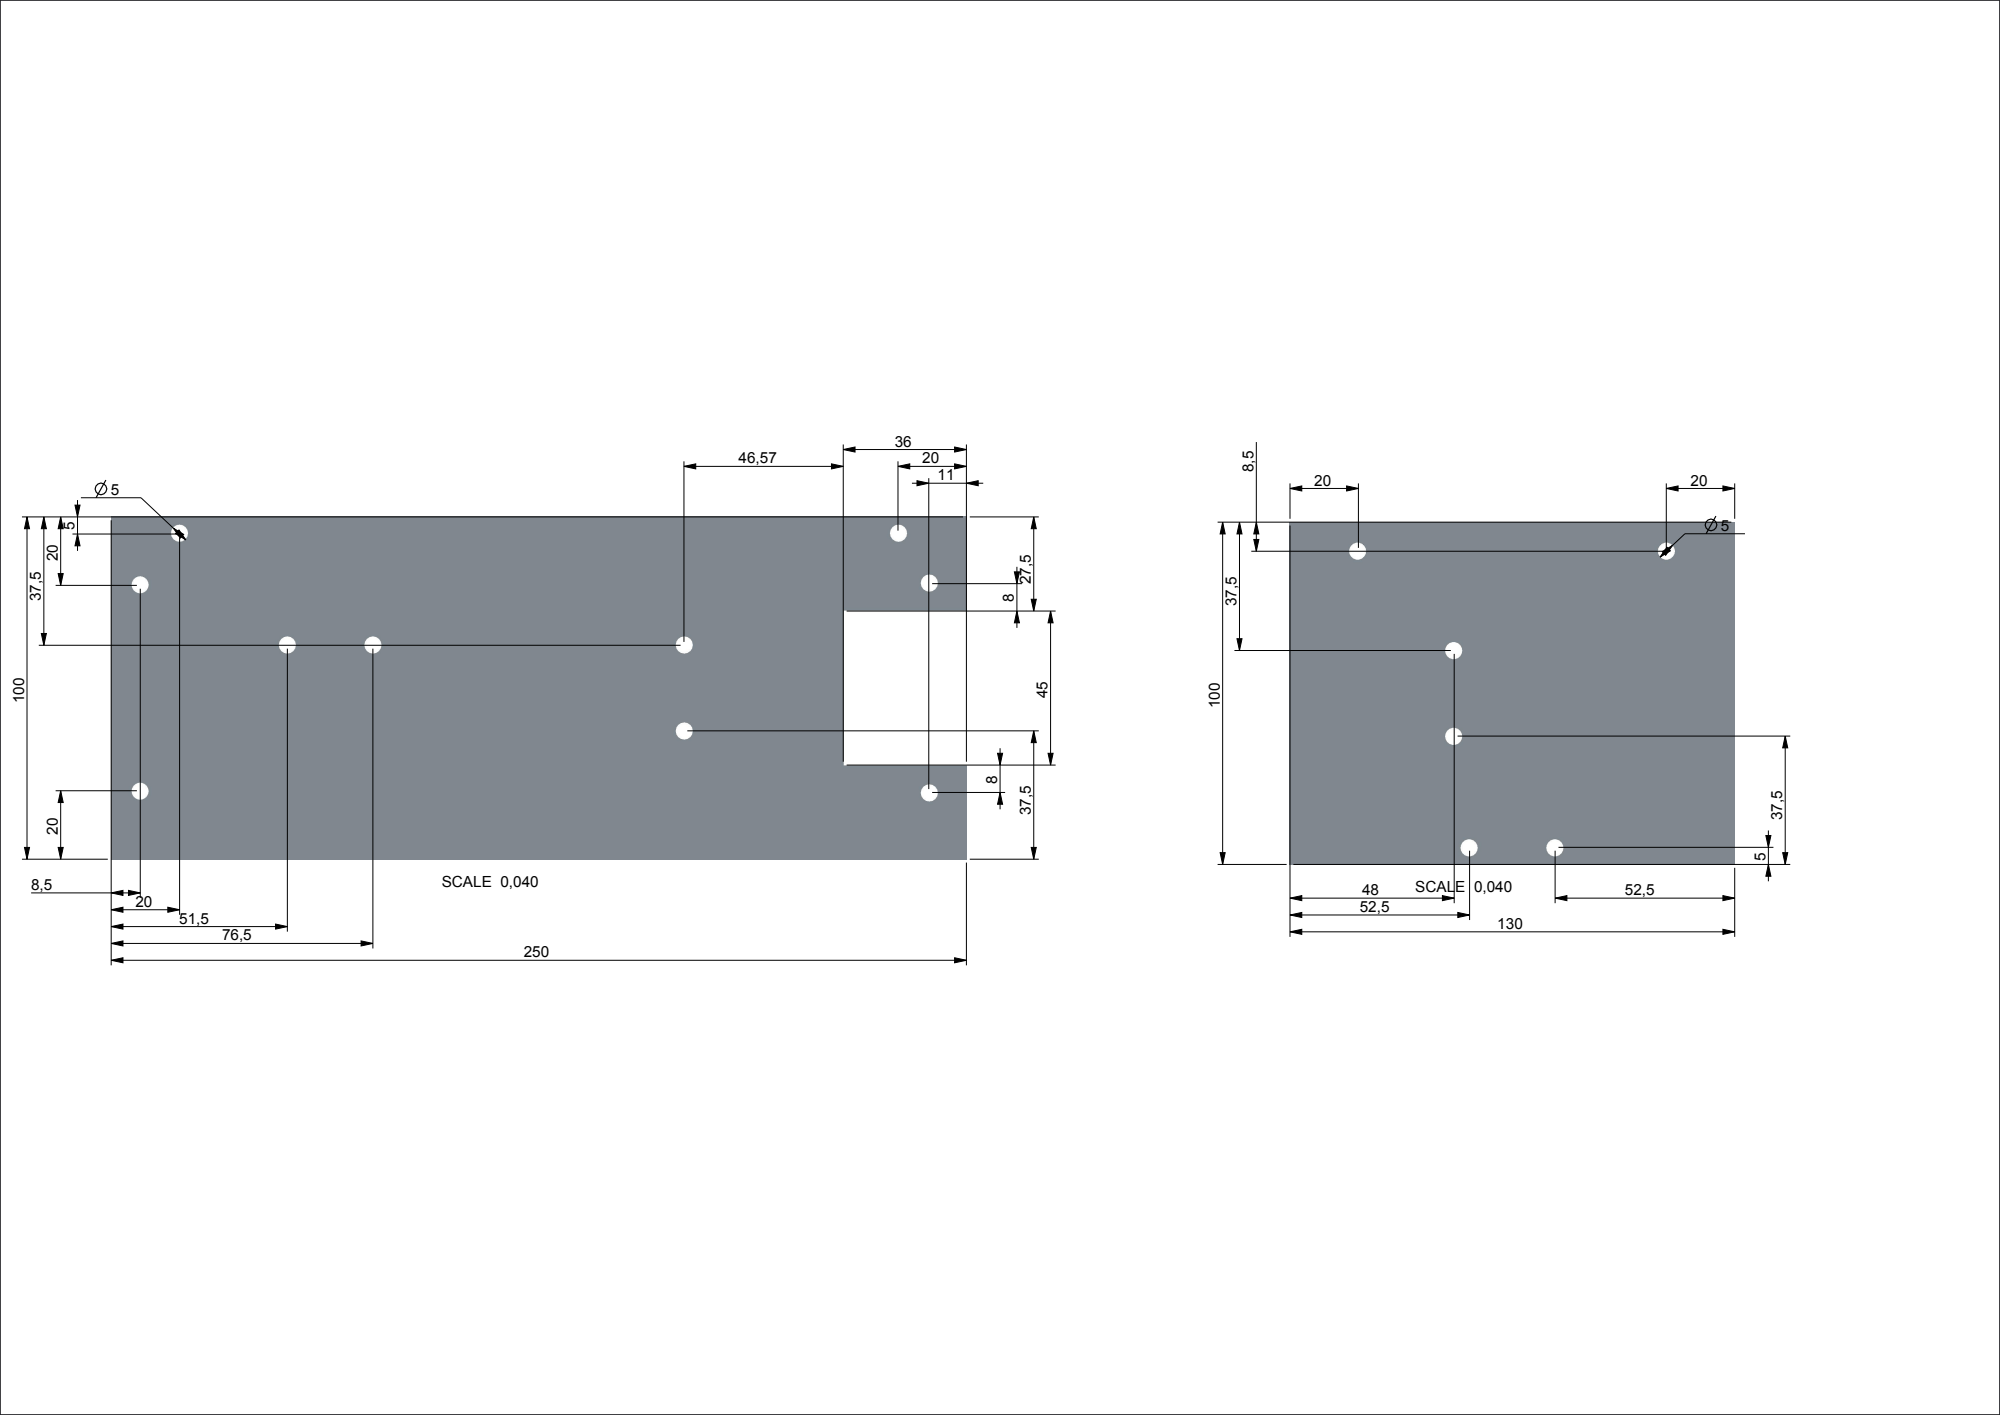
[picture p149: page 4]
SCALE 0,040; SCALE

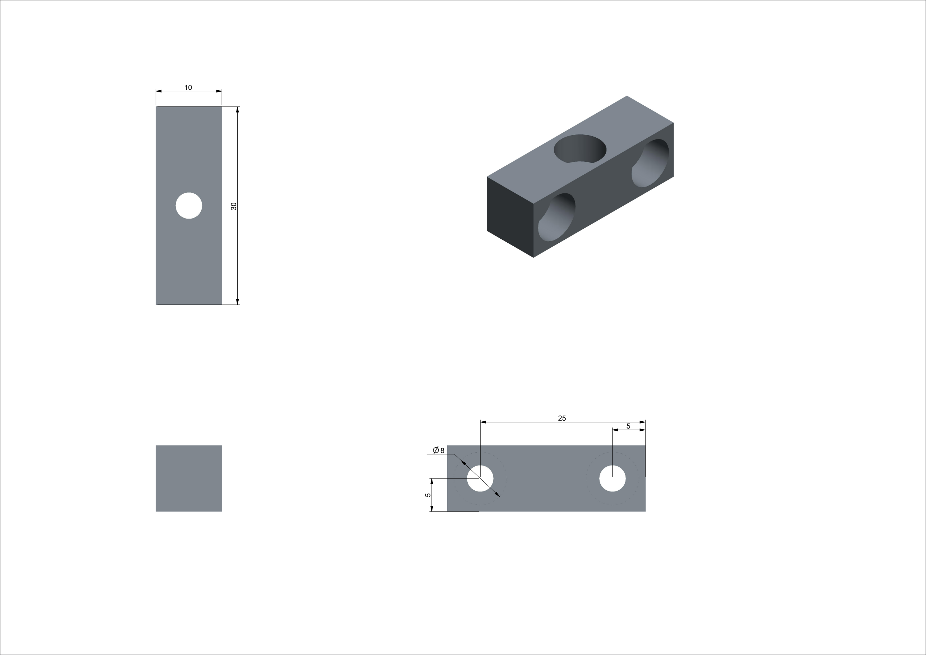
[picture p150: figure]
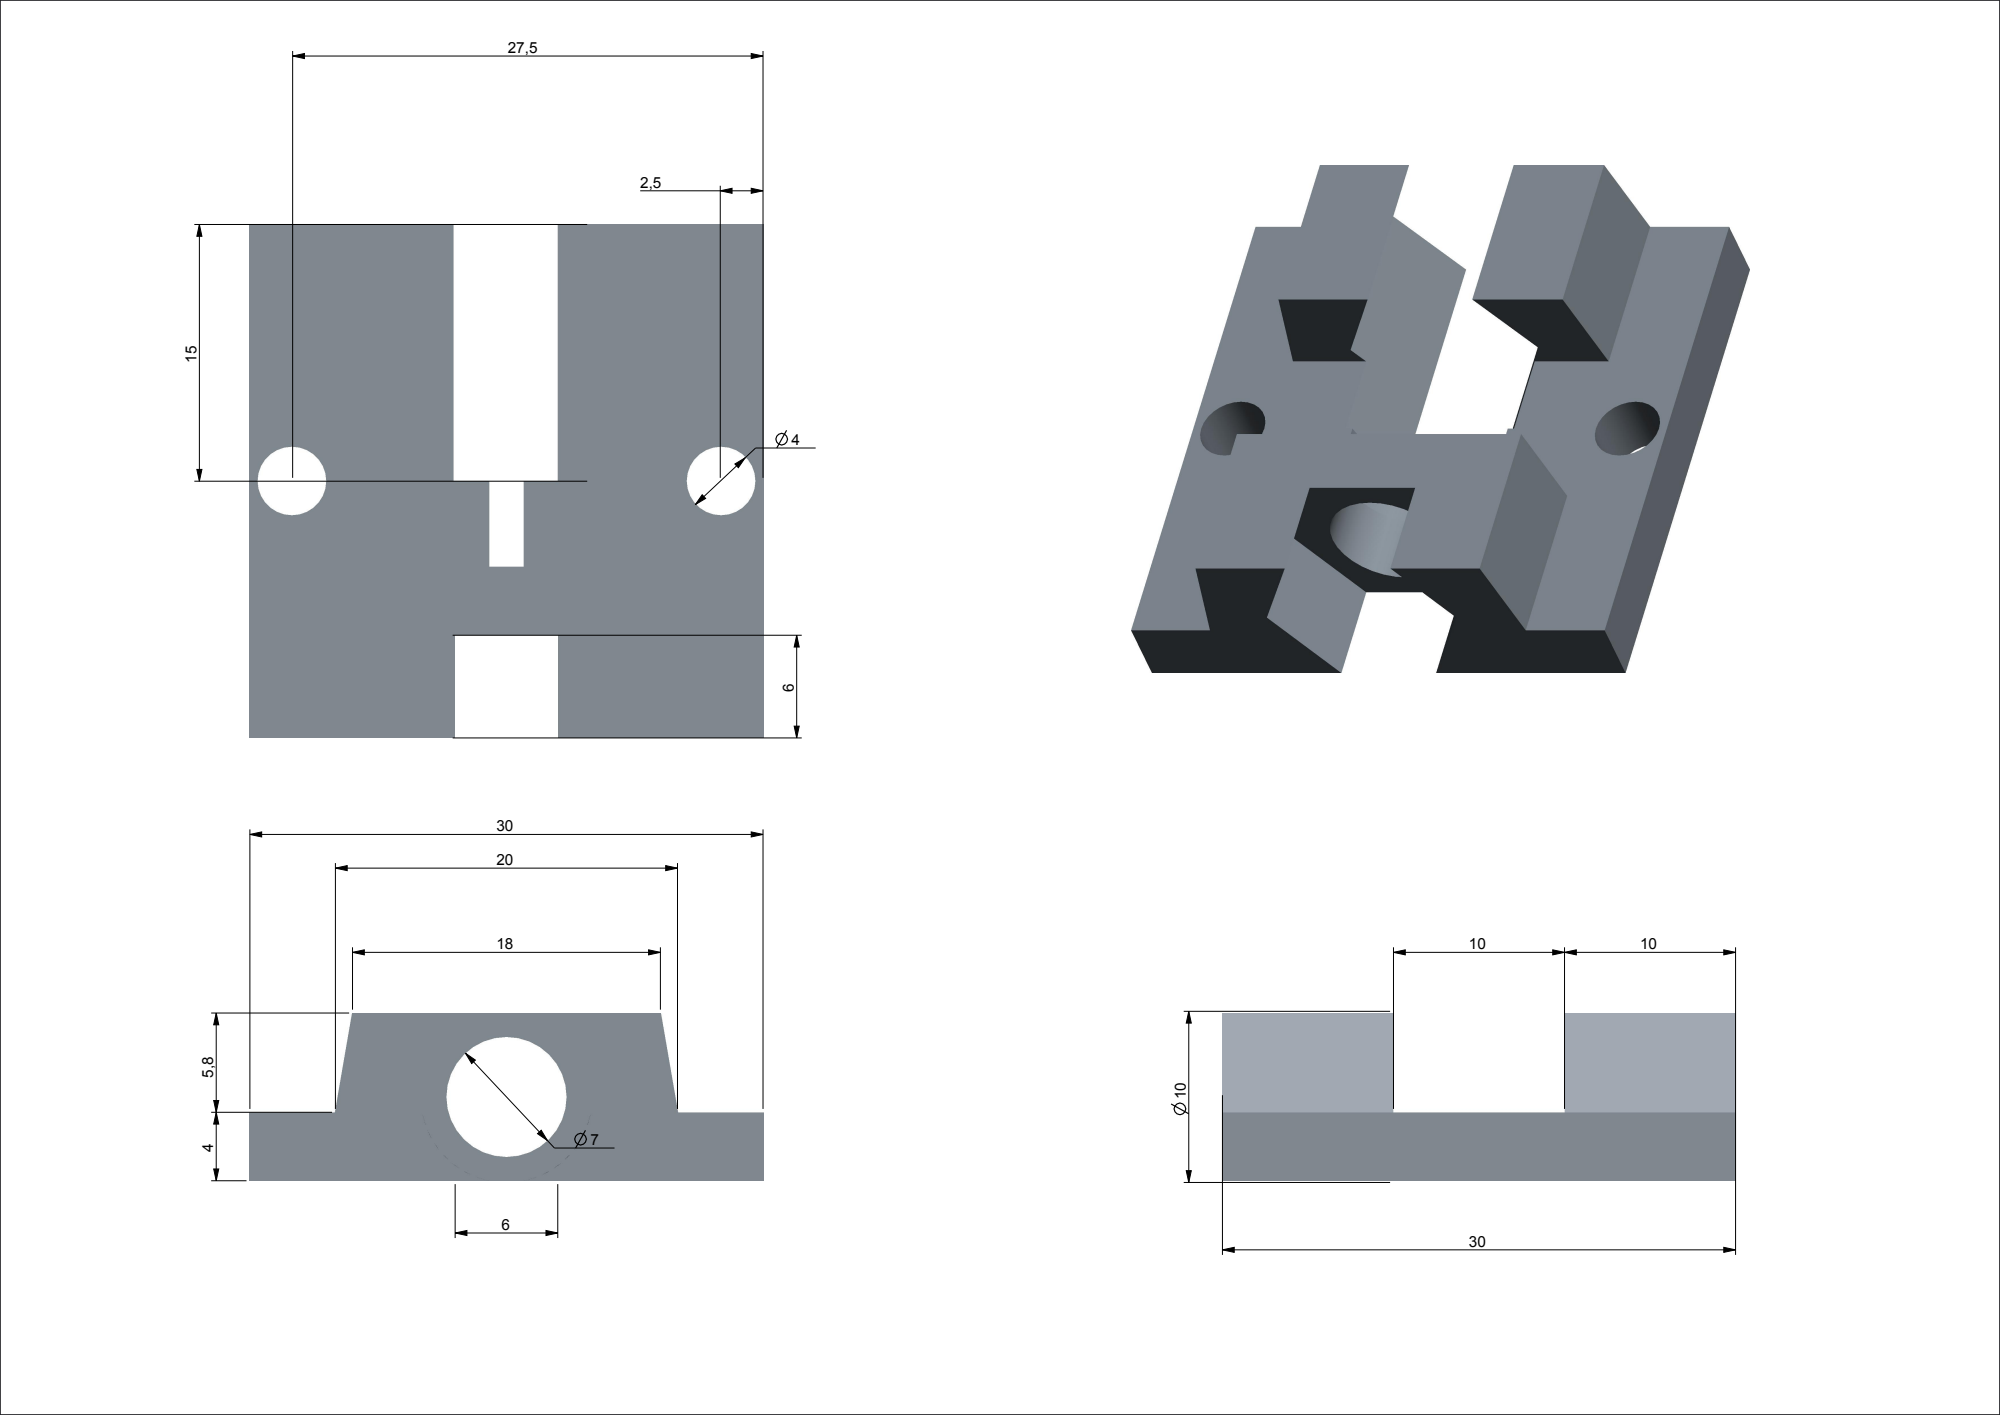
[picture p151: page 6]

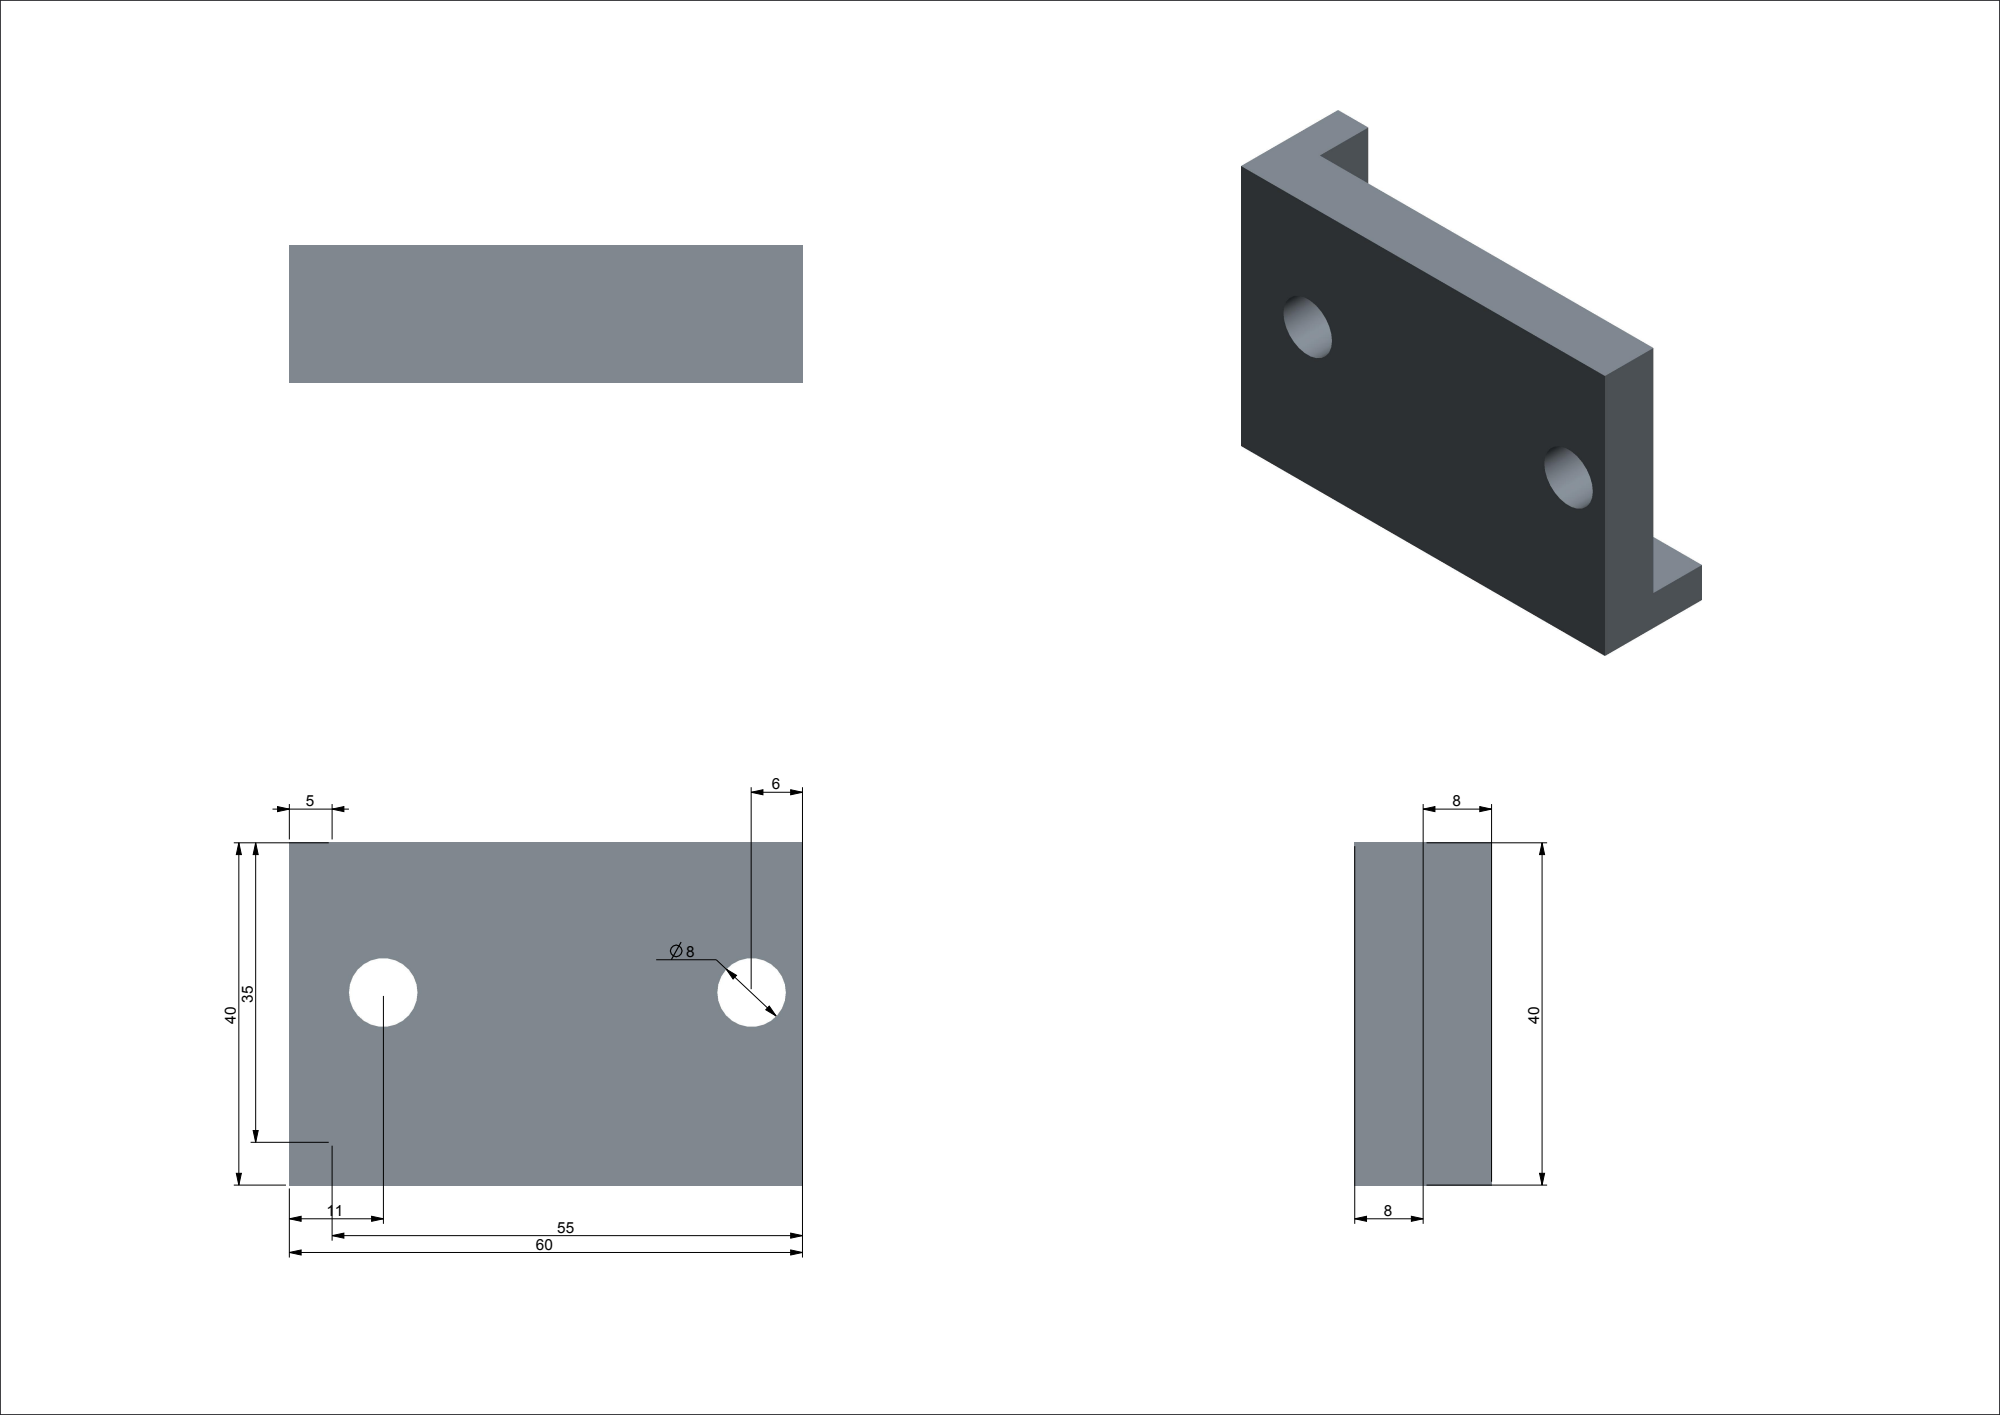
[picture p152: page 7]

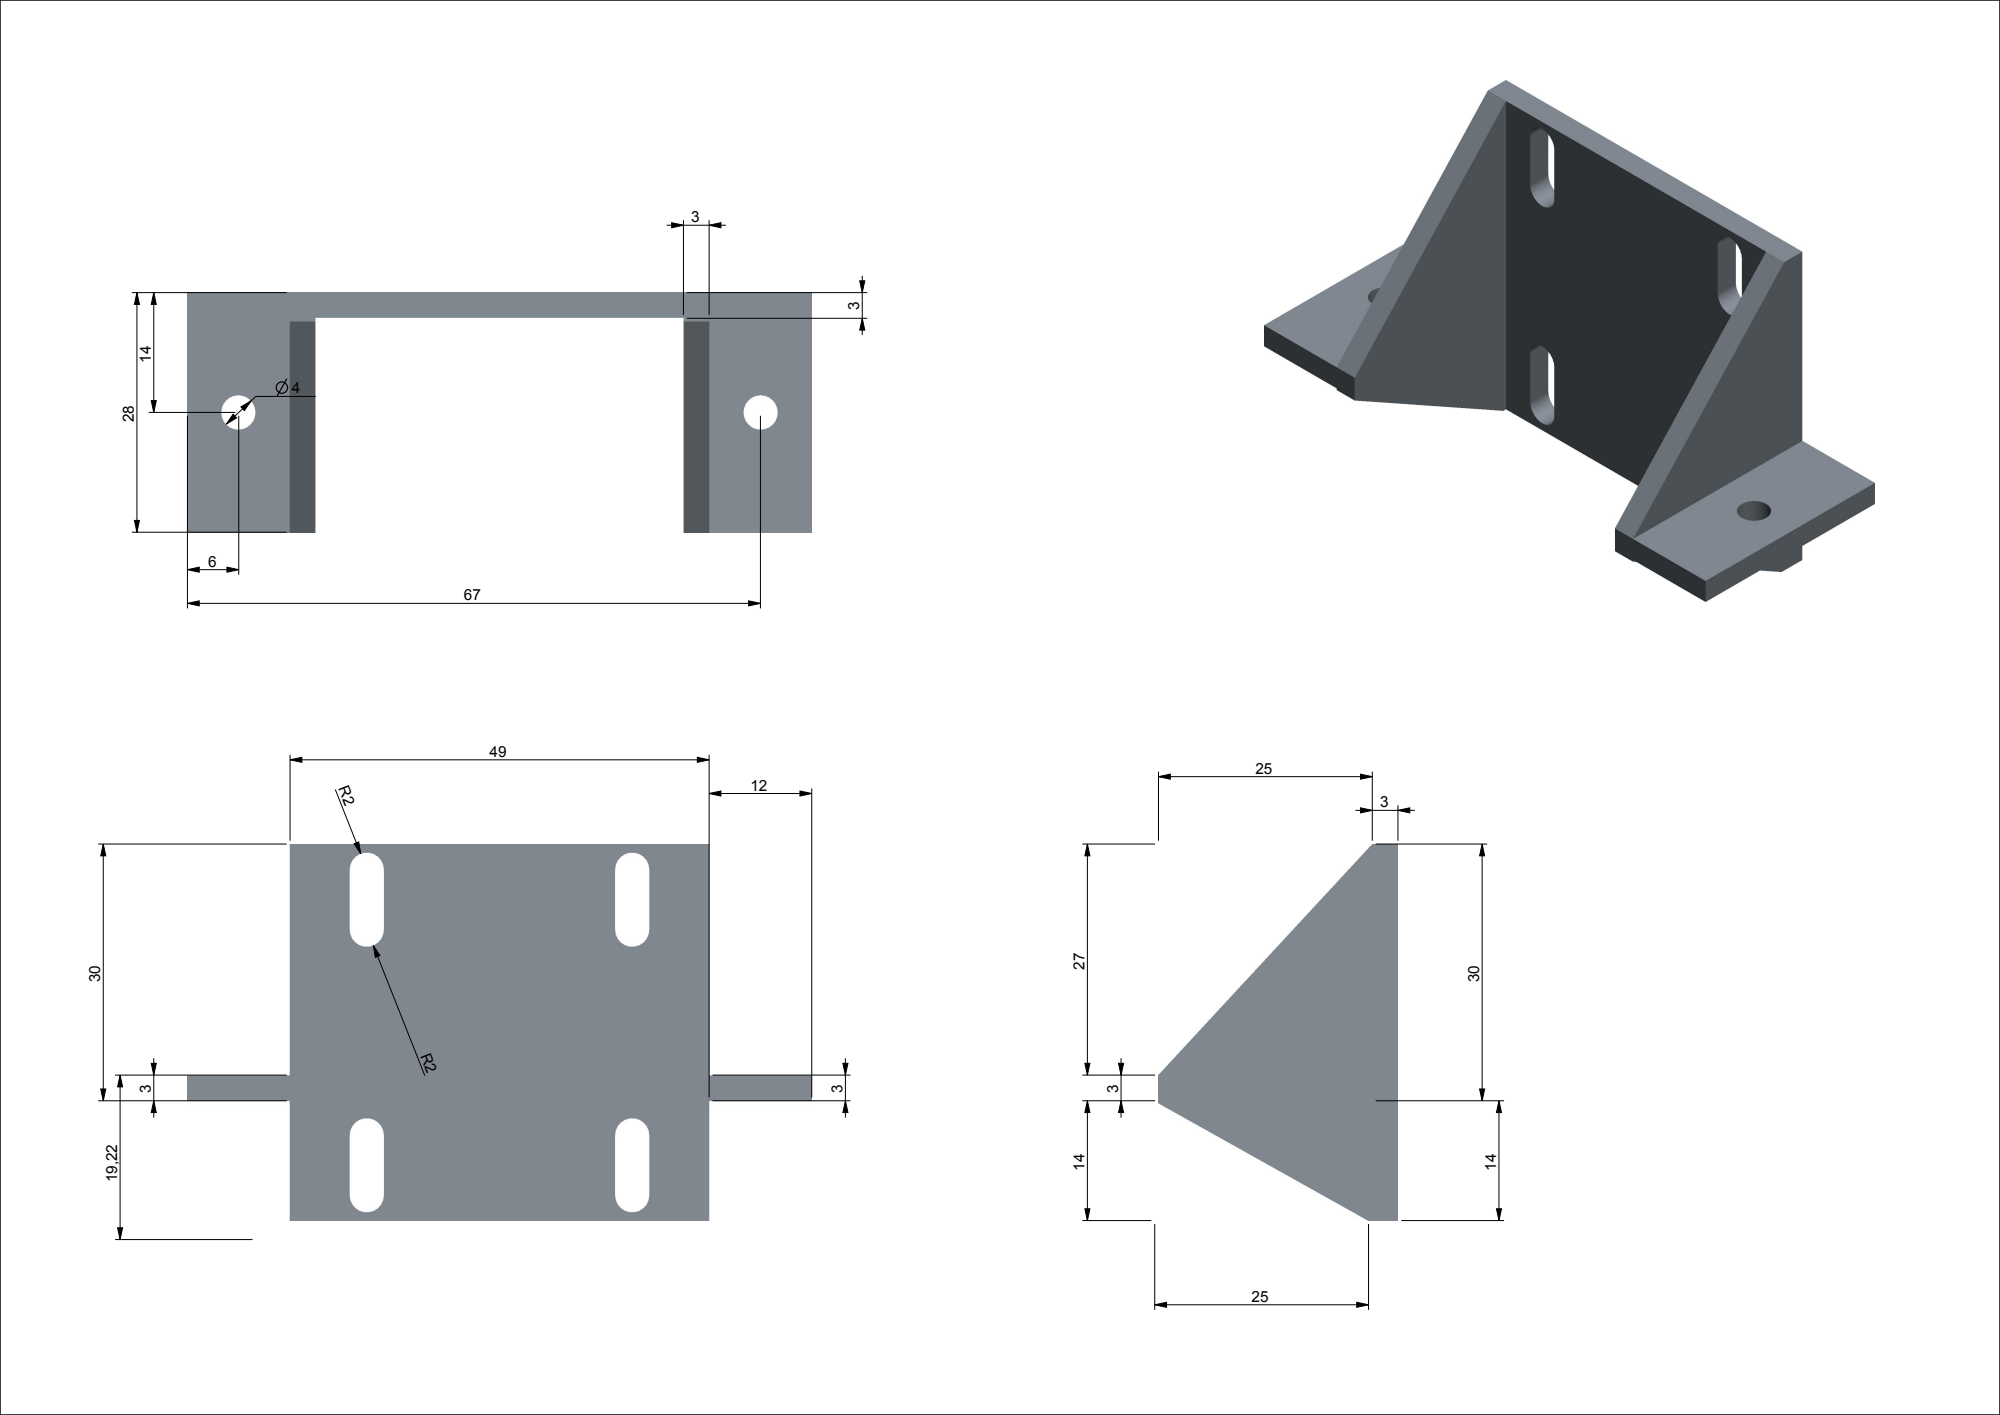
[picture p153: page 8]

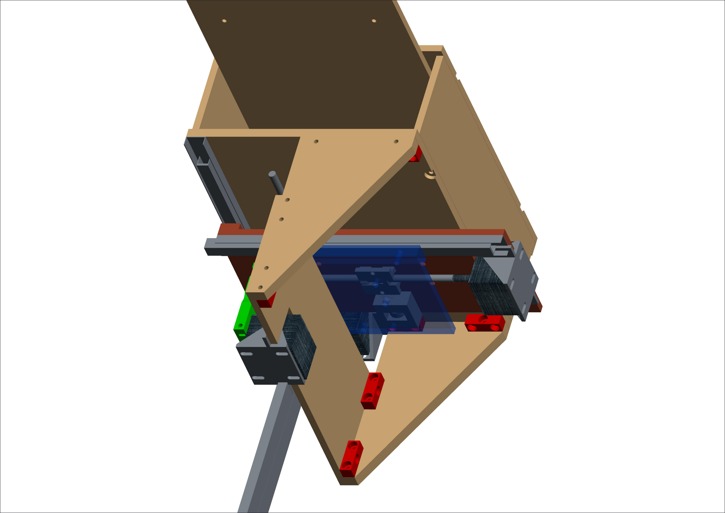
[picture p154: page 9]
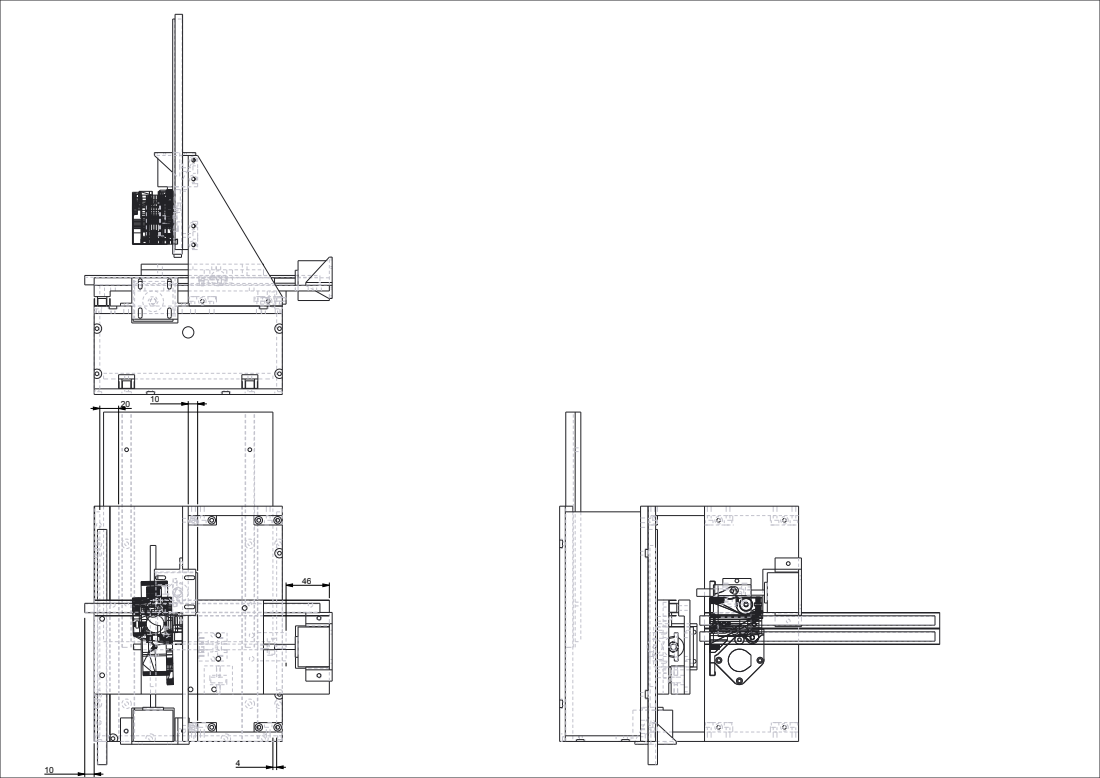
[picture p155: page 10]

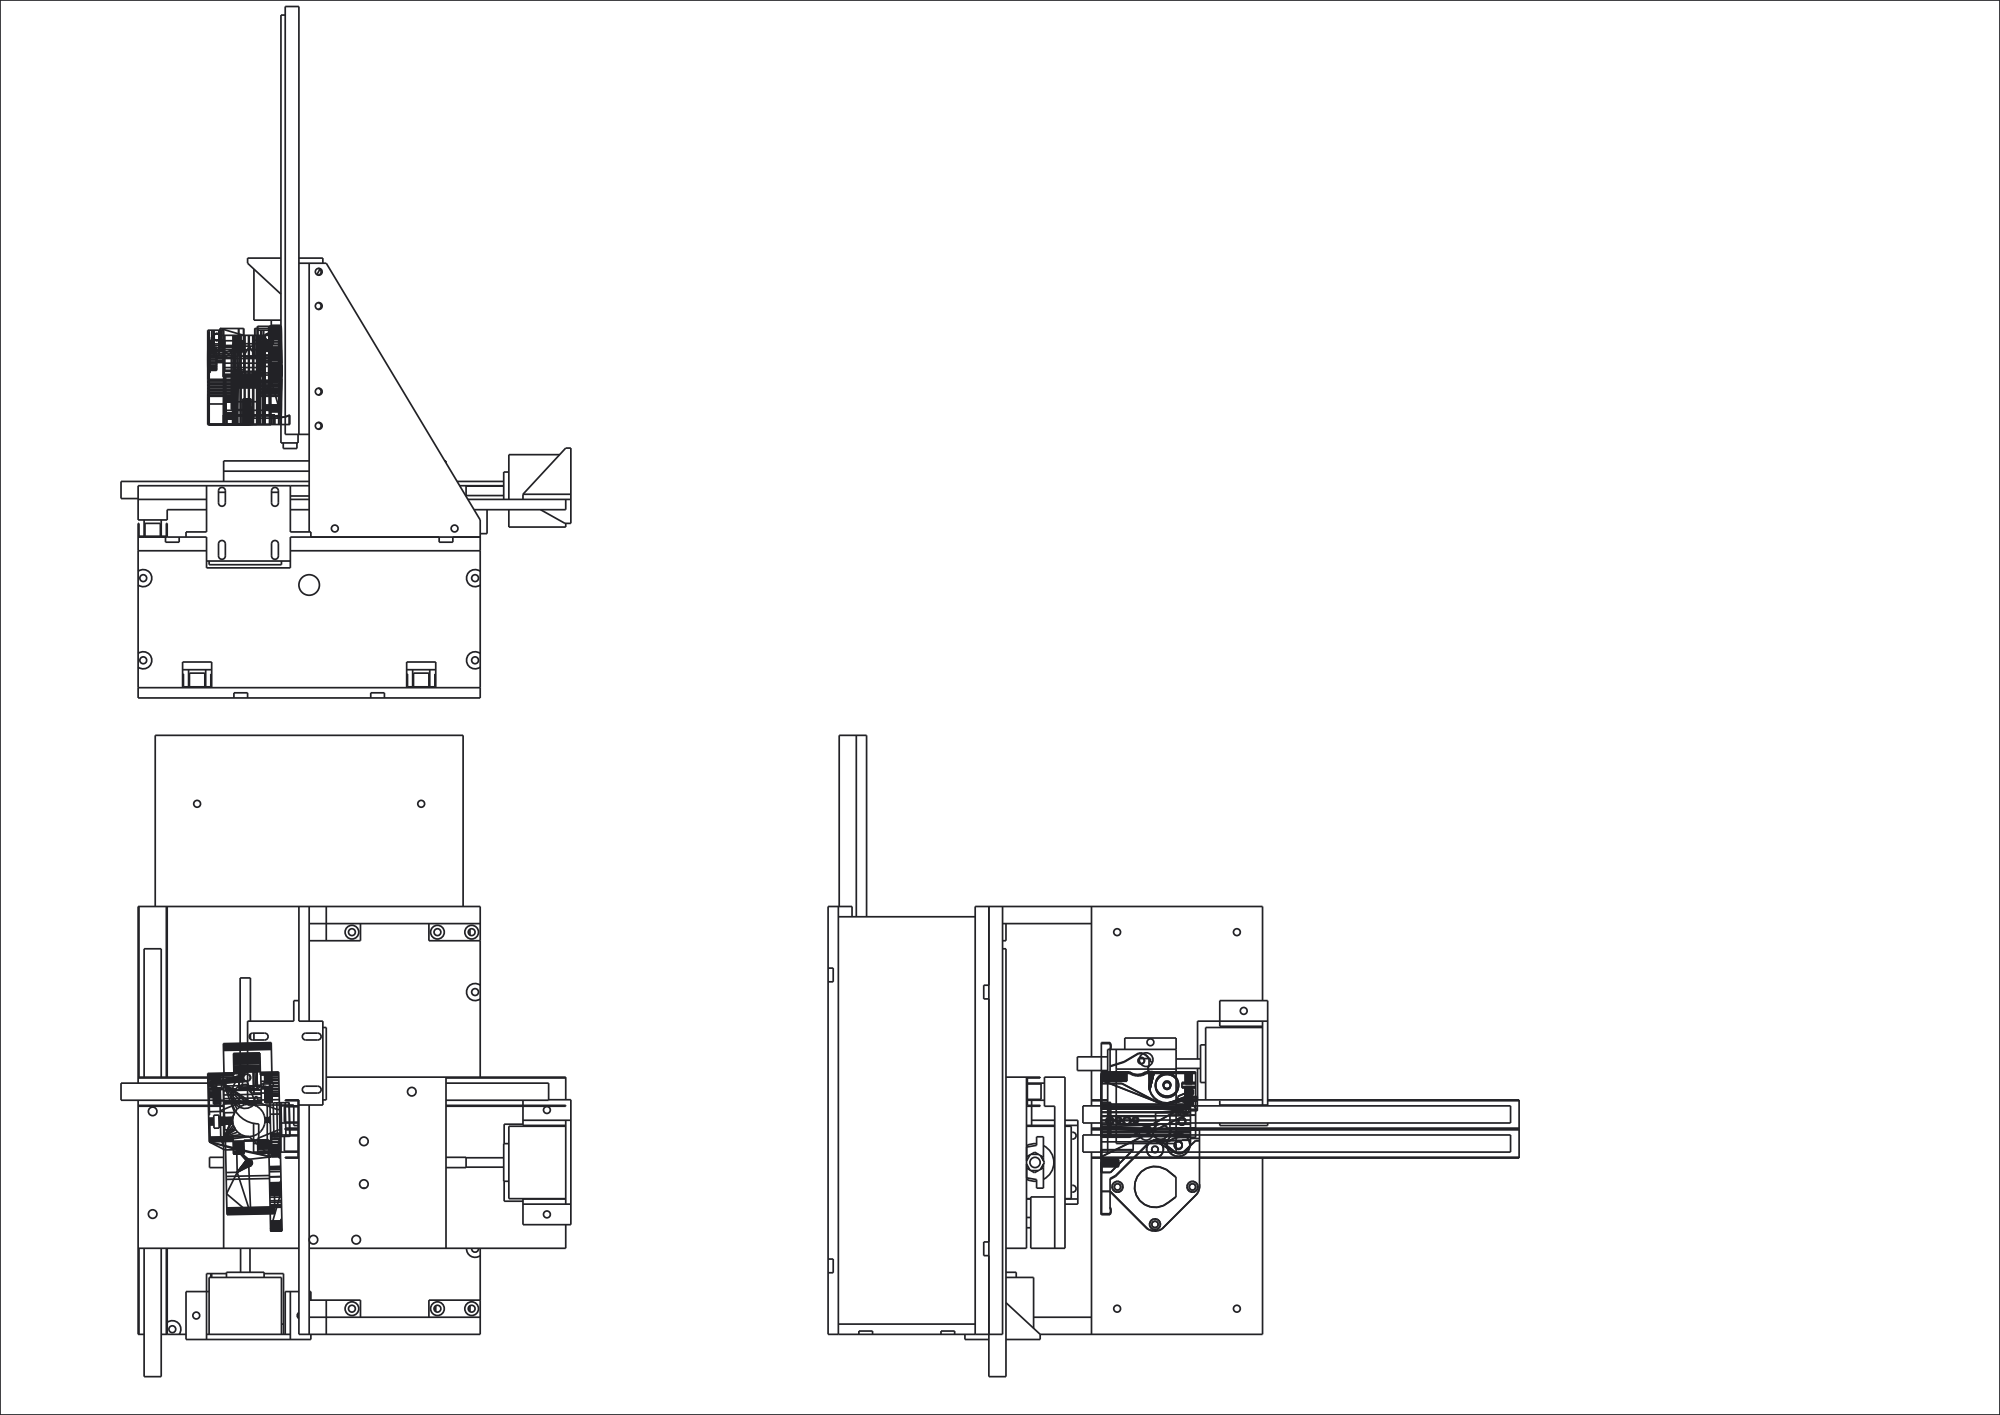
[picture p156: page 11]
