JamesGlanville/solderingmachine/parts/creo/gad3.pdf

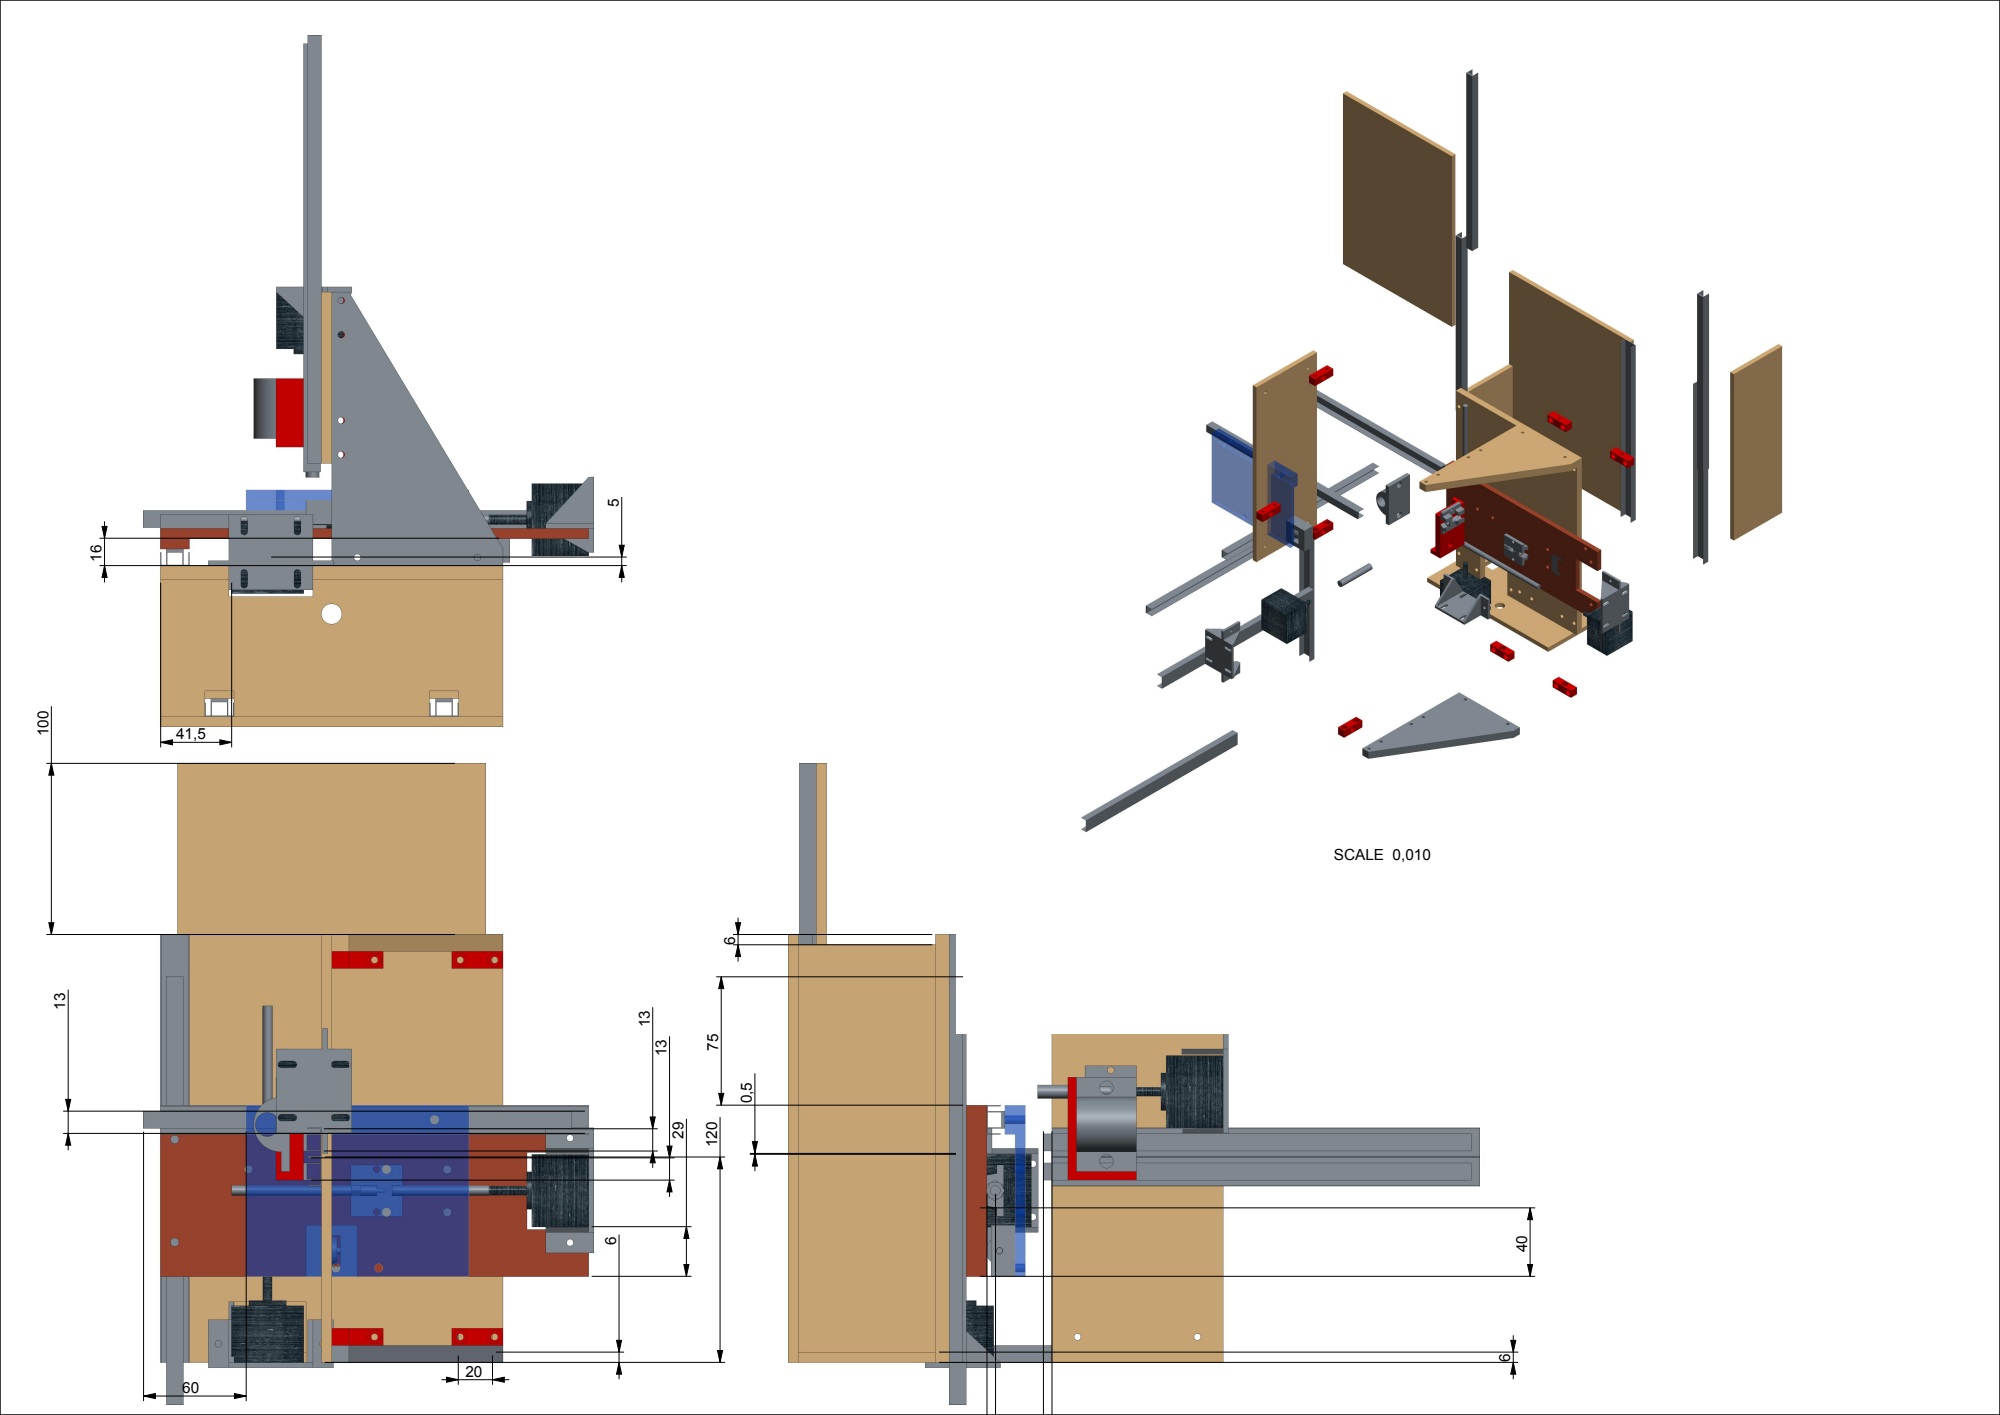
[picture p157: page 1]
SCALE 0,010

SCALE; SCALE 0,040; SCALE 0,040 SCALE 0,040

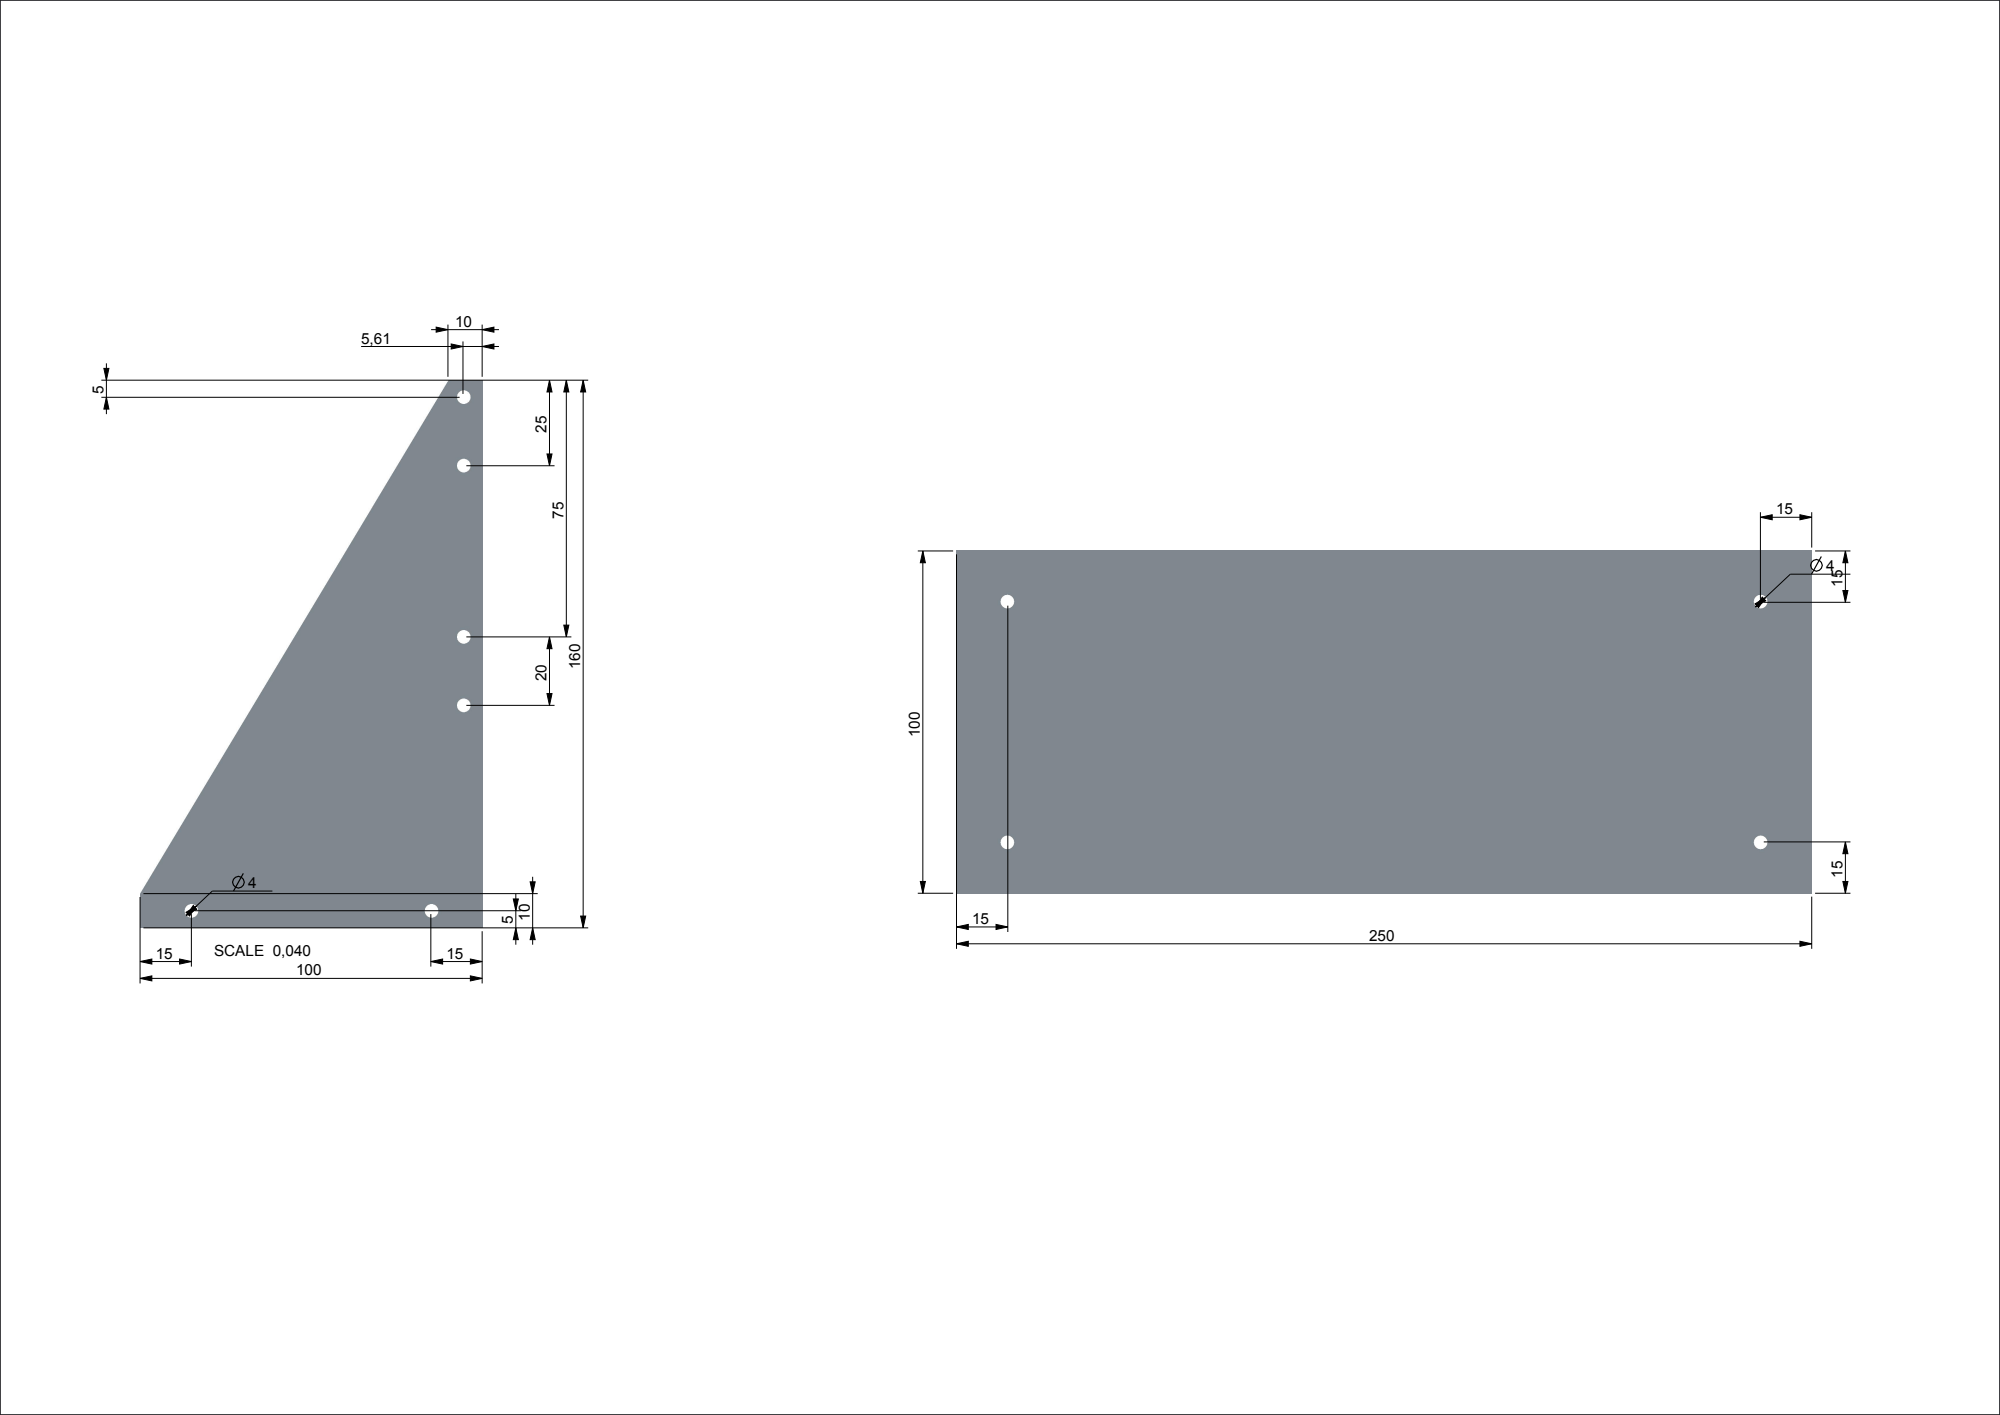
[picture p158: page 3]
SCALE 0,040

SCALE 0,040; SCALE
