JamesGlanville/solderingmachine/parts/creo/gad2.pdf

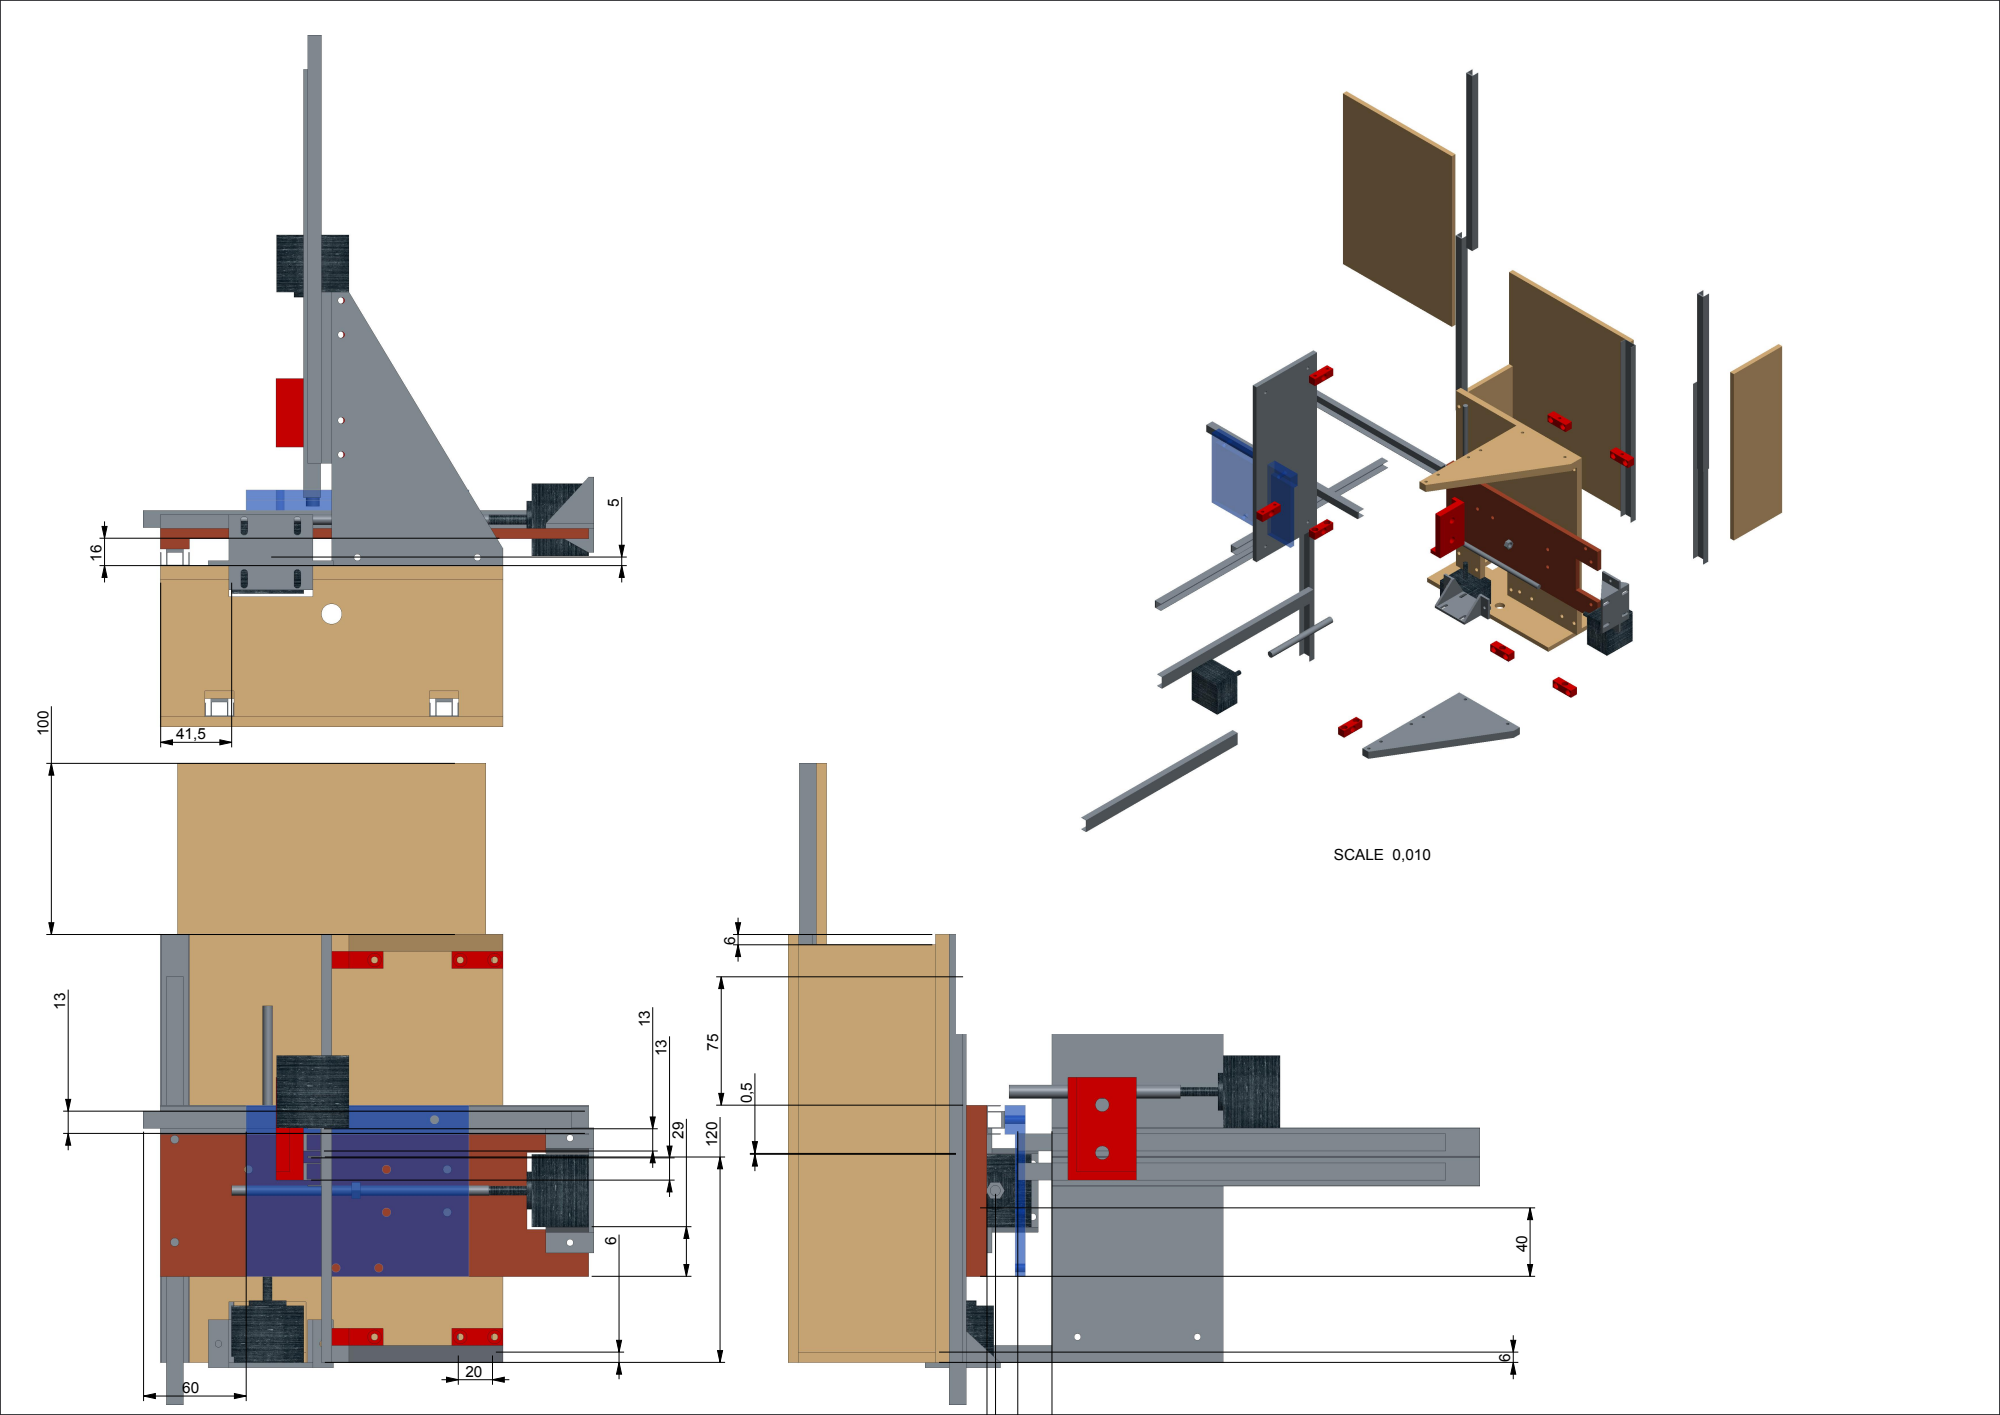
[picture p159: page 1]
SCALE 0,010

SCALE; SCALE 0,040; SCALE 0,040 SCALE 0,040

SCALE 0,040

SCALE 0,040; SCALE


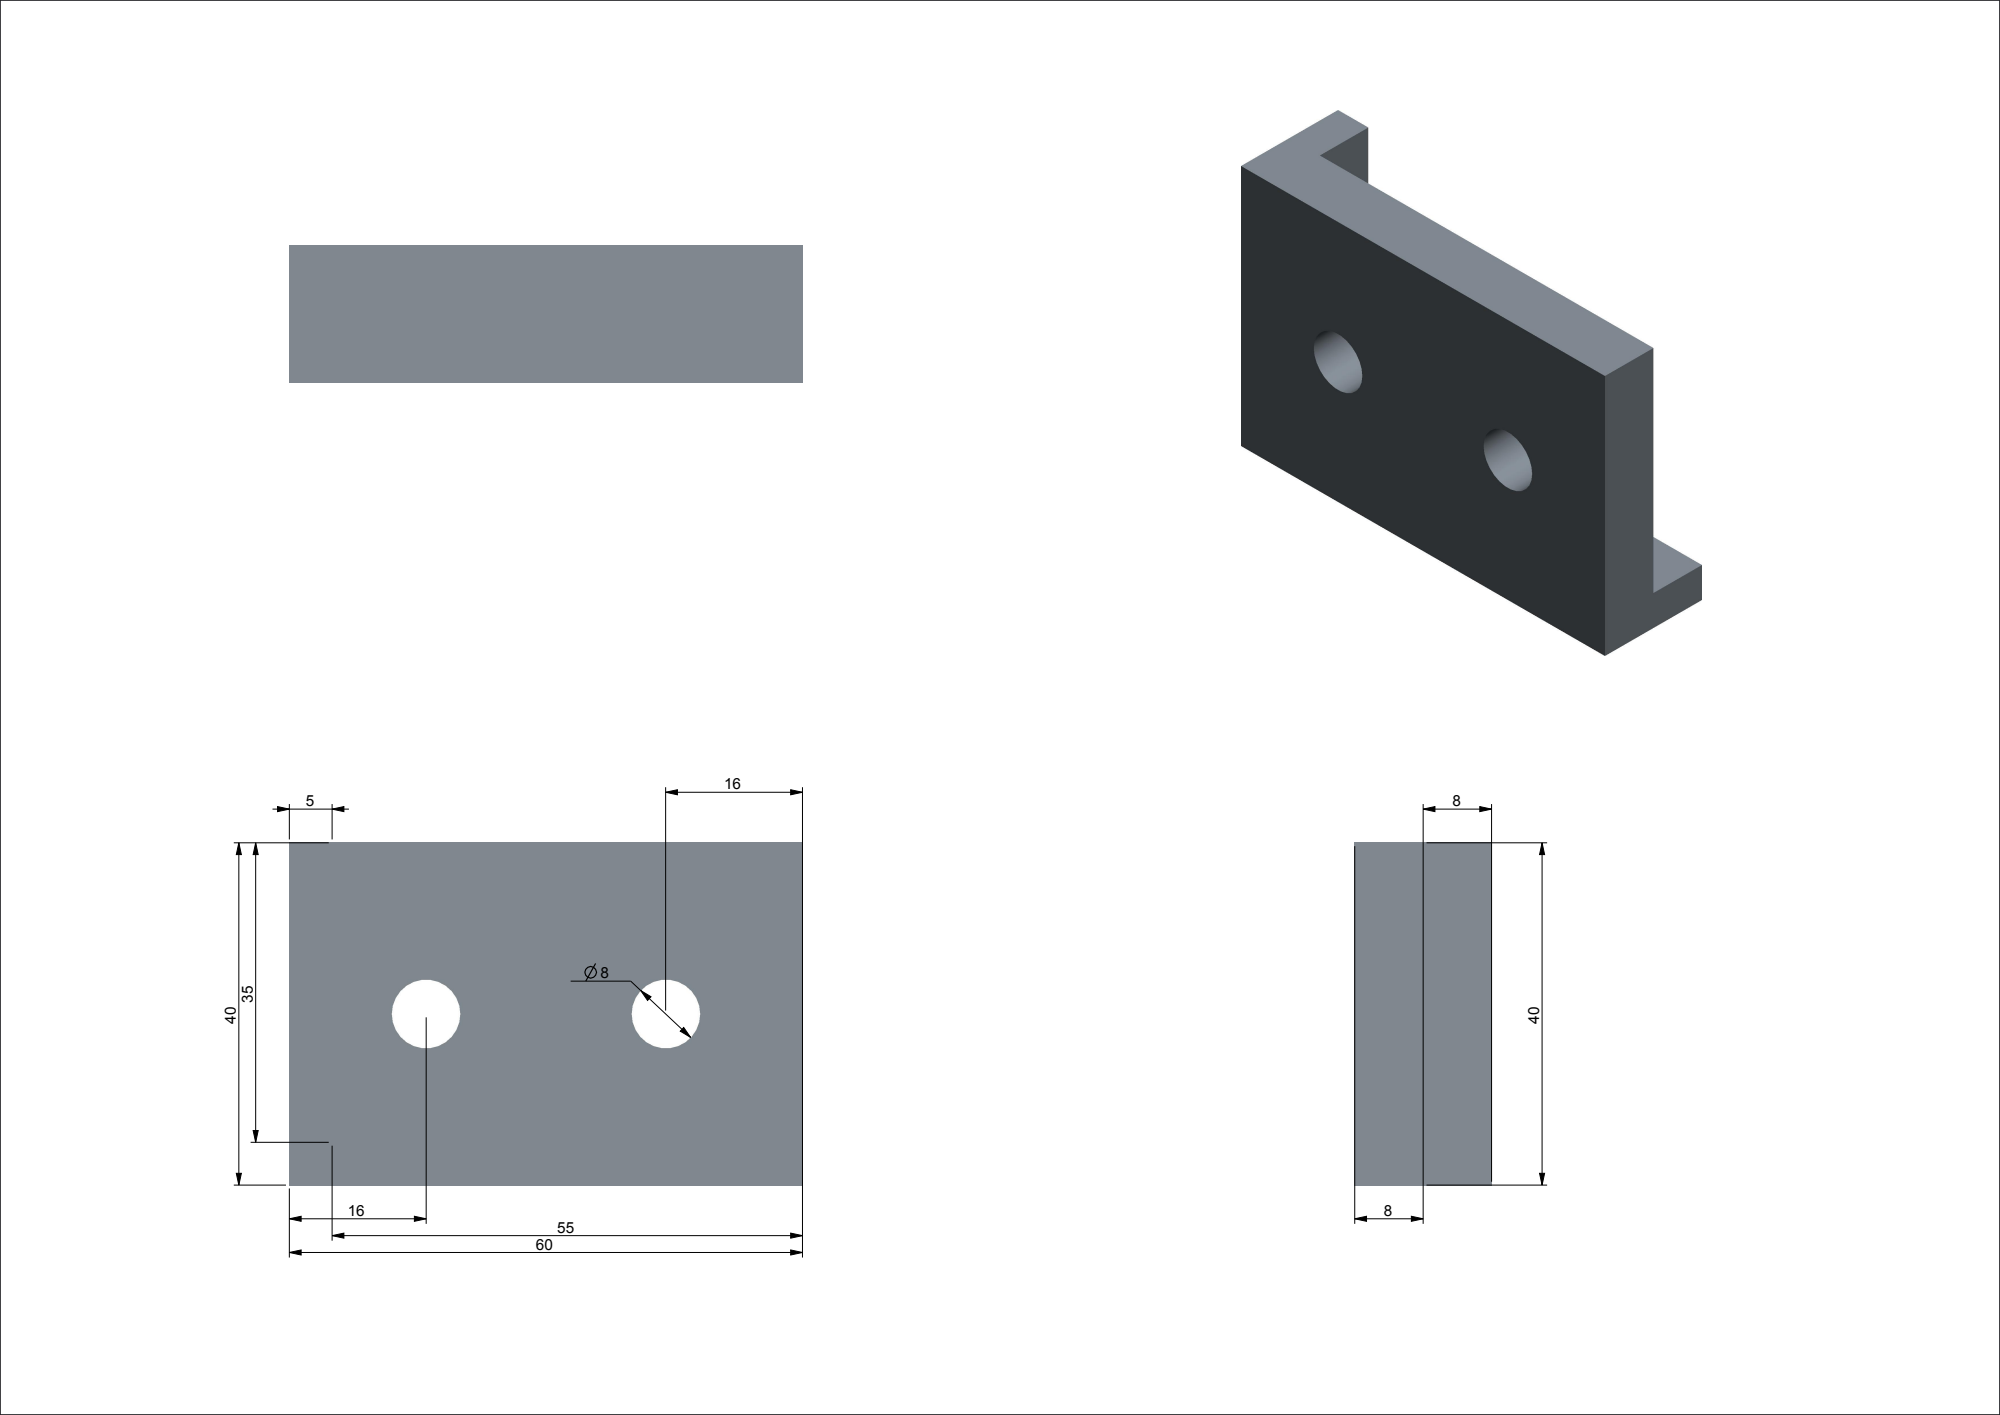
[picture p160: page 7]
