JamesGlanville/solderingmachine/parts/creo/machine.pdf

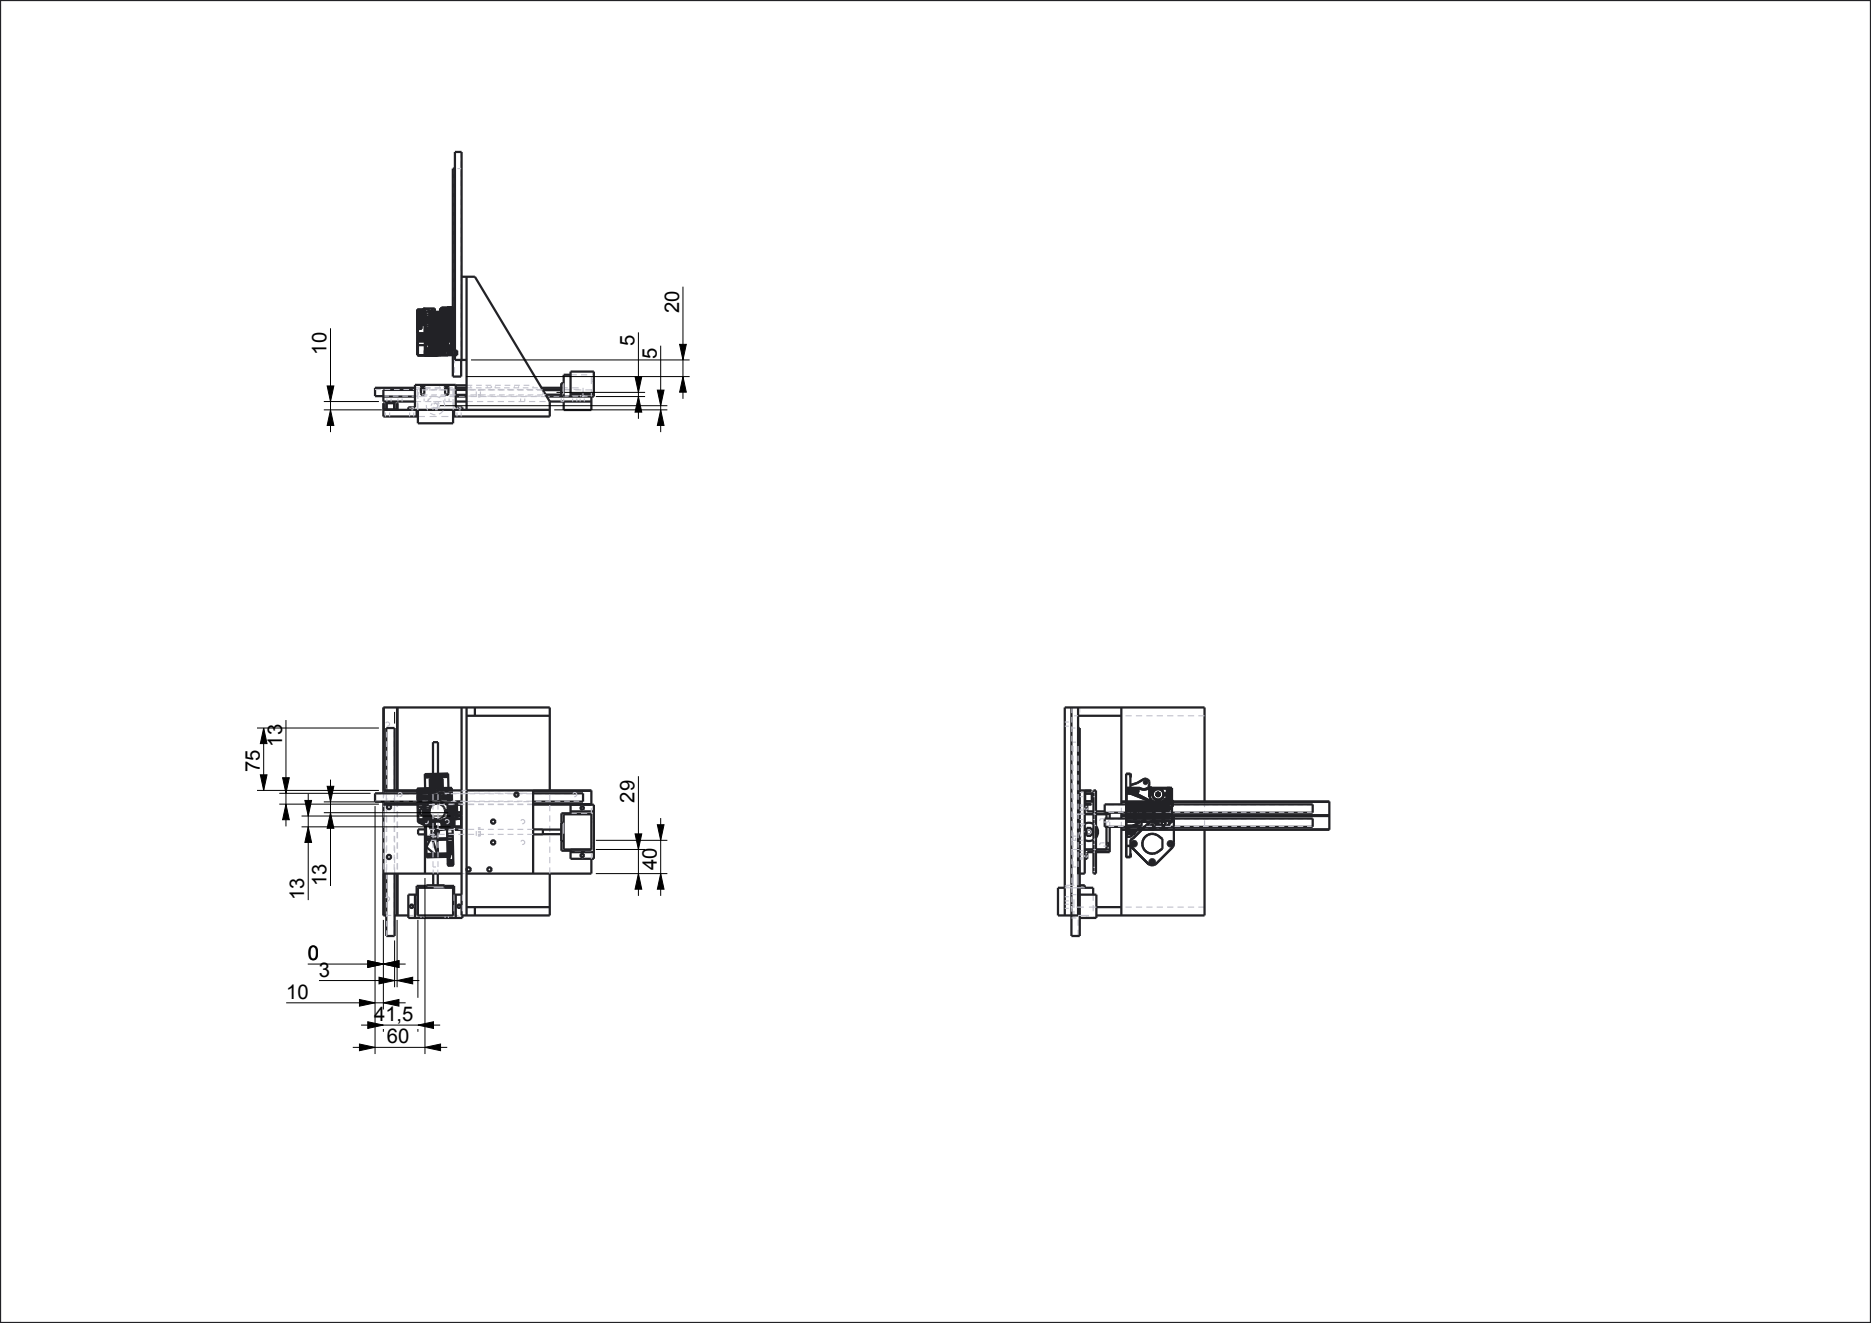
[picture p161: page 1]
