JamesGlanville/solderingmachine/parts/creo/nuttrap.pdf

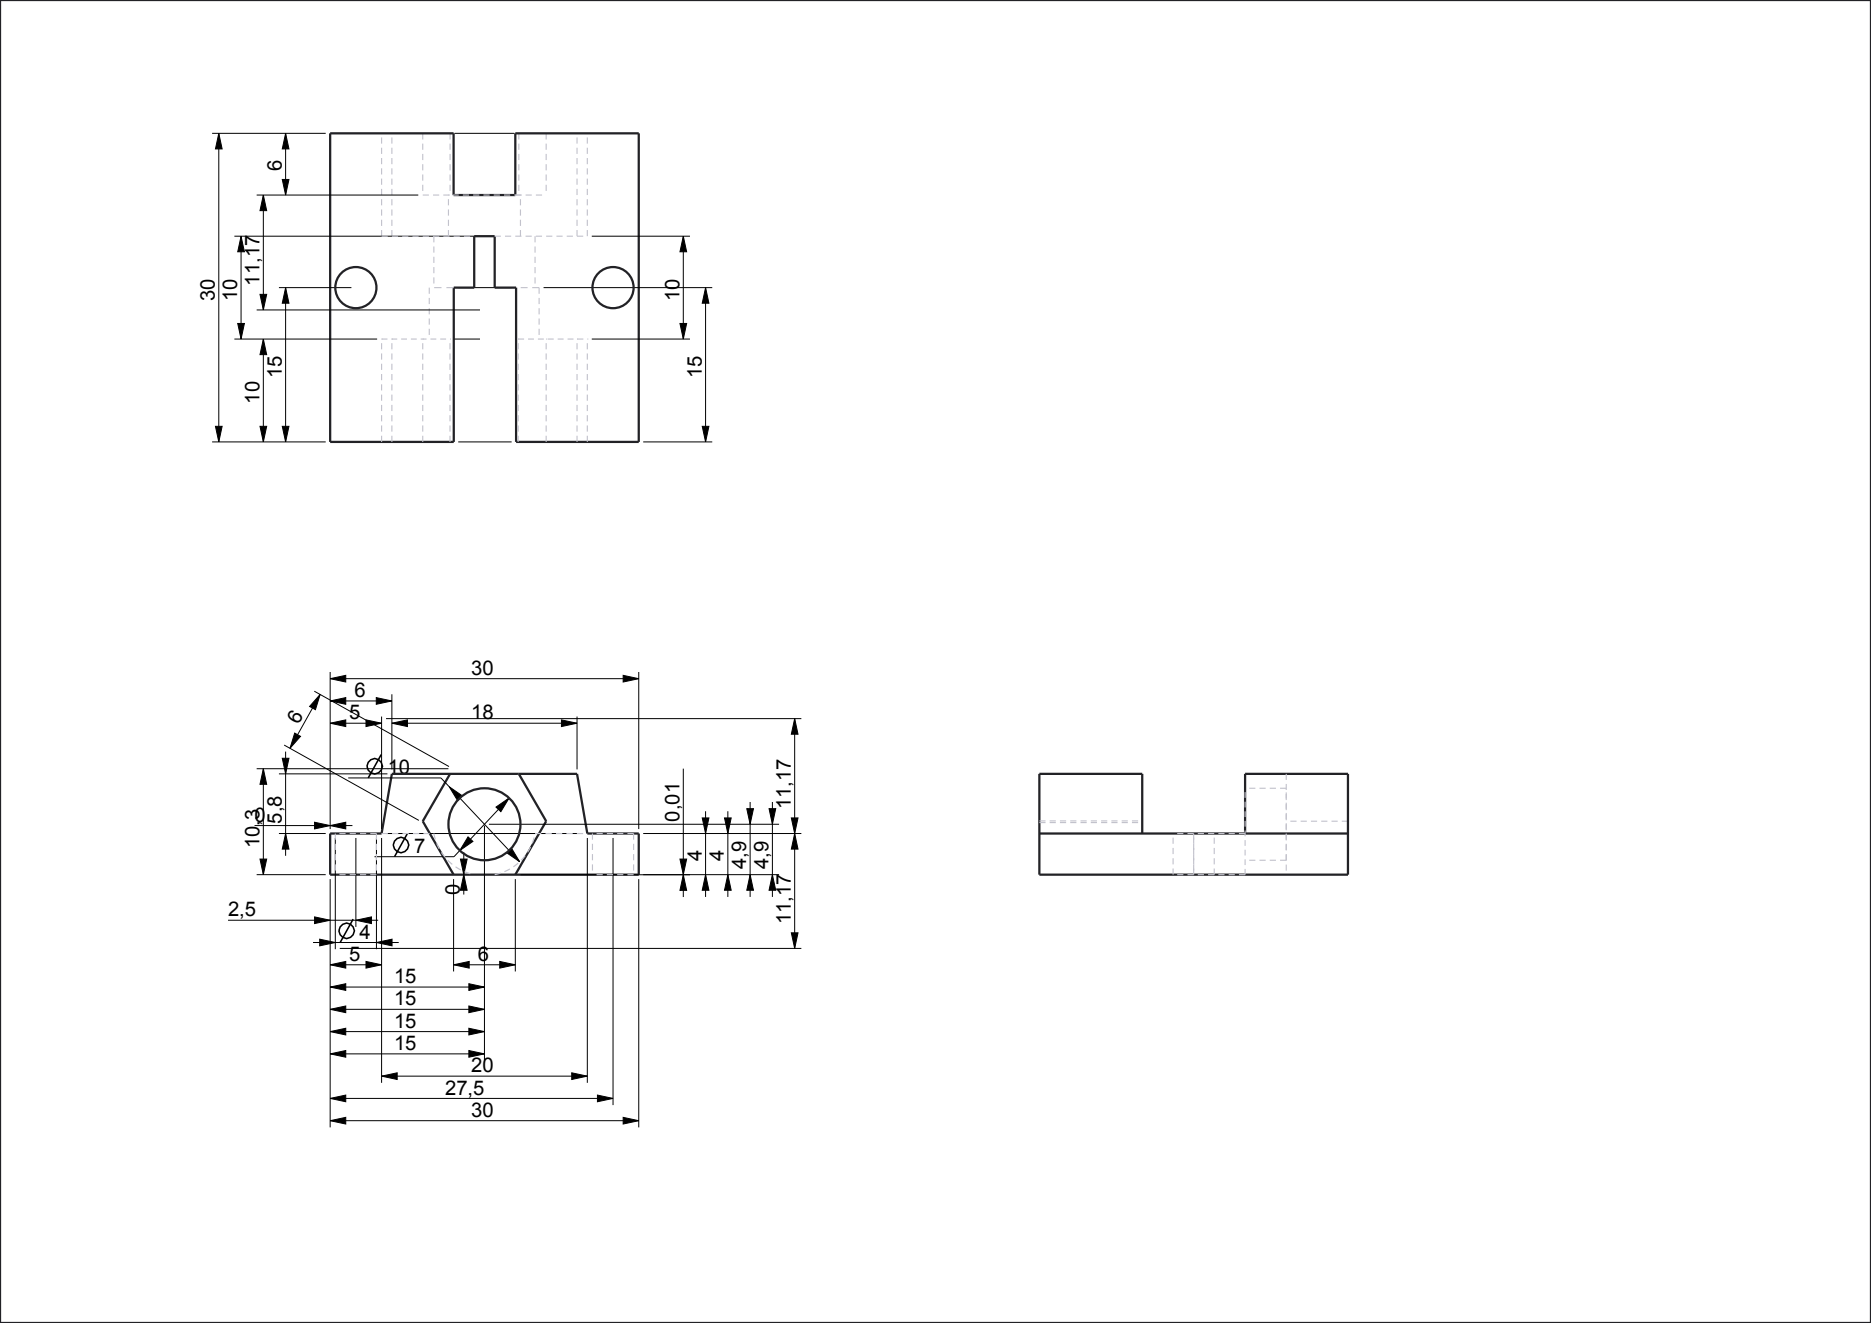
[picture p162: page 1]

15
