JamesGlanville/solderingmachine/parts/creo/old/base_board.pdf

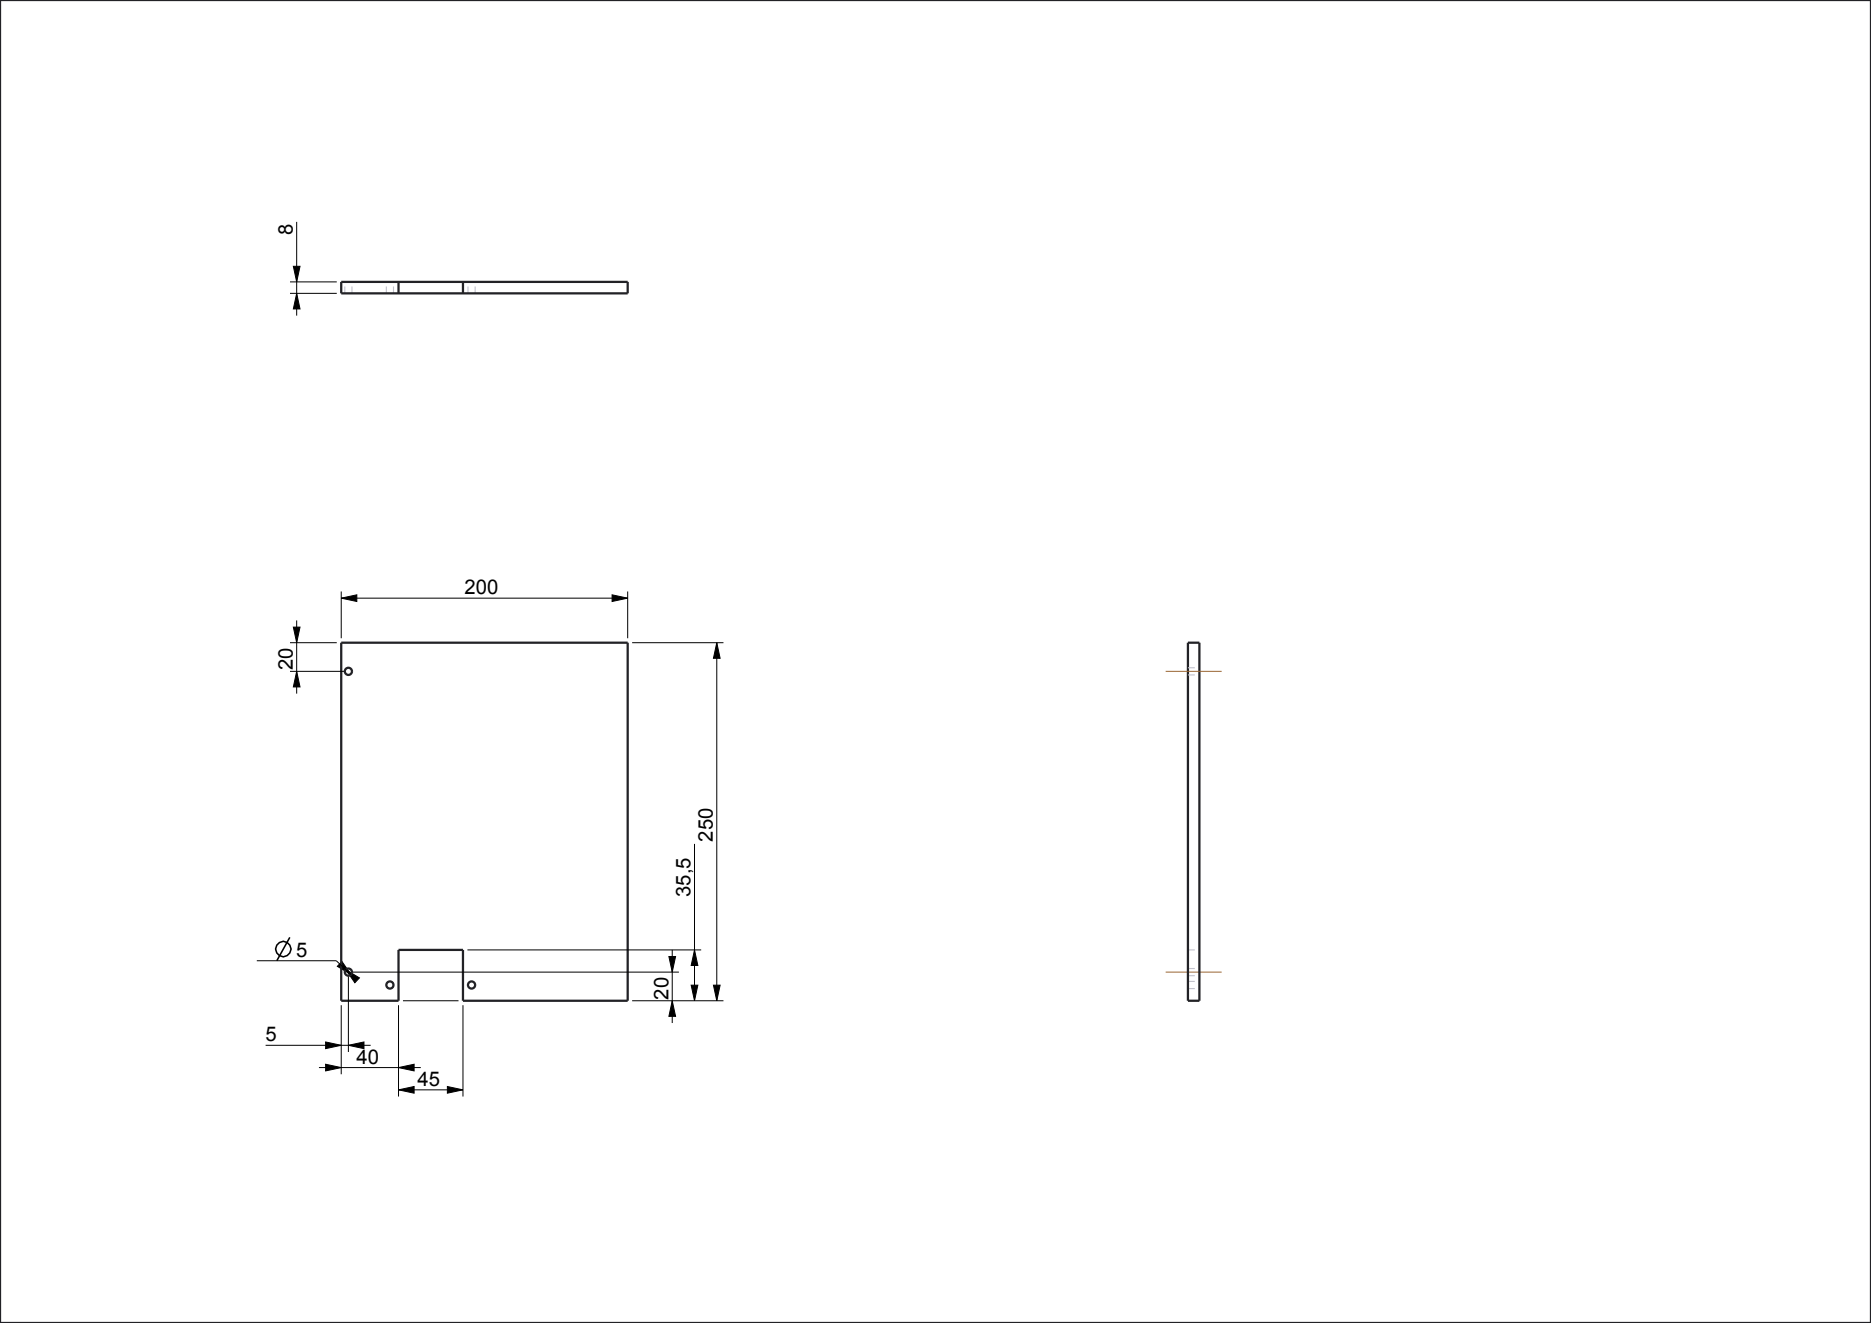
[picture p163: page 1]
