JamesGlanville/solderingmachine/parts/creo/old/bed.pdf

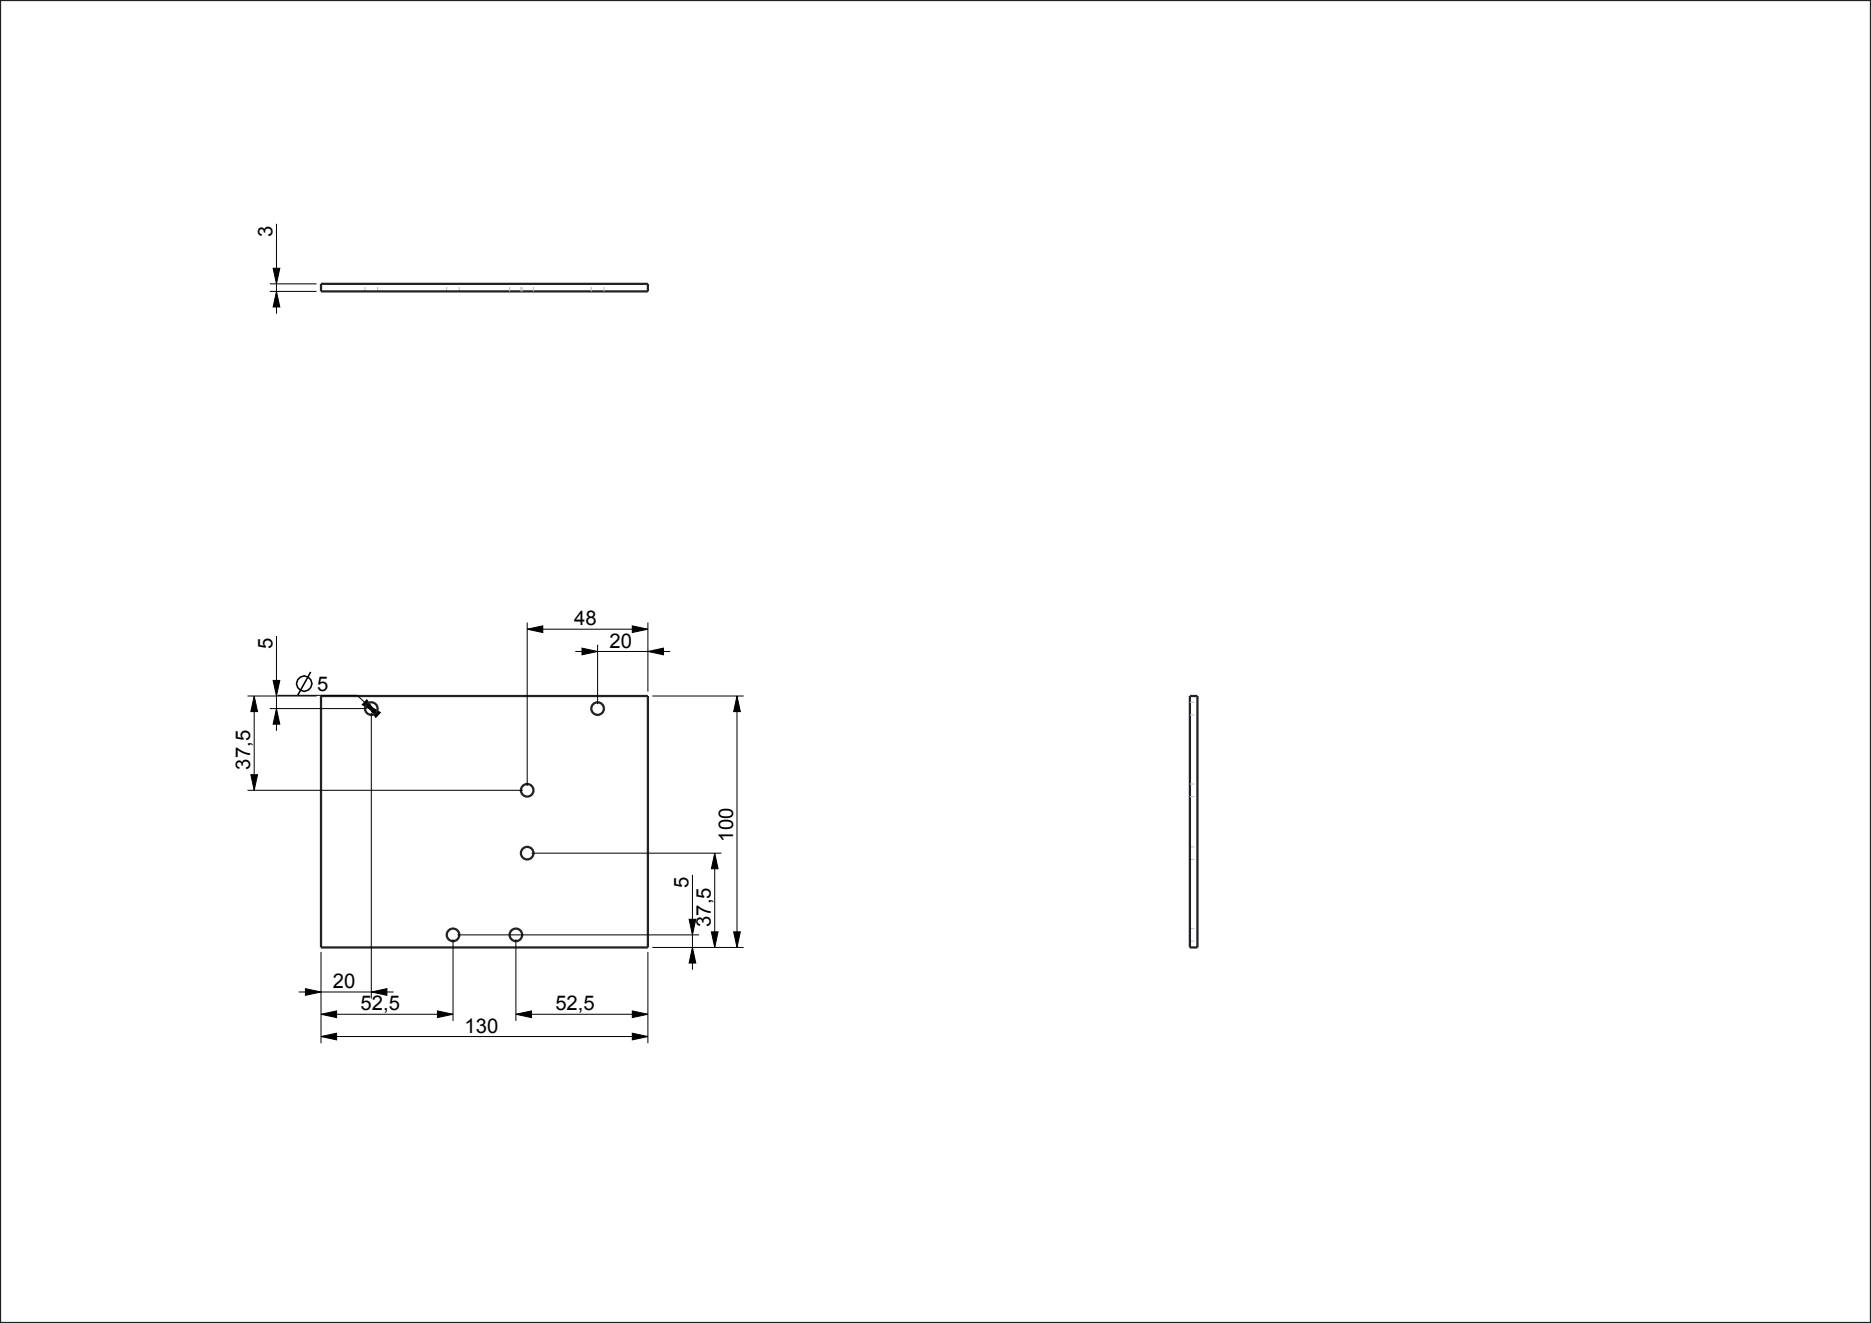
[picture p164: page 1]
