JamesGlanville/solderingmachine/parts/creo/old/topboard.pdf

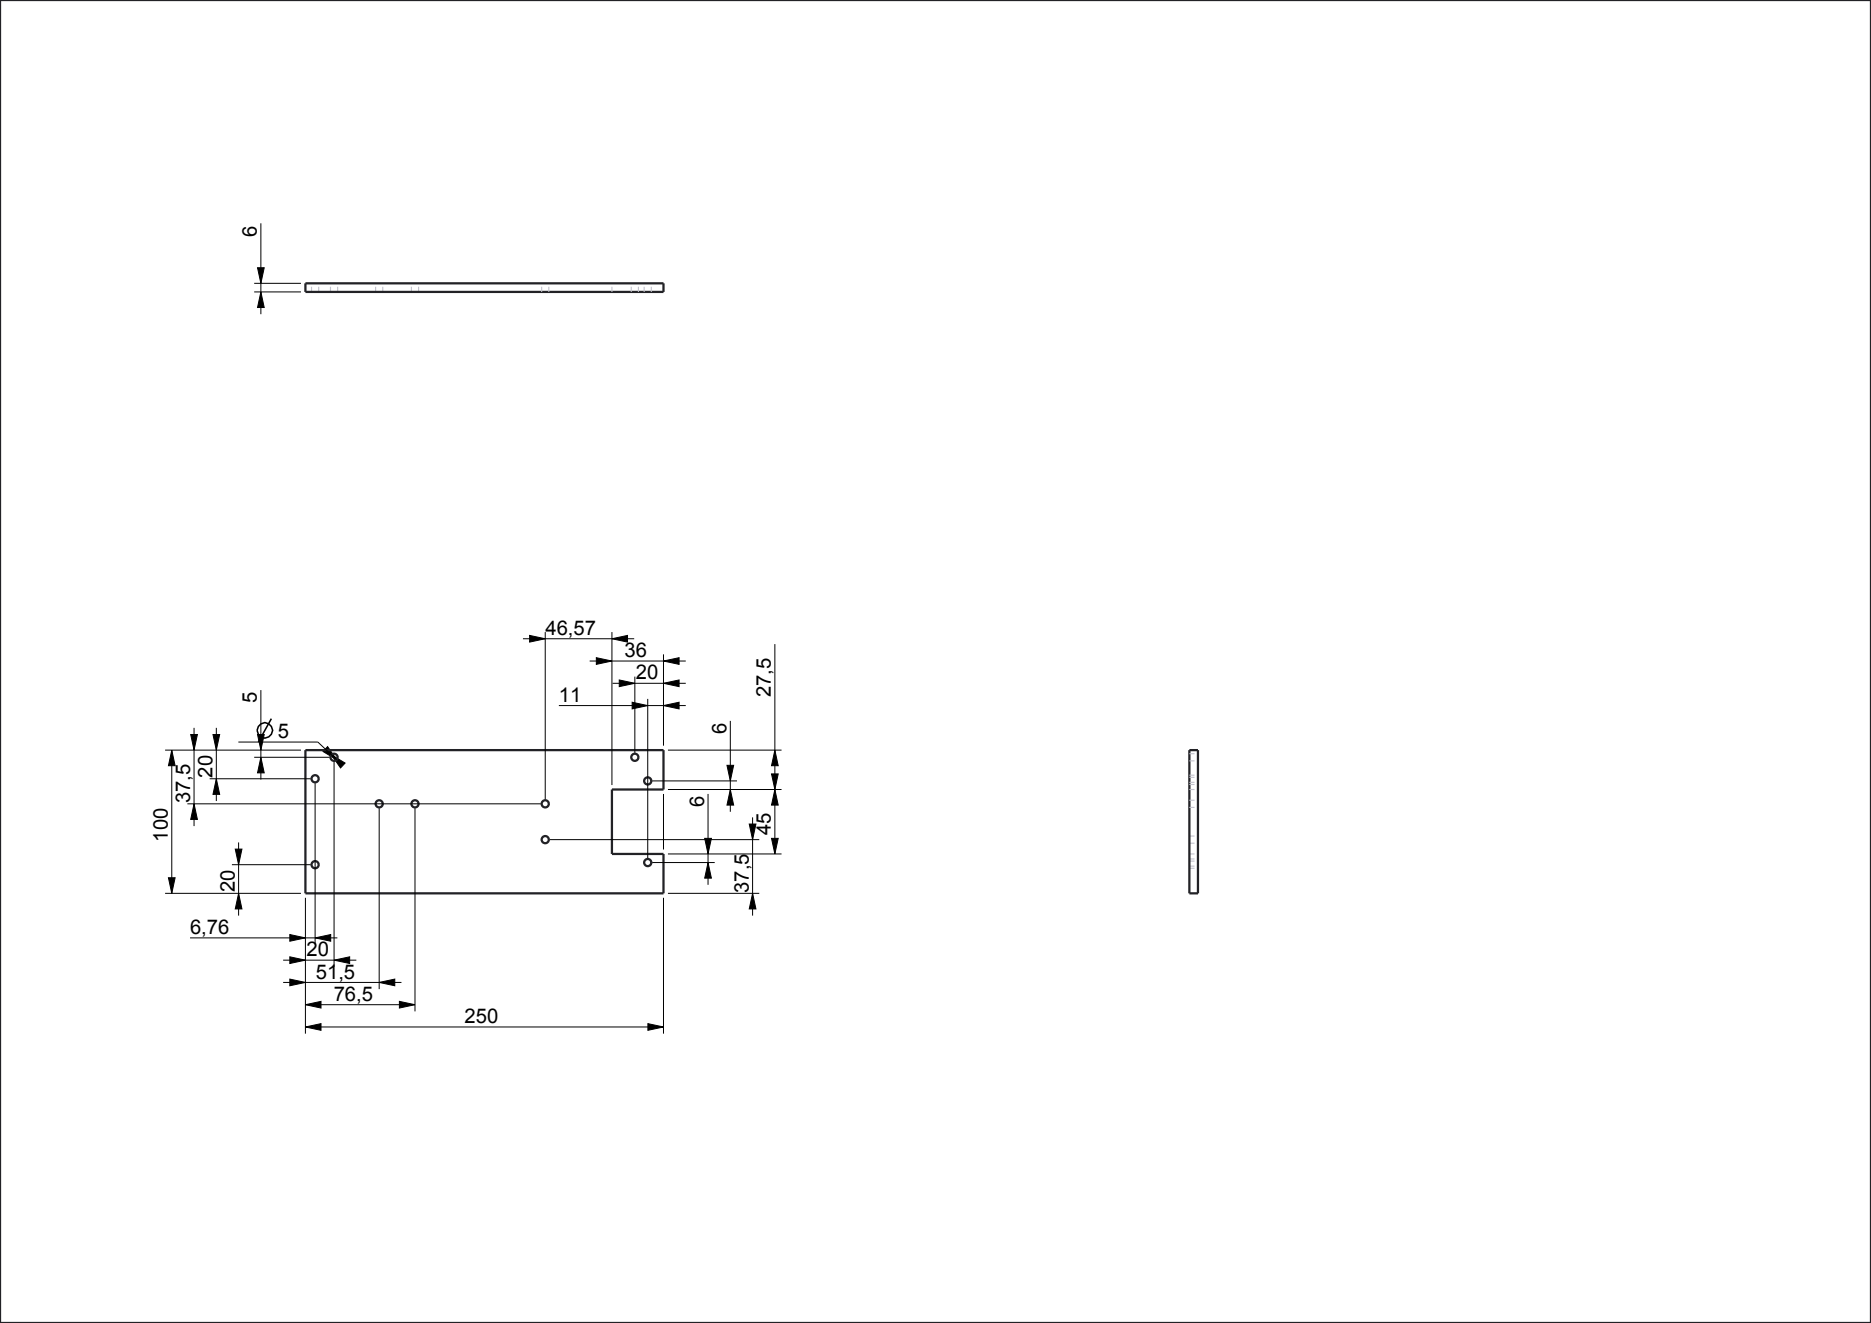
[picture p165: page 1]
