JamesGlanville/solderingmachine/electronics/lcd_backpack/lcd_backpack.sch

## KiCad design electronics/lcd_backpack/lcd_backpack.sch (2014-04-03)

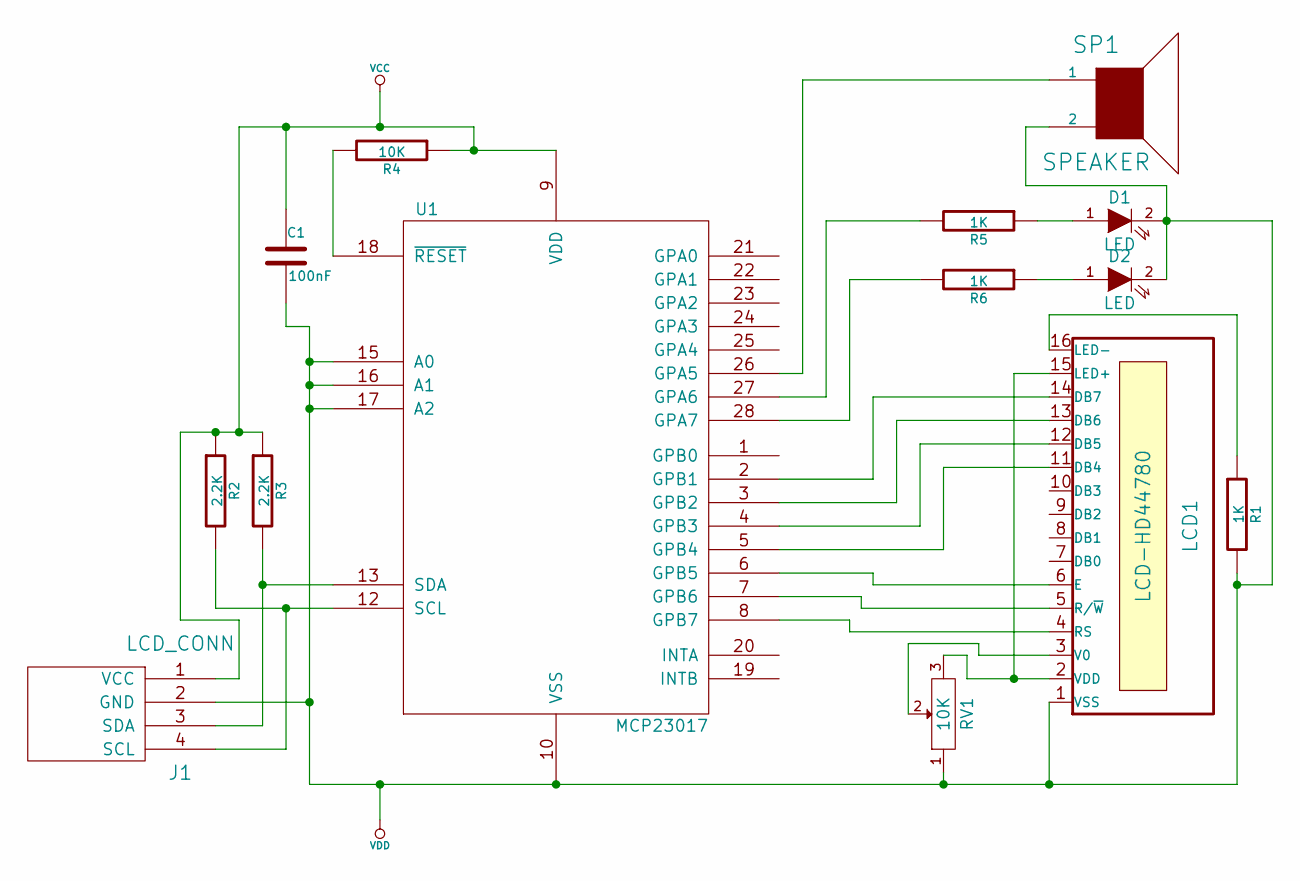
[picture p166: schematic lcd_backpack.sch]

Parts:
C1: 100nF
D1, D2: LED
J1: LCD_CONN
LCD1: LCD-HD44780
R1, R5, R6: 1K
R2, R3: 2.2K
R4: 10K
RV1: 10K
SP1: SPEAKER
U1: MCP23017; SOIC28

Connections:
unnamed: D1.1 (A), R5.1
unnamed: D2.1 (A), R6.1
unnamed: J1.3 (SDA), R3.2, U1.13 (SDA)
unnamed: J1.4 (SCL), R2.2, U1.12 (SCL)
unnamed: LCD1.3 (V0), RV1.2
unnamed: LCD1.4 (RS), U1.8 (GPB7)
unnamed: LCD1.5 (R/~W), U1.7 (GPB6)
unnamed: LCD1.6 (E), U1.6 (GPB5)
unnamed: LCD1.11 (DB4), U1.5 (GPB4)
unnamed: LCD1.12 (DB5), U1.4 (GPB3)
unnamed: LCD1.13 (DB6), U1.3 (GPB2)
unnamed: LCD1.14 (DB7), U1.2 (GPB1)
unnamed: LCD1.2 (VDD), LCD1.15 (LED+), RV1.3
unnamed: LCD1.16 (LED-), R1.1
unnamed: R4.2, U1.18 (~RESET)
unnamed: R5.2, U1.27 (GPA6)
unnamed: R6.2, U1.28 (GPA7)
unnamed: SP1.1, U1.26 (GPA5)
VCC: C1.1, J1.1 (VCC), R2.1, R3.1, R4.1, U1.9 (VDD)
VDD: C1.2, D1.2 (K), D2.2 (K), J1.2 (GND), LCD1.1 (VSS), R1.2, RV1.1, SP1.2, U1.10 (VSS), U1.15 (A0), U1.16 (A1), U1.17 (A2)
