JamesGlanville/solderingmachine/electronics/servo_tester/servo_tester.sch

## KiCad design electronics/servo_tester/servo_tester.sch (2014-04-03)

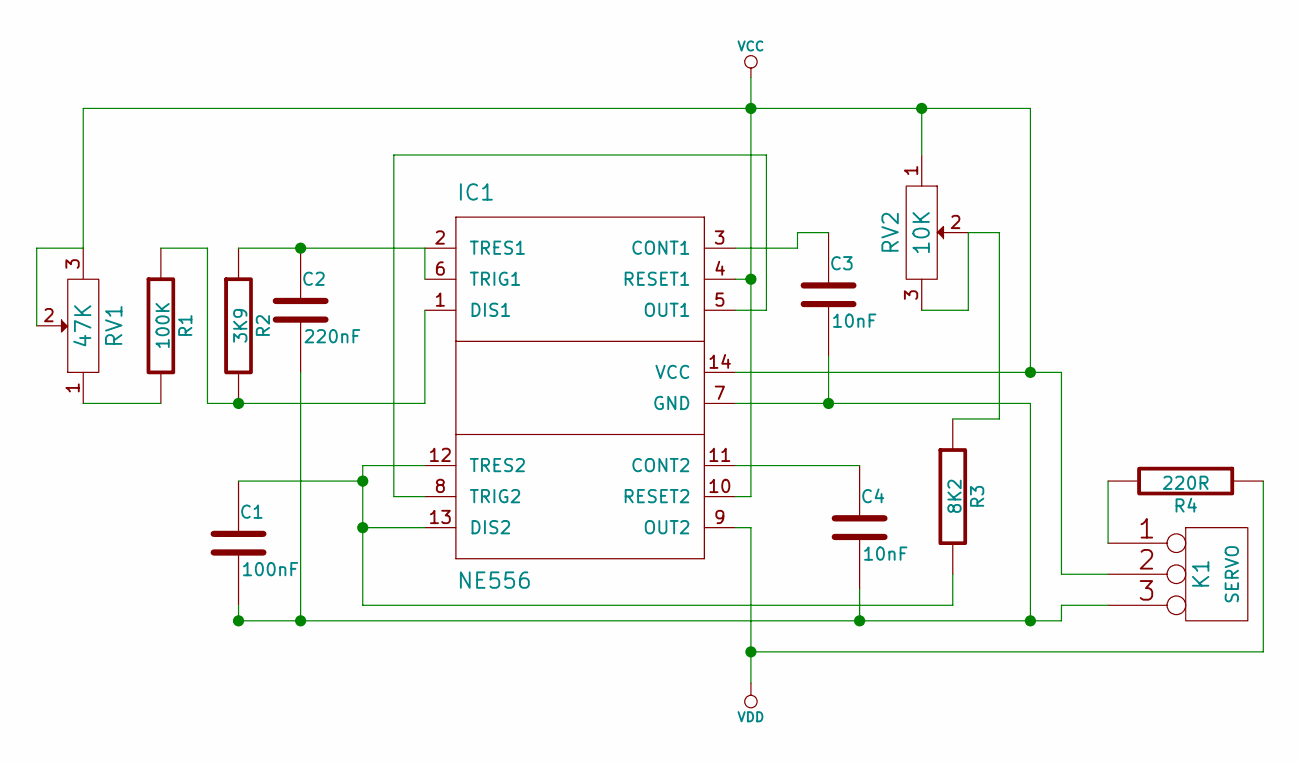
[picture p167: schematic servo_tester.sch]

Parts:
C1: 100nF
C2: 220nF
C3, C4: 10nF
IC1: NE556; st-microelectronics-DIL14
K1: SERVO
R1: 100K
R2: 3K9
R3: 8K2
R4: 220R
RV1: 47K
RV2: 10K

Connections:
unnamed: C1.1, IC1.12 (TRES2), IC1.13 (DIS2), R3.2
unnamed: C1.2, C2.2, C3.2, C4.2, IC1.7 (GND), K1.3
unnamed: C2.1, IC1.2 (TRES1), IC1.6 (TRIG1), R2.1
unnamed: C3.1, IC1.3 (CONT1)
unnamed: C4.1, IC1.11 (CONT2)
unnamed: IC1.1 (DIS1), R1.1, R2.2
unnamed: IC1.5 (OUT1), IC1.8 (TRIG2)
unnamed: K1.1, R4.2
unnamed: R1.2, RV1.1
unnamed: R3.1, RV2.2, RV2.3
VCC: IC1.4 (RESET1), IC1.10 (RESET2), IC1.14 (VCC), K1.2 (PM), RV1.2, RV1.3, RV2.1
VDD: IC1.9 (OUT2), R4.1
