JamesGlanville/solderingmachine/electronics/usb_isolator/usb_isolator.sch

## KiCad design electronics/usb_isolator/usb_isolator.sch (2014-04-27)

Schematic: usb_isolator.sch

Parts:
C1, C6: 10uF
C2, C3, C5: 100nF
C4: CSMALL
C7: 47uF
J1: MICRO-B_USB
J2: POWER
J3: DEVICE
R1, R2, R4, R5: 24R
R3: 10K
U2: ADUM3160
