JamesGlanville/solderingmachine/(commit log)

2013-09-10 started adding info about vacuum pump
2013-10-15 Added prototype part designs
    [bearing.scad, corner.scad, corner.stl, lm8uu.stl, syringe.dxf, syringe.scad, syringe.stl]
2013-10-15 Added driven corner stl
    [corner_through.stl]
2013-10-16 added design sketch
    [axes_design.scad]
2013-10-24 added new design
    [new_axes.scad]
2013-10-24 added a bit more to the new axes design
    [new_axes.scad]
2013-11-04 added section on heating solder paste
2013-11-06 improved corner.scad to reduce height
    [corner.scad]
2013-11-12 added some new parts
    [backlash.scad, backlash.stl, backlashw.stl]
2013-11-12 added solder paste extrusion section
2013-11-12 added creo parts
    [ymotor.stl]
2013-11-13 drew z axis
    [nuttrap.stl]
2013-11-20 new design
    [backlash.scad]
2013-12-06 added dimensioned drawings
    [motorholder.stl, rollerbottom.stl]
2013-12-06 added mounting z blocks
2014-03-11 lots of creo updates
    [extruder_main.stl, extruder_motor.stl, extruder_mount.stl, finalbearingholder.stl, generictool.stl, idlerfinal.stl, motorholderabs.stl, nuttrap.stl]
2014-03-24 redid solder methods
2014-03-24 added servo tester stuff
2014-03-24 added brief text about newer extruders
2014-03-26 started double-sided board thoughts
2014-03-26 started adding new improvements
    [bearing_idler.stl, motorholdervents.stl]
2014-03-26 remembered to track report resources
2014-03-26 added milling andhotair
2014-03-27 added hot air tool to report, as well as milling
2014-03-27 added pcb2gcode improvements
2014-03-29 update for backup
    [gear.dxf, needle_toolnew.stl, prop_chassis4.stl, prop_chassis5.stl, prop_chassistesttt.stl]
2014-03-31 added test board
2014-04-01 Added milling gcode
2014-04-01 added xt60 panelmount and spindle updates
    [spindle_idler.stl, xt60-panelmount.stl]
2014-04-01 added milled gear photos
2014-04-01 actually added gear photos
2014-04-02 added milling settings
2014-04-02 added part list
    [Part list.xlsx]
2014-04-02 added sample part list to report with instructions
2014-04-03 started exporting drawings
    [Part list.xlsx, rightangle.stl]
2014-04-03 exported all drawings as pdfs
    [gear.dxf]
2014-04-03 added electronics folder
    [lcd_backpack.kicad_pcb, lcd_backpack.sch]
2014-04-03 redrew servo exceriser
    [servo_tester.sch]
2014-04-03 added i2c lcd backpack schem
2014-04-03 added example smd board
2014-04-03 added example smd solder
2014-04-03 added soldering pictures
2014-04-03 added hc-05 breakout
    [HC-05 breakout.sch]
2014-04-03 annotated hc-05 breakout
    [HC-05 breakout.sch]
2014-04-03 added sample render
2014-04-27 various boards and part updates
    [isolator_base.stl, usb_isolator.sch]
2014-05-22 added sample technical abstract, added risk assessment to the report and updated compile script
2014-05-23 added pictures of breakout board
2014-05-23 moved heat calculations to appendix
2014-05-23 added spindle photo
2014-05-23 added untracked breakout board files
2014-05-23 added worm extruder placeholder
2014-05-23 neatened report, added worm extruder reference, explained usb serial choice
2014-05-23 added fuse comment
2014-05-27 added paste extrusion picture
2014-05-27 added extruder pictures
2014-05-27 added printout of git log
